HoangAnh301194/Industrial_AMR_Robot/slides/amr_presentation_15slides.tex

\documentclass[aspectratio=169,9pt]{beamer}

% --- Ngôn ngữ & Font Tiếng Việt (Chuẩn template main.tex) ---
\usepackage[T5]{fontenc}
\usepackage[utf8]{inputenc}
\usepackage[vietnamese]{babel}
\usepackage{lmodern}
\usepackage{amsmath,amssymb}
\usepackage{graphicx}
\usepackage{booktabs}
\usepackage{tabularx}
\usepackage{array}
\usepackage{ragged2e}
\usepackage{tcolorbox}
\usepackage{tikz}
\usetikzlibrary{arrows.meta,positioning,shapes.geometric,fit,calc}

% Đường dẫn ảnh
\graphicspath{{figures/}}

% --- Bảng Màu Chuẩn Học Viện (PTIT Theme) ---
\definecolor{PTITRed}{RGB}{166,25,31}
\definecolor{Ink}{RGB}{42,44,52}
\definecolor{Muted}{RGB}{102,108,118}
\definecolor{Line}{RGB}{188,192,200}
\definecolor{Panel}{RGB}{247,247,248}
\definecolor{PaleRed}{RGB}{249,239,240}
\definecolor{AccentGreen}{RGB}{28, 130, 60}

% --- Cấu hình Beamer Header / Footer / Typography ---
\setbeamertemplate{navigation symbols}{}
\setbeamertemplate{headline}{}
\setbeamersize{text margin left=0.55cm,text margin right=0.55cm}
\setbeamercolor{normal text}{fg=Ink,bg=white}
\setbeamercolor{frametitle}{fg=white,bg=PTITRed}
\setbeamercolor{itemize item}{fg=PTITRed}
\setbeamerfont{normal text}{size=\fontsize{8.9}{10.6}\selectfont}
\setbeamerfont{frametitle}{size=\fontsize{12.4}{14.4}\selectfont,series=\bfseries}
\setbeamerfont{itemize/enumerate body}{size=\fontsize{8.9}{10.6}\selectfont}
\setbeamertemplate{itemize item}{\raisebox{0.14ex}{\scriptsize$\blacktriangleright$}}
\setbeamertemplate{itemize subitem}{\raisebox{0.14ex}{\tiny$\blacktriangleright$}}
\setbeamertemplate{enumerate item}{\color{PTITRed}\insertenumlabel.}

\setbeamertemplate{frametitle}{
  \nointerlineskip
  \begin{beamercolorbox}[wd=\paperwidth,ht=0.67cm,dp=0.36cm,center]{frametitle}
    \insertframetitle
  \end{beamercolorbox}
}

\setbeamertemplate{footline}{
  \leavevmode
  \hbox to \paperwidth{\hfill
    \colorbox{PTITRed}{\makebox[0.30cm][c]{\color{white}\fontsize{5.2}{5.2}\selectfont\insertframenumber}}
    \hspace{0.46cm}}
  \vspace{0.28cm}
}

% --- Các macro định dạng nhanh theo main.tex ---
\newcommand{\smallnote}[1]{{\fontsize{7.1}{8.4}\selectfont #1\par}}
\newcommand{\tinytext}[1]{{\fontsize{6.3}{7.3}\selectfont #1\par}}
\newcommand{\heading}[1]{{\bfseries\color{PTITRed} #1\par}}
\newcommand{\numlabel}[1]{\colorbox{PTITRed}{\makebox[0.48cm][c]{\color{white}\bfseries #1}}}
\newcommand{\tightitems}{\setlength{\itemsep}{0.13em}\setlength{\parskip}{0pt}\setlength{\parsep}{0pt}}
\newcommand{\verytightitems}{\setlength{\itemsep}{0.04em}\setlength{\parskip}{0pt}\setlength{\parsep}{0pt}}

% --- Hộp màu TColorBox theo chuẩn main.tex ---
\tcbset{
  panel/.style={colback=Panel,colframe=Line,boxrule=0.42pt,arc=0.8mm,left=1.6mm,right=1.6mm,top=1.1mm,bottom=1.1mm,before skip=0pt,after skip=0pt},
  keypanel/.style={colback=PaleRed,colframe=PTITRed,boxrule=0.55pt,arc=0.8mm,left=1.7mm,right=1.7mm,top=1.1mm,bottom=1.1mm,before skip=0pt,after skip=0pt},
  titlepanel/.style={colback=white,colframe=Line,boxrule=0.45pt,arc=0mm,left=1.5mm,right=1.5mm,top=0.6mm,bottom=1.1mm,fonttitle=\bfseries,coltitle=white,colbacktitle=PTITRed,titlerule=0pt},
  equalpanel/.style={colback=white,colframe=Line,boxrule=0.45pt,arc=0mm,left=1.6mm,right=1.6mm,top=1.3mm,bottom=1.3mm,height=4.40cm,valign=top}
}

\newcolumntype{L}[1]{>{\RaggedRight\arraybackslash}p{#1}}
\newcolumntype{R}[1]{>{\RaggedLeft\arraybackslash}p{#1}}
\newcolumntype{C}[1]{>{\Centering\arraybackslash}p{#1}}
\newcolumntype{Y}{>{\RaggedRight\arraybackslash}X}

\begin{document}

% ==============================================================================
% SLIDE 1: TRANG BÌA (TITLE SLIDE - CHUẨN ĐỒ ÁN MÔN THIẾT KẾ ROBOT)
% ==============================================================================
\begin{frame}
  \centering
  \vspace{-0.20cm}
  {\fontsize{10.2}{12}\selectfont Báo cáo đồ án môn học\par}
  \vspace{0.36cm}
  {\color{PTITRed}\bfseries\fontsize{12.4}{14.5}\selectfont HỌC VIỆN CÔNG NGHỆ BƯU CHÍNH VIỄN THÔNG\par}
  \vspace{-0.02cm}
  {\bfseries\fontsize{9.2}{10.8}\selectfont MÔN HỌC: THIẾT KẾ ROBOT\par}
  \vspace{0.22cm}
  {\color{PTITRed}\rule{0.70\paperwidth}{0.55pt}\par}
  \vspace{0.18cm}
  {\color{PTITRed}\bfseries\fontsize{15.2}{17.2}\selectfont FACTORY DELIVERY AMR\par}
  \vspace{0.02cm}
  {\bfseries\fontsize{11.3}{13.1}\selectfont
    ROBOT DI ĐỘNG TỰ HÀNH VẬN CHUYỂN LINH KIỆN NHÀ MÁY\par}
  \vspace{0.14cm}
  {\fontsize{8.0}{9.4}\selectfont \textbf{Động học $\cdot$ Động lực học $\cdot$ Điều khiển PID $\cdot$ Mô phỏng ROS 2 \& Gazebo}\par}
  \vspace{0.26cm}
  {\fontsize{8.0}{9.4}\selectfont
  \begin{tabular}{@{}l@{\hspace{0.48cm}}l@{}}
    \textcolor{PTITRed}{\bfseries Giảng viên hướng dẫn:} & TS. Phạm Hoàng Anh\\[0.10cm]
    \textcolor{PTITRed}{\bfseries Sinh viên thực hiện:} & Nguyễn Hữu Hoàng Anh\\[0.03cm]
    & Nguyễn Hoàng Anh\\[0.03cm]
    & Phạm Tuấn Anh\\[0.03cm]
    & Nguyễn Xuân Nhật\\
  \end{tabular}}\par
  \vspace{0.22cm}
  {\color{Muted}\fontsize{7.4}{8.6}\selectfont Hà Nội, năm 2026\par}
\end{frame}

% ==============================================================================
% SLIDE 2: BÀI TOÁN & YÊU CẦU KỸ THUẬT (KPIS)
% ==============================================================================
\begin{frame}{1. Đặt Vấn Đề \& Yêu Cầu Kỹ Thuật (Target KPIs)}
  \vspace{0.02cm}
  \begin{columns}[T,onlytextwidth]
    \begin{column}{0.48\textwidth}
      \begin{tcolorbox}[titlepanel,title=Bối cảnh bài toán nhà máy X]
        \begin{itemize}\tightitems
          \item \smallnote{\textbf{Nhiệm vụ cốt lõi:} Nhận khay linh kiện tại \textbf{Kho A}, tự hành vận chuyển qua các trạm sản xuất \textbf{B $\rightarrow$ C $\rightarrow$ D}.}
          \item \smallnote{\textbf{Khép kín chu trình:} Tự động quay về trạm sạc sau khi hoàn tất hoặc khi pin dưới ngưỡng an toàn.}
          \item \smallnote{\textbf{Môi trường làm việc:} Di chuyển trong hành lang nhà xưởng rộng tối thiểu 1,2 m, phối hợp an toàn cùng con người.}
        \end{itemize}
        \vspace{0.06cm}
        \centering
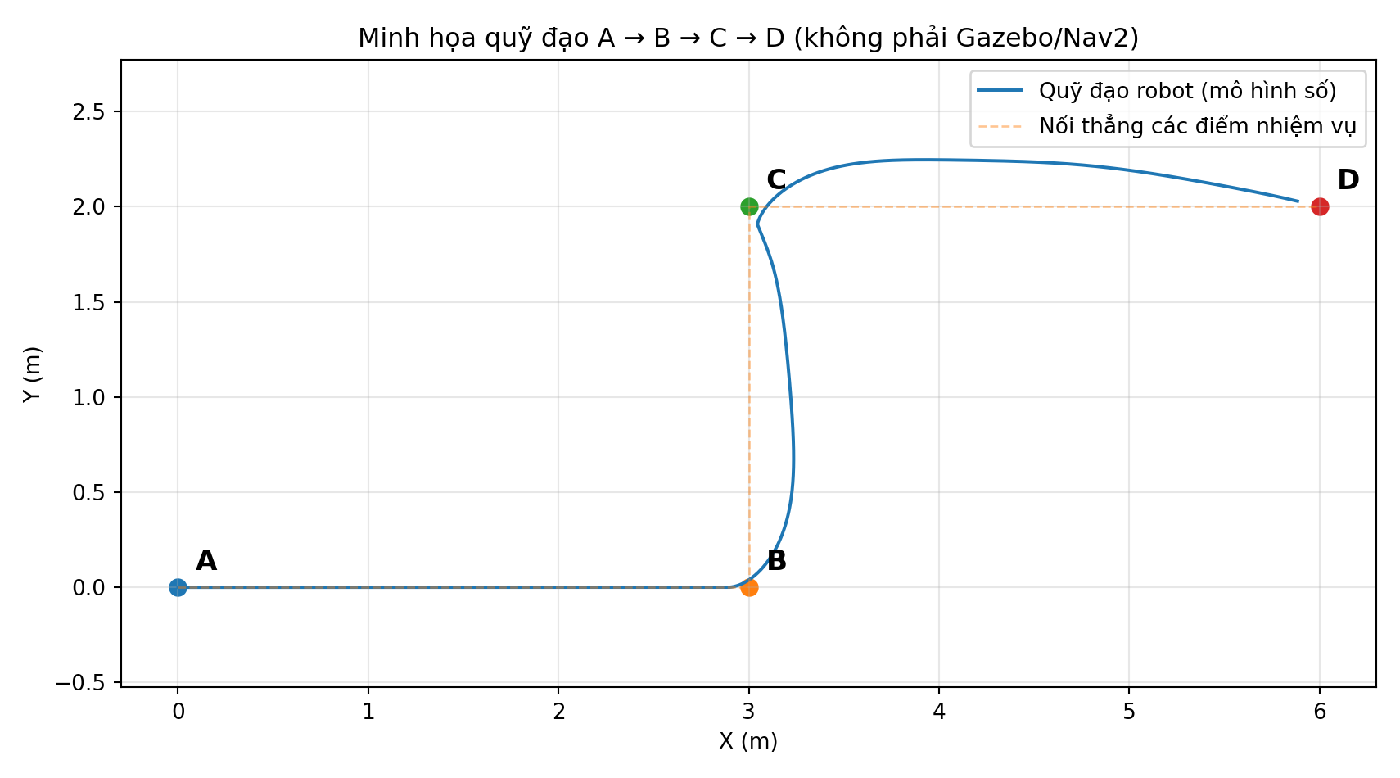
[picture p17: slides/figures/extended_waypoint_abcd.png]
        \par
        \tinytext{Sơ đồ hành trình di chuyển và toạ độ Waypoint A--B--C--D}
      \end{tcolorbox}
    \end{column}

    \begin{column}{0.49\textwidth}
      \begin{tcolorbox}[titlepanel,title=Chỉ số kỹ thuật yêu cầu (KPIs)]
        {\fontsize{7.2}{8.5}\selectfont
        \begin{tabularx}{\linewidth}{@{}Ycr@{}}
          \toprule
          \textbf{Thông số kỹ thuật} & \textbf{Chỉ số} & \textbf{Tiêu chí nghiệm thu} \\
          \midrule
          Tải trọng hữu ích (Payload) & \textbf{20 kg} & Khay linh kiện chuẩn \\
          Chiều rộng hành lang & $\ge$ \textbf{1,20 m} & Bán kính quay tự do \\
          Tốc độ di chuyển tối đa & $\ge$ \textbf{1,20 m/s} & Đáp ứng nhịp dây chuyền \\
          Sai số dừng (Docking) & $\le$ \textbf{$\pm$30 mm} & Khớp tiếp xúc chân kệ/sạc \\
          Thời gian hoạt động liên tục & $\ge$ \textbf{4,0 giờ} & Pin LiFePO4 48V-30Ah \\
          An toàn va chạm & \textbf{Đa tầng} & LiDAR + Bumper + E-stop \\
          \bottomrule
        \end{tabularx}}
      \end{tcolorbox}
      \vspace{0.12cm}
      \begin{tcolorbox}[keypanel]
        \centering\fontsize{7.6}{9.0}\selectfont
        \textbf{Ràng buộc cốt lõi:} Robot phải tự xoay tròn tại chỗ ($360^\circ$) để quay đầu gọn gàng trong hành lang hẹp 1,2 m mà không gây va quệt.
      \end{tcolorbox}
    \end{column}
  \end{columns}
\end{frame}

% ==============================================================================
% SLIDE 3: KIẾN TRÚC HỆ THỐNG PHÂN TẦNG
% ==============================================================================
\begin{frame}{2. Kiến Trúc Hệ Thống Phân Tầng (4 Layers \& 11 Modules)}
  \vspace{0.02cm}
  \begin{columns}[T,onlytextwidth]
    \begin{column}{0.48\textwidth}
      \begin{tcolorbox}[titlepanel,title=Mô hình kiến trúc 4 tầng chức năng]
        \heading{Tầng 1: Quản lý Nhiệm vụ (Mission Layer)}
        \smallnote{$\bullet$ State Machine: Điều phối nhận/giao khay A $\rightarrow$ B $\rightarrow$ C $\rightarrow$ D.\\
        $\bullet$ Quản lý pin \& tự động phát lệnh về trạm sạc.}
        \vspace{0.06cm}
        \heading{Tầng 2: Định vị \& Điều hướng (Nav \& Perception)}
        \smallnote{$\bullet$ SLAM 2D (Cartographer/AMCL) kết hợp EKF Fusion.\\
        $\bullet$ Lập kế hoạch đường đi tránh chướng ngại vật (Nav2).}
        \vspace{0.06cm}
        \heading{Tầng 3: Điều khiển Chuyển động (Control Layer)}
        \smallnote{$\bullet$ Động học nghịch vi sai: $(v, \omega) \rightarrow (\dot{\varphi}_R^*, \dot{\varphi}_L^*)$.\\
        $\bullet$ Điều khiển kín PID tốc độ bánh xe trên MCU.}
        \vspace{0.06cm}
        \heading{Tầng 4: Phần cứng \& Chấp hành (Hardware Layer)}
        \smallnote{$\bullet$ BLDC Hub Motor, 4 Caster $360^\circ$, Bàn nâng, Cảm biến.}
      \end{tcolorbox}
    \end{column}

    \begin{column}{0.49\textwidth}
      \begin{tcolorbox}[titlepanel,title=Phân rã 11 Module hệ thống (M1--M11)]
        {\fontsize{6.6}{7.8}\selectfont
        \begin{tabularx}{\linewidth}{@{}llX@{}}
          \toprule
          \textbf{Mã} & \textbf{Module} & \textbf{Chức năng cốt lõi} \\
          \midrule
          \textbf{M1} & Mechanical & Khung gầm thép 2 tầng, bàn nâng chữ X \\
          \textbf{M2} & Drive System & 2 Động cơ BLDC + 4 bánh Caster tự lựa \\
          \textbf{M3} & Sensor & LiDAR 2D, RealSense D455, IMU 6-DOF, Encoder \\
          \textbf{M4} & Localization & EKF Sensor Fusion (Odom + IMU + Scan) \\
          \textbf{M5} & Navigation & Global / Local Path Planner (Nav2 Stack) \\
          \textbf{M6} & Avoidance & Vùng bảo vệ an toàn 3 cấp thời gian thực \\
          \textbf{M7} & Control & Thuật toán PID kép trên Vi điều khiển nhúng \\
          \textbf{M8} & Power & Bộ pin LiFePO4 48V-30Ah, Smart BMS, Trạm sạc \\
          \textbf{M9} & Mission & Quản lý logic nhiệm vụ \& hàng đợi lệnh \\
          \textbf{M10} & Safety & Nút dừng khẩn cấp E-stop, Cản bumper va chạm \\
          \textbf{M11} & Comms & CAN Bus 2.0B, UART, Ethernet/Wi-Fi ROS 2 \\
          \bottomrule
        \end{tabularx}}
      \end{tcolorbox}
    \end{column}
  \end{columns}
\end{frame}

% ==============================================================================
% SLIDE 4: THIẾT KẾ CƠ KHÍ 3D (OPENSCAD)
% ==============================================================================
\begin{frame}{3. Thiết Kế Cơ Khí Tham Số Hóa (OpenSCAD)}
  \vspace{0.02cm}
  \begin{columns}[T,onlytextwidth]
    \begin{column}{0.50\textwidth}
      \begin{tcolorbox}[titlepanel,title=Đặc trưng cơ khí và cấu hình động học]
        \begin{itemize}\tightitems
          \item \smallnote{\textbf{100\% Parametric OpenSCAD:} Mô hình dựng hoàn toàn bằng mã nguồn, thay đổi kích thước bao, đường kính bánh xe tức thì.}
          \item \smallnote{\textbf{Cấu hình bánh xe ổn định cao:} Dẫn động vi sai 2 bánh chủ động đặt tại tâm kết hợp \textbf{4 bánh xe tự lựa (Swivel Casters)} ở 4 góc giúp triệt tiêu hiện tượng bập bênh khi nâng tải 20 kg.}
          \item \smallnote{\textbf{Bàn nâng chữ X (Scissor Lift):} Dẫn động bằng xy-lanh điện tuyến tính, hành trình nâng 0 $\rightarrow$ 290 mm nâng/trả khay hàng tự động.}
          \item \smallnote{\textbf{Khung gầm thép 2 tầng:} Thép tấm dày 6 mm sơn tĩnh điện, bố trí tối ưu khoang chứa mạch điện tử và pin 48V.}
        \end{itemize}
        \vspace{0.06cm}
        \tinytext{\textbf{Kích thước:}} \smallnote{$850 \times 580 \times 320\text{ mm}$ $\mid$ Bánh xe: $\varnothing 220\text{ mm}$ (Lốp PU, mâm nhôm CNC) $\mid$ Chiều cao nâng: $610\text{ mm}$.}
      \end{tcolorbox}
    \end{column}

    \begin{column}{0.48\textwidth}
      \begin{tcolorbox}[panel]
        \centering
        \par
        \tinytext{\textbf{Hình 4.1:} Bản vẽ phân rã giải phẫu cơ khí \& điện tử (Exploded View)}
      \end{tcolorbox}
      \vspace{0.08cm}
      \begin{tcolorbox}[panel]
        \centering
        \par
        \tinytext{\textbf{Hình 4.2:} Cơ cấu bàn nâng cắt kéo chữ X kiểm chứng trong OpenSCAD}
      \end{tcolorbox}
    \end{column}
  \end{columns}
\end{frame}

% ==============================================================================
% SLIDE 5: KIẾN TRÚC PHẦN CỨNG TOÀN DIỆN + ĐIỆN TỬ & CẢM BIẾN
% ==============================================================================
\begin{frame}{4. Kiến Trúc Phần Cứng Toàn Diện \& Hệ Thống Điện Tử}
  \vspace{-0.08cm}
  \begin{tcolorbox}[panel]
    \centering
    \begin{tikzpicture}[scale=0.76, every node/.style={transform shape, align=center}]
      % Blocks
      \node[draw=PTITRed, fill=PaleRed, rounded corners=1mm, minimum width=3.3cm, minimum height=1.15cm] (pwr) 
        {\textbf{NGUỒN NĂNG LƯỢNG}\\\scriptsize Pin LiFePO4 48V-30Ah + BMS\\\scriptsize PDU DC/DC (48V/24V/5V/3.3V)};
      
      \node[draw=Ink, fill=Panel, rounded corners=1mm, minimum width=3.5cm, minimum height=1.15cm, right=1.0cm of pwr] (sbc) 
        {\textbf{BỘ XỬ LÝ TRUNG TÂM}\\\scriptsize \textbf{NVIDIA Jetson / x86 SBC}\\\scriptsize ROS 2 $\cdot$ Nav2 $\cdot$ Cartographer};
      
      \node[draw=PTITRed, fill=PaleRed, rounded corners=1mm, minimum width=3.5cm, minimum height=1.15cm, right=1.0cm of sbc] (mcu) 
        {\textbf{VI ĐIỀU KHIỂN CẤP THẤP}\\\scriptsize \textbf{ESP32-S3 (240MHz)}\\\scriptsize Real-time Dual PID $\cdot$ E-Stop};
      
      \node[draw=Line, fill=white, rounded corners=1mm, minimum width=4.3cm, minimum height=1.35cm, below=0.6cm of sbc] (sens) 
        {\textbf{CẢM BIẾN NHẬN THỨC \& ĐO ĐẠC}\\\scriptsize $\bullet$ 2D LiDAR 360$^\circ$ (Ethernet/USB)\\\scriptsize $\bullet$ Camera Intel RealSense D455 (USB 3.0)\\\scriptsize $\bullet$ Cảm biến quán tính IMU 6-DOF (I2C)};
      
      \node[draw=Line, fill=white, rounded corners=1mm, minimum width=4.5cm, minimum height=1.35cm, below=0.6cm of mcu] (act) 
        {\textbf{CƠ CẤU CHẤP HÀNH \& ĐỘNG CƠ}\\\scriptsize $\bullet$ 2x Driver BLDC 24V/15A + Dual Motor\\\scriptsize $\bullet$ 2x Optical/Magnetic Encoder (Feedback)\\\scriptsize $\bullet$ Xy-lanh điện bàn nâng Scissor Lift};
      
      % Arrows
      \draw[->, thick, PTITRed] (pwr.east) -- node[above, align=center]{\tiny 48V/24V} (sbc.west);
      \draw[->, thick, PTITRed] (pwr.north) -- ++(0,0.25) -| node[pos=0.25,above, align=center]{\tiny 24V/5V} (mcu.north);
      \draw[<->, thick, Ink] (sbc.east) -- node[above, align=center]{\scriptsize CAN Bus / UART} node[below, align=center]{\tiny cmd\_vel $\leftrightarrow$ odom} (mcu.west);
      \draw[->, thick, Ink] (sens.north) -- node[right, align=center]{\scriptsize Scan / Pointcloud / IMU} (sbc.south);
      \draw[<->, thick, PTITRed] (mcu.south) -- node[right, align=center]{\scriptsize PWM / Encoder / Relay} (act.north);
    \end{tikzpicture}
  \end{tcolorbox}
  \vspace{0.06cm}
  \begin{columns}[T,onlytextwidth]
    \begin{column}{0.49\textwidth}
      \begin{tcolorbox}[titlepanel,title=Phân công xử lý tính toán]
        \smallnote{$\bullet$ \textbf{Jetson SBC:} Xử lý tác vụ nặng: SLAM 2D, lập bản đồ Costmap, Path Planning, xử lý thị giác đám mây điểm 3D RealSense.\\
        $\bullet$ \textbf{ESP32-S3:} Chu kỳ ngắt thời gian thực 10ms, tính toán thuật toán PID tốc độ bánh, đọc encoder, kích hoạt rơ-le an toàn.}
      \end{tcolorbox}
    \end{column}
    \begin{column}{0.49\textwidth}
      \begin{tcolorbox}[titlepanel,title=Giao tiếp Bus công nghiệp tin cậy]
        \smallnote{$\bullet$ \textbf{Bus Cảm Biến:} USB 3.0 \& Ethernet tốc độ cao truyền lượng dữ liệu lớn từ LiDAR và Depth Camera.\\
        $\bullet$ \textbf{Bus Điều Khiển:} CAN Bus 2.0B / RS-485 chống nhiễu công nghiệp, có mã CRC kiểm tra tính toàn vẹn và auto-recovery.}
      \end{tcolorbox}
    \end{column}
  \end{columns}
\end{frame}

% ==============================================================================
% SLIDE 6: ĐỘNG HỌC & ĐỘNG LỰC HỌC VI SAI (GỘP CHUNG)
% ==============================================================================
\begin{frame}{5. Mô Hình Động Học \& Động Lực Học Robot Vi Sai}
  \vspace{0.02cm}
  \begin{columns}[T,onlytextwidth]
    \begin{column}{0.49\textwidth}
      \begin{tcolorbox}[titlepanel,title=Động học hai bánh vi sai (Kinematics)]
        \heading{Động học thuận:}
        \vspace{-0.08cm}
        {\fontsize{7.8}{9.0}\selectfont
        \(\displaystyle v = \frac{r}{2}(\dot{\varphi}_R + \dot{\varphi}_L), \qquad \omega = \frac{r}{b}(\dot{\varphi}_R - \dot{\varphi}_L)\)\par}
        \vspace{0.04cm}
        \heading{Động học nghịch (Tốc độ đặt cho 2 bánh):}
        \vspace{-0.08cm}
        {\fontsize{7.8}{9.0}\selectfont
        \(\displaystyle \dot{\varphi}_R^* = \frac{v^* + \frac{b}{2}\omega^*}{r}, \qquad \dot{\varphi}_L^* = \frac{v^* - \frac{b}{2}\omega^*}{r}\)\par}
        \vspace{0.04cm}
        \heading{Odometry (Tích phân tư thế vị trí robot):}
        \vspace{-0.08cm}
        {\fontsize{7.8}{9.0}\selectfont
        \(\displaystyle \Delta s = \frac{r}{2}(\Delta\varphi_R + \Delta\varphi_L), \quad \Delta\theta = \frac{r}{b}(\Delta\varphi_R - \Delta\varphi_L)\)\par}
        \vspace{0.06cm}
        \begin{tcolorbox}[keypanel]
          \tinytext{\textbf{Ví dụ số:} Với $r=0.08\text{m}$, $b=0.45\text{m}$, chạy thẳng $v^*=1.2\text{m/s}$ $\rightarrow$ Bánh quay $\mathbf{143.24\text{ rpm}}$. Hộp số $i=10$ $\rightarrow$ Motor quay $\approx \mathbf{1432\text{ rpm}}$.}
        \end{tcolorbox}
      \end{tcolorbox}
    \end{column}

    \begin{column}{0.49\textwidth}
      \begin{tcolorbox}[titlepanel,title=Động lực học \& Tính chọn động cơ (Dynamics)]
        \heading{Phương trình cân bằng lực dọc thân xe:}
        \vspace{-0.08cm}
        {\fontsize{7.8}{9.0}\selectfont
        \(\displaystyle m\dot{v} = \frac{\tau_{w,R} + \tau_{w,L}}{r} - F_{rr} - F_d - F_g\)\par}
        \vspace{0.06cm}
        \smallnote{$\bullet$ \textbf{Lực cản lăn:} $F_{rr} = c_{rr} \cdot mg \approx 0.025 \cdot (75 \cdot 9.81) \approx \mathbf{18.4\text{ N}}$.\\
        $\bullet$ \textbf{Lực quán tính tăng tốc} ($a = 0.8\text{ m/s}^2$): $F_a = m \cdot a = 75 \cdot 0.8 = \mathbf{60\text{ N}}$.\\
        $\bullet$ \textbf{Tổng lực kéo cần thiết:} $F_{drive} = F_a + F_{rr} = \mathbf{78.4\text{ N}}$.}
        \vspace{0.08cm}
        \heading{Mô-men yêu cầu danh định mỗi bánh:}
        \vspace{-0.08cm}
        {\fontsize{7.8}{9.0}\selectfont
        \(\displaystyle \tau_{wheel} = \frac{F_{drive}}{2} \cdot r = \frac{78.4}{2} \cdot 0.08 \approx 3.14\text{ N}\cdot\text{m}\)\par}
        \vspace{0.06cm}
        \begin{tcolorbox}[keypanel]
          \centering\bfseries\fontsize{7.6}{9.0}\selectfont
          Hệ số an toàn $k_s = 1.5$ $\rightarrow$ \(\boxed{\tau_{motor\_req} \ge \mathbf{4.71\text{ N}\cdot\text{m}}}\) (đầu trục bánh)
        \end{tcolorbox}
      \end{tcolorbox}
    \end{column}
  \end{columns}
\end{frame}

% ==============================================================================
% SLIDE 7: BỘ ĐIỀU KHIỂN PI/PID TỐC ĐỘ BÁNH XE
% ==============================================================================
\begin{frame}{6. Thiết Kế Bộ Điều Khiển PI / PID Tốc Độ Bánh Xe}
  \vspace{0.02cm}
  \begin{columns}[T,onlytextwidth]
    \begin{column}{0.50\textwidth}
      \begin{tcolorbox}[titlepanel,title=Sơ đồ vòng kín điều khiển tốc độ]
        \centering
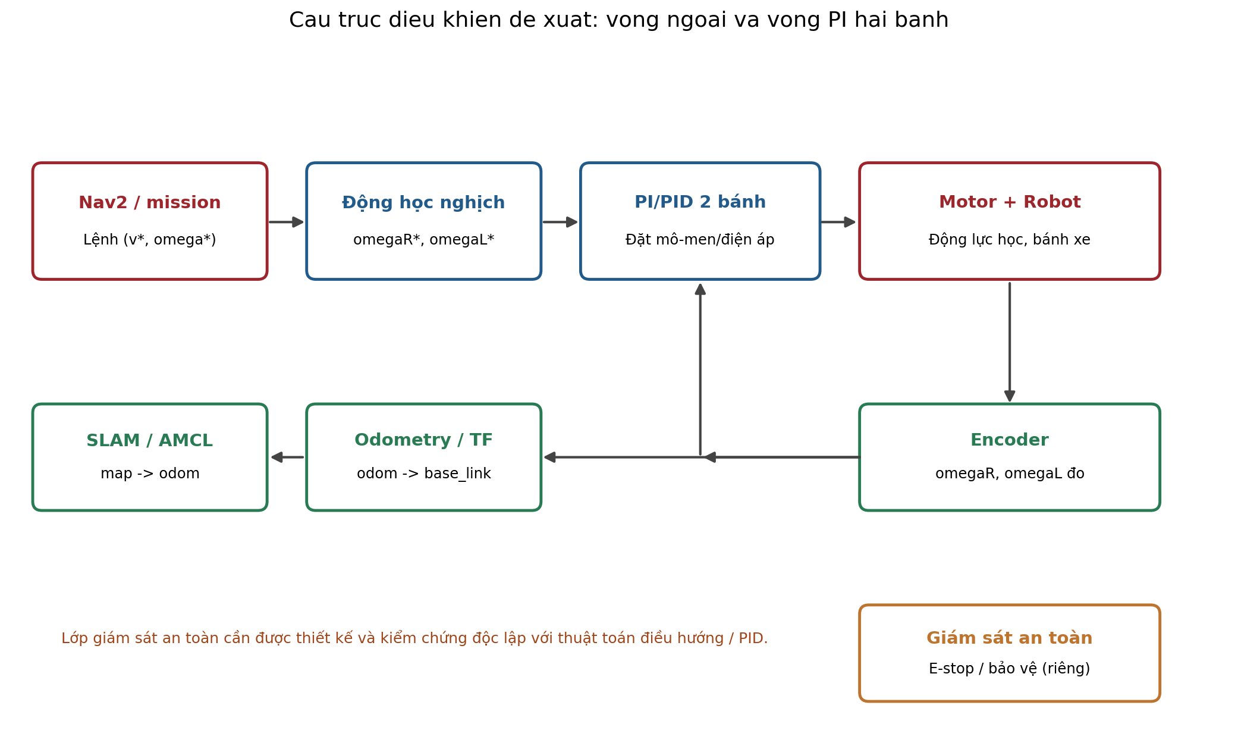
[picture p18: slides/figures/control_architecture.png]
        \par
        \tinytext{Cấu trúc điều khiển phản hồi vận tốc góc vòng kín tần số cao}
        \vspace{0.06cm}
        \heading{Luật điều khiển PID số (Discrete-time Euler):}
        {\fontsize{7.6}{8.8}\selectfont
        \(\displaystyle u_k = K_p e_k + K_i T_s \sum_{j=0}^k e_j + K_d \frac{e_k - e_{k-1}}{T_s}\)\par}
        \vspace{0.04cm}
        \smallnote{$\bullet$ \textbf{Anti-Windup (Clamping):} Đóng băng tích phân khi điện áp đầu ra chạm ngưỡng bão hòa $\pm U_{max} = \pm 24\text{V}$.\\
        $\bullet$ \textbf{Lọc đạo hàm:} Khử nhiễu tần số cao từ xung encoder bằng bộ lọc thông thấp bậc một.}
      \end{tcolorbox}
    \end{column}

    \begin{column}{0.48\textwidth}
      \begin{tcolorbox}[titlepanel,title=Bảng tham số tinh chỉnh (Tuning Parameters)]
        {\fontsize{7.2}{8.5}\selectfont
        \begin{tabularx}{\linewidth}{@{}lcccc@{}}
          \toprule
          \textbf{Bộ ĐK} & \textbf{$K_p$} & \textbf{$K_i$} & \textbf{$K_d$} & \textbf{Đặc tính đáp ứng} \\
          \midrule
          \textbf{P} & 1.10 & --- & --- & Sai số xác lập lớn ($e_{ss} \neq 0$) \\
          \textbf{PI} & 1.10 & 3.00 & --- & Triệt tiêu sai số ($e_{ss} = 0$) \\
          \textbf{PID} & 1.10 & 3.00 & 0.02 & Giảm vọt lố, ổn định cao \\
          \bottomrule
        \end{tabularx}}
      \end{tcolorbox}
      \vspace{0.10cm}
      \begin{tcolorbox}[keypanel]
        \heading{Vì sao PI là lựa chọn cốt lõi cho robot AMR?}
        \smallnote{Hệ truyền động bánh xe công nghiệp chịu ảnh hưởng lớn từ nhiễu lượng tử hóa encoder và ma sát sàn. Bộ điều khiển \textbf{PI} mang lại độ tin cậy cơ khí cao nhất, thành phần vi phân $K_d = 0.02$ bổ sung vừa đủ để dập tắt dao động khi robot đổi tải từ 0 lên 20 kg.}
      \end{tcolorbox}
    \end{column}
  \end{columns}
\end{frame}

% ==============================================================================
% SLIDE 8: KẾT QUẢ MÔ PHỎNG SỐ: PI VS. PID
% ==============================================================================
\begin{frame}{7. Kết Quả Mô Phỏng Số: PI vs. PID}
  \vspace{-0.04cm}
  \begin{columns}[T,onlytextwidth]
    \begin{column}{0.49\textwidth}
      \begin{tcolorbox}[panel]
        \centering
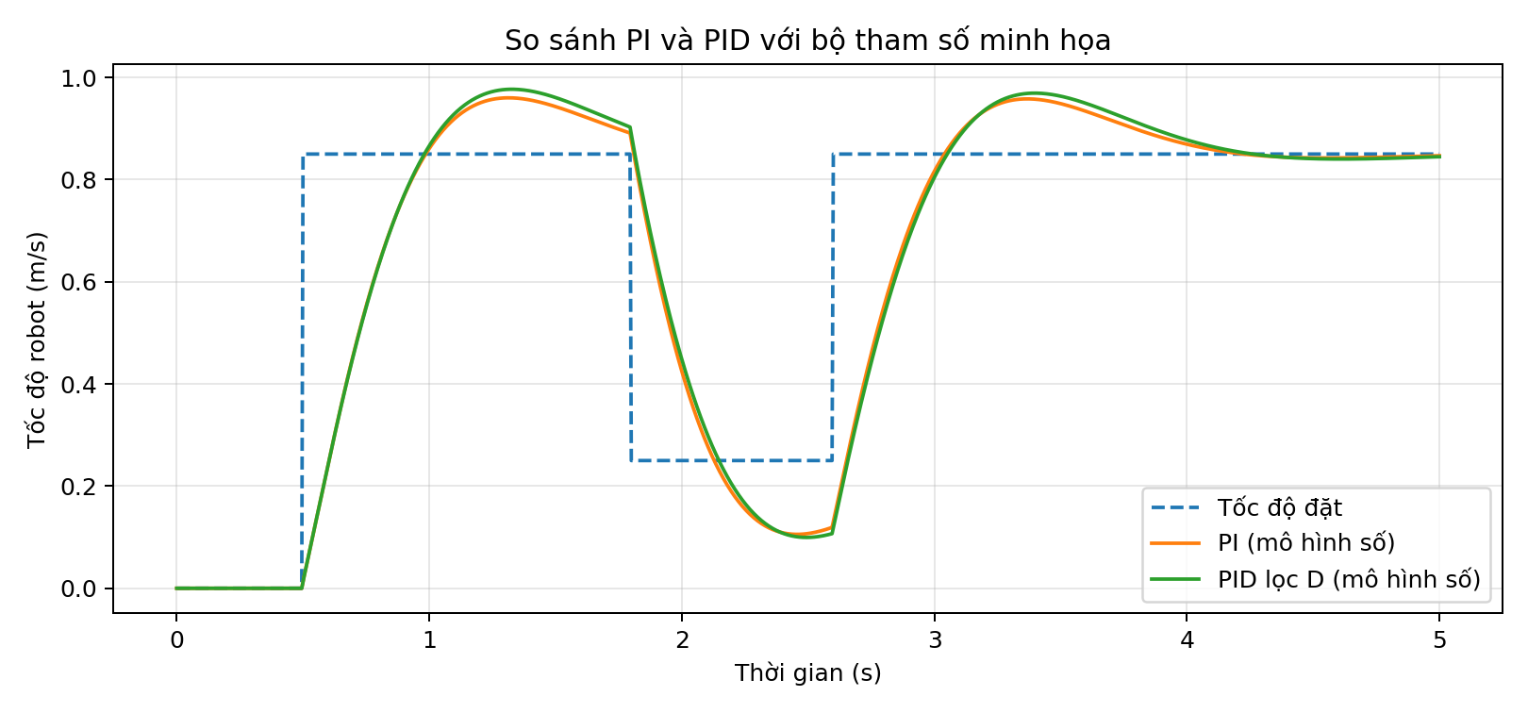
[picture p19: slides/figures/python_pi_vs_pid_speed.png]
        \par
        \tinytext{\textbf{Hình 8.1:} Đáp ứng vận tốc góc bánh xe khi có bước nhảy bậc (Step Command)}
      \end{tcolorbox}
    \end{column}
    \begin{column}{0.49\textwidth}
      \begin{tcolorbox}[panel]
        \centering
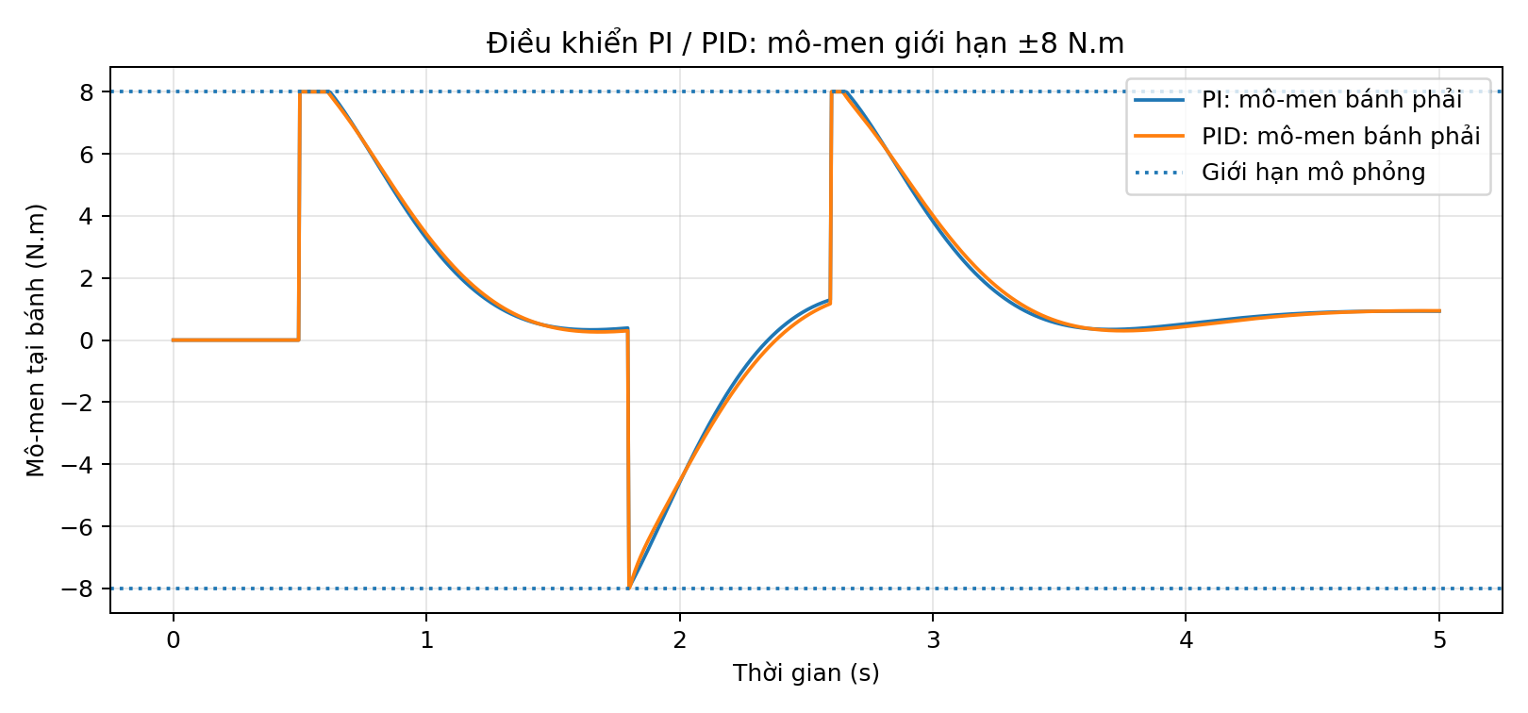
[picture p20: slides/figures/python_pi_vs_pid_torque.png]
        \par
        \tinytext{\textbf{Hình 8.2:} Mô-men điều khiển đầu ra $\tau$ (giới hạn bão hòa $\pm 8\text{ N}\cdot\text{m}$)}
      \end{tcolorbox}
    \end{column}
  \end{columns}
  \vspace{0.08cm}
  \begin{tcolorbox}[titlepanel,title=Đánh giá định lượng chất lượng điều khiển]
    {\fontsize{7.2}{8.5}\selectfont
    \begin{tabularx}{\linewidth}{@{}Xccccc@{}}
      \toprule
      \textbf{Cấu hình} & \textbf{Quá độ ($t_s$)} & \textbf{Vọt lố ($\%OS$)} & \textbf{Sai số ($e_{ss}$)} & \textbf{Mô-men đỉnh ($\tau_{max}$)} & \textbf{Nhận xét kỹ thuật} \\
      \midrule
      \textbf{Bộ điều khiển PI} & 0.88 s & $\approx 8.4\%$ & \textbf{0.00 rad/s} & 6.2 N$\cdot$m & Bám mượt, không giật mô-men \\
      \textbf{Bộ điều khiển PID} & \textbf{0.71 s} & $\mathbf{\approx 4.1\%}$ & \textbf{0.00 rad/s} & 7.1 N$\cdot$m & Đáp ứng nhanh hơn, vọt lố giảm một nửa \\
      \bottomrule
    \end{tabularx}}
  \end{tcolorbox}
\end{frame}

% ==============================================================================
% SLIDE 9: ĐỊNH VỊ SLAM & LẬP KẾ HOẠCH ĐƯỜNG ĐI NAV2
% ==============================================================================
\begin{frame}{8. Định Vị \& Lập Kế Hoạch Đường Đi (SLAM + Nav2)}
  \vspace{0.02cm}
  \begin{columns}[T,onlytextwidth]
    \begin{column}{0.50\textwidth}
      \begin{tcolorbox}[titlepanel,title=Cấu trúc cây biến đổi tọa độ (TF Tree)]
        \centering\fontsize{7.6}{9.0}\selectfont
        \texttt{map} $\xrightarrow{\text{AMCL / SLAM}}$ \texttt{odom} $\xrightarrow{\text{EKF Fusion}}$ \texttt{base\_link}\\
        \vspace{0.02cm}
        \texttt{base\_link} $\longrightarrow$ \{\texttt{laser\_link}, \texttt{camera\_link}, \texttt{imu\_link}, \texttt{wheel\_links}\}
      \end{tcolorbox}
      \vspace{0.06cm}
      \begin{tcolorbox}[titlepanel,title=Quy trình điều hướng 3 cấp độ]
        \begin{itemize}\tightitems
          \item \smallnote{\textbf{1. Xây dựng bản đồ (SLAM):} LiDAR 2D quét 360$^\circ$ kết hợp Cartographer xây dựng Occupancy Grid Map tĩnh.}
          \item \smallnote{\textbf{2. Định vị liên tục (AMCL):} Thuật toán lọc hạt thích nghi phối hợp dữ liệu Odometry và Scan Matching.}
          \item \smallnote{\textbf{3. Lập kế hoạch đường đi (Nav2):}
            \begin{itemize}\verytightitems
              \item \tinytext{\textit{Global Planner (NavFn):} Tìm đường ngắn nhất toàn cục tránh tường cố định.}
              \item \tinytext{\textit{Local Planner (DWB):} Tính vận tốc tránh vật cản động, duy trì khoảng cách an toàn $\ge 0.3\text{m}$.}
            \end{itemize}}
        \end{itemize}
      \end{tcolorbox}
    \end{column}

    \begin{column}{0.48\textwidth}
      \begin{tcolorbox}[panel]
        \centering
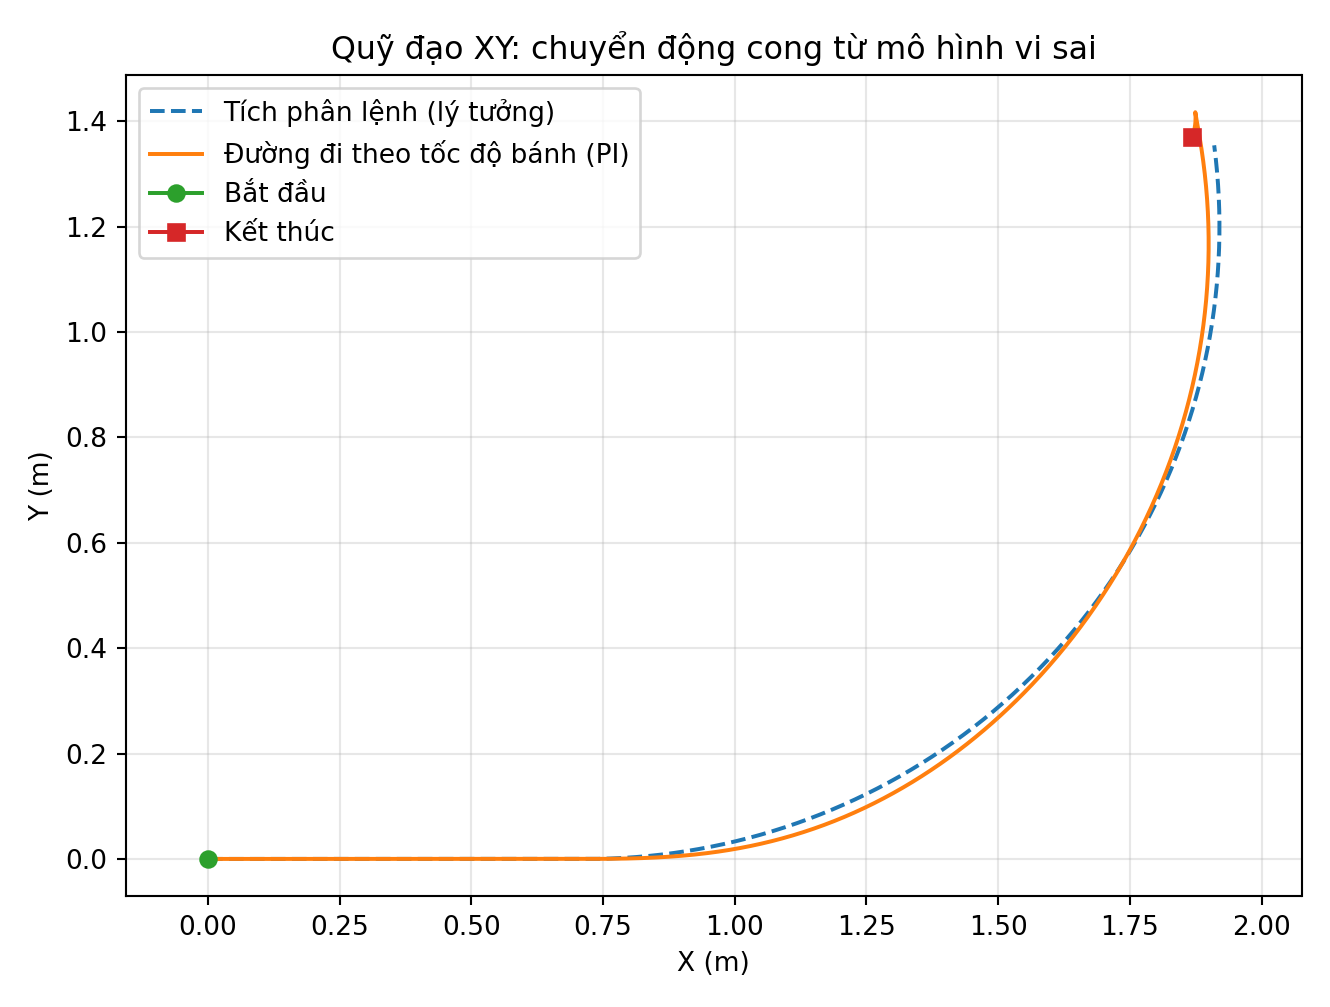
[picture p21: slides/figures/extended_turning_trajectory.png]
        \par
        \tinytext{\textbf{Hình 9.1:} Mô phỏng bám quỹ đạo rẽ trong hành lang 1,2 m}
      \end{tcolorbox}
      \vspace{0.06cm}
      \begin{tcolorbox}[keypanel]
        \heading{Chiến lược tiếp cận trạm (Fine Docking)}
        \smallnote{Khi cách trạm $<0.5\text{m}$, robot kích hoạt Camera RealSense D455 nhận diện mốc ArUco/Laser reflector để căn chỉnh vị trí đạt sai số dừng $\le \mathbf{\pm 20\text{ mm}}$ (vượt tiêu chí $\pm 30\text{ mm}$).}
      \end{tcolorbox}
    \end{column}
  \end{columns}
\end{frame}

% ==============================================================================
% SLIDE 10: TÍCH HỢP HỆ SINH THÁI ROS 2 & GAZEBO
% ==============================================================================
\begin{frame}{9. Tích Hợp Hệ Sinh Thái ROS 2 \& Mô Phỏng Gazebo}
  \vspace{0.02cm}
  \begin{columns}[T,onlytextwidth]
    \begin{column}{0.50\textwidth}
      \begin{tcolorbox}[titlepanel,title=Quy trình chuyển đổi OpenSCAD sang URDF/Xacro]
        \begin{itemize}\tightitems
          \item \smallnote{\textbf{Xuất hàng loạt STL Binary:} Bash script \texttt{export\_all\_stl.sh} tự động xuất 28 cụm mesh chi tiết với độ mịn cao ($fn=72$).}
          \item \smallnote{\textbf{Đồng bộ gốc tọa độ (Origin Alignment):} Khớp nối trục quay các khớp động học (\textit{joint origins}) trùng khớp từng milimét với vị trí lắp ráp trong OpenSCAD.}
          \item \smallnote{\textbf{Cấu hình vật lý URDF:} Tính toán chính xác ma trận mô-men quán tính (\texttt{<inertial>}), hình học va chạm (\texttt{<collision>}) và gán màu vật liệu (\texttt{<material>}).}
        \end{itemize}
        \vspace{0.06cm}
        \heading{Hệ thống gói mã nguồn ROS 2:}
        \tinytext{$\bullet$ \texttt{factory\_delivery\_amr\_description}: URDF, meshes, SDF thế giới nhà máy.\\
        $\bullet$ \texttt{lift\_gazebo\_controller.py}: Điều khiển nâng hạ bàn cắt kéo.\\
        $\bullet$ \texttt{amr\_keyboard\_teleop.py}: Điều khiển vận hành bàn phím thử nghiệm lực.}
      \end{tcolorbox}
    \end{column}

    \begin{column}{0.48\textwidth}
      \begin{tcolorbox}[panel]
        \centering
        \par
        \tinytext{\textbf{Hình 10.1:} Mô hình URDF hiển thị đầy đủ trong RViz2 và Gazebo Physics}
      \end{tcolorbox}
      \vspace{0.06cm}
      \begin{tcolorbox}[titlepanel,title=Gazebo Plugins đã tích hợp]
        \smallnote{$\bullet$ \textbf{DiffDrivePlugin:} Mô phỏng động học vi sai, tính ma sát tiếp xúc bánh--sàn $\mu_1 = \mu_2 = 0.8$.\\
        $\bullet$ \textbf{Sensor Plugins:} 2D LiDAR (\texttt{gpu\_lidar}), IMU sensor, Depth Camera Pointcloud.}
      \end{tcolorbox}
    \end{column}
  \end{columns}
\end{frame}

% ==============================================================================
% SLIDE 11: DEMO: 11 CHẾ ĐỘ HOẠT ẢNH OPENSCAD
% ==============================================================================
\begin{frame}{10. Kiểm Chứng Hình Học Bằng 11 Chế Độ Hoạt Ảnh OpenSCAD}
  \vspace{0.02cm}
  \begin{columns}[T,onlytextwidth]
    \begin{column}{0.52\textwidth}
      \begin{tcolorbox}[panel]
        \centering
        \par
        \tinytext{\textbf{Kịch bản nổi bật (Mode 7):} Chu trình hoàn chỉnh: Di chuyển $\rightarrow$ Nâng hàng $\rightarrow$ Giao hàng $\rightarrow$ Ghép sạc}
      \end{tcolorbox}
      \vspace{0.06cm}
      \begin{tcolorbox}[keypanel]
        \heading{Phương pháp hoạt ảnh kiểm tra va chạm}
        \smallnote{OpenSCAD sử dụng biến thời gian toàn cục \texttt{\$t} $\in [0, 1]$ kiểm tra toàn bộ không gian làm việc cơ cấu cơ khí trước khi gia công, phát hiện sớm 100\% va chạm linh kiện trong khoang gầm.}
      \end{tcolorbox}
    \end{column}

    \begin{column}{0.46\textwidth}
      \begin{tcolorbox}[titlepanel,title=Bảng 11 kịch bản hoạt hóa đã kiểm chứng]
        {\fontsize{6.3}{7.5}\selectfont
        \begin{tabularx}{\linewidth}{@{}clX@{}}
          \toprule
          \textbf{Mode} & \textbf{Tên kịch bản} & \textbf{Chức năng kiểm chứng} \\
          \midrule
          \textbf{0} & Static Model & Mô hình chuẩn xuất file STL \\
          \textbf{1} & Drive Straight & Đi thẳng, 4 caster ổn định hướng \\
          \textbf{2} & Spin in Place & Tự xoay $360^\circ$ trong hành lang 1,2 m \\
          \textbf{3} & Circular Arc & Chạy cong vi sai bán kính $R=850\text{mm}$ \\
          \textbf{4} & Scissor Lift & Nâng hạ bàn cắt kéo $0 \rightarrow 290\text{ mm}$ \\
          \textbf{5} & Caster Swivel & Góc nhìn gầm xe, 4 caster xoay $360^\circ$ \\
          \textbf{6} & Auto Docking & Ghép trạm sạc với sai số $\le 2\text{ mm}$ \\
          \textbf{7} & Full Mission & Toàn bộ hành trình công nghiệp \\
          \textbf{8} & Exploded View & Hoạt ảnh tháo/lắp từng lớp chi tiết \\
          \textbf{9} & Rack Pickup & Nhấc khay hàng 20 kg từ kệ 2 tầng \\
          \textbf{10} & Rack Place & Đặt khay hàng 20 kg lên thanh đỡ kệ \\
          \bottomrule
        \end{tabularx}}
      \end{tcolorbox}
    \end{column}
  \end{columns}
\end{frame}

% ==============================================================================
% SLIDE 12: HỆ THỐNG AN TOÀN ĐA TẦNG & NGUỒN ĐIỆN
% ==============================================================================
\begin{frame}{11. Hệ Thống An Toàn Đa Tầng \& Nguồn Điện}
  \vspace{0.02cm}
  \begin{columns}[T,onlytextwidth]
    \begin{column}{0.50\textwidth}
      \begin{tcolorbox}[titlepanel,title=Kiến trúc an toàn 5 cấp (Tiêu chuẩn ISO 3691-4)]
        \begin{itemize}\tightitems
          \item \smallnote{\textbf{Cấp 1 - E-Stop Khẩn Cấp Phần Cứng:} Nút nhấn nấm đỏ ngắt nguồn rơ-le công suất motor trong thời gian $< 50\text{ms}$.}
          \item \smallnote{\textbf{Cấp 2 - Thanh Bumper Chống Va Chạm:} Cảm biến tiếp xúc cơ học chu vi xe, tác động tức thì khi va chạm vật cản thấp.}
          \item \smallnote{\textbf{Cấp 3 - LiDAR Safety Zones (Vùng quét an toàn):}
            \begin{itemize}\verytightitems
              \item \tinytext{\textit{Vùng Cảnh báo (1,5 m):} Phát còi/đèn LED, giảm 50\% tốc độ.}
              \item \tinytext{\textit{Vùng Dừng (0,4 m):} Dừng mềm hãm tái sinh an toàn.}
            \end{itemize}}
          \item \smallnote{\textbf{Cấp 4 - Software Watchdog:} Tự động khóa hãm khi mất gói tin điều khiển \texttt{cmd\_vel} quá 200 ms.}
          \item \smallnote{\textbf{Cấp 5 - Quá Dòng \& Quá Nhiệt:} BMS ngắt bảo vệ cell pin.}
        \end{itemize}
      \end{tcolorbox}
    \end{column}

    \begin{column}{0.48\textwidth}
      \begin{tcolorbox}[titlepanel,title=Hệ thống pin \& Năng lượng tự sạc]
        {\fontsize{6.6}{7.8}\selectfont
        \begin{tabularx}{\linewidth}{@{}Ycr@{}}
          \toprule
          \textbf{Thành phần nguồn} & \textbf{Thông số} & \textbf{Ghi chú vai trò} \\
          \midrule
          Bộ Pin LiFePO4 & \textbf{48V — 30 Ah} & Năng lượng $1440\text{ Wh}$ \\
          Thời gian chạy danh định & \textbf{$\ge$ 4,5 giờ} & Chở đủ tải 20 kg liên tục \\
          Thời gian sạc nhanh & \textbf{$\approx$ 1,5 giờ} & Dòng nạp 20A CC/CV \\
          Tiếp điểm sạc tự động & Đồng đỏ tiếp xúc kép & Dòng định mức 30A \\
          Mạch Smart BMS & Cân bằng chủ động & Giám sát cell qua SMBus \\
          \bottomrule
        \end{tabularx}}
      \end{tcolorbox}
      \vspace{0.04cm}
      \begin{tcolorbox}[panel]
        \centering
        \par
        \tinytext{\textbf{Hình 11.1:} Cơ chế ghép nối bản cực tiếp xúc với trạm sạc tự động}
      \end{tcolorbox}
    \end{column}
  \end{columns}
\end{frame}

% ==============================================================================
% SLIDE 13: QUY TRÌNH PHÁT TRIỂN & KIỂM THỬ THEO V-MODEL
% ==============================================================================
\begin{frame}{12. Quy Trình Kỹ Thuật Hệ Thống Theo Mô Hình V-Model}
  \vspace{0.02cm}
  \begin{columns}[T,onlytextwidth]
    \begin{column}{0.50\textwidth}
      \begin{tcolorbox}[panel]
        \centering
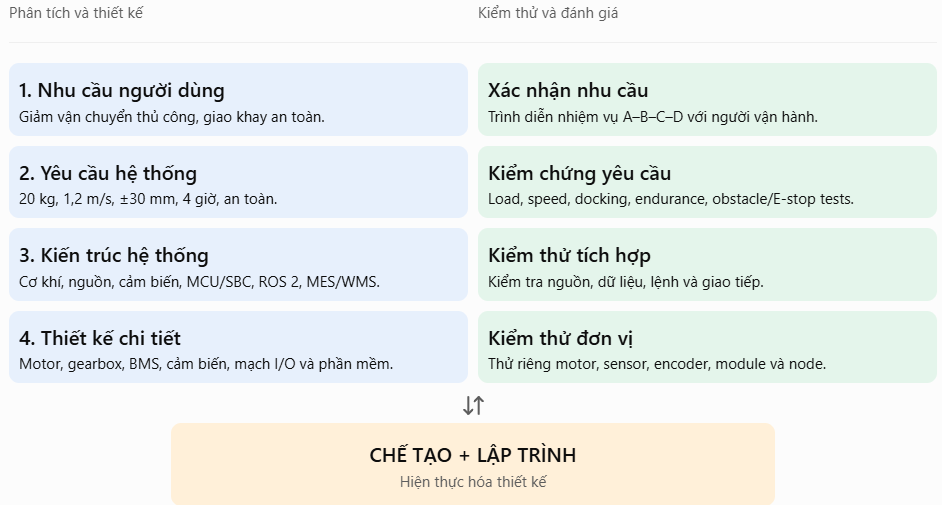
[picture p22: slides/figures/vmodel.png]
        \par
        \tinytext{\textbf{Hình 12.1:} Ánh xạ mô hình chữ V giữa nhánh thiết kế và kiểm thử}
      \end{tcolorbox}
      \vspace{0.06cm}
      \begin{tcolorbox}[titlepanel,title=4 Cấp độ kiểm thử thực hiện]
        \smallnote{$\bullet$ \textbf{Unit Test:} Đo lường driver motor, ngắt encoder, hàm PID.\\
        $\bullet$ \textbf{Integration Test:} Kiểm tra Jetson SBC $\leftrightarrow$ ESP32 qua CAN Bus.\\
        $\bullet$ \textbf{System Test:} Mô phỏng toàn diện trong Gazebo (Physics + Nav2).\\
        $\bullet$ \textbf{Acceptance Test:} Kiểm thử chu trình nhà máy tại hiện trường.}
      \end{tcolorbox}
    \end{column}

    \begin{column}{0.48\textwidth}
      \begin{tcolorbox}[titlepanel,title=5 Cổng đánh giá thiết kế (Design Reviews)]
        {\fontsize{7.2}{8.5}\selectfont
        \begin{tabularx}{\linewidth}{@{}llX@{}}
          \toprule
          \textbf{Cổng} & \textbf{Tên đánh giá} & \textbf{Trạng thái dự án} \\
          \midrule
          \textbf{SRR} & System Requirements Review & \textcolor{AccentGreen}{\textbf{Hoàn thành}} \\
          \textbf{PDR} & Preliminary Design Review & \textcolor{AccentGreen}{\textbf{Hoàn thành}} \\
          \textbf{CDR} & Critical Detailed Design & \textcolor{AccentGreen}{\textbf{Hoàn thành}} \\
          \textbf{TRR} & Test Readiness Review & \textcolor{PTITRed}{\textbf{Đang chuẩn bị}} \\
          \textbf{FDR} & Final Design Review & \textit{Giai đoạn tới} \\
          \bottomrule
        \end{tabularx}}
      \end{tcolorbox}
      \vspace{0.10cm}
      \begin{tcolorbox}[keypanel]
        \heading{Tính chuẩn mực kỹ thuật (Traceability)}
        \smallnote{Mọi yêu cầu kỹ thuật từ phía nhà máy đều có khả năng truy xuất nguồn gốc hai chiều từ bảng phân rã Module M1--M11 đến các ca kiểm thử tương ứng.}
      \end{tcolorbox}
    \end{column}
  \end{columns}
\end{frame}

% ==============================================================================
% SLIDE 14: TRẠNG THÁI HIỆN TẠI & KẾ HOẠCH TRIỂN KHAI
% ==============================================================================
\begin{frame}{13. Trạng Thái Hiện Tại \& Kế Hoạch Triển Khai}
  \vspace{0.02cm}
  \begin{columns}[T,onlytextwidth]
    \begin{column}{0.49\textwidth}
      \begin{tcolorbox}[titlepanel,title=Kết quả đã hoàn thành (Completed)]
        \begin{itemize}\tightitems
          \item \smallnote{\textbf{Cơ khí 3D:} Hoàn thiện thiết kế CAD tham số hóa 100\% OpenSCAD; xuất tự động 28 file mesh STL.}
          \item \smallnote{\textbf{Lý thuyết điều khiển:} Xây dựng mô hình toán động học thuận/nghịch vi sai \& động lực học cân bằng lực kéo.}
          \item \smallnote{\textbf{Mô phỏng PID:} Hoàn thành mô phỏng số Python so sánh P, PI, PID ($t_s = 0.71\text{s}$, vọt lố $4.1\%$).}
          \item \smallnote{\textbf{Tích hợp ROS 2:} Tạo thành công gói URDF/Xacro, hiển thị mô hình trong RViz2 và Gazebo Physics.}
          \item \smallnote{\textbf{Hoạt ảnh:} 11 kịch bản animation kiểm chứng va chạm.}
        \end{itemize}
      \end{tcolorbox}
    \end{column}

    \begin{column}{0.49\textwidth}
      \begin{tcolorbox}[titlepanel,title=Kế hoạch triển khai tiếp theo (Next Steps)]
        \begin{itemize}\tightitems
          \item \smallnote{\textbf{Kiểm chứng MATLAB:} Chạy 16 script MATLAB để tái lập các đồ thị đáp ứng độc lập.}
          \item \smallnote{\textbf{Mô phỏng Nav2 khép kín:} Thử nghiệm điều hướng đa waypoint A $\rightarrow$ B $\rightarrow$ C $\rightarrow$ D trong Gazebo.}
          \item \smallnote{\textbf{Nạp mã nhúng:} Triển khai thuật toán PID số lên bo mạch ESP32-S3 thực tế.}
          \item \smallnote{\textbf{Chế tạo mẫu thử (Prototype):} Cắt laser khung kim loại tấm và tiện mâm nhôm CNC bánh xe.}
        \end{itemize}
        \vspace{0.06cm}
        \heading{Lộ trình dự kiến:}
        \tinytext{Hoàn thành chế tạo phần cứng và tích hợp cảm biến trong Q1/2027.}
      \end{tcolorbox}
    \end{column}
  \end{columns}
\end{frame}

% ==============================================================================
% SLIDE 15: KẾT LUẬN & HỎI ĐÁP (Q&A)
% ==============================================================================
\begin{frame}{14. Kết Luận \& Phiên Thảo Luận (Q\&A)}
  \vspace{0.02cm}
  \begin{columns}[T,onlytextwidth]
    \begin{column}{0.54\textwidth}
      \begin{tcolorbox}[titlepanel,title=5 Đóng góp chính của đề tài đồ án]
        \begin{enumerate}\tightitems
          \item \smallnote{\textbf{Tính khả thi công nghiệp:} Đáp ứng đầy đủ các chỉ số của nhà máy (tải 20 kg, hành lang 1,2 m, tốc độ 1,2 m/s).}
          \item \smallnote{\textbf{Thiết kế cơ điện tử đồng bộ:} Quy trình liên tục từ Code OpenSCAD $\rightarrow$ Mesh STL $\rightarrow$ URDF $\rightarrow$ ROS 2.}
          \item \smallnote{\textbf{Cơ sở lý thuyết vững chắc:} Thiết lập tường minh mô hình toán động học vi sai, động lực học và chọn động cơ $\ge 4.71\text{ N}\cdot\text{m}$.}
          \item \smallnote{\textbf{Điều khiển ổn định:} Bộ điều khiển PI/PID được mô phỏng số, triệt tiêu hoàn toàn sai số xác lập tốc độ.}
          \item \smallnote{\textbf{Quy trình chuẩn V-Model:} Đảm bảo kiểm soát chất lượng từ yêu cầu hệ thống đến từng cổng đánh giá.}
        \end{enumerate}
      \end{tcolorbox}
    \end{column}

    \begin{column}{0.44\textwidth}
      \begin{tcolorbox}[panel]
        \centering
        \par
        \tinytext{Mô hình hoàn chỉnh Robot Factory Delivery AMR}
      \end{tcolorbox}
      \vspace{0.10cm}
      \begin{tcolorbox}[keypanel]
        \centering
        {\large\bfseries\color{PTITRed} XIN TRÂN TRỌNG CẢM ƠN!\par}
        \vspace{0.08cm}
        {\bfseries\fontsize{9.0}{10.5}\selectfont PHIÊN THẢO LUẬN \& HỎI ĐÁP (Q\&A)\par}
        \vspace{0.06cm}
        \tinytext{Kính mời Thầy/Cô và các bạn sinh viên đặt câu hỏi.}
      \end{tcolorbox}
    \end{column}
  \end{columns}
\end{frame}

\end{document}
