HoangAnh301194/Industrial_AMR_Robot/documents/ARM_Robot.docx

# MỤC LỤC

# CHƯƠNG 1: TỔNG QUAN HỆ THỐNG ROBOT VÀ QUY TRÌNH THIẾT KẾ

## 1.1 Đặt vấn đề và Robot dưới góc nhìn hệ thống tích hợp

Bài toán xuyên suốt học phần xuất phát từ nhu cầu của Nhà máy X: thiết kế một xe tự hành Factory Delivery AMR nhận khay linh kiện nặng 20 kg tại Kho A, vận chuyển qua hành lang rộng 1,2 m để giao đến các Trạm B, Trạm C, Trạm D với vận tốc tối thiểu 1,2 m/s, sai số dừng tại trạm nhỏ hơn 30 mm (hoặc trong khoảng ±30 mm), tự động phát hiện/tránh người và vật cản, sau đó tự quay về trạm sạc

Robot không phải là các linh kiện rời rạc mà là sự hợp nhất của 3 trụ cột kỹ thuật đặt trên nền móng kiến thức cơ bản (Giải tích, Đại số tuyến tính, Vật lý) và cơ sở ngành (Điều khiển tự động, CAD/CAM, Mạch điện – điện tử, Lập trình):

- Hệ thống Cơ khí, Truyền động: Bao gồm khung và kết cấu chịu lực, bánh xe, cơ cấu chấp hành, động cơ, hộp số và bài toán phân bố tải trọng.
- Hệ thống Điện, Điện tử: Bao gồm pin, hệ thống quản lý pin (BMS), mạch phân phối nguồn, bộ điều khiển động cơ (Driver), vi điều khiển (MCU), hệ thống cảm biến, dây dẫn và giao thức truyền thông.
- Hệ thống Phần mềm, Thuật toán: Bao gồm nền tảng ROS 2, kiến trúc máy trạng thái, thuật toán định vị (Localization), lập kế hoạch đường đi (Planning), điều khiển chuyển động và nhận thức môi trường (Perception).

## 1.2 Quy trình phát triển tổng quát 6 bước

Quá trình phát triển Factory Delivery AMR tuân theo chuỗi 6 bước có vòng lặp phản hồi từ dữ liệu thử nghiệm để liên tục hiệu chỉnh yêu cầu, phương án và thiết kế:

- Bước 1 – Nhu cầu (User Needs): Làm rõ bài toán vận chuyển khay linh kiện và các bên liên quan; tạo ra User needs, Stakeholder map, Mission statement.
- Bước 2 – Yêu cầu kỹ thuật (Requirements): Định lượng hóa tải trọng, tốc độ, sai số docking, thời gian chạy và an toàn; tạo ra Đặc tả yêu cầu hệ thống (SRS), Ma trận truy vết (RTM), Kế hoạch kiểm chứng.
- Bước 3 – Phương án + Kiến trúc (Concept + Architecture): So sánh các phương án truyền động, cảm biến, tính toán, nguồn và giao diện; tạo ra Biểu đồ hình thái (Morphological chart), Ma trận quyết định, Kiến trúc sơ bộ.
- Bước 4 – Mô hình + Mô phỏng (Modeling + Simulation): Kiểm tra động học, động cơ, pin, định vị và kịch bản vận hành; tạo ra Mô hình tính toán, mô phỏng ROS 2/Gazebo, Báo cáo mô phỏng.
- Bước 5 – Thiết kế chi tiết + Chế tạo (Detailed Design + Build): Hoàn thiện thiết kế cơ khí, sơ đồ điện, phần mềm và chế tạo nguyên mẫu; tạo ra Bản vẽ CAD, sơ đồ điện, ICD, danh mục vật tư (BOM), mã nguồn.
- Bước 6 – Tích hợp + Thử nghiệm + Cải tiến (Integration + Test + Redesign): Ghép nối các phân hệ, thử tải, tốc độ, docking, độ bền (endurance) và tránh vật cản;

## 1.3 Mô hình chữ V (V-Model) và Phương pháp thiết kế lặp (Iterative Design)

Để không rơi vào tình trạng chế tạo xong mới nghĩ cách thử nghiệm, dự án áp dụng Mô hình chữ V (V-Model) nhằm thiết lập truy vết hai chiều giữa thiết kế (nhánh trái) và kiểm thử (nhánh phải), có Mô hình hóa và Mô phỏng hỗ trợ xuyên suốt:

Cấp độ V | Nhánh trái: Xác định bài toán & Thiết kế | Nhánh phải: Tích hợp, Kiểm thử & Đánh giá
Cấp 1 | Nhu cầu người dùng: Giảm vận chuyển thủ công; giao khay an toàn giữa kho và dây chuyền. | Xác nhận nhiệm vụ (Validation): Thử nghiệm nhiệm vụ thực tế xem có đáp ứng đúng nhu cầu không.
Cấp 2 | Yêu cầu hệ thống (SRS): Tải 20 kg; tốc độ ≥ 1,2 m/s; sai số dừng ≤ ±30 mm; thời gian chạy; an toàn. | Kiểm chứng hệ thống (Verification): Đo đạc các chỉ tiêu kỹ thuật so với SRS.
Cấp 3 | Kiến trúc hệ thống: Phân hệ cơ khí, nguồn, cảm biến, MCU/SBC, ROS 2 và giao tiếp MES/WMS. | Kiểm thử tích hợp (Integration Test): Ghép thử các phân hệ và kiểm tra giao diện.
Cấp 4 (cơ sở) | Thiết kế chi tiết: Tính chọn motor-gearbox, BMS, cảm biến, mạch I/O và các node phần mềm. | Kiểm thử đơn vị (Unit Test): Thử nghiệm rời từng chi tiết, mô-đun phần cứng/phần mềm.

Bên cạnh đó, do hệ thống AMR tồn tại nhiều yếu tố bất định (trượt bánh xe trên sàn nhà máy, nhiễu cảm biến, biến thiên tải, phát nhiệt động cơ, mất định vị, tương tác người – robot), nhóm kết hợp chiến lược Thiết kế lặp (Iterative / Spiral) gồm 4 pha: Thiết kế → Mô hình / Prototype → Thử nghiệm → Phân tích lỗi (Học từ dữ liệu)

## 1.4 Quản lý dự án và các Cổng đánh giá kỹ thuật (Design Reviews)

Quá trình phát triển được kiểm soát bằng 5 công cụ quản lý: WBS (phân rã công việc theo phân hệ), Tiến độ (gắn với các mốc review), Phân công (ma trận trách nhiệm và người phê duyệt), Quản lý rủi ro (Risk register theo dõi rủi ro docking, định vị, nhiệt motor, runtime, tích hợp MES/WMS) và Quản lý cấu hình (đồng bộ phiên bản SRS, CAD, sơ đồ điện, phần mềm, BOM).

Mỗi giai đoạn phải đi qua Cổng đánh giá thiết kế (Design Review) theo quy trình: kiểm tra Điều kiện vào → nộp Gói bằng chứng (Artifacts) → Đánh giá độc lập → ra quyết định GO (duyệt baseline để chuyển tiếp), REWORK (bổ sung/sửa đổi theo danh sách hành động) hoặc STOP (dừng dự án):

- SRR (System Requirements Review): Chốt bộ yêu cầu rõ ràng, đo được và kiểm chứng được (phạm vi của báo cáo hiện tại, hoàn tất Chương 1–3).
- PDR (Preliminary Design Review): Đánh giá tính khả thi của phương án và kiến trúc sơ bộ (chọn truyền động vi sai, LiDAR–IMU–Encoder, MCU + SBC/Jetson, động cơ và pin).
- CDR (Critical Design Review): Xác nhận thiết kế chi tiết (CAD, motor/gearbox, sơ đồ điện, phần mềm, ICD, BOM) đã sẵn sàng để chế tạo.
- TRR (Test Readiness Review): Xác nhận nguyên mẫu, thiết bị đo, kịch bản thử và quy trình an toàn đã sẵn sàng cho thử nghiệm chính thức.
- FDR (Final Design Review): Tổng kết bằng chứng V&V, đối chiếu RTM sau chế tạo và thử nghiệm để nghiệm thu toàn bộ nhiệm vụ.

# 1 CHƯƠNG 2: PHÂN TÍCH YÊU CẦU VÀ KIẾN TRÚC HỆ THỐNG ROBOT

## 1.1 Phân tích bên liên quan (Stakeholders) và Khái niệm vận hành (ConOps)

Nhóm thực hiện khảo sát và phân tích các bên liên quan trực tiếp đến vòng đời của Factory Delivery AMR nhằm nhận diện đúng nhu cầu gốc trước khi đưa ra giải pháp kỹ thuật:

Bộ phận Vận hành / Sản xuất (Công nhân & Quản lý sản xuất): Quan tâm đến lưu lượng khay linh kiện, thứ tự giao hàng qua các trạm B–C–D, sự phù hợp với ca làm việc, thời gian hoàn thành chuyến, năng suất, tỷ suất hoàn vốn (ROI) và giao diện dễ hiểu, an toàn khi làm việc chung.

Bộ phận An toàn – Môi trường – Chất lượng (EHS / HSE / QA): Đặt yêu cầu nghiêm ngặt về an toàn khi robot đi chung hành lang với người, cơ chế dừng an toàn, xử lý giao cắt với xe nâng, tiêu chuẩn chống tĩnh điện (ESD) cho linh kiện điện tử và khả năng làm việc trong điều kiện bụi, nhiệt độ, độ ẩm nhà máy.

Bộ phận IT / Mua hàng / Bảo trì / Nhóm thiết kế: Quan tâm đến khả năng tích hợp giao diện điều khiển HMI/MES/WMS, phân quyền truy cập, an ninh mạng, ngân sách đầu tư, tiến độ dự án, tính dễ sửa chữa/thay thế phụ tùng và công tác đào tạo vận hành.

## 1.2 Nhiệm vụ (Mission Statement) và Quy trình vận hành dự kiến (ConOps)

- Nhu cầu người dùng (User Need): Giảm nhân lực vận chuyển linh kiện thủ công giữa kho và dây chuyền sản xuất.
- Nhiệm vụ (Mission Statement): AMR tự động vận chuyển khay linh kiện 20 kg từ Kho A đến các Trạm B, C, D trong ca sản xuất, di chuyển an toàn trong hành lang chung với công nhân và xe đẩy, tự động ghép trạm chính xác và quay về trạm sạc khi hoàn thành nhiệm vụ hoặc khi pin yếu
- Chuỗi quy trình vận hành 5 bước (Operational Scenario):
- Bước 01 – Nhận nhiệm vụ: Hệ thống nhận lệnh vận chuyển từ MES/WMS hoặc kỹ thuật viên, xác lập lộ trình tuyến A–B–C–D.
- Bước 02 – Nhận khay tại Kho A: Robot di chuyển đến Kho A, ghép trạm và xác nhận đã nhận tải (khay 20 kg).
- Bước 03 – Giao hàng tuần tự B → C → D: Robot định vị, điều hướng dọc hành lang 1,2 m, chủ động phát hiện/tránh người và vật cản, dừng chính xác tại từng trạm B, C, D với sai số nhỏ hơn 30 mm để giao hàng.
- Bước 04 – Hoàn thành nhiệm vụ: Robot cập nhật trạng thái đơn hàng về MES/WMS và kiểm tra dung lượng pin/trạng thái kỹ thuật.
- Bước 05 – Quay về sạc: Robot tìm vị trí trạm sạc (Dock sạc) và tự động ghép trạm để nạp lại năng lượng.
- Ranh giới hệ thống (System Boundary) và Khảo sát môi trường

Ranh giới hệ thống của Factory Delivery AMR bao gồm 4 nhóm chức năng ca sử dụng nội tại (Nhận nhiệm vụ, Vận chuyển khay, Tránh vật cản, Tự động sạc) tương tác với 4 tác nhân bên ngoài (Hệ thống MES/WMS, Kỹ thuật viên, Nhân viên trạm, Trạm sạc). Để đảm bảo thiết kế sát thực tế, 5 yếu tố môi trường nhà máy bắt buộc phải khảo sát thực địa gồm:

Yếu tố khảo sát | Nội dung cần đo đạc | Ảnh hưởng trực tiếp đến thiết kế
Lối đi & góc cua | Bề rộng thông thủy thực tế, các vật nhô ra trên tường/kệ, không gian quay đầu tại giao lộ. | Quyết định kích thước bao hình (footprint) và vùng bảo vệ an toàn của robot.
Mặt sàn | Độ dốc, hệ số cản lăn ( c_(rr) ), khe nối sàn, độ nhám và độ bám. | Quyết định lực kéo, mô-men động cơ, công suất và quãng đường phanh.
Kho và khay | Kích thước hình học khay, vị trí trọng tâm tải, yêu cầu chống tĩnh điện (ESD). | Quyết định kết cấu khung, độ ổn định chống lật và vật liệu bề mặt gá khay.
Người / xe nâng | Mật độ người qua lại, điểm giao cắt xe nâng, quy tắc ưu tiên giao thông nội bộ. | Quyết định vận tốc giới hạn theo vùng, tầm quét cảm biến và thuật toán dừng/chờ.
Trạm & sạc | Tọa độ các trạm A/B/C/D, nguồn điện trạm sạc, mức độ tự động hóa giao nhận khay. | Quyết định phương án ghép trạm (docking), cơ cấu nhận khay và dung lượng pin.

## 1.3 Phân tích chức năng và Xây dựng kiến trúc hệ thống

Từ các yêu cầu trong SRS, hệ thống được phân tích thông qua Luồng chức năng (Functional Flow) gồm chuỗi hoạt động: Nhận nhiệm vụ → Xác định vị trí → Lập đường → Di chuyển → Phát hiện vật cản → Tránh vật cản → Ghép trạm (Docking) → Giao hàng / Nhiệm vụ tiếp theo, vận hành đồng thời trên 3 luồng: Vật chất (Robot + hàng hóa), Năng lượng (Pin → Điện → Cơ) và Thông tin (Nhiệm vụ, bản đồ, dữ liệu cảm biến, trạng thái).

Cây phân rã chức năng của Factory Delivery AMR chia nhiệm vụ tổng thể thành 4 nhánh chức năng chính và 8 chức năng con, sau đó phân bổ trực tiếp sang 6 phân hệ vật lý:

Nhánh chức năng chính | Chức năng cấp con | Phân hệ vật lý đảm nhiệm (Subsystem) | Phần tử phần cứng / phần mềm cụ thể (Allocated Elements)
Quản lý nhiệm vụ | Nhận lệnh vận chuyển; Báo cáo trạng thái. | Truyền thông & Tính toán (Communication & Computing). | Máy tính nhúng SBC/Jetson, module Wi-Fi/Ethernet, giao diện MES/WMS và HMI.
Di chuyển | Sinh lực kéo; Điều khiển chuyển động (tốc độ, hướng). | Di chuyển & Tính toán tầng thấp (Locomotion & Control). | Động cơ BLDC + hộp số, bánh xe chủ động, bánh caster, Driver và vi điều khiển MCU.
Nhận biết | Định vị (ước lượng tư thế/pose); Phát hiện vật cản & lập đường. | Cảm nhận & Tính toán tầng cao (Perception & Computing). | Cảm biến LiDAR 2D, IMU, bộ mã hóa vòng quay (Encoder), Camera/Marker và SBC/Jetson chạy SLAM/Nav2.
Duy trì hoạt động | Cấp nguồn & quản lý năng lượng; Đảm bảo an toàn (dừng khẩn cấp). | Nguồn & An toàn (Power & Safety). | Pin LiFePO_4 , mạch quản lý pin (BMS), phần mềm giám sát nguồn, cảm biến an toàn và mạch cắt phần cứng E-stop.

# 2 CHƯƠNG 3: XÂY DỰNG PHƯƠNG ÁN THIẾT KẾ VÀ TÍNH TOÁN LỰA CHỌN THÔNG SỐ SƠ BỘ

## 2.1 Cơ sở lựa chọn Kích thước hình học, Cấu hình bánh xe và Khối lượng

Kích thước bao hình (Footprint) và khoảng hở hành lang

- Kích thước thân xe đề xuất: Dài × Rộng × Cao = 700×550×450 mm .
- Kiểm tra hình học trên hành lang rộng 1.200 mm ( 1,2 m ):
- Khi robot đi dọc tâm hành lang với bề rộng thân 550 mm , khoảng hở hình học còn lại ở mỗi bên là:

Khoảng hở mỗi bên=(1.200-550)/2=325 mm/bên

- Đường chéo bao hình thân xe đạt khoảng √(700^2 +550^2)≈890 mm (nhỏ hơn bề rộng hành lang 1.200 mm ), về mặt hình học cho phép xe xoay trở nhưng vẫn cần kiểm tra kỹ tại các góc cua hẹp, quỹ đạo quét của bánh caster và độ ổn định khi mang tải

## 2.2 Khối lượng thiết kế và phân bố tải trên bánh xe

- Cấu hình bánh: Gồm 2 bánh chủ động (điều khiển vi sai) kết hợp 2 bánh tự lựa (caster) chịu tải.
- Tổng khối lượng thiết kế ( m ): Giả định khối lượng bản thân robot là 55 kg cộng với tải trọng khay hàng 20 kg , tổng khối lượng toàn tải là:

m=55 kg+20 kg=75 kg

- Tải tĩnh tham khảo trên mỗi bánh: Trong trường hợp lý tưởng phân bố đều trên 4 điểm tựa, tải tĩnh mỗi bánh là 75/4=18,75 kg/bánh (trong giai đoạn thiết kế chi tiết cần kiểm tra lại phân bố tải thực tế bằng mô hình 3D CAD và vị trí trọng tâm).

## 2.3 Tính toán Động lực học: Lực kéo, Mô-men, Động cơ và Hộp số

Để chọn bộ truyền động có cơ sở định lượng, nhóm thực hiện tính toán sơ bộ với bộ thông số giả định: tổng khối lượng m=75 kg , hệ số cản lăn trên sàn nhà máy c_(rr) =0,025 , gia tốc thiết kế a=0,80 m/s^2 , gia tốc trọng trường g≈9,81 m/s^2 và hệ số dự phòng an toàn lực kéo k=1,5 :

Đại lượng tính toán | Công thức áp dụng | Kết quả định lượng
Lực cản lăn ( F_(rr) ) | F_(rr) =c_(rr) ×m×g | 18,39 N
Lực quán tính khi tăng tốc ( F_a ) | F_a =m×a | 60,00 N
Tổng lực kéo thiết kế ( F ) | F=1,5×(F_(rr) +F_a ) | 117,59 N
Mô-men yêu cầu trên mỗi bánh chủ động ( T ) | T=(F×r)/2 (với bán kính bánh r=0,08 m ) | 4,70 Nm

## 2.4 Lựa chọn đường kính bánh xe, hộp số và động cơ

- Đường kính bánh xe chủ động: Chọn bánh xe đường kính ∅160 mm (bán kính r=0,08 m ).
- Tốc độ quay của bánh xe ( n_(bánh) ): Để đạt vận tốc dài v=1,2 m/s , tốc độ vòng quay tại bánh xe là:

n_(bánh) =(60×v)/(2πr)=(60×1,2)/(2π×0,08)≈143,2 rpm

- Tỷ số truyền hộp số và tốc độ động cơ: Lựa chọn hộp số giảm tốc có tỷ số truyền i=10:1 nhằm đưa tốc độ làm việc của động cơ lên vùng hiệu suất tối ưu:

n_(motor) =143,2×10≈1.432 rpm (vùng tốc độ ∼1.430 rpm)

- Ứng viên động cơ đề xuất: Sử dụng 2 động cơ BLDC 48 V – 250 W. Trong bước tiếp theo, nhóm sẽ đối chiếu chi tiết đặc tính đồ thị mô-men – tốc độ, hiệu suất hộp số, bài toán tản nhiệt, mô-men đỉnh khi khởi hành và khả năng hãm trên mặt sàn thực tế.

## 2.5 Phương án Điện – Điện tử: Tính toán Pin, Bộ cảm biến và An toàn quãng dừng

Lựa chọn và phân tích ngân sách năng lượng Pin

- Cấu hình pin đề xuất: Pin LiFePO_4 51,2 V – 50 Ah tích hợp BMS.
- Năng lượng danh định:

E_(danh định) =51,2 V×50 Ah=2.560 Wh

- Năng lượng khả dụng thực tế: Giả định giới hạn xả sâu (DOD) ở mức 80% dung lượng và hiệu suất chuyển đổi toàn hệ thống đạt 90%:

E_(khả dụng) =2.560×0,8×0,9≈1.843 Wh

- Đánh giá thời gian chạy (Runtime) theo công suất tiêu thụ trung bình ( P_(tb) ):
  - Nếu P_(tb) =350 W : Thời gian hoạt động liên tục sau 1 lần sạc đạt T≈1.843/350=5,27 giờ (đáp ứng tốt mốc ≥4 giờ của khung bài toán học phần).
  - Nếu P_(tb) =500 W : Thời gian hoạt động giảm xuống T≈1.843/500=3,69 giờ .
  - Lý do chưa khóa cứng cấu hình pin tại SRR: Để đáp ứng yêu cầu vận hành 24 giờ trong bộ thông số khách hàng SB-01, cần xác nhận rõ chu kỳ làm việc/sạc (duty cycle) thực tế và đảm bảo công suất tiêu thụ trung bình nằm trong ngân sách năng lượng (nhỏ hơn hoặc bằng 461 W cho mỗi chu kỳ 4 giờ chạy liên tục trước khi ghép trạm sạc tự động).

Tổ hợp cảm biến (Perception Suite), Định vị và Ghép trạm

Để giải quyết bài toán định vị trong nhà, tránh vật cản và ghép trạm với sai số dưới 30 mm , hệ thống sử dụng phương pháp Hợp nhất cảm biến (Sensor Fusion) từ các thiết bị sau:

Thiết bị / Nguồn dữ liệu | Vai trò kỹ thuật trong hệ thống | Cơ sở lựa chọn cho Factory AMR
LiDAR 2D (/scan) | Quét mặt phẳng ngang để phát hiện vật cản và cung cấp dữ liệu đầu vào cho thuật toán SLAM. | Độ chính xác khoảng cách cao, hoạt động ổn định trong không gian nhà xưởng trong nhà.
Bộ mã hóa vòng quay (Encoder / /odom) | Đo chuyển động quay của bánh xe để tính toán vận tốc và quãng đường dịch chuyển (Odometry). | Cung cấp phản hồi tốc độ tần số cao cho vòng điều khiển động cơ và ước lượng vị trí ngắn hạn.
Cảm biến quán tính (IMU) | Đo tốc độ góc và gia tốc để ước lượng hướng (orientation) ngắn hạn. | Kết hợp với Encoder giúp hiệu chỉnh sai số odometry khi bánh xe bị trượt trên sàn.
Camera chiều sâu & Marker tại trạm | Nhận diện công nhân và phát hiện điểm mốc (fiducial marker) tại các trạm A, B, C, D và trạm sạc. | Cung cấp dữ liệu hiệu chỉnh tư thế cục bộ (local pose refinement) để đạt mục tiêu sai số dừng nhỏ hơn 30 mm.
Cảm biến an toàn & Mạch E-stop | Giám sát vùng nguy hiểm xung quanh xe và kích hoạt dừng bảo vệ độc lập. | Chức năng an toàn (Safety) bắt buộc phải tách biệt và đánh giá độc lập với điều hướng thông thường.

## 2.6 Tính toán tốc độ, quãng đường dừng và chiến lược an toàn

- Điều kiện tính toán: Vận tốc tối đa v=1,2 m/s chỉ áp dụng trên đoạn đường trống, không áp dụng mọi lúc (như khi vào cua hay đi gần người). Giả định thời gian trễ phản ứng toàn hệ thống (cảm biến + xử lý + cơ cấu phanh) là t_d =0,20 s và gia tốc hãm trung bình là a=0,80 m/s^2 .
- Quãng đường dừng lý thuyết ( s ):

s=v⋅t_d +(v^2)/(2a)=1,2×0,20+(1,2^2)/(2×0,80)=0,24+(1,44)/(1,6)=1,14 m

- Đánh giá và quy tắc ứng xử an toàn:
  - Quãng dừng 1,14 m mới là giá trị lý thuyết, chưa bao gồm biên dự phòng an toàn, sai số phép đo cảm biến, sự suy giảm độ bám mặt sàn và các yêu cầu theo tiêu chuẩn an toàn công nghiệp. Do đó, yêu cầu phát hiện người từ khoảng cách ≥3 m (R06) là hoàn toàn hợp lý để xe có đủ không gian phản ứng.
  - Quy tắc ứng xử khi gặp người: Chủ động Giảm tốc → Dừng hẳn → Chờ; robot chỉ được phép lập quỹ đạo đi vòng qua người khi hành lang hoặc tuyến đường phụ đủ thông thoáng và được xác nhận an toàn tuyệt đối.

## 2.7 Phương án Phần mềm – Điều khiển và Lộ trình triển khai tiếp theo

Kiến trúc phân chia Phần cứng / Phần mềm (Hardware/Software Partitioning)

Hệ thống điều khiển được thiết kế phân tầng rõ ràng nhằm tối ưu hóa tài nguyên tính toán, độ trễ thời gian thực và chi phí:

- Tầng xử lý cấp cao – Máy tính nhúng (SBC / NVIDIA Jetson): Chạy hệ điều hành Ubuntu và middleware ROS 2, đảm nhận các tác vụ tính toán nặng gồm: LiDAR SLAM, định vị toàn cục, điều hướng và lập kế hoạch đường đi (Nav2), xử lý nhận thức vật cản/camera, quản lý máy trạng thái nhiệm vụ và giao tiếp mạng với MES/WMS.
- Giao thức kết nối nội bộ: Truyền thông hai chiều giữa SBC/Jetson và vi điều khiển thông qua chuẩn công nghiệp CAN hoặc UART.
- Tầng điều khiển thời gian thực – Vi điều khiển (MCU): Trực tiếp xuất tín hiệu điều khiển xuống Driver + Động cơ BLDC, đọc xung Encoder tần số cao để khóa vòng điều khiển vận tốc bánh xe, đồng thời giám sát các ngõ vào/ra an toàn (Safety I/O) và mạch cắt khẩn cấp.

## 2.8 Mô phỏng URDF – Gazebo – SLAM – Nav2 (Hướng tới Chương 4 & 5)

Sau khi hoàn tất giai đoạn phân tích yêu cầu và thiết kế sơ bộ tại cổng SRR, nhóm đã vạch rõ lộ trình kỹ thuật tiếp theo cho giai đoạn Mô hình hóa & Mô phỏng:

1. Xây dựng mô hình URDF/Xacro: Định nghĩa đầy đủ khung xe, bánh chủ động, bánh caster, khung gắn LiDAR và IMU. Nhóm kế thừa gói mô tả robot và nghiên cứu cơ cấu nâng từ kho mã nguồn mở GitHub Nhatdzvk/agv, đồng thời thực hiện rà soát, kiểm toán (audit) lại toàn bộ thông số quán tính URDF, cây tọa độ TF và các plugin mô phỏng.
2. Thiết lập môi trường Gazebo Warehouse: Xây dựng nhà xưởng ảo có mặt sàn, hệ thống kệ hàng và tọa độ chính xác của Kho A cùng các Trạm B, C, D.
3. Đồng bộ cây tọa độ TF + Odometry: Thiết lập chuẩn xác chuỗi biến đổi tọa độ map → odom → base_link.
4. Thực thi SLAM / Map: Điều khiển robot quét và tạo bản đồ 2D thử nghiệm của nhà xưởng.
5. Tích hợp bộ điều hướng Nav2: Cấu hình các bộ lập kế hoạch toàn cục/cục bộ (Global/Local Planner) và điều hướng tự động theo các điểm đích (Waypoints) qua chuỗi trạm A–B–C–D. (Báo cáo ghi nhận minh bạch: đây là lộ trình bước tiếp theo sau SRR, nhóm chưa tuyên bố đã chạy thành công toàn bộ nhiệm vụ A–B–C–D trên Gazebo ở thời điểm hiện tại).
