HoangAnh301194/Industrial_AMR_Robot/DTSV_16_DONG_DANG_TINH.docx

HỌC VIỆN CÔNG NGHỆ BƯU CHÍNH VIỄN THÔNG

KHOA KỸ THUẬT ĐIỆN TỬ 1

------oOo------

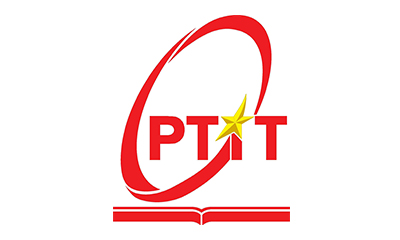
[picture p54: figure]

ĐỀ TÀI NGHIÊN CỨU KHOA HỌC

NGHIÊN CỨU PHƯƠNG PHÁP ĐIỀU KHIỂN DỰA TRÊN MÔ HÌNH ĐỘNG LỰC HỌC (MODEL-BASED CONTROL) CHO ROBOT BÁNH XE ĐA HƯỚNG

Giảng viên hướng dẫn | : | Hoàng Sơn
Nhóm sinh viên thực hiện | :
Đồng Đăng Tình | : | B23DCDK136
Lê Văn Trường | : | B23DCDK138
Nguyễn Hữu Hoàng Anh | : | B23DCDK016

Hà Nội – 09/2026

LỜI CAM ĐOAN

Nhóm tác giả xin cam đoan rằng công trình nghiên cứu khoa học với đề tài: “Nghiên cứu phương pháp điều khiển dựa trên mô hình động lực học (Model-Based Control) cho robot bánh xe đa hướng” là kết quả nghiên cứu độc lập của nhóm sinh viên thực hiện dưới sự định hướng và hướng dẫn khoa học của thầy Hoàng Sơn.

Các nội dung, số liệu tính toán, thuật toán điều khiển và kết quả mô phỏng số trên môi trường MATLAB được trình bày trong báo cáo là trung thực, khách quan và chưa từng được công bố tại bất kỳ công trình, cuộc thi hay hội đồng bảo vệ nào khác nhằm mục đích nhận học vị hay khen thưởng.

Mọi tài liệu tham khảo, lý thuyết kế thừa, phương trình toán học và hình ảnh trích dẫn từ các công trình nghiên cứu của các tác giả khác trong và ngoài nước đều đã được trích dẫn nguồn gốc đầy đủ, rõ ràng theo đúng chuẩn mực liêm chính học thuật. Nhóm tác giả xin chịu hoàn toàn trách nhiệm trước Hội đồng Khoa học, Khoa Kỹ thuật Điện tử 1 và Học viện Công nghệ Bưu chính Viễn thông về tính chính xác và tính xác thực của lời cam đoan này.

LỜI CẢM ƠN

Để hoàn thành công trình nghiên cứu khoa học này, bên cạnh sự nỗ lực làm việc của các thành viên trong nhóm, chúng em đã nhận được sự quan tâm, chỉ dẫn tận tình và tạo điều kiện thuận lợi từ các thầy cô giáo và nhà trường.

Trước hết, nhóm tác giả xin bày tỏ lòng biết ơn sâu sắc và chân thành nhất tới thầy Hoàng Sơn. Trong suốt quá trình thực hiện đề tài, thầy đã luôn tận tâm định hướng nghiên cứu, trực tiếp giải đáp những khó khăn chuyên môn về mô hình hóa toán học, thuật toán điều khiển phi tuyến và phương pháp đánh giá kết quả mô phỏng, đồng thời động viên nhóm hoàn thành báo cáo với tính khoa học cao nhất.

Nhóm tác giả cũng xin trân trọng gửi lời cảm ơn tới Ban Giám đốc Học viện Công nghệ Bưu chính Viễn thông, Ban Chủ nhiệm Khoa Kỹ thuật Điện tử 1, cùng toàn thể quý thầy cô giáo trong khoa. Những nền tảng kiến thức chuyên ngành về lý thuyết điều khiển tự động, kỹ thuật vi điều khiển, mô hình hóa hệ thống và phương pháp nghiên cứu khoa học mà quý thầy cô truyền đạt trong suốt quá trình học tập là cơ sở quan trọng giúp chúng em thực hiện đề tài này.

Mặc dù nhóm đã có nhiều cố gắng trong việc khảo sát tài liệu, thiết lập mô hình và kiểm chứng thuật toán, song do giới hạn về mặt thời gian và kinh nghiệm nghiên cứu, báo cáo khó tránh khỏi những thiếu sót nhất định. Nhóm sinh viên thực hiện rất mong nhận được những nhận xét, góp ý và chỉ dẫn quý báu từ quý thầy cô trong Hội đồng Khoa học để công trình nghiên cứu được hoàn thiện hơn nữa và làm nền tảng cho việc phát triển thử nghiệm trên hệ thống thực tế trong tương lai.

Chúng em xin kính chúc quý thầy cô luôn dồi dào sức khỏe, hạnh phúc và gặt hái được nhiều thành công trong sự nghiệp nghiên cứu khoa học và giảng dạy.

# MỞ ĐẦU

## 1. Tính cấp thiết của đề tài

Trong những năm gần đây, robot di động tự hành ngày càng được ứng dụng rộng rãi trong nhiều lĩnh vực như sản xuất công nghiệp, logistics, kho vận thông minh, y tế và robot dịch vụ. Khả năng tự động di chuyển, vận chuyển hàng hóa và hoạt động linh hoạt trong không gian hạn chế giúp robot di động trở thành một trong những thành phần quan trọng của các hệ thống sản xuất hiện đại.

Trong số các cấu hình robot di động bánh xe, robot sử dụng bánh Mecanum có ưu điểm nổi bật nhờ khả năng chuyển động đa hướng. Khác với robot sử dụng cơ cấu vi sai truyền thống, robot Mecanum có thể thực hiện đồng thời các chuyển động tiến, lùi, dịch ngang, chuyển động chéo và quay tại chỗ mà không cần thay đổi hướng thân xe trước khi di chuyển. Đặc tính này đặc biệt phù hợp với các môi trường có không gian hẹp hoặc yêu cầu khả năng cơ động cao như nhà kho, dây chuyền sản xuất và các hệ thống vận chuyển tự động.

Tuy nhiên, khả năng chuyển động linh hoạt của robot Mecanum cũng làm cho bài toán điều khiển trở nên phức tạp hơn. Để robot có thể di chuyển chính xác theo một quỹ đạo đặt trước, bộ điều khiển không chỉ cần xác định quan hệ động học giữa vận tốc thân robot và tốc độ của từng bánh xe mà còn phải xét đến các yếu tố động lực học như khối lượng robot, mô-men quán tính, lực ma sát và các tác động bên ngoài.

Các phương pháp điều khiển dựa chủ yếu trên mô hình động học có ưu điểm là đơn giản và dễ triển khai. Tuy nhiên, khi robot hoạt động với tốc độ cao, tải trọng thay đổi hoặc chịu tác động của nhiễu bên ngoài, việc bỏ qua các đặc tính động lực học có thể làm giảm độ chính xác bám quỹ đạo. Trong trường hợp đó, phản ứng của robot không chỉ phụ thuộc vào quan hệ hình học giữa các bánh xe mà còn chịu ảnh hưởng trực tiếp bởi khối lượng, quán tính và lực tác động lên hệ thống.

Bộ điều khiển PID là một trong những phương pháp điều khiển được sử dụng phổ biến nhờ cấu trúc đơn giản, dễ triển khai và có khả năng đáp ứng tốt trong nhiều hệ thống thực tế. Tuy nhiên, PID chủ yếu xây dựng tín hiệu điều khiển từ sai số giữa giá trị mong muốn và giá trị thực tế, do đó không trực tiếp khai thác các thông tin về mô hình động lực học của đối tượng.

Một hướng tiếp cận khác là sử dụng phương pháp điều khiển dựa trên mô hình động lực học, trong đó tín hiệu điều khiển được xây dựng dựa trên các thành phần động lực học của robot. Đối với robot Mecanum, phương pháp này có thể sử dụng ma trận khối lượng và quán tính, thành phần Coriolis và thành phần ma sát để bù lại ảnh hưởng của động lực học đối tượng. Đây là cơ sở của phương pháp điều khiển dựa trên mô hình theo nguyên lý Computed Torque Control.

Xuất phát từ những vấn đề trên, đề tài “Nghiên cứu phương pháp điều khiển dựa trên mô hình động lực học (Model-Based Control) cho robot bánh xe đa hướng” được thực hiện nhằm xây dựng mô hình toán của robot, thiết kế bộ điều khiển dựa trên mô hình động lực học, đồng thời so sánh với bộ điều khiển PID trong các điều kiện vận hành khác nhau thông qua mô phỏng trên MATLAB.

## 2. Mục tiêu và nhiệm vụ nghiên cứu

### 2.1. Mục tiêu nghiên cứu

Mục tiêu tổng quát của đề tài là nghiên cứu phương pháp điều khiển dựa trên mô hình động lực học cho robot Mecanum bốn bánh, từ đó đánh giá khả năng bám quỹ đạo của phương pháp này trong các điều kiện vận hành khác nhau.

Trên cơ sở mô hình toán của robot, bộ điều khiển Model-Based Control theo nguyên lý Computed Torque Control được xây dựng nhằm khai thác các thông tin động lực học của hệ thống. Hiệu quả của phương pháp được đánh giá thông qua việc so sánh với bộ điều khiển PID đã được hiệu chỉnh trong cùng điều kiện mô phỏng.

Các mục tiêu cụ thể của đề tài gồm:

- Xây dựng mô hình động học của robot Mecanum bốn bánh và xác định quan hệ giữa vận tốc thân robot với tốc độ góc của từng bánh xe.
- Xây dựng mô hình động lực học rút gọn của robot trong chuyển động phẳng ba bậc tự do.
- Thiết kế bộ điều khiển dựa trên mô hình động lực học theo nguyên lý Computed Torque Control.
- Xây dựng bộ điều khiển PID và lựa chọn thông số phù hợp để làm phương pháp đối chứng.
- Xây dựng chương trình mô phỏng trên MATLAB nhằm kiểm chứng khả năng bám quỹ đạo của robot.
- Khảo sát chất lượng điều khiển trong điều kiện danh định, khi tham số tải trọng thay đổi và khi xuất hiện nhiễu ngoại lực.
- Đánh giá định lượng chất lượng của hai phương pháp thông qua sai số vị trí, sai số góc và chỉ số RMSE.

### 2.2. Nhiệm vụ nghiên cứu

Để đạt được các mục tiêu trên, đề tài thực hiện các nhiệm vụ chính gồm nghiên cứu cấu tạo và nguyên lý chuyển động của bánh Mecanum; thiết lập hệ tọa độ và phương trình động học; xây dựng phương trình động lực học của robot; xây dựng thuật toán Model-Based Control và PID; xây dựng chương trình mô phỏng; thiết lập các trường hợp thử nghiệm; thu thập kết quả mô phỏng và phân tích định lượng sự khác biệt giữa hai phương pháp điều khiển.

## 3. Đối tượng và phạm vi nghiên cứu

### 3.1. Đối tượng nghiên cứu

Đối tượng nghiên cứu của đề tài là robot di động đa hướng sử dụng bốn bánh Mecanum. Robot được xét trong không gian chuyển động phẳng với ba bậc tự do gồm chuyển động tịnh tiến theo hai phương x, y và chuyển động quay quanh trục thẳng đứng.

## Vector trạng thái vị trí của robot được biểu diễn dưới dạng:

q=[xyθ] trong đó x và y là tọa độ tâm robot trong hệ tọa độ toàn cục, còn θ là góc định hướng của robot.

Vector vận tốc của robot trong hệ tọa độ gắn với thân xe được biểu diễn:

ν=[v_x v_y ω] trong đó v_x , v_y lần lượt là vận tốc tịnh tiến theo hai trục của thân robot và ω là vận tốc góc.

### 3.2. Phạm vi nghiên cứu

Trong phạm vi đề tài, robot được giả thiết chuyển động trên mặt phẳng nằm ngang và được xem như một vật rắn. Mô hình động lực học sử dụng trong nghiên cứu là mô hình rút gọn ba bậc tự do:

M⁢ν+C(ν)ν+D⁢ν=τ trong đó M là ma trận khối lượng và quán tính, C(ν) là ma trận biểu diễn ảnh hưởng Coriolis, D là ma trận ma sát và τ là vector lực, mô-men tổng quát tác dụng lên robot.

Đề tài tập trung vào hai phương pháp điều khiển là bộ điều khiển dựa trên mô hình động lực học và bộ điều khiển PID.

Việc kiểm chứng được thực hiện bằng mô phỏng số trên MATLAB. Đề tài chưa xét chi tiết mô hình điện của động cơ, đặc tính phi tuyến của động cơ, biến dạng cơ khí của bánh xe, trượt phi tuyến phức tạp giữa bánh và mặt sàn, nhiễu cảm biến cũng như các sai số chế tạo thực tế.

Các giả thiết trên được sử dụng nhằm tập trung đánh giá ảnh hưởng của việc sử dụng mô hình động lực học trong bài toán bám quỹ đạo.

## 4. Phương pháp nghiên cứu

Đề tài sử dụng kết hợp phương pháp nghiên cứu lý thuyết, mô hình hóa toán học, mô phỏng số và phân tích định lượng.

Trước hết, các nguyên lý chuyển động của robot Mecanum được phân tích nhằm xây dựng mô hình động học của hệ thống. Trên cơ sở đó, quan hệ giữa vận tốc thân robot và tốc độ góc của bốn bánh xe được thiết lập thông qua ma trận Jacobian.

Tiếp theo, mô hình động lực học của robot được xây dựng nhằm biểu diễn ảnh hưởng của khối lượng, mô-men quán tính, lực Coriolis và ma sát đối với chuyển động của robot. Phương trình động lực học tổng quát được biểu diễn:

M⁢ν+C(ν)ν+D⁢ν=τ⁢. Từ mô hình trên, bộ điều khiển dựa trên mô hình động lực học được thiết kế theo nguyên lý bù động lực học. Song song với đó, một bộ điều khiển PID được xây dựng và hiệu chỉnh để làm phương pháp đối chứng.

Các thuật toán sau đó được triển khai dưới dạng chương trình MATLAB. Cùng một mô hình robot và cùng một quỹ đạo tham chiếu được sử dụng cho cả hai bộ điều khiển nhằm bảo đảm điều kiện so sánh thống nhất.

Ba trường hợp được xây dựng để đánh giá chất lượng điều khiển. Trường hợp thứ nhất khảo sát robot trong điều kiện danh định. Trường hợp thứ hai tạo sai lệch giữa mô hình sử dụng trong bộ điều khiển và tham số của đối tượng bằng cách tăng khối lượng và mô-men quán tính của robot. Trường hợp thứ ba bổ sung lực và mô-men nhiễu tác động lên robot trong một khoảng thời gian xác định.

Các kết quả được đánh giá thông qua sai số bám vị trí, sai số góc định hướng, RMSE toàn quá trình và RMSE trong các giai đoạn khảo sát đặc biệt. Bên cạnh đó, tín hiệu điều khiển và tốc độ góc của các bánh xe cũng được sử dụng để phân tích mức độ tác động điều khiển của từng phương pháp.

## 5. Ý nghĩa khoa học và thực tiễn của đề tài

### 5.1. Ý nghĩa khoa học

Đề tài góp phần hệ thống hóa cơ sở lý thuyết về mô hình động học và động lực học của robot Mecanum bốn bánh. Trên cơ sở mô hình được xây dựng, đề tài làm rõ nguyên lý sử dụng thông tin động lực học trong việc thiết kế bộ điều khiển bám quỹ đạo.

Thông qua việc sử dụng cùng một đối tượng và cùng điều kiện mô phỏng để so sánh Model-Based Control với PID, nghiên cứu cung cấp cơ sở định lượng để đánh giá ảnh hưởng của phương pháp bù động lực học đối với chất lượng bám quỹ đạo.

Đặc biệt, việc khảo sát các trường hợp sai lệch tham số và tác động nhiễu giúp đánh giá rõ hơn khả năng duy trì chất lượng điều khiển khi đối tượng không còn hoàn toàn trùng khớp với điều kiện danh định.

### 5.2. Ý nghĩa thực tiễn

Kết quả nghiên cứu có thể được sử dụng làm cơ sở cho việc thiết kế hệ thống điều khiển robot Mecanum trong các ứng dụng thực tế như robot vận chuyển tự động, AGV, AMR và robot dịch vụ.

Mô hình và chương trình mô phỏng được xây dựng trong đề tài cũng có thể được sử dụng làm nền tảng để tiếp tục phát triển các thuật toán điều khiển nâng cao như điều khiển thích nghi, điều khiển trượt, điều khiển bền vững hoặc điều khiển dự báo mô hình.

Ngoài ra, kết quả mô phỏng là cơ sở bước đầu cho quá trình triển khai thuật toán trên robot thực trong các nghiên cứu tiếp theo.

## 6. Bố cục báo cáo

Ngoài phần Mở đầu, Tài liệu tham khảo và Phụ lục, nội dung chính của báo cáo được tổ chức thành năm chương.

Chương 1 – Tổng quan về robot Mecanum và bài toán bám quỹ đạo trình bày tổng quan về robot di động bánh xe, đặc điểm của robot Mecanum, các phương pháp điều khiển phổ biến, tình hình nghiên cứu và bài toán bám quỹ đạo.

Chương 2 – Mô hình hóa toán học robot Mecanum bốn bánh xây dựng hệ tọa độ, mô hình động học, quan hệ giữa vận tốc robot và tốc độ các bánh xe, đồng thời thiết lập mô hình động lực học sử dụng trong nghiên cứu.

Chương 3 – Thiết kế bộ điều khiển bám quỹ đạo trình bày phương pháp điều khiển dựa trên mô hình động lực học theo nguyên lý Computed Torque Control, thiết kế bộ PID đối chứng và phân tích đặc điểm của hai phương pháp.

Chương 4 – Mô phỏng và đánh giá kết quả trình bày môi trường mô phỏng MATLAB, thông số của robot, các trường hợp khảo sát, kết quả bám quỹ đạo và các chỉ tiêu đánh giá định lượng.

Chương 5 – Kết luận và hướng phát triển tổng hợp các kết quả đạt được, chỉ ra những hạn chế của nghiên cứu và đề xuất các hướng phát triển tiếp theo.

Từ những nội dung đã trình bày, có thể thấy việc nghiên cứu bộ điều khiển dựa trên mô hình động lực học cho robot Mecanum cần được xây dựng trên cơ sở hiểu rõ đặc điểm chuyển động của hệ thống, các phương pháp điều khiển đã được nghiên cứu và yêu cầu của bài toán bám quỹ đạo. Vì vậy, Chương 1 sẽ trình bày tổng quan về robot di động đa hướng, cấu tạo và nguyên lý của bánh Mecanum, các hướng điều khiển liên quan cũng như cơ sở hình thành bài toán nghiên cứu của đề tài.

# CHƯƠNG 1. TỔNG QUAN VỀ ROBOT MECANUM VÀ BÀI TOÁN BÁM QUỸ ĐẠO

## 1.1. Tổng quan về robot di động bánh xe

### 1.1.1. Khái niệm và phân loại robot di động bánh xe

Robot di động là một lớp hệ thống robot có khả năng thay đổi vị trí trong môi trường làm việc thay vì bị cố định tại một vị trí như các tay máy công nghiệp truyền thống. Tùy thuộc vào môi trường và yêu cầu vận hành, robot di động có thể sử dụng nhiều cơ cấu di chuyển khác nhau như bánh xe, bánh xích, chân hoặc kết hợp nhiều cơ cấu.

Trong đó, robot di động bánh xe được sử dụng rộng rãi nhờ có kết cấu cơ khí tương đối đơn giản, hiệu suất chuyển động cao, dễ chế tạo và thuận lợi trong việc tích hợp cảm biến cũng như các hệ thống điều khiển.

Dựa trên cấu trúc truyền động và khả năng chuyển động, robot bánh xe có thể được chia thành một số dạng phổ biến như robot truyền động vi sai, robot sử dụng cơ cấu lái kiểu Ackermann, robot sử dụng bánh Omni và robot sử dụng bánh Mecanum.

Robot truyền động vi sai thường sử dụng hai bánh chủ động bố trí hai bên thân xe. Việc điều khiển sự chênh lệch tốc độ giữa hai bánh cho phép robot chuyển động tiến, lùi hoặc quay. Ưu điểm của cấu hình này là đơn giản, tuy nhiên robot không thể trực tiếp dịch chuyển theo phương ngang.

Robot kiểu Ackermann có nguyên lý tương tự phương tiện ô tô, trong đó bánh xe được điều chỉnh góc lái để thay đổi hướng chuyển động. Cấu hình này thích hợp khi robot chuyển động với tốc độ tương đối cao nhưng bán kính quay và không gian thao tác là những yếu tố cần được xem xét.

Trong các ứng dụng yêu cầu tính cơ động cao, robot đa hướng sử dụng bánh Omni hoặc bánh Mecanum mang lại nhiều lợi thế. Nhờ cấu tạo đặc biệt của bánh xe, robot có thể đồng thời tạo chuyển động dọc, ngang và quay, từ đó thực hiện các quỹ đạo phức tạp mà không cần đổi hướng thân xe trước khi di chuyển.

### 1.1.2. Robot di động đa hướng

Robot di động đa hướng (Omnidirectional Mobile Robot – OMR) được thiết kế nhằm cho phép nền tảng robot tạo chuyển động tức thời theo nhiều hướng trên mặt phẳng. Đối với cấu hình Mecanum bốn bánh, vận tốc chuyển động của thân robot có thể được biểu diễn bởi ba thành phần:

ν=[v_x v_y ω] trong đó v_x là vận tốc theo phương dọc thân robot, v_y là vận tốc ngang và ω là vận tốc quay quanh trục thẳng đứng.

Khả năng tạo đồng thời vận tốc tịnh tiến và vận tốc góc giúp nền tảng đa hướng có tính linh hoạt cao hơn nhiều so với robot bánh xe thông thường. Các nghiên cứu về robot đa hướng cũng chỉ ra rằng khả năng quay và tịnh tiến tương đối độc lập là một trong những ưu điểm chính của cấu trúc này trong bài toán điều khiển chuyển động. MDPI (https://www.mdpi.com/2076-3417/8/2/231?utm_source=chatgpt.com)

Đặc điểm trên đặc biệt có ý nghĩa trong môi trường nhà máy hoặc kho hàng, nơi robot thường phải làm việc trong không gian giới hạn, cần tiếp cận vị trí từ nhiều hướng khác nhau và thực hiện các thao tác định vị chính xác.

## 1.2. Cấu tạo và nguyên lý chuyển động của robot Mecanum

### 1.2.1. Cấu tạo bánh Mecanum

Bánh Mecanum gồm một bánh chính và nhiều con lăn thụ động được bố trí xung quanh vành bánh. Trục của các con lăn thường nghiêng một góc nhất định so với mặt phẳng quay của bánh. Nhờ cách bố trí này, lực tương tác giữa bánh và mặt sàn có thể được phân tích thành các thành phần theo nhiều phương khác nhau.

Khi bốn bánh Mecanum được bố trí phù hợp trên một khung xe, sự phối hợp giữa chiều quay và tốc độ của từng bánh cho phép tạo ra lực tổng hợp theo phương mong muốn.

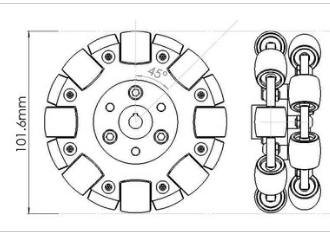
[picture p55: figure]
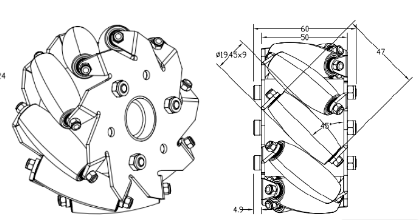
[picture p56: figure]

Hình 1.1 Cấu tạo bánh Mecanum và hướng bố trí con lăn

Trong mô hình lý tưởng, mỗi bánh được xem là có khả năng tạo một thành phần vận tốc dọc theo phương quay của bánh đồng thời cho phép chuyển động tương đối theo hướng của con lăn.

Các nghiên cứu về mô hình robot Mecanum thường xây dựng quan hệ giữa tốc độ góc của các bánh với vận tốc dọc, vận tốc ngang và vận tốc quay của thân robot thông qua ma trận Jacobian. ijtech.eng.ui.ac.id (https://ijtech.eng.ui.ac.id/article/view/6908?utm_source=chatgpt.com)

### 1.2.2. Nguyên lý chuyển động của robot Mecanum

Đối với robot bốn bánh Mecanum, việc thay đổi chiều quay của các bánh tạo ra các dạng chuyển động khác nhau.

Khi bốn bánh tạo các thành phần lực tổng hợp theo cùng phương dọc thân xe, robot chuyển động tiến hoặc lùi. Khi các thành phần lực dọc triệt tiêu nhưng các thành phần ngang cùng chiều, robot có thể dịch chuyển sang trái hoặc phải. Khi mô-men do các bánh tạo ra cùng chiều quay quanh tâm robot, robot có thể quay tại chỗ. Ngoài ra, việc phối hợp không đối xứng tốc độ các bánh cho phép robot vừa tịnh tiến vừa quay hoặc chuyển động theo phương chéo.

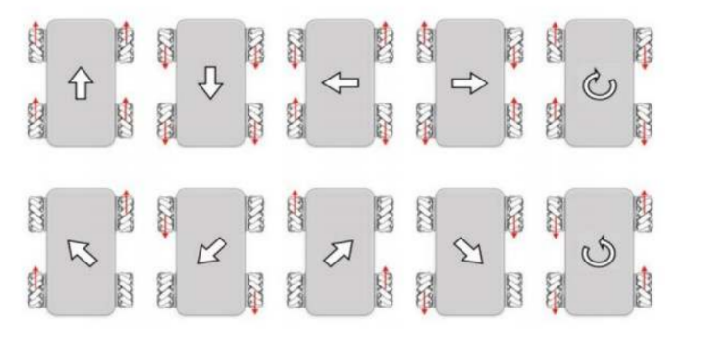
[picture p57: figure]

Hình 1.2 Các chế độ chuyển động cơ bản của robot Mecanum: tiến, lùi, ngang, chéo và quay

Khả năng này giúp robot Mecanum thích hợp cho các nhiệm vụ yêu cầu định vị linh hoạt và thay đổi hướng chuyển động thường xuyên.

Tuy nhiên, cấu trúc con lăn cũng làm cho robot Mecanum nhạy hơn với ma sát, trượt bánh, sai lệch tải và điều kiện tiếp xúc bánh – sàn. Các nghiên cứu gần đây cho thấy mô hình tiếp xúc đơn giản có thể không phản ánh đầy đủ hiện tượng trượt thực tế của bánh Mecanum, đặc biệt khi yêu cầu độ chính xác bám quỹ đạo cao. ScienceDirect (https://www.sciencedirect.com/science/article/pii/S0921889026004161?utm_source=chatgpt.com)

## 1.3. Ứng dụng của robot Mecanum

Nhờ khả năng di chuyển đa hướng, robot Mecanum có tiềm năng ứng dụng trong nhiều hệ thống tự động hóa.

Trong lĩnh vực logistics và kho vận, robot có thể thực hiện nhiệm vụ vận chuyển hàng hóa giữa các vị trí trong kho, tiếp cận giá kệ từ nhiều hướng và hoạt động trong lối đi có chiều rộng hạn chế.

Trong các nhà máy sản xuất, robot Mecanum có thể được sử dụng như một nền tảng AGV hoặc AMR để vận chuyển chi tiết, vật tư hoặc thành phẩm giữa các trạm sản xuất.

Đối với robot dịch vụ, khả năng dịch ngang và quay tại chỗ giúp robot dễ dàng thao tác trong không gian trong nhà, bệnh viện, phòng thí nghiệm hoặc khu vực đông vật cản.

Ngoài các ứng dụng thực tiễn, robot Mecanum còn là một đối tượng nghiên cứu phù hợp cho các bài toán định vị, lập kế hoạch chuyển động, bám quỹ đạo và điều khiển phi tuyến do hệ thống có tính cơ động cao nhưng chịu ảnh hưởng đáng kể của động lực học và hiện tượng trượt.

## 1.4. Tổng quan các phương pháp điều khiển robot Mecanum

### 1.4.1. Điều khiển dựa trên mô hình động học

Một trong những cách tiếp cận đơn giản nhất đối với robot Mecanum là xây dựng bộ điều khiển từ mô hình động học.

Trong cách tiếp cận này, tín hiệu điều khiển được xác định dựa trên quan hệ giữa:

q và:

ν=[v_x , v_y , ω]^T ⁢. Sau đó, vận tốc mong muốn của robot được chuyển đổi thành tốc độ của từng bánh thông qua mô hình động học nghịch.

Một nghiên cứu năm 2024 đã trình bày phương pháp điều khiển robot Mecanum bốn bánh dựa hoàn toàn trên mô hình động học, trong đó mô hình động lực học được xem như một “hộp đen”; cấu trúc điều khiển gồm tầng vị trí và tầng điều khiển vận tốc bánh. IET (https://ietresearch.onlinelibrary.wiley.com/doi/10.1049/tje2.70006?utm_source=chatgpt.com)

Ưu điểm của điều khiển động học là cấu trúc đơn giản và yêu cầu tính toán thấp. Tuy nhiên, mô hình này không trực tiếp mô tả ảnh hưởng của khối lượng, quán tính, ma sát và lực nhiễu lên chuyển động của robot.

Vì vậy, trong các trường hợp tốc độ thấp và tải trọng ít biến đổi, mô hình động học có thể đạt kết quả phù hợp. Khi robot hoạt động dưới tác động của tải thay đổi hoặc nhiễu ngoài, việc bổ sung thông tin động lực học có thể trở nên cần thiết.

### 1.4.2. Điều khiển PID

PID là một trong những phương pháp điều khiển phản hồi được sử dụng phổ biến trong các hệ thống kỹ thuật.

Luật điều khiển tổng quát được biểu diễn:

u(t)=K_p ⁢e(t)+K_i ∫_0^t e(τ)d⁢τ+K_d ⁢e(t) trong đó:

- K_p là hệ số tỷ lệ;
- K_i là hệ số tích phân;
- K_d là hệ số vi phân;
- e(t) là sai số điều khiển.

Thành phần tỷ lệ giúp hệ thống phản ứng với sai số hiện tại, thành phần tích phân có tác dụng giảm sai số xác lập, trong khi thành phần vi phân hỗ trợ cải thiện đặc tính quá độ.

PID có ưu điểm là cấu trúc dễ hiểu, dễ triển khai và không đòi hỏi mô hình động lực học chính xác của đối tượng. Do đó PID thường được sử dụng như một bộ điều khiển cơ sở hoặc bộ điều khiển đối chứng khi đánh giá các thuật toán mới.

Tuy nhiên, hiệu quả của PID phụ thuộc đáng kể vào việc lựa chọn các hệ số K_p ,K_i ,K_d . Khi đặc tính đối tượng thay đổi mạnh hoặc xuất hiện nhiễu lớn, một bộ thông số cố định có thể không còn bảo đảm chất lượng điều khiển như ở điều kiện danh định.

Trong đề tài này, PID được sử dụng như một phương pháp đối chứng và được hiệu chỉnh trước khi thực hiện các phép so sánh nhằm hạn chế việc tạo ra một bộ PID quá yếu so với phương pháp MBC.

### 1.4.3. Điều khiển dựa trên mô hình động lực học

Khác với điều khiển chỉ dựa trên sai số hoặc mô hình động học, phương pháp điều khiển dựa trên mô hình khai thác trực tiếp phương trình động lực học của robot.

Một dạng tổng quát của mô hình được sử dụng trong đề tài là:

M⁢ν+C(ν)ν+D⁢ν=τ trong đó M chứa các tham số về khối lượng và mô-men quán tính, C biểu diễn ảnh hưởng liên quan tới chuyển động quay, D mô tả lực cản và τ là tác động điều khiển tổng quát.

Khi mô hình động lực học đã biết, tín hiệu điều khiển có thể được thiết kế nhằm bù trực tiếp các thành phần động lực học của hệ. Đây là tư tưởng cơ bản của phương pháp Model-Based Control và Computed Torque Control.

Các nghiên cứu về robot Mecanum đã sử dụng đồng thời mô hình động học và động lực học để thiết kế bộ điều khiển bám quỹ đạo. Chẳng hạn, Alwan và cộng sự xây dựng mô hình động học – động lực học cho robot bốn bánh Mecanum và sử dụng cấu trúc điều khiển kết hợp để giải quyết bài toán bám quỹ đạo. ijtech.eng.ui.ac.id (https://ijtech.eng.ui.ac.id/article/view/6908?utm_source=chatgpt.com)

Các hướng nghiên cứu gần đây cũng tiếp tục khai thác mô hình động lực học kết hợp với MPC, bộ quan sát nhiễu hoặc các kỹ thuật điều khiển phi tuyến nhằm cải thiện chất lượng bám khi tồn tại bất định và nhiễu ngoài. ScienceDirect (https://www.sciencedirect.com/science/article/abs/pii/S0019057824002672?utm_source=chatgpt.com)

Điều này cho thấy mô hình động lực học đóng vai trò quan trọng khi yêu cầu điều khiển không chỉ giới hạn ở việc xác định quan hệ hình học giữa vận tốc robot và tốc độ bánh.

### 1.4.4. Một số phương pháp điều khiển nâng cao

Ngoài PID và điều khiển dựa trên mô hình, nhiều thuật toán điều khiển nâng cao đã được nghiên cứu cho robot di động đa hướng.

Điều khiển dự báo mô hình sử dụng mô hình hệ thống để dự đoán trạng thái trong một khoảng thời gian tương lai và giải một bài toán tối ưu nhằm xác định tín hiệu điều khiển. MPC có khả năng đưa các giới hạn trạng thái và điều khiển trực tiếp vào quá trình thiết kế, nhưng yêu cầu khối lượng tính toán cao hơn. Nghiên cứu trên robot đa hướng đã cho thấy MPC có thể được sử dụng hiệu quả cho bài toán ổn định vị trí và bám quỹ đạo. MDPI (https://www.mdpi.com/2076-3417/8/2/231?utm_source=chatgpt.com)

Điều khiển trượt có khả năng chống lại một số dạng nhiễu và bất định mô hình. Tuy nhiên, dạng SMC truyền thống có thể xuất hiện hiện tượng chattering. Nhiều nghiên cứu do đó tập trung vào terminal sliding mode, high-order sliding mode hoặc kết hợp bộ quan sát để cải thiện chất lượng đáp ứng. ScienceDirect (https://www.sciencedirect.com/science/article/pii/S004579062100450X?utm_source=chatgpt.com)

Những phương pháp trên có tiềm năng lớn nhưng cũng làm tăng độ phức tạp trong thiết kế và triển khai. Vì vậy, đề tài hiện tại tập trung vào một hướng trung gian: sử dụng mô hình động lực học để xây dựng MBC/CTC, sau đó so sánh với PID nhằm làm rõ lợi ích của việc đưa thông tin động lực học vào luật điều khiển.

## 1.5. Tình hình nghiên cứu trong và ngoài nước

### 1.5.1. Một số nghiên cứu trên thế giới

Các nghiên cứu về robot Mecanum đã phát triển từ mô hình động học đơn giản đến các mô hình có xét động lực học, tiếp xúc bánh – sàn, nhiễu và bất định tham số.

Nghiên cứu của Alwan và cộng sự năm 2024 xây dựng cả mô hình động học và động lực học của robot Mecanum bốn bánh để phục vụ bài toán bám quỹ đạo. Công trình cho thấy việc kết hợp hai tầng mô hình là một hướng tiếp cận quan trọng khi thiết kế hệ thống điều khiển robot đa hướng. ijtech.eng.ui.ac.id (https://ijtech.eng.ui.ac.id/article/view/6908?utm_source=chatgpt.com)

Một hướng nghiên cứu khác tập trung vào điều khiển bền vững trước nhiễu. Công trình về Adaptive Integral Terminal Sliding Mode đã xây dựng mô hình bốn đầu vào – ba đầu ra cho robot Mecanum, đồng thời sử dụng lý thuyết Lyapunov để phân tích ổn định của hệ điều khiển. ScienceDirect (https://www.sciencedirect.com/science/article/pii/S004579062100450X?utm_source=chatgpt.com)

Các nghiên cứu MPC cũng chú trọng đến các ràng buộc động học và động lực học của robot. Wang và cộng sự đề xuất cấu trúc MPC kết hợp bộ quan sát trượt nhằm xử lý nhiễu ngoài và bất định mô hình trong bài toán bám quỹ đạo robot Mecanum. ScienceDirect (https://www.sciencedirect.com/science/article/abs/pii/S0019057824002672?utm_source=chatgpt.com)

Một vấn đề ngày càng được quan tâm là mức độ chính xác của mô hình tiếp xúc bánh – mặt sàn. Nghiên cứu về lực tiếp xúc biến thiên cho thấy giả thiết một điểm tiếp xúc đơn giản có thể chưa phản ánh đầy đủ chuyển động thực của bánh Mecanum, đặc biệt khi hiện tượng trượt ảnh hưởng đáng kể tới sai số bám. ScienceDirect (https://www.sciencedirect.com/science/article/pii/S0921889026004161?utm_source=chatgpt.com)

Nhìn chung, xu hướng nghiên cứu quốc tế đang chuyển từ việc chỉ mô tả quan hệ động học sang các mô hình có xét sâu hơn tới động lực học, bất định, nhiễu và điều kiện tiếp xúc.

### 1.5.2. Một số hướng nghiên cứu tại Việt Nam

Tại Việt Nam, robot di động và bài toán bám quỹ đạo cũng đang nhận được sự quan tâm ngày càng lớn.

Một số nghiên cứu tập trung vào điều khiển phi tuyến và chống nhiễu. Công trình về Terminal Sliding Mode Control cho robot bốn bánh Mecanum đã nghiên cứu khả năng hội tụ trong thời gian hữu hạn và giảm ảnh hưởng của hiện tượng chattering. VJOL (https://vjol.info.vn/dhcnhn/vi/article/view/123704/?utm_source=chatgpt.com)

Một nghiên cứu khác đề xuất điều khiển trượt bậc cao kết hợp bộ quan sát thành phần bất định cho robot Mecanum nhằm cải thiện khả năng bám quỹ đạo khi mô hình chịu ảnh hưởng của nhiễu và phi tuyến. VJOL (https://www.vjol.info.vn/truongdhkinhtekythuatcongnghiep/vi/article/view/160395/)

Các hướng sử dụng mạng nơ-ron để bù bất định và nhiễu cũng đã được nghiên cứu cho robot di động, cho thấy xu hướng kết hợp giữa mô hình điều khiển truyền thống và các thuật toán thích nghi hoặc học máy để tăng tính bền vững của hệ thống. VJOL (https://vjol.info.vn/dhcnhn/vi/article/view/104931/?utm_source=chatgpt.com)

Ngoài ra, một công trình của nhóm tác giả Việt Nam công bố năm 2026 đã nghiên cứu bộ điều khiển tối ưu ngược cho robot Mecanum dựa trên mô hình động học và động lực học, đồng thời khai thác hàm Lyapunov điều khiển và tính thụ động để phục vụ bài toán bám quỹ đạo. DOI (https://doi.org/10.1007/978-3-032-15836-9_46?utm_source=chatgpt.com)

Các kết quả trên cho thấy nghiên cứu về bám quỹ đạo robot Mecanum tại Việt Nam đã có sự phát triển theo hướng điều khiển phi tuyến, thích nghi và bền vững.

## 1.6. Khoảng trống nghiên cứu và hướng tiếp cận của đề tài

Từ quá trình khảo sát tài liệu có thể nhận thấy bài toán bám quỹ đạo robot Mecanum đã được nghiên cứu bằng nhiều phương pháp khác nhau, từ PID, điều khiển động học cho tới MPC, điều khiển trượt, điều khiển thích nghi và các phương pháp dựa trên mô hình.

Các thuật toán hiện đại có thể mang lại hiệu quả cao, tuy nhiên việc gia tăng độ phức tạp cũng làm cho quá trình thiết kế, hiệu chỉnh và triển khai trở nên khó khăn hơn. Trong khi đó, đối với một nghiên cứu tập trung làm rõ vai trò của mô hình động lực học, cần có một cấu trúc đủ đơn giản để phân tích nhưng vẫn phản ánh được ảnh hưởng của khối lượng, quán tính, ma sát và nhiễu.

Vì vậy, đề tài lựa chọn phương pháp điều khiển dựa trên mô hình động lực học , được xây dựng theo nguyên lý bù động lực học của phương pháp Computed Torque Control (CTC), làm phương pháp nghiên cứu chính; đồng thời sử dụng bộ điều khiển PID đã được hiệu chỉnh làm phương pháp đối chứng.

Điểm trọng tâm của đề tài không phải đề xuất một thuật toán hoàn toàn mới mà là: xây dựng và đánh giá một cách có hệ thống ảnh hưởng của việc sử dụng mô hình động lực học đối với bài toán bám quỹ đạo robot Mecanum.

Việc đánh giá được thực hiện trong ba điều kiện:

1. Điều kiện danh định, trong đó mô hình điều khiển và đối tượng sử dụng cùng bộ tham số.
2. Điều kiện sai lệch tải trọng, trong đó robot thực trong mô phỏng có khối lượng và mô-men quán tính khác với mô hình mà bộ điều khiển sử dụng.
3. Điều kiện nhiễu ngoại lực, trong đó robot chịu thêm lực và mô-men tác động trong một khoảng thời gian xác định.

Qua đó, đề tài không chỉ đánh giá sai số trong điều kiện lý tưởng mà còn xem xét khả năng duy trì chất lượng bám khi điều kiện vận hành thay đổi.

## 1.7. Bài toán bám quỹ đạo robot Mecanum

### 1.7.1. Phân biệt đường đi và quỹ đạo

Trong bài toán điều khiển robot, cần phân biệt giữa đường đi và quỹ đạo.

Đường đi chỉ mô tả tập hợp các vị trí hình học mà robot cần đi qua, không yêu cầu robot phải có mặt tại một vị trí cụ thể ở một thời điểm xác định.

Ngược lại, quỹ đạo bao gồm cả thông tin không gian và thời gian. Quỹ đạo mong muốn có thể biểu diễn:

q_d (t)=[x_d (t)y_d (t)θ_d (t)]⁢. Do đó, bài toán bám quỹ đạo yêu cầu robot không chỉ đi đúng hình dạng đường đi mà còn phải bám trạng thái mong muốn theo thời gian.

### 1.7.2. Định nghĩa sai số bám

Vector trạng thái thực của robot:

q(t)=[x(t)y(t)θ(t)] và trạng thái mong muốn:

q_d (t)=[x_d (t)y_d (t)θ_d (t)]⁢. Sai số được xác định:

e(t)=q_d (t)-q(t) hay:

e(t)=[e_x e_y e_θ ]⁢. Trong đó:

e_x =x_d -x,

e_y =y_d -y,

e_θ =θ_d -θ⁢. Do góc có tính tuần hoàn, sai số góc trong mô phỏng được chuẩn hóa về miền:

-π≤e_θ ≤π⁢.

### 1.7.3. Sai số vị trí tổng hợp

Để đánh giá độ lệch không gian của robot so với quỹ đạo mong muốn, sai số vị trí được xác định:

e_p (t)=√(e_x^2 (t)+e_y^2 (t))⁢. Giá trị e_p càng nhỏ thể hiện robot càng gần vị trí mong muốn.

### 1.7.4. Chỉ số RMSE

Để đánh giá sai số trong toàn bộ quá trình mô phỏng, đề tài sử dụng chỉ số Root Mean Square Error:

R⁢M⁢S⁢E_p =√(1/N∑_(k=1)^N e_p^2 (k))⁢. Đối với góc định hướng:

R⁢M⁢S⁢E_θ =√(1/N∑_(k=1)^N e_θ^2 (k))⁢. RMSE được sử dụng làm một trong những tiêu chí chính để so sánh MBC/CTC và PID.

Ngoài RMSE toàn quá trình, đề tài còn xem xét RMSE sau giai đoạn quá độ và RMSE riêng trong khoảng thời gian nhiễu tác động nhằm đánh giá chi tiết hơn đặc tính của hệ điều khiển.

### 1.7.5. Yêu cầu đối với quỹ đạo thử nghiệm

Quỹ đạo sử dụng trong mô phỏng cần bảo đảm liên tục về vị trí và có đạo hàm vận tốc, gia tốc phù hợp với luật điều khiển.

Trong giai đoạn khảo sát chính, đề tài lựa chọn quỹ đạo tròn:

x_d (t)=R⁢cos(ω_r ⁢t)

y_d (t)=R⁢sin(ω_r ⁢t) và góc định hướng:

θ_d (t)=ω_r ⁢t+π/2⁢. Quỹ đạo tròn cho phép robot phải đồng thời điều khiển chuyển động theo hai phương x,y và góc định hướng, do đó phù hợp cho việc đánh giá bước đầu khả năng bám quỹ đạo của hệ thống.

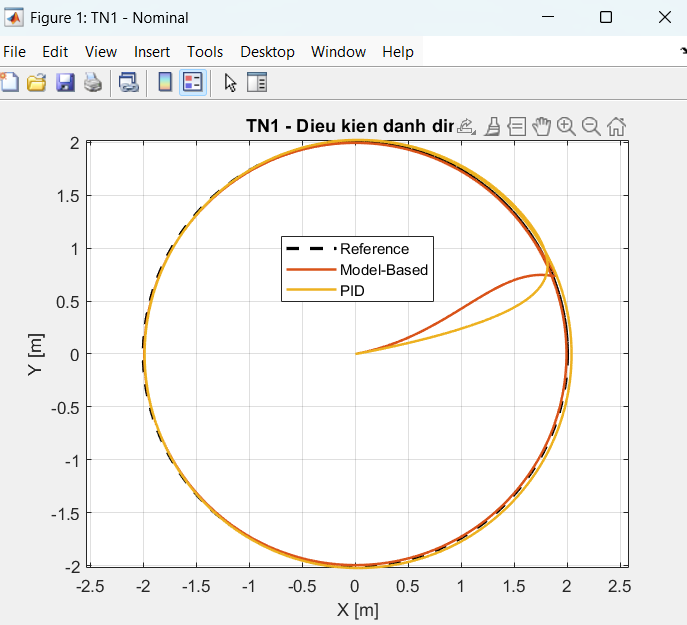
[picture p58: figure]

Hình 1.3 Minh họa quỹ đạo tham chiếu và quỹ đạo thực của robot Mecanum

## 1.8. Kết luận

Chương 1 đã trình bày tổng quan về robot di động bánh xe, trong đó tập trung vào cấu hình robot bốn bánh Mecanum. Nhờ cấu tạo đặc biệt của bánh xe, robot Mecanum có khả năng thực hiện các chuyển động đa hướng, mang lại ưu thế trong những môi trường yêu cầu tính cơ động cao.

Tuy nhiên, cấu trúc đa hướng cùng các yếu tố như khối lượng, quán tính, ma sát và nhiễu ngoài đặt ra yêu cầu cao đối với hệ thống điều khiển bám quỹ đạo. Các phương pháp điều khiển hiện có trải rộng từ điều khiển động học, PID đến các phương pháp dựa trên mô hình, MPC, điều khiển trượt và điều khiển thích nghi. Các công trình gần đây cho thấy xu hướng ngày càng chú trọng đến động lực học, bất định mô hình và khả năng chống nhiễu của robot Mecanum. ijtech.eng.ui.ac.id (https://ijtech.eng.ui.ac.id/article/view/6908?utm_source=chatgpt.com)

Trên cơ sở đó, đề tài lựa chọn phương pháp điều khiển dựa trên mô hình động lực học theo nguyên lý Computed Torque Control và sử dụng PID làm phương pháp đối chứng. Chất lượng của hai bộ điều khiển được đánh giá trong các điều kiện danh định, sai lệch tải trọng và tác động nhiễu ngoài.

Để xây dựng được luật điều khiển dựa trên mô hình, cần thiết lập đầy đủ quan hệ giữa trạng thái của thân robot, tốc độ các bánh và lực tác động lên hệ thống. Vì vậy, Chương 2 sẽ xây dựng mô hình động học và mô hình động lực học của robot Mecanum bốn bánh, làm cơ sở cho quá trình thiết kế thuật toán điều khiển ở Chương 3.

# CHƯƠNG 2. MÔ HÌNH HÓA TOÁN HỌC ROBOT MECANUM 4 BÁNH

## 2.1. Thiết lập hệ tọa độ và biến trạng thái

Để mô tả chuyển động của robot Mecanum trên mặt phẳng, cần thiết lập hai hệ tọa độ gồm hệ tọa độ toàn cục và hệ tọa độ gắn với thân robot. Việc sử dụng đồng thời hai hệ tọa độ cho phép mô tả vị trí của robot trong môi trường cũng như biểu diễn thuận tiện các vận tốc và lực tác động lên thân robot.

### 2.1.1. Hệ tọa độ toàn cục và hệ tọa độ thân robot

Xét robot Mecanum bốn bánh chuyển động trên mặt phẳng O⁢X⁢Y . Hai hệ tọa độ được định nghĩa như sau:

- Hệ tọa độ toàn cục:

Σ_I ={O_I , X_I , Y_I } được cố định trong môi trường và được sử dụng để xác định vị trí tuyệt đối của robot.

- Hệ tọa độ thân robot:

Σ_B ={O_B , X_B , Y_B } có gốc O_B đặt tại tâm hình học của robot và quay cùng robot.

Góc giữa trục X_B của hệ tọa độ thân robot và trục X_I của hệ tọa độ toàn cục được ký hiệu là θ.

Do robot chuyển động trên mặt phẳng nên cấu hình của robot được biểu diễn bằng vector:

| q=[xyθ] | (2.1)

trong đó:

- x: tọa độ của tâm robot theo phương X_I ;
- y: tọa độ của tâm robot theo phương Y_I ;
- θ : góc định hướng của robot.

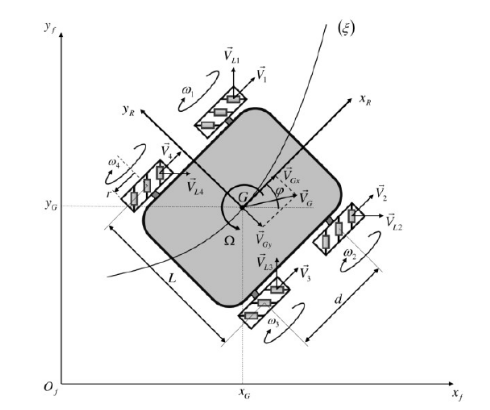
[picture p59: figure]

Hình 2.1 Hệ tọa độ toàn cục và hệ tọa độ gắn với robot Mecanum

### 2.1.2. Vector vận tốc của robot

Trong hệ tọa độ gắn với thân xe, vector vận tốc của robot được biểu diễn:

| ν=[v_x v_y ω] | (2.2)

trong đó:

- v_x là vận tốc tịnh tiến theo trục X_B ;
- v_y là vận tốc tịnh tiến theo trục Y_B ;
- v_y là vận tốc góc quanh trục thẳng đứng đi qua tâm robot.

Khác với robot truyền động vi sai, cấu trúc bánh Mecanum cho phép robot tạo đồng thời cả v_x , v_y và ω . Đây là cơ sở tạo nên khả năng chuyển động đa hướng của hệ thống.

## 2.2. Ma trận chuyển đổi tọa độ

Vận tốc ν được xác định trong hệ tọa độ thân xe, trong khi vị trí robot q được biểu diễn trong hệ tọa độ toàn cục. Do đó cần xây dựng ma trận quay để chuyển đổi giữa hai hệ tọa độ.

Ma trận quay từ hệ tọa độ thân robot sang hệ tọa độ toàn cục được xác định:

R(θ)=[cosθ, -sinθ, 0sinθ, cosθ, 00, 0, 1]⁢. (2.3) Quan hệ giữa vận tốc robot trong hệ thân và đạo hàm trạng thái trong hệ toàn cục là:

q=R(θ)ν (2.4) hay:

[xyθ]=[cosθ, -sinθ, 0sinθ, cosθ, 00, 0, 1]⁢[v_x v_y ω]⁢. (2.5) Từ đó thu được:

x=v_x ⁢cosθ-v_y ⁢sinθ (2.6)

y=v_x ⁢sinθ+v_y ⁢cosθ (2.7)

θ=ω⁢. (2.8) Do R(θ) là ma trận trực giao nên:

R^(-1) (θ)=R^T (θ). (2.9) Do đó vận tốc trong hệ thân robot có thể được xác định từ vận tốc trong hệ tọa độ toàn cục:

ν=R^T (θ)q⁢. (2.10) Quan hệ này đặc biệt quan trọng trong quá trình xây dựng bộ điều khiển ở Chương 3, bởi quỹ đạo mong muốn thường được xác định trong hệ tọa độ toàn cục trong khi mô hình động lực học được xây dựng trong hệ tọa độ gắn với thân robot.

## 2.3. Mô hình động học robot Mecanum

### 2.3.1. Cấu hình hình học của robot

Robot được xét gồm bốn bánh Mecanum có cùng bán kính r . Các bánh được bố trí đối xứng quanh tâm robot.

Ký hiệu:

L là khoảng cách từ tâm robot đến trục bánh theo phương dọc và:

W là khoảng cách theo phương ngang.

Đặt:

a=L+W⁢. (2.11) Tốc độ góc của bốn bánh lần lượt được ký hiệu:

ω_1 , ω_2 , ω_3 , ω_4 ⁢. Trong mô hình của đề tài, thứ tự các bánh được quy ước thống nhất với chương trình MATLAB.

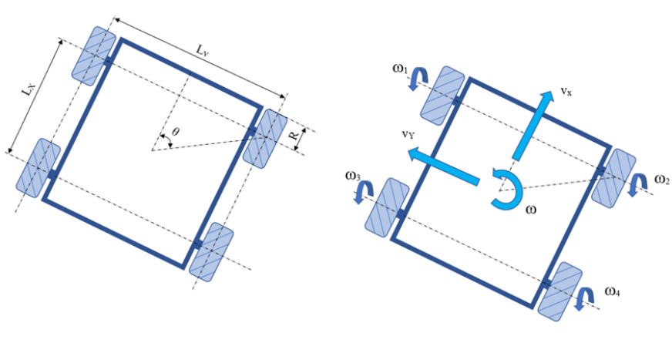
[picture p60: figure]

Hình 2.2 Sơ đồ bố trí bốn bánh Mecanum

### 2.3.2. Động học nghịch robot Mecanum

Bài toán động học nghịch xác định tốc độ góc cần thiết của từng bánh khi biết vận tốc mong muốn của thân robot.

Với cấu hình Mecanum được sử dụng trong đề tài, quan hệ động học nghịch được biểu diễn:

[ω_1 ω_2 ω_3 ω_4 ]=1/r⁢[1, -1, -a1, 1, a1, 1, -a1, -1, a]⁢[v_x v_y ω]⁢. (2.12) Hay viết dưới dạng:

ω_w =J_M ⁢ν, (2.13) với:

ω_w =[ω_1 ω_2 ω_3 ω_4 ] và:

J_M =1/r⁢[1, -1, -a1, 1, a1, 1, -a1, -1, a]⁢. (2.14) Tách riêng từng bánh:

ω_1 =1/r(v_x -v_y -a⁢ω), (2.15)

ω_2 =1/r(v_x +v_y +a⁢ω), (2.16)

ω_3 =1/r(v_x +v_y -a⁢ω), (2.17)

ω_4 =1/r(v_x -v_y +a⁢ω). (2.18) Đây chính là quan hệ được sử dụng trong hàm mecanum_kinematics.m của chương trình mô phỏng.

### 2.3.3. Động học thuận robot Mecanum

Bài toán động học thuận thực hiện quá trình ngược lại: từ tốc độ bốn bánh xác định vận tốc của thân robot.

Do ma trận J_M có kích thước 4×3 , không thể sử dụng phép nghịch đảo thông thường. Do đó có thể sử dụng nghịch đảo giả Moore–Penrose.

Ta có:

ν=J_M^(†) ⁢ω_w ⁢. (2.19) Với cấu hình đối xứng đang xét:

[v_x v_y ω]=r/4⁢[1, 1, 1, 1-1, 1, 1, -1-1/a, 1/a, -1/a, 1/a]⁢[ω_1 ω_2 ω_3 ω_4 ]⁢. (2.20) Do đó:

v_x =r/4(ω_1 +ω_2 +ω_3 +ω_4 ), (2.21)

v_y =r/4(-ω_1 +ω_2 +ω_3 -ω_4 ), (2.22) và:

ω=r/(4a)(-ω_1 +ω_2 -ω_3 +ω_4 ). (2.23) Các phương trình trên cho thấy chuyển động của thân robot là kết quả của sự phối hợp tốc độ giữa bốn bánh.

### 2.3.4. Ý nghĩa vật lý của mô hình động học

Từ các phương trình động học có thể phân tích một số chế độ chuyển động đặc trưng.

Khi:

ω_1 =ω_2 =ω_3 =ω_4 thì:

v_y =0, ω=0, robot thực hiện chuyển động tịnh tiến theo phương dọc.

Khi các bánh được điều khiển theo tổ hợp thích hợp để:

v_x =0, ω=0, v_y ≠0, robot thực hiện chuyển động ngang.

Khi:

v_x =0, v_y =0, ω≠0, robot quay quanh tâm mà không cần thay đổi vị trí tâm robot đáng kể.

Như vậy, thông qua điều khiển độc lập tốc độ bốn bánh, robot có thể tạo chuyển động ba bậc tự do trên mặt phẳng.

### 2.3.5. Giả thiết tiếp xúc bánh với mặt sàn

Để đơn giản hóa mô hình, đề tài sử dụng các giả thiết sau:

- mặt sàn được xem là bằng phẳng;
- các bánh luôn duy trì tiếp xúc với mặt sàn;
- bán kính hiệu dụng của các bánh không thay đổi;
- ảnh hưởng biến dạng của bánh và con lăn được bỏ qua;
- mô hình động học giả thiết điều kiện chuyển động lý tưởng;
- hiện tượng trượt phức tạp giữa bánh và mặt sàn không được mô hình hóa riêng.

Trong thực tế, bánh Mecanum có thể xuất hiện trượt do cấu trúc con lăn, thay đổi tải trọng hoặc hệ số ma sát của bề mặt. Tuy nhiên, việc đưa mô hình trượt đầy đủ vào hệ thống sẽ làm tăng đáng kể độ phức tạp của bài toán.

Do mục tiêu chính của đề tài là đánh giá ảnh hưởng của việc sử dụng mô hình động lực học trong bộ điều khiển, các thành phần trượt phi tuyến được xem là nằm ngoài phạm vi nghiên cứu hiện tại.

## 2.4. Xây dựng mô hình động lực học của robot

Mô hình động học cho biết mối quan hệ giữa vận tốc thân robot và tốc độ bánh xe nhưng chưa phản ánh nguyên nhân tạo ra chuyển động.

Trong thực tế, gia tốc của robot phụ thuộc vào lực tác động, khối lượng, mô-men quán tính, chuyển động quay và lực cản. Vì vậy, để xây dựng bộ điều khiển dựa trên mô hình cần thiết lập phương trình động lực học.

### 2.4.1. Các giả thiết động lực học

Trong phạm vi nghiên cứu, các giả thiết sau được sử dụng:

1. Robot được xem như một vật rắn.
2. Robot chỉ chuyển động trên mặt phẳng ngang.
3. Tâm khối lượng được giả thiết nằm gần tâm hình học của robot.
4. Chuyển động theo phương thẳng đứng được bỏ qua.
5. Ma sát được mô hình hóa bằng thành phần cản tuyến tính.
6. Động lực học điện của động cơ chưa được xét riêng.
7. Lực tác động của bốn bánh được quy đổi thành lực và mô-men tổng quát tác động lên thân robot.

Với các giả thiết trên, mô hình tập trung vào động lực học của thân robot ba bậc tự do.

### 2.4.2. Phương trình động lực học tổng quát

Mô hình động lực học được biểu diễn dưới dạng:

M⁢ν+C(ν)ν+D⁢ν=τ (2.24) trong đó:

M∈R^(3×3) là ma trận khối lượng – quán tính;

C(ν) là ma trận biểu diễn các thành phần liên quan đến chuyển động quay trong hệ tọa độ thân;

D là ma trận hệ số cản;

và:

τ=[F_x F_y M_z ] (2.25) là vector lực và mô-men tổng quát.

### 2.4.3. Ma trận khối lượng và mô-men quán tính

Đối với mô hình chuyển động phẳng, ma trận quán tính được lựa chọn:

M=[m, 0, 00, m, 00, 0, I_z ], (2.26) trong đó:

- m là khối lượng toàn bộ robot;
- I_z là mô-men quán tính của robot quanh trục thẳng đứng đi qua tâm khối lượng.

Hai phần tử đầu thể hiện quán tính đối với chuyển động tịnh tiến, trong khi I_z quyết định khả năng chống lại sự thay đổi vận tốc góc.

Khi tải trọng robot tăng, giá trị m và trong nhiều trường hợp cả I_z cũng thay đổi. Đây chính là cơ sở để xây dựng trường hợp sai lệch tải trọng trong phần mô phỏng của đề tài.

### 2.4.4. Thành phần Coriolis

Khi mô tả vận tốc trong hệ tọa độ gắn với thân robot, chuyển động quay tạo ra sự liên kết giữa hai thành phần vận tốc tịnh tiến.

Trong mô hình sử dụng của đề tài, ma trận Coriolis được biểu diễn:

C(ν)=[0, -m⁢ω, 0m⁢ω, 0, 00, 0, 0]⁢. (2.27) Do đó:

C(ν)ν=[-m⁢ω⁢v_y m⁢ω⁢v_x 0]⁢. (2.28) Thành phần này cho thấy khi robot đồng thời thực hiện chuyển động tịnh tiến và quay, động lực học theo hai phương của thân xe có sự liên kết với nhau.

### 2.4.5. Thành phần ma sát

Trong thực tế, chuyển động của robot chịu ảnh hưởng bởi ma sát của bánh xe, ổ trục, động cơ và tương tác giữa bánh với mặt sàn.

Để tránh làm mô hình quá phức tạp, đề tài sử dụng mô hình cản tuyến tính:

D=[d_x , 0, 00, d_y , 00, 0, d_θ ]⁢. (2.29) Khi đó:

D⁢ν=[d_x ⁢v_x d_y ⁢v_y d_θ ⁢ω]⁢. (2.30) Trong chương trình mô phỏng, các tham số được lựa chọn:

d_x =2, d_y =2, d_θ =0.5. Các giá trị trên được sử dụng như tham số mô phỏng nhằm thể hiện ảnh hưởng cản chuyển động và không được xem là số liệu thực nghiệm của một robot cụ thể.

Điểm này nên được nêu rõ nhằm bảo đảm tính minh bạch của nghiên cứu.

### 2.4.6. Phương trình động lực học theo từng thành phần

Thay các ma trận vào phương trình tổng quát, hệ động lực học có thể viết:

m⁢v_x -m⁢ω⁢v_y +d_x ⁢v_x =F_x , (2.31)

m⁢v_y +m⁢ω⁢v_x +d_y ⁢v_y =F_y , (2.32)

I_z ⁢ω+d_θ ⁢ω=M_z ⁢. (2.33) Từ phương trình (2.31), có thể suy ra:

v_x =(F_x +mωv_y -d_x v_x)/m⁢. (2.34) Tương tự:

v_y =(F_y -mωv_x -d_y v_y)/m, (2.35) và:

ω=(M_z -d_θ ω)/(I_z)⁢. (2.36) Các phương trình này thể hiện trực tiếp ảnh hưởng của các tham số động lực học lên gia tốc của robot.

## 2.5. Mô hình trạng thái sử dụng trong mô phỏng

Từ phương trình:

M⁢ν+C(ν)ν+D⁢ν=τ, ta suy ra:

ν=M^(-1) [τ-C(ν)ν-D⁢ν] (2.37) kết hợp với phương trình động học:

q=R(θ)ν⁢. (2.38) Như vậy mô hình trạng thái tổng thể của robot có dạng:

{q=R(θ)νν=M^(-1) [τ-C(ν)ν-D⁢ν] (2.39) Đây là mô hình được sử dụng trực tiếp trong hàm robot_dynamics.m của chương trình MATLAB.

## 2.6. Mô hình nhiễu ngoại lực

Trong trường hợp robot chịu tác động từ môi trường bên ngoài, phương trình động lực học có thể mở rộng:

M⁢ν+C(ν)ν+D⁢ν=τ+d, (2.40) trong đó:

d=[F_(dx) F_(dy) M_(dz) ] (2.41) là vector nhiễu ngoại lực.

Trong phần mô phỏng, nhiễu được lựa chọn:

d=[15-102] trong khoảng:

15≤t≤20 s⁢. Ngoài khoảng thời gian này:

d=0. Cách thiết lập trên cho phép khảo sát khả năng của bộ điều khiển trong việc đưa robot trở lại quỹ đạo khi xuất hiện một tác động bên ngoài có thời gian hữu hạn.

Cần lưu ý rằng vector nhiễu trên là trường hợp mô phỏng được lựa chọn để khảo sát đặc tính hệ điều khiển, không phải số liệu đo từ một va chạm vật lý cụ thể.

## 2.7. Mô hình sai lệch tham số tải trọng

Một vấn đề quan trọng của phương pháp điều khiển dựa trên mô hình là mô hình sử dụng trong controller có thể không hoàn toàn giống với robot thực tế.

Trong điều kiện danh định của đề tài:

m_(model) =m_(plant) =10 k⁢g và:

I_(z,model) =I_(z,plant) =0.8 k⁢g⁢.⁢m^2 ⁢. Để khảo sát ảnh hưởng của sai lệch mô hình, đối tượng trong trường hợp thứ hai được thay đổi thành:

m_(plant) =15 k⁢g,

I_(z,plant) =1.2 k⁢g⁢.⁢m^2 , trong khi bộ điều khiển MBC vẫn sử dụng mô hình danh định:

m_(model) =10 k⁢g,

I_(z,model) =0.8 k⁢g⁢.⁢m^2 ⁢. Như vậy:

M_(controller) ≠M_(plant) ⁢. Cách thiết lập này cho phép đánh giá khả năng duy trì chất lượng điều khiển khi tham số của đối tượng thực tế sai lệch so với mô hình được sử dụng trong quá trình thiết kế controller.

## 2.8. Quan hệ giữa mô hình toán và chương trình MATLAB

Để bảo đảm sự thống nhất giữa mô hình lý thuyết và mô phỏng, các thành phần toán học được triển khai tương ứng trong chương trình MATLAB.

Bảng 2.1. Mối liên hệ giữa các thành phần mô hình và chương trình MATLAB

Thành phần | Biểu thức | File MATLAB
Thông số robot | m,I_z ,r,L,W,D | parameters.m
Quỹ đạo đặt | q_d ,q_d ,q_d | Trajectory.m
Mô hình động học bánh | ω_w =J_M ⁢ν | mecanum_kinematics.m
Động lực học | M⁢ν+C⁢ν+D⁢ν=τ | robot_dynamics.m
MBC/CTC | τ=M⁢ν_c +C⁢ν+D⁢ν | controller_MBC.m
PID | K_p ⁢e+K_i ∫ e d⁢t+K_d ⁢e | controller_PID.m
Các trường hợp thử nghiệm | danh định, tải, nhiễu | simulate_case.m
Tổng hợp kết quả | RMSE, đồ thị | main.m

Việc tổ chức chương trình theo từng khối chức năng giúp mô hình có cấu trúc rõ ràng, thuận tiện cho việc thay đổi tham số, so sánh thuật toán và mở rộng các nghiên cứu tiếp theo.

## 2.9. Kết luận

Chương 2 đã xây dựng mô hình toán của robot Mecanum bốn bánh phục vụ cho bài toán điều khiển bám quỹ đạo. Trước hết, hệ tọa độ toàn cục và hệ tọa độ gắn với thân robot được thiết lập nhằm biểu diễn trạng thái vị trí và vận tốc của robot. Quan hệ giữa hai hệ tọa độ được mô tả thông qua ma trận quay R(θ).

Tiếp theo, mô hình động học của robot được xây dựng, từ đó thiết lập quan hệ giữa vận tốc thân robot (v_x , v_y , ω) và tốc độ góc của bốn bánh Mecanum. Mô hình này làm cơ sở để chuyển đổi tín hiệu chuyển động của thân robot thành tốc độ bánh trong quá trình mô phỏng.

Để phản ánh ảnh hưởng của đặc tính cơ học lên chuyển động, mô hình động lực học rút gọn ba bậc tự do được xây dựng dưới dạng:

M⁢ν+C(ν)ν+D⁢ν=τ⁢. Mô hình đồng thời được mở rộng để xét ảnh hưởng của nhiễu ngoại lực và sai lệch tham số tải trọng. Đây là hai yếu tố được sử dụng trong các trường hợp mô phỏng nhằm đánh giá độ nhạy và khả năng duy trì chất lượng bám quỹ đạo của hệ thống điều khiển.

Từ mô hình động học và động lực học đã thiết lập, Chương 3 sẽ xây dựng luật điều khiển dựa trên mô hình động lực học theo nguyên lý Computed Torque Control, đồng thời thiết kế bộ điều khiển PID đối chứng và phân tích đặc điểm của hai phương pháp.

# CHƯƠNG 3. THIẾT KẾ BỘ ĐIỀU KHIỂN BÁM QUỸ ĐẠO CHO ROBOT MECANUM

## 3.1. Phát biểu bài toán điều khiển

Trên cơ sở mô hình động học và động lực học đã xây dựng ở Chương 2, nội dung của chương này tập trung thiết kế các bộ điều khiển nhằm bảo đảm robot Mecanum bám theo quỹ đạo tham chiếu với sai số nhỏ. Bài toán điều khiển được đặt ra là xác định lực và mô-men điều khiển phù hợp để trạng thái thực của robot tiến gần trạng thái mong muốn trong suốt quá trình chuyển động.

Trong bài toán bám quỹ đạo, robot không chỉ cần đi qua đúng các điểm hình học trên mặt phẳng mà còn phải đạt được vị trí và hướng chuyển động mong muốn tại từng thời điểm. Vì vậy, quỹ đạo tham chiếu được mô tả thông qua ba đại lượng gồm tọa độ theo phương x , tọa độ theo phương x và góc định hướng θ .

Trạng thái thực tế của robot được biểu diễn bởi:

q=[x, y, θ]^T , trong khi trạng thái mong muốn được ký hiệu là:

q_d =[x_d , y_d , θ_d ]^T ⁢. Sai số bám được xác định từ độ lệch giữa trạng thái mong muốn và trạng thái thực của robot. Trong đó, sai số vị trí theo hai phương x và y cho biết mức độ lệch khỏi quỹ đạo, còn sai số góc phản ánh khả năng duy trì hướng chuyển động mong muốn.

Đối với góc quay, do góc có tính chu kỳ nên sai số cần được chuẩn hóa về khoảng từ -π đến π . Việc này giúp tránh trường hợp hai góc thực tế rất gần nhau nhưng phép trừ trực tiếp lại cho ra một sai số lớn do vượt qua biên 2⁢π .

e(t)=q_d (t)-q(t).

Mục tiêu của bộ điều khiển là làm cho các sai số vị trí và góc giảm dần về giá trị nhỏ nhất có thể trong quá trình robot chuyển động. Trong điều kiện lý tưởng, mong muốn đạt được:

limt→∞e(t)=0. Tuy nhiên, trong thực tế và trong mô phỏng số, hệ thống luôn chịu ảnh hưởng của giới hạn cơ cấu chấp hành, sai lệch tham số và nhiễu. Vì vậy, nghiên cứu không chỉ đánh giá khả năng hội tụ của sai số mà còn sử dụng các chỉ tiêu định lượng như RMSE để so sánh chất lượng giữa các phương pháp điều khiển.

## 3.2. Thiết kế bộ điều khiển dựa trên mô hình động lực học

### 3.2.1. Cơ sở lựa chọn phương pháp điều khiển

Đối với robot Mecanum, nếu chỉ sử dụng quan hệ động học để xác định vận tốc bánh xe thì ảnh hưởng của khối lượng, mô-men quán tính và lực cản chưa được phản ánh trực tiếp trong thuật toán điều khiển. Điều này có thể chấp nhận được trong các bài toán tốc độ thấp hoặc khi các tham số của robot ít thay đổi. Tuy nhiên, khi tải trọng tăng hoặc robot chịu tác động của lực bên ngoài, đáp ứng thực tế có thể khác đáng kể so với giá trị mong muốn.

Vì vậy, đề tài lựa chọn phương pháp điều khiển dựa trên mô hình động lực học. Ý tưởng chính của phương pháp này là sử dụng chính mô hình toán của robot để tính toán lực và mô-men cần thiết, thay vì chỉ tạo tín hiệu điều khiển dựa trên sai số.

Mô hình động lực học của robot đã được xây dựng ở Chương 2 dưới dạng:

M⁢ν+C(ν)ν+D⁢ν=τ⁢. Trong biểu thức trên, ma trận M phản ánh ảnh hưởng của khối lượng và mô-men quán tính; C(ν) mô tả sự liên kết giữa chuyển động tịnh tiến và quay; còn D đại diện cho thành phần cản chuyển động.

Từ mô hình này có thể nhận thấy rằng để tạo ra một gia tốc mong muốn cho robot, bộ điều khiển cần tạo lực đủ lớn để thắng được không chỉ quán tính mà còn các thành phần Coriolis và lực cản.

Đây là cơ sở của phương pháp Computed Torque Control.

### 3.2.2. Nguyên lý bù động lực học

Ý tưởng của bộ điều khiển được xây dựng trong đề tài là sử dụng mô hình động lực học để bù các thành phần vốn có của robot.

Tín hiệu điều khiển được xác định theo cấu trúc:

τ=M⁢ν_c +C(ν)ν+D⁢ν⁢. Trong đó ν_c là gia tốc mà bộ điều khiển mong muốn robot đạt được.

Ý nghĩa của biểu thức trên có thể hiểu như sau. Thành phần đầu tiên tạo lực cần thiết để robot đạt gia tốc mong muốn. Thành phần thứ hai bù ảnh hưởng do sự kết hợp giữa chuyển động tịnh tiến và chuyển động quay. Thành phần cuối cùng bù ảnh hưởng của lực cản được giả thiết trong mô hình.

Nếu mô hình sử dụng trong bộ điều khiển hoàn toàn trùng khớp với đối tượng, các thành phần phi tuyến của hệ thống có thể được bù đáng kể. Khi đó, quá trình thiết kế bộ điều khiển trở nên đơn giản hơn vì phần động lực học phức tạp của robot đã được đưa vào trực tiếp trong tín hiệu điều khiển.

Đây chính là điểm khác biệt quan trọng giữa phương pháp nghiên cứu của đề tài và bộ điều khiển PID được sử dụng để đối chứng.

### 3.2.3. Xây dựng vận tốc tham chiếu

Quỹ đạo mong muốn của robot được xác định trong hệ tọa độ toàn cục, trong khi mô hình động lực học được xây dựng trong hệ tọa độ gắn với thân xe. Do đó, bộ điều khiển cần thực hiện quá trình chuyển đổi giữa hai hệ tọa độ.

Trước tiên, từ sai số vị trí, một vận tốc tham chiếu được xây dựng bằng cách kết hợp vận tốc của quỹ đạo đặt với một thành phần hiệu chỉnh phụ thuộc vào sai số.

Về mặt ý nghĩa, nếu robot đang nằm đúng trên quỹ đạo thì vận tốc tham chiếu chủ yếu được quyết định bởi vận tốc của quỹ đạo mong muốn. Ngược lại, nếu robot lệch khỏi quỹ đạo, thành phần phản hồi sai số sẽ tạo thêm vận tốc theo hướng đưa robot trở về gần quỹ đạo.

Vận tốc tham chiếu trong hệ tọa độ toàn cục được viết dưới dạng:

q_r =q_d +K_q ⁢e⁢. Sau đó, vận tốc này được chuyển về hệ tọa độ thân robot thông qua ma trận quay:

ν_d =R^T (θ)q_r ⁢. Như vậy, bộ điều khiển vừa khai thác thông tin của quỹ đạo đặt, vừa sử dụng sai số tức thời để hiệu chỉnh chuyển động.

### 3.2.4. Xây dựng vòng điều khiển vận tốc

Sau khi xác định được vận tốc mong muốn trong hệ tọa độ thân, sai số vận tốc được hình thành từ chênh lệch giữa vận tốc tham chiếu và vận tốc thực tế của robot.

Nếu sai số vận tốc khác không, bộ điều khiển cần tạo ra gia tốc phù hợp để đưa vận tốc thực tiến về giá trị mong muốn.

Trong nghiên cứu này, gia tốc điều khiển được xây dựng từ hai thành phần. Thành phần thứ nhất là gia tốc feedforward được suy ra từ quỹ đạo đặt. Thành phần thứ hai là phản hồi tỷ lệ theo sai số vận tốc.

Cấu trúc tổng quát được biểu diễn:

ν_c =ν_(ff) +K_v (ν_d -ν). Cách xây dựng này tạo nên một cấu trúc điều khiển hai tầng. Tầng ngoài sử dụng sai số vị trí để xác định vận tốc tham chiếu, trong khi tầng trong sử dụng sai số vận tốc để xác định gia tốc điều khiển.

Cấu trúc hai tầng giúp phân tách tương đối rõ nhiệm vụ bám vị trí và nhiệm vụ điều chỉnh đáp ứng động lực học.

### 3.2.5. Luật điều khiển cuối cùng

Sau khi xác định gia tốc điều khiển, lực và mô-men tác động lên robot được tính trực tiếp từ mô hình động lực học:

τ_(MBC) =M⁢ν_c +C(ν)ν+D⁢ν⁢. Như vậy, tín hiệu điều khiển của phương pháp MBC không chỉ phụ thuộc vào sai số mà còn phụ thuộc trực tiếp vào các thông số vật lý của robot.

Đây là ưu điểm đồng thời cũng là hạn chế của phương pháp. Nếu các tham số như khối lượng và mô-men quán tính được xác định tương đối chính xác, bộ điều khiển có khả năng tạo ra tác động phù hợp với trạng thái thực của đối tượng. Ngược lại, khi mô hình sai lệch nhiều so với robot thực, chất lượng bù động lực học có thể giảm.

Để đánh giá vấn đề này, Chương 4 sẽ cố ý tạo ra trường hợp trong đó robot thực trong mô phỏng có khối lượng lớn hơn giá trị mà bộ điều khiển sử dụng.

### 3.2.6. Giới hạn tín hiệu điều khiển

Trong hệ thống thực tế, lực và mô-men mà cơ cấu chấp hành có thể tạo ra luôn bị giới hạn. Vì vậy, nếu bộ điều khiển yêu cầu một tín hiệu quá lớn thì robot thực không thể đáp ứng chính xác.

Để mô phỏng gần hơn với điều kiện vật lý, đề tài giới hạn các thành phần điều khiển theo:

∣F_x ∣≤100 N,

∣F_y ∣≤100 N,

∣M_z ∣≤50 N⁢.⁢m⁢. Giới hạn này đặc biệt quan trọng tại thời điểm ban đầu của mô phỏng vì robot được đặt lệch khỏi quỹ đạo tham chiếu. Khi sai số lớn, bộ điều khiển có xu hướng tạo tác động mạnh để đưa robot về quỹ đạo.

Do đó, việc đánh giá tín hiệu điều khiển cực đại cũng được thực hiện trong phần kết quả nhằm kiểm tra mức độ tác động cần thiết của mỗi phương pháp.

3.3. Phân tích tính ổn định của bộ điều khiển dựa trên mô hình

Một trong những yêu cầu quan trọng của hệ thống điều khiển là bảo đảm sai số không tăng không giới hạn theo thời gian.

Để phân tích đặc tính của bộ điều khiển MBC trong trường hợp lý tưởng, giả thiết mô hình sử dụng trong bộ điều khiển trùng khớp với mô hình của đối tượng và chưa xét đến giới hạn tín hiệu điều khiển.

Khi đó, việc bù các thành phần động lực học cho phép quan hệ giữa gia tốc thực của robot và gia tốc điều khiển được đơn giản hóa. Với luật phản hồi vận tốc đã lựa chọn, động lực học sai số vận tốc có thể được viết dưới dạng:

e_ν =-K_v ⁢e_ν ⁢. Biểu thức trên cho thấy tốc độ giảm sai số phụ thuộc trực tiếp vào các hệ số của ma trận K_v .

Để đánh giá ổn định, lựa chọn hàm Lyapunov:

V=1/2⁢e_ν^T ⁢e_ν ⁢. Hàm V luôn không âm và chỉ bằng không khi sai số vận tốc bằng không.

Đạo hàm của hàm Lyapunov theo thời gian thu được:

V=-e_ν^T ⁢K_v ⁢e_ν ⁢. Khi K_v là ma trận xác định dương, ta có:

V<0 với mọi sai số khác không.

Kết quả trên cho thấy trong điều kiện mô hình lý tưởng, sai số vận tốc của vòng điều khiển có xu hướng hội tụ về không.

Tuy nhiên, cần nhấn mạnh rằng đây là phân tích lý tưởng. Trong các trường hợp thực tế, mô hình có thể sai lệch, tín hiệu điều khiển bị giới hạn và nhiễu bên ngoài có thể xuất hiện. Vì vậy, tính năng của hệ trong các điều kiện này không được kết luận chỉ từ phân tích Lyapunov mà sẽ được kiểm chứng thông qua mô phỏng ở Chương 4.

## 3.4. Thiết kế bộ điều khiển PID đối chứng

### 3.4.1. Vai trò của PID trong nghiên cứu

Để đánh giá được lợi ích thực sự của việc sử dụng mô hình động lực học, cần có một phương pháp điều khiển đối chứng.

Trong đề tài, PID được lựa chọn vì đây là phương pháp phổ biến, có cấu trúc đơn giản và được sử dụng rộng rãi trong thực tế.

Mục đích của việc sử dụng PID không phải để chứng minh PID là phương pháp không phù hợp, mà để tạo ra một cơ sở so sánh giữa một bộ điều khiển chủ yếu dựa trên phản hồi sai số và một bộ điều khiển có sử dụng trực tiếp thông tin động lực học của robot.

Do đó, các thông số PID cần được hiệu chỉnh ở mức hợp lý trước khi thực hiện so sánh.

### 3.4.2. Cấu trúc bộ điều khiển PID

Tín hiệu điều khiển PID được xây dựng từ ba thành phần gồm tỷ lệ, tích phân và vi phân.

Thành phần tỷ lệ phản ứng trực tiếp với sai số hiện tại. Khi robot lệch xa khỏi quỹ đạo, thành phần này tạo tác động lớn hơn nhằm đưa robot quay trở lại.

Thành phần tích phân tích lũy sai số theo thời gian và có vai trò giảm sai số xác lập.

Trong khi đó, thành phần vi phân phản ánh tốc độ thay đổi của sai số, góp phần làm giảm dao động và cải thiện đặc tính quá độ của hệ.

Luật điều khiển được biểu diễn:

τ_(PID) =K_p ⁢e+K_i ∫ e d⁢t+K_d ⁢e⁢. Trong mô phỏng, tín hiệu PID được tính trong hệ tọa độ toàn cục rồi chuyển về hệ tọa độ thân robot trước khi đưa vào mô hình động lực học.

Điều này giúp PID và MBC cùng tác động lên một đối tượng theo cùng định nghĩa lực và mô-men tổng quát.

### 3.4.3. Chống bão hòa tích phân

Một vấn đề thường gặp khi sử dụng PID là hiện tượng bão hòa tích phân. Khi tín hiệu điều khiển đã đạt giới hạn nhưng sai số vẫn tồn tại, thành phần tích phân tiếp tục tích lũy và có thể làm hệ thống quá điều chỉnh khi thoát khỏi trạng thái bão hòa.

Để hạn chế hiện tượng này, chương trình mô phỏng đặt giới hạn cho giá trị tích phân.

Biện pháp trên tuy đơn giản nhưng giúp bộ điều khiển PID hoạt động ổn định hơn khi robot có sai số ban đầu tương đối lớn.

## 3.5. Lựa chọn và hiệu chỉnh tham số PID

Trong giai đoạn mô phỏng ban đầu, PID được thử nghiệm với các hệ số tương đối nhỏ. Kết quả cho thấy robot vẫn có khả năng bám theo quỹ đạo nhưng sai số lớn hơn đáng kể so với bộ điều khiển dựa trên mô hình. Đồng thời, mức lực điều khiển PID tạo ra cũng nhỏ hơn nhiều so với MBC.

Nếu sử dụng trực tiếp bộ thông số này để so sánh, kết quả có thể không phản ánh công bằng ưu điểm của MBC bởi sự khác biệt có thể xuất phát chủ yếu từ việc PID chưa được hiệu chỉnh phù hợp.

Do đó, PID được tinh chỉnh lại dựa trên đặc tính động lực học gần đúng của đối tượng.

Xét một chuyển động tịnh tiến đơn giản hóa của robot:

m⁢x+d⁢x=u⁢. Từ yêu cầu về tần số riêng và hệ số giảm chấn mong muốn, các hệ số tỷ lệ và vi phân được ước lượng ban đầu. Sau đó, thành phần tích phân được bổ sung với giá trị nhỏ để hỗ trợ giảm sai số xác lập mà không làm tăng quá mức hiện tượng tích lũy.

Bộ tham số được sử dụng trong các thí nghiệm chính thức là:

K_p =diag(40, 40, 3.2),

K_i =diag(1, 1, 0.15),

K_d =diag(34, 34, 2.38). Sau khi hiệu chỉnh, RMSE của PID trong trường hợp danh định giảm đáng kể so với bộ tham số thử nghiệm ban đầu. Điều này cho thấy bộ PID mới phù hợp hơn để sử dụng làm phương pháp đối chứng.

## 3.6. So sánh nguyên lý hoạt động giữa MBC và PID

Mặc dù cùng sử dụng sai số bám làm thông tin phản hồi, hai bộ điều khiển có bản chất khác nhau.

PID không yêu cầu biết chính xác khối lượng hay mô-men quán tính của robot. Tín hiệu điều khiển chủ yếu được hình thành từ sai số và tốc độ thay đổi của sai số. Điều này giúp PID có cấu trúc đơn giản và thuận lợi khi triển khai.

Ngược lại, MBC sử dụng trực tiếp các tham số của mô hình động lực học. Tại mỗi thời điểm, lực và mô-men điều khiển được tính toán dựa trên khối lượng, mô-men quán tính, vận tốc hiện tại và lực cản của robot.

Do đó, khi mô hình chính xác, MBC có khả năng chủ động bù các ảnh hưởng động lực học thay vì chờ sai số xuất hiện rồi mới hiệu chỉnh.

Tuy nhiên, điều này cũng làm MBC nhạy hơn với sai lệch mô hình. Nếu khối lượng thực tế khác nhiều so với giá trị được sử dụng trong controller, thành phần bù động lực học không còn hoàn toàn chính xác.

Đây chính là lý do nghiên cứu không chỉ so sánh hai bộ điều khiển trong điều kiện danh định mà còn xây dựng một kịch bản trong đó khối lượng và mô-men quán tính của plant bị thay đổi.

## 3.7. Các tham số điều khiển sử dụng

Các tham số của hai bộ điều khiển được giữ cố định trong toàn bộ ba kịch bản thử nghiệm.

Đối với MBC, ma trận phản hồi vị trí được lựa chọn:

K_q =diag(2, 2, 2.5), trong khi ma trận phản hồi vận tốc được đặt:

K_v =diag(5, 5, 4). Đối với PID, bộ thông số sau quá trình hiệu chỉnh được sử dụng như đã trình bày ở trên.

Có thể tổng hợp các tham số trong Bảng 3.1.

Bảng 3.1. Thông số các bộ điều khiển

Thông số | Phương x | Phương y | Góc quay
K_q của MBC | 2.0 | 2.0 | 2.5
K_v của MBC | 5.0 | 5.0 | 4.0
K_p của MBC | 40 | 40 | 3.2
K_i của MBC | 1.0 | 1.0 | 0.15
K_d của MBC | 34 | 34 | 2.38

Việc giữ nguyên các hệ số qua các kịch bản có ý nghĩa quan trọng. Nếu các bộ điều khiển được hiệu chỉnh lại riêng cho từng trường hợp, kết quả sẽ khó phản ánh khả năng thích ứng của thuật toán khi điều kiện vận hành thay đổi.

## 3.8. Nguyên tắc xây dựng phép so sánh

Để bảo đảm tính khách quan, hai bộ điều khiển được đánh giá trên cùng một đối tượng trong từng kịch bản. Cả hai sử dụng cùng quỹ đạo tham chiếu, điều kiện ban đầu, bước thời gian mô phỏng và giới hạn lực điều khiển.

Trong kịch bản có nhiễu, cùng một vector nhiễu được tác động lên plant của cả MBC và PID trong cùng khoảng thời gian.

Trong kịch bản sai lệch tải trọng, các tham số của plant được thay đổi giống nhau đối với cả hai bộ điều khiển. Riêng MBC vẫn sử dụng các tham số danh định trong controller nhằm đánh giá ảnh hưởng của sai lệch mô hình.

PID sau khi được hiệu chỉnh cũng được giữ nguyên thông số trong mọi kịch bản.

Nhờ vậy, sự khác biệt về kết quả chủ yếu phản ánh đặc điểm của hai phương pháp điều khiển thay vì do thay đổi điều kiện thử nghiệm.

3.9. Kết luận Chương 3

Trong chương này, hai phương pháp điều khiển bám quỹ đạo cho robot Mecanum đã được xây dựng.

Phương pháp thứ nhất sử dụng mô hình động lực học của robot để tính toán lực và mô-men cần thiết. Thông qua việc bù các thành phần quán tính, Coriolis và lực cản, bộ điều khiển MBC theo nguyên lý Computed Torque Control hướng tới việc giảm ảnh hưởng của động lực học lên quá trình bám quỹ đạo.

Phương pháp thứ hai là PID, được sử dụng làm bộ điều khiển đối chứng. Khác với MBC, PID không trực tiếp sử dụng ma trận động lực học của robot mà xây dựng tín hiệu điều khiển dựa trên sai số vị trí, tích phân sai số và tốc độ biến thiên của sai số.

Một điểm quan trọng trong quá trình nghiên cứu là PID đã được hiệu chỉnh lại trước khi tiến hành các phép so sánh chính thức. Điều này giúp hạn chế trường hợp MBC đạt kết quả tốt hơn chỉ do bộ PID được lựa chọn quá yếu.

Sau khi hoàn thành thiết kế hai bộ điều khiển, bước tiếp theo là kiểm chứng khả năng làm việc của chúng trong những điều kiện khác nhau. Chương 4 sẽ xây dựng môi trường mô phỏng MATLAB, thiết lập các thông số của robot và tiến hành ba kịch bản gồm điều kiện danh định, sai lệch tải trọng và tác động của nhiễu ngoại lực. Kết quả sẽ được đánh giá thông qua quỹ đạo, sai số vị trí, sai số góc và chỉ số RMSE.

# CHƯƠNG 4. MÔ PHỎNG VÀ ĐÁNH GIÁ KẾT QUẢ

Sau khi xây dựng mô hình toán của robot Mecanum và thiết kế hai bộ điều khiển ở các chương trước, chương này tiến hành mô phỏng nhằm đánh giá khả năng bám quỹ đạo của phương pháp điều khiển dựa trên mô hình động lực học theo nguyên lý Computed Torque Control và bộ điều khiển PID đối chứng.

Môi trường mô phỏng được xây dựng trên MATLAB. Hai bộ điều khiển được khảo sát trên cùng mô hình đối tượng, cùng quỹ đạo tham chiếu, điều kiện ban đầu và giới hạn tín hiệu điều khiển. Ba trường hợp được lựa chọn gồm điều kiện danh định, sai lệch tham số tải trọng và tác động của nhiễu ngoại lực. Kết quả được đánh giá thông qua sai số vị trí, sai số góc định hướng, chỉ số RMSE, đặc tính bám sau giai đoạn quá độ, tín hiệu điều khiển và tốc độ yêu cầu của các bánh xe.

## 4.1. Xây dựng chương trình mô phỏng trên MATLAB

### 4.1.1. Cấu trúc chương trình mô phỏng

Chương trình mô phỏng được tổ chức theo cấu trúc module nhằm tách biệt các thành phần của hệ thống, bao gồm khối tham số, quỹ đạo tham chiếu, bộ điều khiển, mô hình động lực học và khối tổng hợp kết quả. Cách tổ chức này giúp thuận tiện cho việc thay đổi tham số, thực hiện các trường hợp khảo sát khác nhau và so sánh hai bộ điều khiển trong cùng điều kiện. Trong mô hình hiện tại, các chức năng chính được triển khai thông qua các file parameters.m, trajectory.m, controller_MBC.m, controller_PID.m, robot_dynamics.m, mecanum_kinematics.m, simulate_case.m và main.m.

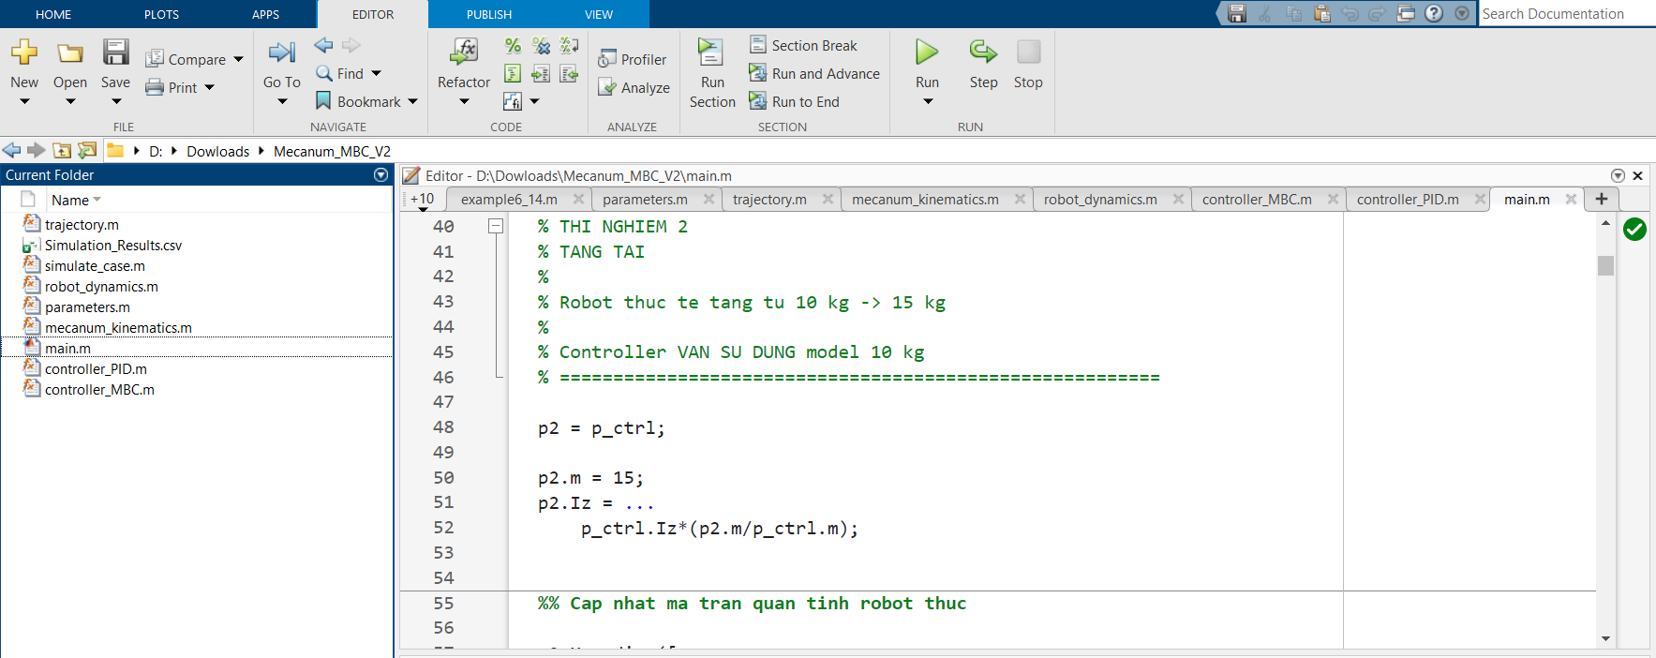
[picture p61: figure]

Hình 4.1 Cấu trúc chương trình mô phỏng MATLAB

Trong đó, main.m đóng vai trò điều phối toàn bộ quá trình mô phỏng và tổng hợp kết quả. Các tham số của robot, bộ điều khiển và thời gian mô phỏng được khai báo trong parameters.m. Hàm trajectory.m tạo quỹ đạo mong muốn tại từng thời điểm. Hai thuật toán điều khiển được triển khai độc lập trong controller_MBC.m và controller_PID.m.

Mô hình đối tượng được mô tả trong robot_dynamics.m, trong khi mecanum_kinematics.m thực hiện chuyển đổi từ vận tốc thân robot sang tốc độ góc của bốn bánh. Hàm simulate_case.m thực hiện quá trình mô phỏng theo thời gian cho từng trường hợp khảo sát.

### 4.1.2. Khối tạo quỹ đạo tham chiếu

Quỹ đạo tham chiếu được xây dựng sao cho cung cấp đồng thời vị trí, vận tốc và gia tốc mong muốn:

q_d (t), q_d (t), q_d (t). Việc xác định đầy đủ ba đại lượng này là cần thiết vì bộ điều khiển MBC/CTC sử dụng không chỉ sai số vị trí mà còn khai thác thông tin vận tốc và gia tốc của quỹ đạo trong quá trình tính toán tín hiệu điều khiển.

Trong nghiên cứu này, quỹ đạo tròn được lựa chọn làm quỹ đạo khảo sát chính. Quỹ đạo này yêu cầu robot đồng thời điều khiển chuyển động theo hai phương x,y và thay đổi góc định hướng theo thời gian, vì vậy phù hợp để đánh giá khả năng bám quỹ đạo của robot Mecanum.

### 4.1.3. Khối điều khiển MBC/CTC

Tại mỗi thời điểm mô phỏng, bộ điều khiển MBC nhận trạng thái hiện tại của robot cùng các đại lượng tham chiếu q_d , q_d và q_d .

Trước tiên, sai số vị trí được sử dụng để hình thành vận tốc tham chiếu. Sau đó, vận tốc tham chiếu được chuyển từ hệ tọa độ toàn cục sang hệ tọa độ thân robot. Sai số giữa vận tốc tham chiếu và vận tốc thực được sử dụng để xây dựng gia tốc điều khiển.

Cuối cùng, lực và mô-men điều khiển được xác định dựa trên mô hình động lực học:

τ_(MBC) =M⁢ν_c +C(ν)ν+D⁢ν⁢. Chương 3 cấu trúc này cho phép đưa trực tiếp các thành phần động lực học đã mô hình hóa vào quá trình tính toán tín hiệu điều khiển.

### 4.1.4. Khối điều khiển PID

Để làm cơ sở đối chứng, bộ điều khiển PID được triển khai song song với MBC/CTC. Tín hiệu PID được tính từ sai số vị trí, tích phân sai số và đạo hàm sai số.

Sau khi xác định trong hệ tọa độ toàn cục, tín hiệu PID được chuyển về hệ tọa độ gắn với thân robot trước khi đưa vào mô hình động lực học. Các giới hạn tín hiệu điều khiển và cơ chế chống bão hòa tích phân được áp dụng nhằm tránh tích lũy sai số quá mức khi cơ cấu chấp hành đạt giới hạn.

Các thông số PID được giữ cố định trong toàn bộ các trường hợp khảo sát. Điều này giúp bảo đảm sự thay đổi của kết quả không xuất phát từ việc hiệu chỉnh lại bộ điều khiển cho từng trường hợp.

### 4.1.5. Khối mô hình động lực học robot

Đối tượng điều khiển được mô tả bởi hệ phương trình:

q=R(θ)ν

ν=M^(-1) [τ-C(ν)ν-D⁢ν]. Trong trường hợp có nhiễu bên ngoài, phương trình động lực học được mở rộng thành:

ν=M^(-1) [τ+d-C(ν)ν-D⁢ν], trong đó d là vector lực và mô-men nhiễu.

Mô hình này được sử dụng thống nhất cho cả MBC và PID. Trong các trường hợp sai lệch tham số, chỉ các tham số của plant được thay đổi trong khi cấu trúc điều khiển và các hệ số đã thiết kế được giữ nguyên.

### 4.1.6. Phương pháp tích phân số

Phương trình vi phân của robot được giải theo từng bước thời gian bằng phương pháp Euler tiến. Với bước lấy mẫu Δ⁢t , trạng thái được cập nhật theo:

q_(k+1) =q_k +q_k ⁢Δ⁢t

ν_(k+1) =ν_k +ν_k ⁢Δ⁢t⁢. Trong mô phỏng, bước thời gian được lựa chọn:

Δ⁢t=0.01 s⁢. Phương pháp Euler có ưu điểm đơn giản và phù hợp với mục tiêu so sánh tương đối giữa hai thuật toán trong cùng điều kiện tính toán. Tuy nhiên, đây vẫn là phương pháp tích phân số bậc thấp, do đó ảnh hưởng của bước thời gian cần được lưu ý khi mở rộng nghiên cứu sang các mô hình có động lực học nhanh hơn.

## 4.2. Thông số mô phỏng

### 4.2.1. Thông số robot

Các thông số danh định sử dụng trong mô phỏng được tổng hợp trong Bảng 4.1.

Bảng 4.1. Thông số robot và môi trường mô phỏng

Thông số | Ký hiệu | Giá trị
Khối lượng robot | m | 10 k⁢g
Mô-men quán tính | I_z | 0.8 k⁢g⁢.⁢m^2
Bán kính bánh xe | r | 0.05 m
Khoảng cách theo phương dọc | L | 0.30 m
Khoảng cách theo phương ngang | W | 0.25 m
Hệ số cản theo x | d_x | 2
Hệ số cản theo y | d_y | 2
Hệ số cản quay | d_θ | 0.5
Thời gian mô phỏng | T | 40 s
Bước thời gian | Δ⁢t | 0.01 s
Giới hạn F_x | | 100 N
Giới hạn F_y | | 100 N
Giới hạn M_z | | 50 N⁢.⁢m

Ma trận cản được xác định:

D=diag(2, 2, 0.5). Các thông số trên được sử dụng làm bộ tham số danh định của mô hình. Chúng được giữ cố định trong trường hợp thứ nhất và được thay đổi có chủ đích ở trường hợp thứ hai nhằm tạo sai lệch giữa plant và mô hình sử dụng trong bộ điều khiển.

### 4.2.2. Quỹ đạo tham chiếu

Quỹ đạo tròn được xác định:

x_d (t)=R_t ⁢cos(ω_r ⁢t)

y_d (t)=R_t ⁢sin(ω_r ⁢t) với:

R_t =2 m, ω_r =0.2 r⁢a⁢d⁢/⁢s⁢. Góc định hướng mong muốn được chọn theo tiếp tuyến của quỹ đạo:

θ_d (t)=ω_r ⁢t+π/2⁢. Vận tốc tham chiếu tương ứng:

x_d =-R_t ⁢ω_r ⁢sin(ω_r ⁢t)

y_d =R_t ⁢ω_r ⁢cos(ω_r ⁢t)

θ_d =ω_r ⁢. Gia tốc:

x_d =-R_t ⁢ω_r^2 ⁢cos(ω_r ⁢t)

y_d =-R_t ⁢ω_r^2 ⁢sin(ω_r ⁢t)

θ_d =0.

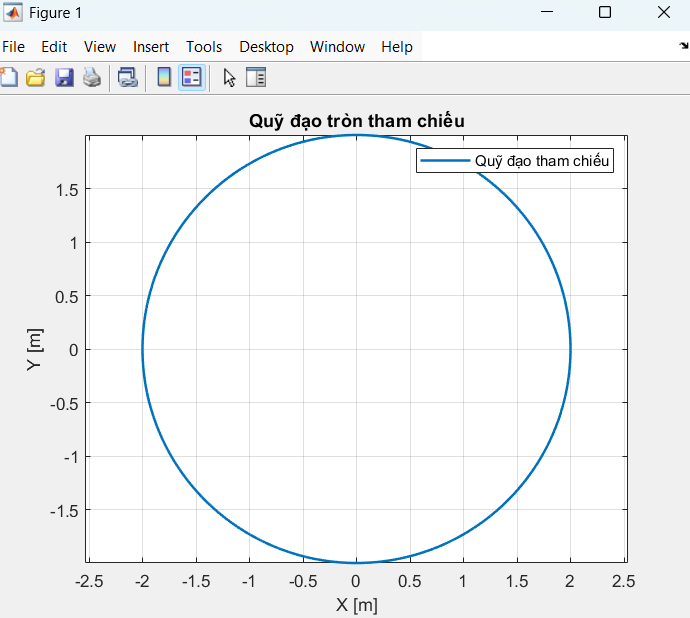
[picture p62: figure]

Hình 4.2 Quỹ đạo tròn tham chiếu sử dụng trong mô phỏng

### 4.2.3. Điều kiện ban đầu

Trạng thái ban đầu của robot được chọn:

q(0)=[000], ν(0)=[000]⁢. Trong khi đó, tại t = 0, quỹ đạo tham chiếu có trạng thái:

q_d (0)=[20π⁢/⁢2]⁢. Như vậy, robot bắt đầu mô phỏng với sai số vị trí ban đầu:

e_p (0)=2 m⁢. Việc lựa chọn điều kiện ban đầu lệch khỏi quỹ đạo cho phép quan sát đồng thời khả năng đưa robot tiếp cận quỹ đạo và khả năng duy trì bám sau khi giai đoạn quá độ kết thúc.

Đây cũng là nguyên nhân khiến sai số vị trí cực đại của cả hai bộ điều khiển trong các trường hợp mô phỏng đều đạt khoảng 2m. Vì vậy, chỉ tiêu sai số cực đại toàn quá trình không phản ánh rõ sự khác biệt giữa hai phương pháp và cần được xem xét kết hợp với RMSE cũng như sai số sau giai đoạn quá độ.

## 4.3. Tiêu chí đánh giá

### 4.3.1. Sai số vị trí

Sai số vị trí tổng hợp của robot tại thời điểm \(t\) được xác định:

e_p (t)=√(e_x^2 (t)+e_y^2 (t))⁢. Chỉ tiêu này phản ánh trực tiếp khoảng cách giữa vị trí thực của robot và vị trí mong muốn trên mặt phẳng.

### 4.3.2. RMSE vị trí

Để đánh giá sai số trong toàn bộ quá trình mô phỏng, nghiên cứu sử dụng chỉ số RMSE vị trí:

R⁢M⁢S⁢E_p =√(1/N∑_(k=1)^N [e_x^2 (k)+e_y^2 (k)])⁢. RMSE nhỏ hơn tương ứng với khả năng bám vị trí tốt hơn xét trên toàn bộ khoảng thời gian khảo sát.

### 4.3.3. RMSE góc định hướng

Sai số góc được đánh giá thông qua:

R⁢M⁢S⁢E_θ =√(1/N∑_(k=1)^N e_θ^2 (k))⁢. Chỉ tiêu này được sử dụng nhằm đánh giá khả năng duy trì hướng của robot theo quỹ đạo mong muốn.

### 4.3.4. RMSE sau giai đoạn quá độ

Do robot bắt đầu tại vị trí cách quỹ đạo 2m, RMSE toàn quá trình chịu ảnh hưởng đáng kể của giai đoạn tiếp cận quỹ đạo ban đầu.

Để đánh giá rõ hơn chất lượng bám sau quá độ, nghiên cứu tính thêm RMSE trong khoảng:

t≥5 s⁢. Chỉ tiêu này giúp phân biệt khả năng đưa robot từ điều kiện đầu tới quỹ đạo với khả năng duy trì bám khi robot đã tiến gần trạng thái mong muốn.

### 4.3.5. Sai số cực đại

Sai số vị trí cực đại được xác định:

e_(max) =maxte_p (t). Tuy nhiên, do điều kiện ban đầu của các trường hợp khảo sát giống nhau và có sai số 2m, chỉ tiêu này chủ yếu phản ánh sai số ban đầu. Vì vậy, trong phần bàn luận, RMSE được sử dụng làm chỉ tiêu chính.

### 4.3.6. Tín hiệu điều khiển và tốc độ bánh xe

Ngoài sai số bám, lực và mô-men điều khiển:

F_x , F_y , M_z cùng tốc độ góc của bốn bánh được khảo sát nhằm đánh giá mức độ tác động cần thiết để đạt được chất lượng bám tương ứng.

Trong nghiên cứu này, các đại lượng trên được gọi là nỗ lực điều khiển và tốc độ yêu cầu của bánh xe, không được xem trực tiếp là mức tiêu thụ năng lượng do mô hình chưa bao gồm động lực học điện và công suất của động cơ.

## 4.4. Trường hợp 1 điều kiện danh định

Trường hợp thứ nhất được xây dựng nhằm đánh giá chất lượng bám quỹ đạo khi mô hình sử dụng trong bộ điều khiển phù hợp với mô hình của đối tượng.

Các tham số được lựa chọn:

m_(model) =m_(plant) =10 k⁢g

I_(z,model) =I_(z,plant) =0.8 k⁢g⁢.⁢m^2 ⁢. Trong điều kiện này, MBC có đầy đủ thông tin về các tham số động lực học đang được sử dụng trong plant.

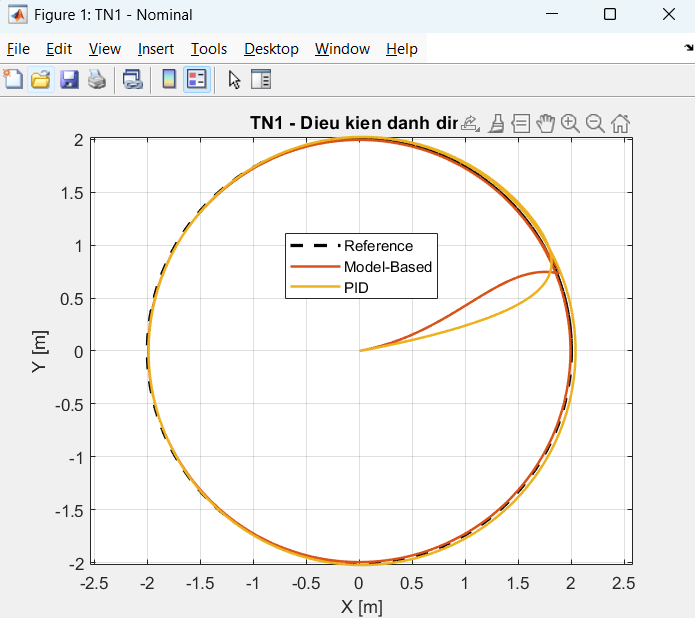
[picture p63: figure]
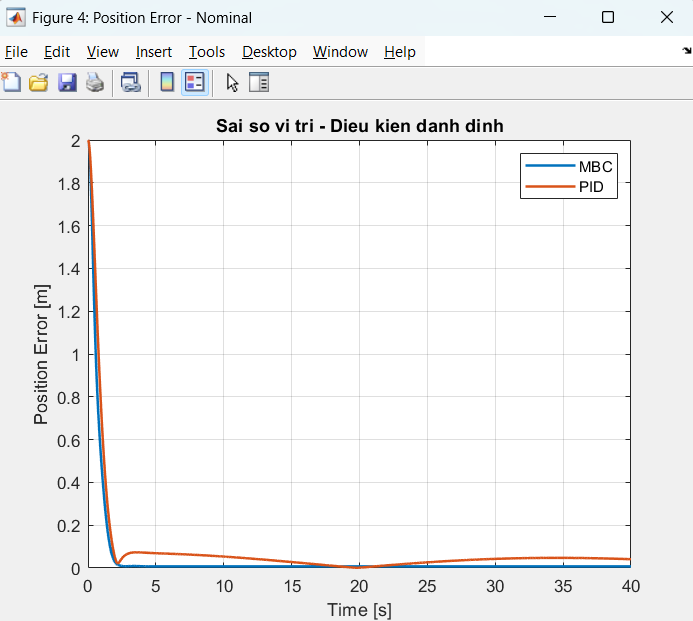
[picture p64: figure]

Hình 4.3 So sánh quỹ đạo bám và sai số vị trí theo thời gian của MBC và PID trong điều kiện danh định

Kết quả mô phỏng cho thấy cả MBC và PID đều có khả năng đưa robot từ điều kiện ban đầu tới gần quỹ đạo tham chiếu và duy trì chuyển động theo quỹ đạo tròn.

RMSE vị trí toàn quá trình thu được:

R⁢M⁢S⁢E_(MBC) =0.21186 m

R⁢M⁢S⁢E_(PID) =0.24495 m⁢. Mức giảm RMSE của MBC so với PID được xác định:

(0.24495-0.21186)/0.24495×100⁢%≈13.51⁢%. Kết quả này cho thấy trong điều kiện danh định, bộ điều khiển dựa trên mô hình cho sai số vị trí trung bình bình phương nhỏ hơn PID.

Đối với góc định hướng:

R⁢M⁢S⁢E_(θ,MBC) =0.145618 r⁢a⁢d, trong khi:

R⁢M⁢S⁢E_(θ,PID) =0.197455 r⁢a⁢d⁢. MBC cũng cho sai số góc nhỏ hơn trong trường hợp này.

Sự khác biệt thể hiện rõ hơn khi loại bỏ giai đoạn quá độ ban đầu. Với t≥5 s \[
R⁢M⁢S⁢E_(MBC)^(ss) =0.00776 m

R⁢M⁢S⁢E_(PID)^(ss) =0.04065 m⁢.

Kết quả trên cho thấy RMSE toàn quá trình bị chi phối đáng kể bởi sai số ban đầu 2m. Sau khi robot tiếp cận quỹ đạo, sự khác biệt về khả năng duy trì bám giữa hai bộ điều khiển trở nên rõ ràng hơn.

Tuy nhiên, kết quả này chỉ phản ánh điều kiện mô hình danh định và chưa thể hiện ảnh hưởng của sai lệch tham số hoặc nhiễu bên ngoài. Vì vậy, hai trường hợp tiếp theo được xây dựng để đánh giá hệ thống trong điều kiện khó hơn.

## 4.5. Trường hợp 2 sai lệch tham số tải trọng

Trong ứng dụng thực tế, tải trọng của robot có thể thay đổi trong quá trình vận hành. Khi đó, khối lượng và mô-men quán tính thực tế có thể khác với các tham số được sử dụng khi thiết kế bộ điều khiển.

Để khảo sát ảnh hưởng này, plant trong trường hợp thứ hai được thiết lập với:

m_(plant) =15 k⁢g

I_(z,plant) =1.2 k⁢g⁢.⁢m^2 ⁢. Trong khi đó, bộ điều khiển MBC vẫn sử dụng mô hình danh định:

m_(model) =10 k⁢g

I_(z,model) =0.8 k⁢g⁢.⁢m^2 ⁢. Do đó:

M_(model) ≠M_(plant) ⁢. Cách thiết lập này nhằm khảo sát tính nhạy của thuật toán khi tham số động lực học của đối tượng sai lệch so với mô hình được sử dụng trong bộ điều khiển. Trong file hiện tại của đề tài, trường hợp tải và trường hợp nhiễu cũng được xác định từ Chương 2 như các tình huống dùng để đánh giá chất lượng bám.

Cần lưu ý rằng khối lượng 15kg được áp dụng cho plant trong toàn bộ thời gian mô phỏng, không phải là một sự thay đổi tải đột ngột tại một thời điểm cụ thể.

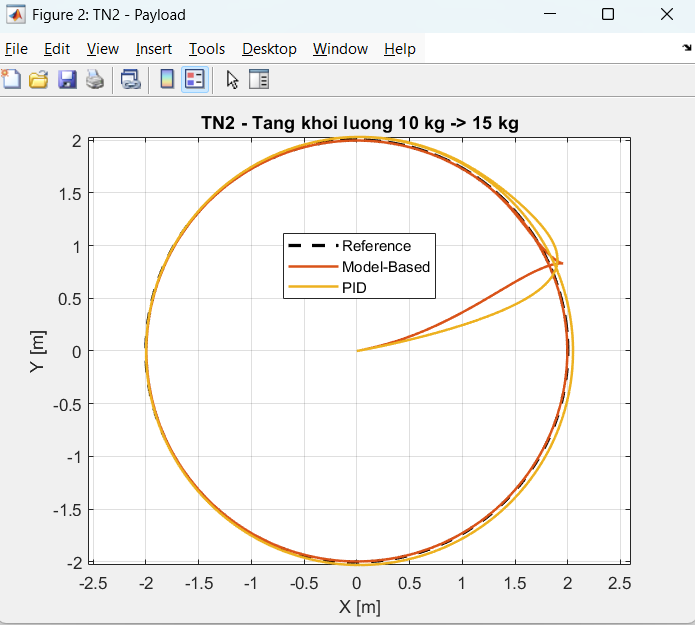
[picture p65: figure]
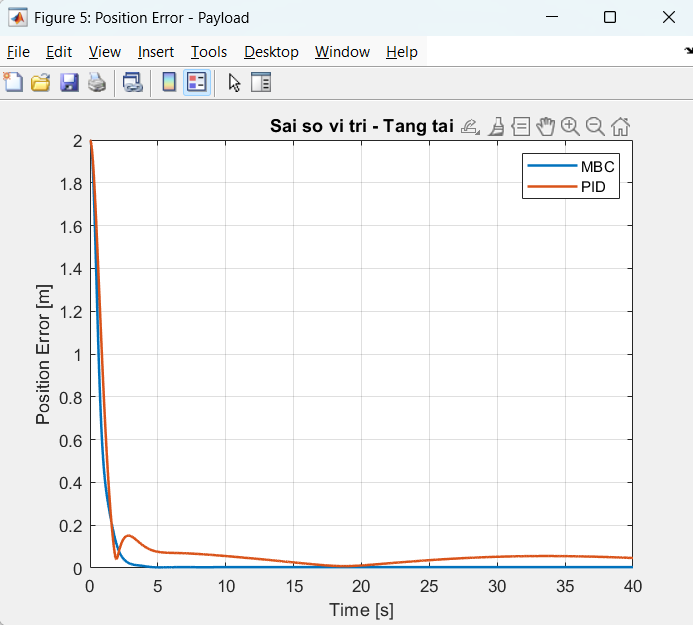
[picture p66: figure]

Hình 4.4 Quỹ đạo bám khi tham số và sai số vị trí khi tải trọng sai lệch

RMSE vị trí thu được:

R⁢M⁢S⁢E_(MBC) =0.22420 m

R⁢M⁢S⁢E_(PID) =0.26078 m⁢. MBC cho RMSE thấp hơn PID:

(0.26078-0.22420)/0.26078×100⁢%≈14.03⁢%. Đối với góc định hướng:

R⁢M⁢S⁢E_(θ,MBC) =0.159910 r⁢a⁢d

R⁢M⁢S⁢E_(θ,PID) =0.211051 r⁢a⁢d⁢. Sau giai đoạn quá độ t≥5 s , kết quả thu được:

R⁢M⁢S⁢E_(MBC)^(ss) =0.00378 m

R⁢M⁢S⁢E_(PID)^(ss) =0.04614 m⁢.

Kết quả cho thấy mặc dù plant có sai lệch về khối lượng và mô-men quán tính so với mô hình danh định, MBC vẫn duy trì sai số thấp hơn PID trong trường hợp khảo sát.

Tuy nhiên, kết quả trên không nên được hiểu rằng MBC hoàn toàn không nhạy với sai lệch mô hình. MBC phụ thuộc trực tiếp vào các tham số động lực học; do đó khi mức sai lệch tiếp tục tăng hoặc cấu trúc mô hình thay đổi, chất lượng bù có thể suy giảm. Kết quả của trường hợp này chỉ chứng minh rằng với mức sai lệch được lựa chọn trong nghiên cứu, bộ điều khiển MBC vẫn duy trì được chất lượng bám tốt.

Đồng thời, việc RMSE sau quá độ của MBC trong trường hợp này nhỏ hơn giá trị ở điều kiện danh định không nên được diễn giải rằng tăng tải làm cải thiện bộ điều khiển. Đây là kết quả của tương tác giữa bộ tham số, quỹ đạo và mô hình cụ thể được sử dụng trong mô phỏng.

## 4.6. Trường hợp 3 tác động của nhiễu ngoại lực

Trường hợp thứ ba được xây dựng để đánh giá khả năng duy trì bám quỹ đạo khi robot chịu tác động từ môi trường bên ngoài.

Trong khoảng thời gian:

15 s≤t≤20 s, một vector nhiễu được bổ sung vào plant:

d=[15-102], tương ứng với lực theo hai phương và mô-men quay:

F_(dx) =15 N

F_(dy) =-10 N

M_(dz) =2 N⁢.⁢m⁢ Ngoài khoảng thời gian trên:

d=0. Vector trên được sử dụng như một trường hợp nhiễu mô phỏng để đánh giá đặc tính hệ điều khiển, không đại diện cho số liệu đo từ một va chạm vật lý cụ thể. Đây cũng là cách mô hình nhiễu đã được xác định trong phần mô hình hóa của báo cáo.

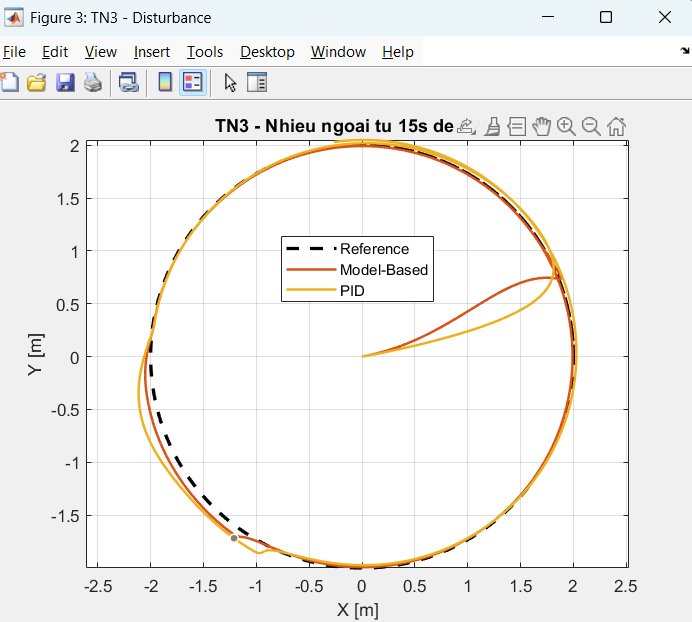
[picture p67: figure]
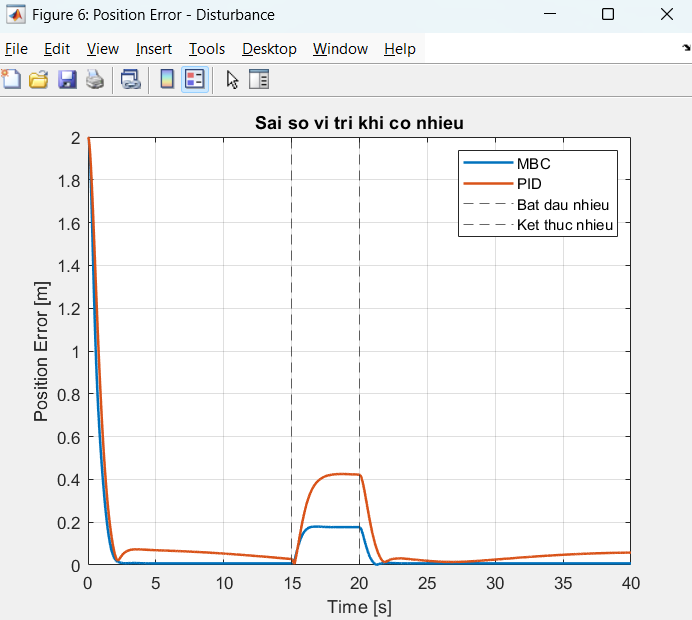
[picture p68: figure]

Hình 4.5 So sánh quỹ đạo bám và sai số vị trí khi xuất hiện nhiễu ngoại lực

Trên toàn bộ thời gian mô phỏng, RMSE vị trí là:

R⁢M⁢S⁢E_(MBC) =0.22032 m

R⁢M⁢S⁢E_(PID) =0.28127 m⁢ Mức giảm của MBC so với PID đạt:

(0.28127-0.22032)/0.28127×100⁢%≈21.67⁢%. Đối với góc định hướng:

R⁢M⁢S⁢E_(θ,MBC) =0.169748 r⁢a⁢d

R⁢M⁢S⁢E_(θ,PID) =0.283575 r⁢a⁢d⁢ Ảnh hưởng của nhiễu lên sai số góc của PID thể hiện rõ hơn so với MBC trong trường hợp khảo sát.

Để đánh giá trực tiếp phản ứng của hai bộ điều khiển trong khoảng nhiễu tác động, RMSE vị trí được tính riêng với:

15 s≤t≤20 s⁢. Kết quả:

R⁢M⁢S⁢E_(MBC)^(dist) =0.16437 m

R⁢M⁢S⁢E_(PID)^(dist) =0.36588 m⁢ Mức giảm tương ứng:

(0.36588-0.16437)/0.36588×100⁢%≈55.08⁢% Đây là một kết quả đáng chú ý của mô phỏng. Trong khoảng xuất hiện nhiễu, MBC duy trì sai số vị trí thấp hơn rõ rệt so với PID.

Xét từ t≥5 s , bao gồm cả khoảng chịu nhiễu:

R⁢M⁢S⁢E_(MBC)^(ss) =0.06508 m

R⁢M⁢S⁢E_(PID)^(ss) =0.15329 m⁢.

Kết quả cho thấy trong trường hợp nhiễu được lựa chọn, bộ điều khiển dựa trên mô hình duy trì chất lượng bám tốt hơn và giảm ảnh hưởng của nhiễu lên quỹ đạo. Tuy nhiên, không nên từ đó kết luận rằng phương pháp có tính bền vững đối với mọi dạng nhiễu, bởi nghiên cứu mới chỉ khảo sát một dạng nhiễu lực và mô-men có biên độ và thời gian xác định.

## 4.7. Tổng hợp và bàn luận kết quả

### 4.7.1. So sánh RMSE vị trí

Kết quả RMSE toàn quá trình được tổng hợp trong Bảng 4.2.

Bảng 4.2. So sánh RMSE vị trí

Trường hợp | MBC (m) | PID (m) | Mức giảm của MBC
Danh định | 0.21186 | 0.24495 | 13.51%
Sai lệch tải trọng | 0.22420 | 0.26078 | 14.03%
Nhiễu ngoại lực | 0.22032 | 0.28127 | 21.67%

Có thể nhận thấy MBC cho RMSE vị trí thấp hơn PID trong cả ba trường hợp khảo sát.

Mức chênh lệch nhỏ nhất xuất hiện trong điều kiện danh định, trong khi mức giảm lớn nhất của RMSE toàn quá trình xuất hiện khi có nhiễu ngoại lực.

Tuy nhiên, RMSE toàn quá trình còn chịu ảnh hưởng của giai đoạn quá độ ban đầu do robot bắt đầu cách quỹ đạo 2m. Vì vậy, việc chỉ sử dụng RMSE toàn thời gian chưa phản ánh đầy đủ chất lượng duy trì bám của hệ thống.

### 4.7.2. So sánh sai số góc

RMSE góc của hai bộ điều khiển được tổng hợp trong Bảng 4.3.

Bảng 4.3. So sánh RMSE góc định hướng

Trường hợp | MBC (rad) | PID (rad) | Mức giảm
Danh định | 0.145618 | 0.197455 | 26.25%
Sai lệch tải trọng | 0.159910 | 0.211051 | 24.23%
Nhiễu ngoại lực | 0.169748 | 0.283575 | 40.14%

Tương tự sai số vị trí, MBC cho RMSE góc thấp hơn trong cả ba trường hợp. Sự khác biệt lớn nhất xuất hiện khi robot chịu nhiễu ngoại lực.

Kết quả này cho thấy việc sử dụng mô hình động lực học không chỉ có ảnh hưởng tới khả năng bám vị trí mà còn hỗ trợ duy trì hướng chuyển động trong các trường hợp được khảo sát.

### 4.7.3. Phân tích khả năng duy trì bám khi có nhiễu

Khoảng:

15 s≤t≤20 s là giai đoạn quan trọng nhất trong trường hợp thứ ba.

RMSE vị trí riêng trong khoảng này của MBC là:

0.16437 m, trong khi PID đạt:

0.36588 m⁢. MBC giảm khoảng 55.08⁢% so với PID.

Kết quả cho thấy sự khác biệt giữa hai phương pháp tăng rõ rệt khi đối tượng chịu thêm tác động mà bộ điều khiển không được hiệu chỉnh lại.

Về mặt nguyên lý, MBC sử dụng mô hình động lực học để xác định lực và mô-men cần thiết, do đó có khả năng khai thác tốt hơn thông tin về trạng thái động lực học của robot. Tuy nhiên, việc đánh giá tính bền vững tổng quát cần thêm các mức nhiễu, dạng nhiễu và bất định khác nhau trước khi có thể đưa ra kết luận rộng hơn.

### 4.7.4. Phân tích tín hiệu điều khiển và tốc độ bánh xe

Bên cạnh khả năng bám quỹ đạo, nỗ lực điều khiển là một yếu tố cần được xem xét khi so sánh hai phương pháp.

Có thể nhận thấy MBC yêu cầu tín hiệu điều khiển lớn hơn PID. F_x của MBC đạt giới hạn 100 N.

Tuy nhiên, giá trị trên là cực đại của toàn bộ quá trình mô phỏng. Do hệ thống có sai số vị trí ban đầu 2m, không thể kết luận rằng giá trị bão hòa F_x =100 N xuất phát trực tiếp từ nhiễu trong khoảng 15-20s.

Tốc độ góc bánh xe cực đại trong cùng trường hợp là:

ω_(w,max)^(MBC) =95.273 r⁢a⁢d⁢/⁢s, trong khi:

ω_(w,max)^(PID) =57.877 r⁢a⁢d⁢/⁢s⁢. Như vậy, khả năng bám tốt hơn của MBC trong mô phỏng đi kèm với yêu cầu tác động điều khiển và tốc độ bánh lớn hơn.

Đây là một điểm cần được xem xét khi triển khai trên hệ thống thực, bởi động cơ và bộ truyền động luôn tồn tại giới hạn về mô-men, tốc độ và công suất.

Do mô hình hiện tại chưa bao gồm động lực học điện của động cơ nên các kết quả này chỉ được sử dụng để đánh giá nỗ lực điều khiển, không được diễn giải trực tiếp thành mức tiêu thụ năng lượng.

### 4.7.5. Nhận xét tổng hợp

Từ các kết quả mô phỏng có thể nhận thấy rằng trong cả ba trường hợp được khảo sát, bộ điều khiển MBC/CTC đều cho RMSE vị trí và RMSE góc nhỏ hơn PID.

Trong điều kiện danh định, MBC giảm RMSE vị trí toàn quá trình khoảng 13.51%. Khi plant có sai lệch tham số tải trọng, mức giảm là 14.03%. Khi xuất hiện nhiễu ngoại lực, mức giảm tăng lên 21.67%, và trong riêng khoảng thời gian nhiễu tác động, RMSE vị trí của MBC thấp hơn PID khoảng 55.08%.

Các kết quả trên cho thấy việc đưa thông tin động lực học vào luật điều khiển mang lại lợi ích đối với bài toán bám quỹ đạo trong mô hình đang khảo sát.

Tuy nhiên, kết quả cũng cho thấy MBC yêu cầu tín hiệu điều khiển và tốc độ bánh lớn hơn PID. Bên cạnh đó, MBC phụ thuộc vào độ chính xác của mô hình động lực học, trong khi mô hình hiện tại vẫn là mô hình rút gọn và chưa xét chi tiết động cơ, trượt bánh, ma sát phi tuyến và nhiễu đo.

Do đó, kết luận phù hợp của nghiên cứu không phải là MBC luôn tốt hơn PID, mà là:

Trong các trường hợp, mô hình và bộ thông số được khảo sát, bộ điều khiển dựa trên mô hình động lực học theo nguyên lý CTC cho sai số bám quỹ đạo thấp hơn bộ PID đối chứng, đồng thời duy trì chất lượng bám tốt hơn khi xuất hiện sai lệch tải trọng và nhiễu ngoại lực. Đổi lại, phương pháp yêu cầu nỗ lực điều khiển cao hơn và phụ thuộc nhiều hơn vào độ chính xác của mô hình.

## 4.8. Kết luận

Chương 4 đã xây dựng môi trường mô phỏng trên MATLAB nhằm kiểm chứng và so sánh hai phương pháp điều khiển bám quỹ đạo cho robot Mecanum. Các bộ điều khiển được đánh giá trên cùng mô hình đối tượng, quỹ đạo tham chiếu, điều kiện ban đầu và giới hạn tín hiệu nhằm bảo đảm tính thống nhất của phép so sánh.

Ba trường hợp khảo sát bao gồm điều kiện danh định, sai lệch tham số tải trọng và tác động của nhiễu ngoại lực. Kết quả cho thấy MBC/CTC đạt RMSE vị trí thấp hơn PID lần lượt khoảng 13,51%, 14,03% và 21,67% trong ba trường hợp. Đặc biệt, trong khoảng thời gian nhiễu tác động, RMSE vị trí của MBC thấp hơn PID khoảng 55.08%.

Kết quả về sai số góc cũng cho xu hướng tương tự, khi MBC duy trì RMSE góc thấp hơn PID trong toàn bộ các trường hợp. Đồng thời, kết quả sau giai đoạn quá độ cho thấy sự khác biệt về khả năng duy trì bám rõ ràng hơn so với khi chỉ đánh giá RMSE trên toàn bộ quá trình.

Mặt khác, MBC yêu cầu lực điều khiển và tốc độ bánh lớn hơn PID. Điều này cho thấy việc nâng cao chất lượng bám có thể đi kèm với yêu cầu cao hơn đối với cơ cấu chấp hành. Đây là yếu tố cần được cân nhắc khi triển khai thuật toán trên robot thực.

# CHƯƠNG 5. KẾT LUẬN VÀ HƯỚNG PHÁT TRIỂN

## 5.1. Kết quả đạt được

Đề tài tập trung nghiên cứu phương pháp điều khiển dựa trên mô hình động lực học cho robot di động bốn bánh Mecanum trong bài toán bám quỹ đạo. Trên cơ sở mục tiêu đã đặt ra, nghiên cứu đã hoàn thành các nội dung chính gồm xây dựng mô hình động học, mô hình động lực học rút gọn, thiết kế bộ điều khiển dựa trên mô hình theo nguyên lý Computed Torque Control, xây dựng bộ PID đối chứng và thực hiện đánh giá bằng mô phỏng trên MATLAB.

Trước hết, mô hình động học của robot Mecanum bốn bánh đã được xây dựng trên cơ sở mối quan hệ giữa vận tốc thân robot và tốc độ góc của từng bánh. Hai hệ tọa độ gồm hệ tọa độ toàn cục và hệ tọa độ gắn với thân robot được sử dụng để mô tả trạng thái chuyển động. Quan hệ chuyển đổi giữa hai hệ tọa độ được thiết lập thông qua ma trận quay, từ đó cho phép biểu diễn đồng thời chuyển động tịnh tiến theo hai phương và chuyển động quay của robot.

Bên cạnh mô hình động học, nghiên cứu đã xây dựng mô hình động lực học rút gọn ba bậc tự do dưới dạng:

M⁢ν+C(ν)ν+D⁢ν=τ⁢. Mô hình xem xét ảnh hưởng của khối lượng, mô-men quán tính, thành phần liên kết động lực học và lực cản. Đây là cơ sở để hình thành bộ điều khiển sử dụng trực tiếp thông tin động lực học thay vì chỉ dựa trên sai số bám.

Trên cơ sở mô hình trên, bộ điều khiển dựa trên mô hình động lực học được xây dựng theo nguyên lý bù của Computed Torque Control. Thuật toán tạo vận tốc tham chiếu từ quỹ đạo mong muốn và sai số vị trí, sau đó xây dựng gia tốc điều khiển từ sai số vận tốc. Lực và mô-men điều khiển cuối cùng được xác định thông qua:

τ_(MBC) =M⁢ν_c +C(ν)ν+D⁢ν⁢. Song song với phương pháp MBC/CTC, một bộ điều khiển PID được xây dựng làm phương pháp đối chứng. Các hệ số PID được hiệu chỉnh trước khi tiến hành các phép so sánh chính thức nhằm hạn chế việc kết quả bị chi phối bởi một bộ thông số PID chưa phù hợp. Đây là yếu tố quan trọng để bảo đảm tính khách quan tương đối của quá trình đánh giá.

Môi trường mô phỏng được xây dựng trên MATLAB theo cấu trúc module, trong đó các thành phần như tham số, quỹ đạo, bộ điều khiển, mô hình động lực học và quá trình mô phỏng được tách thành các hàm riêng biệt. Cách tổ chức này giúp thuận tiện cho việc kiểm tra, thay đổi tham số và mở rộng nghiên cứu. Cấu trúc chương trình của đề tài cũng đã được phân chia tương ứng giữa các file tham số, quỹ đạo, MBC/CTC, PID, động lực học và khối tổng hợp kết quả.

Ba trường hợp khảo sát đã được thực hiện gồm điều kiện danh định, sai lệch tham số tải trọng và tác động của nhiễu ngoại lực. Cách xây dựng này phù hợp với mục tiêu của đề tài là không chỉ đánh giá hệ thống trong điều kiện mô hình lý tưởng mà còn xem xét chất lượng bám khi mô hình plant khác với mô hình danh định hoặc khi hệ chịu thêm tác động bên ngoài.

Trong điều kiện danh định, RMSE vị trí toàn quá trình của MBC đạt:

R⁢M⁢S⁢E_(MBC) =0.21186 m, trong khi PID đạt:

R⁢M⁢S⁢E_(PID) =0.24495 m⁢. Như vậy, MBC giảm RMSE vị trí khoảng: 13.51%

Trong trường hợp sai lệch tải trọng, plant được thay đổi từ khối lượng danh định 10kg lên 15kg, đồng thời mô-men quán tính được thay đổi tương ứng từ 0.8 lên 1.2 k⁢g⁢.⁢m^2 . MBC đạt:

R⁢M⁢S⁢E_(MBC) =0.22420 m, trong khi PID đạt:

R⁢M⁢S⁢E_(PID) =0.26078 m⁢. Mức giảm RMSE tương ứng đạt khoảng:

14.03⁢%. Trong trường hợp có nhiễu ngoại lực, MBC đạt:

R⁢M⁢S⁢E_(MBC) =0.22032 m, trong khi PID đạt:

R⁢M⁢S⁢E_(PID) =0.28127 m⁢. Mức giảm RMSE toàn quá trình đạt khoảng:

21.67⁢%. Đáng chú ý, trong riêng khoảng thời gian nhiễu tác động từ 15s đến 20s, RMSE vị trí của MBC là:

0.16437 m, so với:

0.36588 m của PID, tương ứng mức giảm khoảng:

55.08⁢%. Kết quả sai số góc cũng cho xu hướng tương tự. RMSE góc của MBC thấp hơn PID trong cả ba trường hợp khảo sát. Điều này cho thấy ưu điểm của phương pháp dựa trên mô hình không chỉ thể hiện ở khả năng bám vị trí mà còn ở khả năng duy trì góc định hướng theo quỹ đạo đặt.

Ngoài RMSE toàn quá trình, nghiên cứu còn phân tích RMSE sau giai đoạn quá độ t≥5 s . Kết quả cho thấy sự khác biệt giữa hai bộ điều khiển rõ hơn sau khi robot đã tiếp cận quỹ đạo. Điều này cũng chỉ ra rằng điều kiện ban đầu có ảnh hưởng đáng kể đến RMSE toàn thời gian và cần được xem xét khi diễn giải kết quả.

Tuy nhiên, kết quả mô phỏng đồng thời cho thấy MBC yêu cầu tín hiệu điều khiển và tốc độ bánh lớn hơn PID. Do đó, ưu thế về độ chính xác bám không đồng nghĩa với việc phương pháp luôn có ưu thế ở mọi tiêu chí. Khi triển khai thực tế, khả năng đáp ứng của động cơ và bộ truyền động cần được xem xét cùng với chất lượng bám quỹ đạo.

Từ các kết quả trên có thể nhận xét rằng, trong phạm vi mô hình, bộ tham số và các trường hợp khảo sát của đề tài, bộ điều khiển dựa trên mô hình động lực học theo nguyên lý CTC cho chất lượng bám quỹ đạo tốt hơn bộ điều khiển PID đối chứng về RMSE vị trí và RMSE góc. Kết quả bước đầu cho thấy việc khai thác trực tiếp thông tin động lực học trong luật điều khiển là một hướng tiếp cận có hiệu quả đối với bài toán bám quỹ đạo robot Mecanum.

## 5.2. Hạn chế của nghiên cứu

Mặc dù các kết quả mô phỏng cho thấy bộ điều khiển MBC/CTC có khả năng cải thiện chất lượng bám trong các trường hợp được khảo sát, nghiên cứu hiện tại vẫn tồn tại một số hạn chế.

Thứ nhất, mô hình động lực học được sử dụng là mô hình rút gọn ba bậc tự do. Robot được xem như một vật rắn chuyển động trên mặt phẳng ngang, trong khi nhiều yếu tố thực tế như dao động cơ khí, biến dạng bánh xe và phân bố tải không đồng đều chưa được mô tả chi tiết. Đây phù hợp với phạm vi ban đầu của đề tài, trong đó động lực học điện của động cơ, phi tuyến động cơ, biến dạng bánh, trượt phi tuyến, nhiễu cảm biến và sai số chế tạo đều chưa được xét.

Thứ hai, lực và mô-men của bốn bánh hiện chưa được mô hình hóa độc lập. Tín hiệu điều khiển được biểu diễn dưới dạng vector lực và mô-men tổng quát:

τ=[F_x F_y M_z ], thay vì mô-men riêng của từng động cơ. Do đó, mô hình chưa phản ánh đầy đủ giới hạn mô-men, đặc tính cơ điện và sự phân phối lực giữa bốn bánh.

Thứ ba, hiện tượng trượt của bánh Mecanum chưa được mô hình hóa chi tiết. Mô hình động học sử dụng giả thiết chuyển động tương đối lý tưởng, trong khi thực tế các con lăn Mecanum có thể gây trượt và tổn hao phụ thuộc tải trọng, vật liệu bánh và điều kiện bề mặt. Điều này có thể tạo ra sự khác biệt đáng kể giữa kết quả mô phỏng và kết quả thực nghiệm.

Thứ tư, ma sát trong nghiên cứu được mô hình hóa bằng thành phần cản tuyến tính. Trong hệ thống thực tế, ma sát có thể bao gồm ma sát Coulomb, ma sát nhớt, ma sát tĩnh và các hiện tượng phi tuyến khác. Vì vậy, ma trận D hiện tại mới chỉ phản ánh gần đúng một phần ảnh hưởng của lực cản.

Thứ năm, thành phần gia tốc feedforward trong bộ điều khiển MBC được xây dựng theo dạng đơn giản hóa. Quan hệ đầy đủ giữa gia tốc trong hệ tọa độ toàn cục và hệ tọa độ thân có chứa thành phần phụ thuộc vào đạo hàm ma trận quay. Thành phần này chưa được xét đầy đủ trong thuật toán hiện tại và có thể được cải tiến trong các nghiên cứu tiếp theo.

Thứ sáu, các tham số như khối lượng, mô-men quán tính và hệ số cản đang được lựa chọn phục vụ mục tiêu mô phỏng và chưa được xác định từ một nền tảng robot thực cụ thể. Vì vậy, kết quả của nghiên cứu nên được xem là đánh giá trong môi trường mô phỏng, chưa phải là bằng chứng thực nghiệm về hiệu năng trên một robot Mecanum vật lý.

Thứ bảy, nghiên cứu mới sử dụng một quỹ đạo tròn làm quỹ đạo tham chiếu chính. Quỹ đạo này phù hợp để đánh giá bước đầu khả năng chuyển động đồng thời theo x, y và θ , nhưng chưa phản ánh đầy đủ các tình huống thay đổi hướng nhanh hoặc gia tốc góc phức tạp.

Thứ tám, ảnh hưởng của nhiễu hiện mới được khảo sát bằng một vector lực và mô-men xác định trong một khoảng thời gian cụ thể. Do đó, chưa thể từ kết quả hiện tại kết luận bộ điều khiển có tính bền vững với mọi dạng nhiễu.

Cuối cùng, nghiên cứu chưa thực hiện thử nghiệm trên robot thực. Đây là hạn chế quan trọng nhất bởi hiệu năng của một thuật toán điều khiển khi triển khai thực tế còn chịu ảnh hưởng của sai số cảm biến, trễ tính toán, giới hạn driver, sai số cơ khí, độ trễ động cơ và điều kiện mặt sàn.

## 5.3. Hướng phát triển

Từ những hạn chế trên, nghiên cứu có thể được tiếp tục theo một số hướng nhằm nâng cao mức độ hoàn thiện của mô hình và bộ điều khiển.

Trước hết, mô hình động lực học có thể được mở rộng từ vector lực tổng quát sang mô hình mô-men của từng bánh xe. Khi đó, tín hiệu điều khiển có thể được phân phối trực tiếp tới bốn động cơ:

τ_w =[τ_1 τ_2 τ_3 τ_4 ]⁢. Việc xây dựng quan hệ giữa mô-men bánh xe và lực tổng quát của thân robot sẽ giúp mô hình sát hơn với cấu trúc cơ khí của nền tảng Mecanum.

Tiếp theo, cần bổ sung mô hình động cơ. Đối với động cơ điện, có thể xét đồng thời phương trình điện và phương trình cơ học nhằm mô tả quan hệ giữa điện áp, dòng điện, mô-men và tốc độ. Khi có mô hình này, nghiên cứu có thể đánh giá thêm công suất và năng lượng tiêu thụ thay vì chỉ sử dụng tín hiệu lực, mô-men và tốc độ bánh làm chỉ tiêu gián tiếp.

Một hướng quan trọng khác là xây dựng mô hình trượt bánh Mecanum. Hệ số trượt có thể được mô tả theo tải trọng, vận tốc và đặc tính tiếp xúc bánh – mặt sàn. Việc bổ sung mô hình này sẽ cho phép đánh giá rõ hơn ảnh hưởng của trượt tới sai số định vị và chất lượng bám quỹ đạo.

Về thuật toán điều khiển, bộ điều khiển MBC có thể được cải tiến bằng cách sử dụng đầy đủ quan hệ chuyển đổi gia tốc giữa hệ tọa độ toàn cục và hệ tọa độ thân. Việc bổ sung thành phần liên quan tới giúp mô hình điều khiển phù hợp hơn về mặt toán học, đặc biệt đối với các quỹ đạo có vận tốc góc và gia tốc góc thay đổi nhanh.

Bên cạnh đó, có thể mở rộng khảo sát sang các quỹ đạo phức tạp hơn, chẳng hạn quỹ đạo hình số 8, quỹ đạo chữ S hoặc quỹ đạo có các đoạn thay đổi độ cong. So với quỹ đạo tròn, các dạng quỹ đạo này tạo ra sự thay đổi liên tục của vận tốc và gia tốc, qua đó giúp đánh giá rõ hơn đặc tính của bộ điều khiển.

Để nâng cao khả năng làm việc khi tham số robot thay đổi, có thể nghiên cứu các phương pháp điều khiển thích nghi. Trong trường hợp tải trọng chưa biết trước, thuật toán ước lượng tham số online có thể được tích hợp với MBC nhằm cập nhật khối lượng và mô-men quán tính trong quá trình vận hành.

Một hướng khác là bổ sung mô hình cảm biến và bộ ước lượng trạng thái. Trong robot thực, vị trí và vận tốc thường không được đo hoàn toàn chính xác mà được xác định từ encoder, IMU, camera hoặc LiDAR. Do đó, các bộ lọc như Kalman Filter hoặc Extended Kalman Filter có thể được tích hợp nhằm giảm ảnh hưởng của nhiễu đo.

Cuối cùng, hướng phát triển quan trọng nhất là triển khai thuật toán trên robot Mecanum thực. Một nền tảng thử nghiệm có thể bao gồm bốn động cơ độc lập, encoder, IMU, vi điều khiển hoặc máy tính nhúng và hệ thống định vị ngoài. Kết quả thực nghiệm cần được đối chiếu với mô phỏng để đánh giá mức độ chính xác của mô hình, xác định các tham số thực và kiểm chứng khả năng ứng dụng của thuật toán.

## 5.4. Kết luận chung

Đề tài đã xây dựng được một quy trình nghiên cứu tương đối hoàn chỉnh cho bài toán điều khiển bám quỹ đạo robot Mecanum, bắt đầu từ mô hình động học, mô hình động lực học, thiết kế bộ điều khiển, xây dựng bộ điều khiển đối chứng, mô phỏng và đánh giá định lượng.

Kết quả mô phỏng cho thấy trong các điều kiện khảo sát, việc đưa mô hình động lực học vào luật điều khiển giúp giảm sai số bám so với PID đối chứng. Mức cải thiện thể hiện rõ hơn trong trường hợp robot chịu nhiễu ngoại lực, trong khi trường hợp sai lệch tải trọng cho thấy MBC vẫn duy trì được chất lượng bám trong phạm vi sai lệch được lựa chọn.

Tuy nhiên, phương pháp cũng thể hiện sự phụ thuộc vào độ chính xác của mô hình và yêu cầu tín hiệu điều khiển lớn hơn. Do đó, để có thể triển khai trên robot thực, cần tiếp tục hoàn thiện mô hình, xem xét giới hạn cơ cấu chấp hành, trượt bánh, động lực học động cơ và sai số cảm biến.

Nghiên cứu đã đạt được mục tiêu đặt ra là xây dựng và đánh giá phương pháp điều khiển dựa trên mô hình động lực học cho robot Mecanum trong bài toán bám quỹ đạo, đồng thời làm rõ sự khác biệt của phương pháp này so với bộ điều khiển PID trong các điều kiện mô phỏng khác nhau. Kết quả đạt được là cơ sở để tiếp tục phát triển các phương pháp điều khiển thích nghi, bền vững và tối ưu, cũng như triển khai kiểm chứng trên nền tảng robot thực trong các nghiên cứu tiếp theo.
