HoangAnh301194/Industrial_AMR_Robot/main.pdf

Báo cáo nghiên cứu khoa học

## HỌC VIỆN CÔNG NGHỆ BƯU CHÍNH VIỄN THÔNG

Khoa Kĩ thuật Điện tử 1

## MAMBA

### MÔ HÌNH HÓA CHUỖI THỜI GIAN TUYẾN TÍNH VỚI KHÔNG GIAN TRẠNG THÁI CHỌN LỌC

Phân tích bài báo Mamba: Linear-Time Sequence Modeling with Selective State Spaces

Sinh viên thực hiện: | Nguyễn Hữu Hoàng Anh
Hướng nghiên cứu: | Action Recognition trên thiết bị biên
Tác giả bài báo: | Albert Gu, Tri Dao
Mã bài báo: | arXiv:2312.00752

Hà Nội, tháng 07 năm 2026

## Nội dung trình bày

1 | Bối cảnh nghiên cứu | Hạn chế của dense attention và yêu cầu mô hình hóa chuỗi dài.

### 2 Nền tảng Selective

| SSM | SSM, giả thiết LTI, cơ chế chọn lọc và thuật toán S4–S6.
3 | Triển khai hiệu quả | Selective scan tối ưu phần cứng và kiến trúc Mamba.

### 4 Bằng chứng thực

| nghiệm | Bài toán tổng hợp, kết quả đa miền và hiệu quả tính toán.

### 5 Liên hệ và triển khai

NCKH

Mức độ phù hợp, pipeline YOLO pose–TensorRT và kết quả bước đầu trên Jetson.

## 1. Bối cảnh nghiên cứu: Hai cơ chế lưu trữ ngữ cảnh

SSM–LTI: nén lịch sử vào trạng thái ẩn

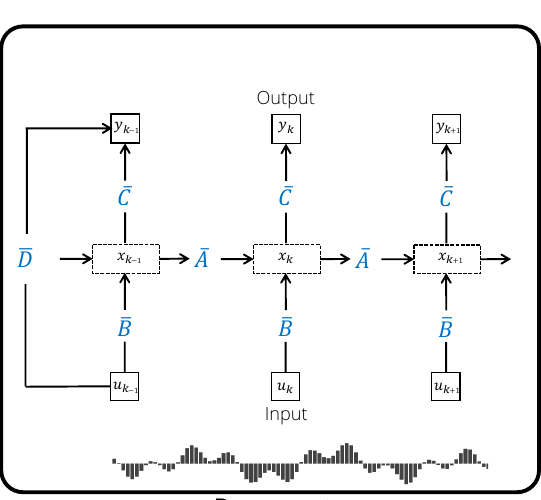
[picture p69: figure]

ht = Ah¯ t−1 + Bx ¯ t, yt = Cht + Dxt

- ht ∈ R

N
có kích thước cố định, tóm tắt toàn bộ lịch sử x1:t; các token cũ không được giữ riêng.
- A¯, B¯, C, D không đổi theo t: hệ tuyến tính bất biến theo thời gian; tính toán tăng theo O(L).

Self-attention: lưu KV của toàn bộ token

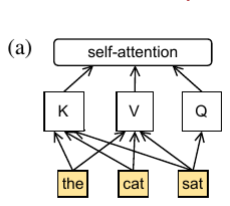
[picture p70: figure]

KVCachet = [(K1, V1), . . . , (Kt, Vt )] yt = softmax
QtKT
1:t √
dk

V1:t

- Query hiện tại Qt so khớp với mọi Ki, sau đó tổng hợp thông tin từ toàn bộ Vi.
- KV cache tăng theo độ dài ngữ cảnh; khi huấn luyện, QKT ∈ R

L×L
tạo chi phí O(L

2
).

## 1. Bối cảnh nghiên cứu: Hạn chế và mục tiêu

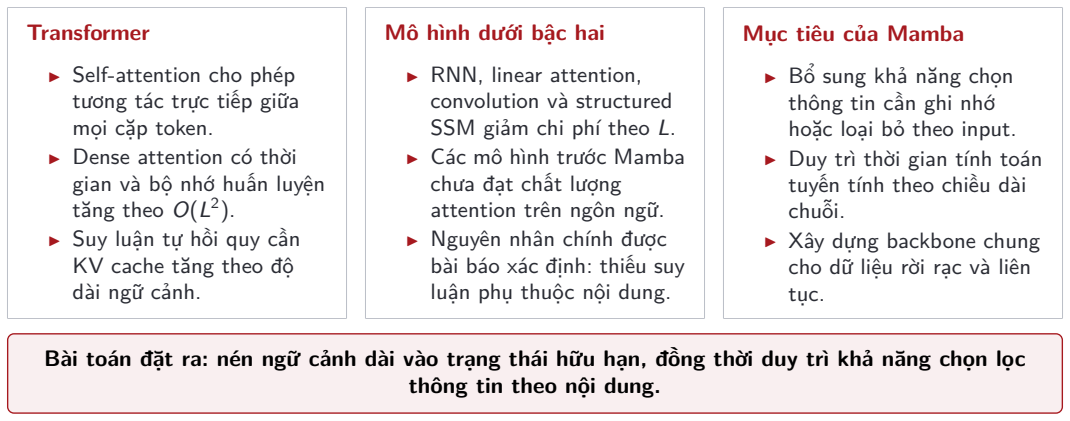
[picture p71: figure]
Transformer; ▶ Self-attention cho phép tương tác trực tiếp giữa mọi cặp token. ▶ Dense attention có thời gian và bộ nhớ huấn luyện tăng theo O(L; ). ▶ Suy luận tự hồi quy cần KV cache tăng theo độ dài ngữ cảnh.; Mô hình dưới bậc hai; ▶ RNN, linear attention, convolution và structured SSM giảm chi phí theo L. ▶ Các mô hình trước Mamba chưa đạt chất lượng attention trên ngôn ngữ. ▶ Nguyên nhân chính được bài báo xác định: thiếu suy luận phụ thuộc nội dung.; Mục tiêu của Mamba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

Bài toán đặt ra: nén ngữ cảnh dài vào trạng thái hữu hạn, đồng thời duy trì khả năng chọn lọc

## 2. Tổng quan Selective State Space Model

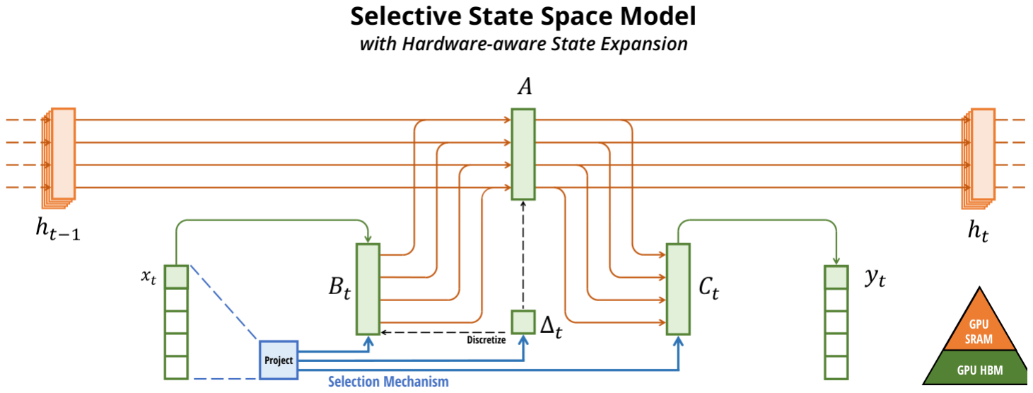
[picture p72: figure]

Selection trong mô hình trạng thái

Input xt sinh Bt, Ct, ∆t. State ht nén lịch sử; Bt điều khiển ghi, Ct điều khiển đọc, ∆tA điều khiển chuyển trạng thái.

Thiết kế phù hợp phần cứng

State expansion được tạo và xử lý trong SRAM; HBM chỉ lưu input, tham số cần thiết và output. Mục tiêu là giảm memory I/O của recurrence.

## 3. Nền tảng SSM: Từ hệ liên tục đến chuỗi rời rạc

Vì sao cần rời rạc hóa?

SSM xuất phát từ hệ động lực liên tục theo thời gian. Trong mạng nơ-ron, dữ liệu được đưa vào theo từng token hoặc frame, nên state phải được cập nhật tại các bước rời rạc.
h

′
(t) = Ah(t) + Bx(t), | y(t) = Ch(t)
⇓ | lấy mẫu với bước ∆
ht = Aht−1 + Bxt, | yt = Cht

Với zero-order hold: A = exp(∆A); B tích lũy tác động của input trong khoảng thời gian ∆.

Hai cách tính sau khi rời rạc hóa

Khi ∆, A, B, C cố định theo timestep, cùng một hệ rời rạc có hai cách triển khai tương đương:

Dạng | Vai trò | Chi phí
Recurrence | Suy luận tuần tự, state cố định. | O(1)/bước
Convolution | Huấn luyện song song bằng kernel toàn cục. | O(L log L)

Ý nghĩa của rời rạc hóa: chuyển động lực học liên tục thành recurrence chạy một lần tại mỗi token/frame. ∆ xác định lượng thời gian liên tục tương ứng với một bước chuỗi; giả thiết LTI giữ quy tắc chuyển state không đổi giữa các bước.

## 4. Selection như một cơ chế nén ngữ cảnh

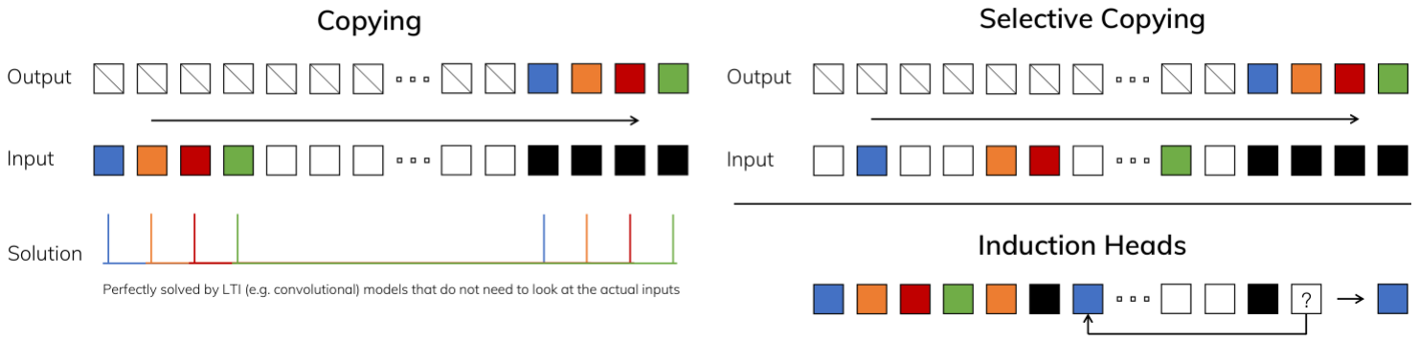
[picture p73: figure]

Selective Copying

Vị trí token cần nhớ thay đổi giữa các token nhiễu. State phải chọn thông tin để ghi theo nội dung; LTI/convolution cố định không thể chỉ dựa vào khoảng cách.

Induction Heads

Khi cặp [A, B] đã xuất hiện, gặp lại A phải truy hồi B. Bài toán kiểm tra associative recall và khả năng truy xuất thông tin trong ngữ cảnh dài.

## 5. Thuật toán S4 và Selective SSM S6

Algorithm 1: SSM (S4)

Input | x : (B, L, D)
Parameters | A : (D, N), B : (D, N), C : (D, N), ∆ :
(D)
Discretize | A, B : (D, N) ← discretize(∆, A, B)
Transform | y : (B, L, D) ← SSM(A, B, C)(x)
Return | y

Tham số không có chiều L; lớp là LTI và có thể tính bằng global convolution.

Algorithm 2: SSM + Selection (S6)

Input | x : (B, L, D)
Parameter | A : (D, N)
Selection | B : (B, L, N) ← sB (x)
| C : (B, L, N) ← sC (x)
| ∆ : (B, L, D) ← τ∆(Param + s∆(x))
Discretize | A, B : (B, L, D, N)
Transform | y : (B, L, D) ← SSM(A, B, C)(x)

Tham số có chiều L; lớp trở thành time-varying và phải được tính bằng recurrence/scan.

## 6. Cơ chế vận hành của Selective SSM

Vai trò của ∆t

Với N = 1, A = −1, B = 1, selective SSM rút gọn thành recurrence có gate:

gt = σ(Linear(xt))

ht = (1 − gt)ht−1 + gtxt

- ∆t nhỏ: duy trì state, giảm ảnh hưởng của input hiện tại.
- ∆t lớn: tập trung vào input hiện tại, làm mờ state trước đó.

Vai trò của Bt, Ct và A

- Bt điều khiển cách input xt được ghi vào state ht.
- Ct điều khiển phần thông tin trong state được đọc thành output yt.
- A không cần selective vì selectivity đã đi vào At = exp(∆tA).
- Kết hợp ∆t,Bt, Ct cho phép context filtering và boundary resetting.

Selection không chỉ là phép nhân gate trong kiến trúc; nó trực tiếp thay đổi động lực học lan truyền state dọc chiều thời gian.

## 7. Thuật toán selective scan tối ưu phần cứng

Thách thức triển khai

- Selection phá vỡ dạng global convolution của S4.
- Recurrence mở rộng state thành tensor (B, L, D, N).
- Materialize state trong HBM tạo chi phí memory I/O lớn.
- Recurrence cần được song song hóa để khai thác GPU.

Mục tiêu triển khai: giữ tensor mở rộng trong SRAM và chỉ ghi output (B, L, D) về HBM.

Thiết kế của bài báo

Kỹ thuật | Cách thực hiện | Tác động
Kernel fusion | Fuse discretization, scan và pro- jection Ct trong một GPU kernel; state expansion nằm trong SRAM. | Giảm đọc/ghi HBM.
Parallel scan | Dùng toán tử kết hợp để tổ chức recurrence theo cây song song. | Công việc O(L), khai thác GPU.
Recomputation | Tính lại state trong backward thay vì lưu toàn bộ activation. | Giảm bộ nhớ huấn luyện.

## 8. Kiến trúc Mamba

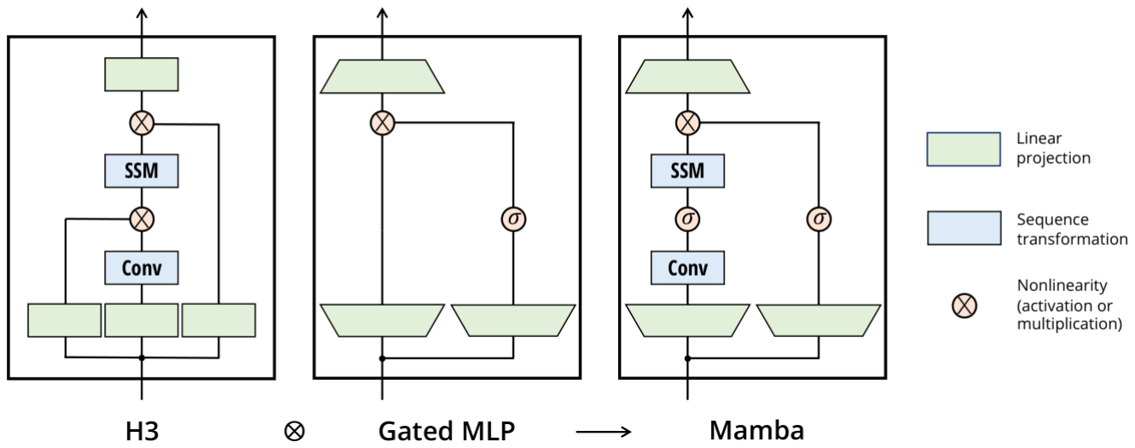
[picture p74: figure]

Mamba kết hợp H3-style sequence transformation và gated MLP thành một block duy nhất; expansion factor mặc định E = 2, state dimension thường

## 9. Bằng chứng trên các bài toán tổng hợp

Selective Copying

Architecture | Layer | Acc.
No gate | S4 | 18.3
H3 | S4 | 57.0
H3 | Hyena | 30.1
H3 | S6 | 99.7
Mamba | S6 | 99.8

Kết quả tách biệt ảnh hưởng của architectural gating và selection: thay S4 bằng S6 tạo cải thiện quyết định.

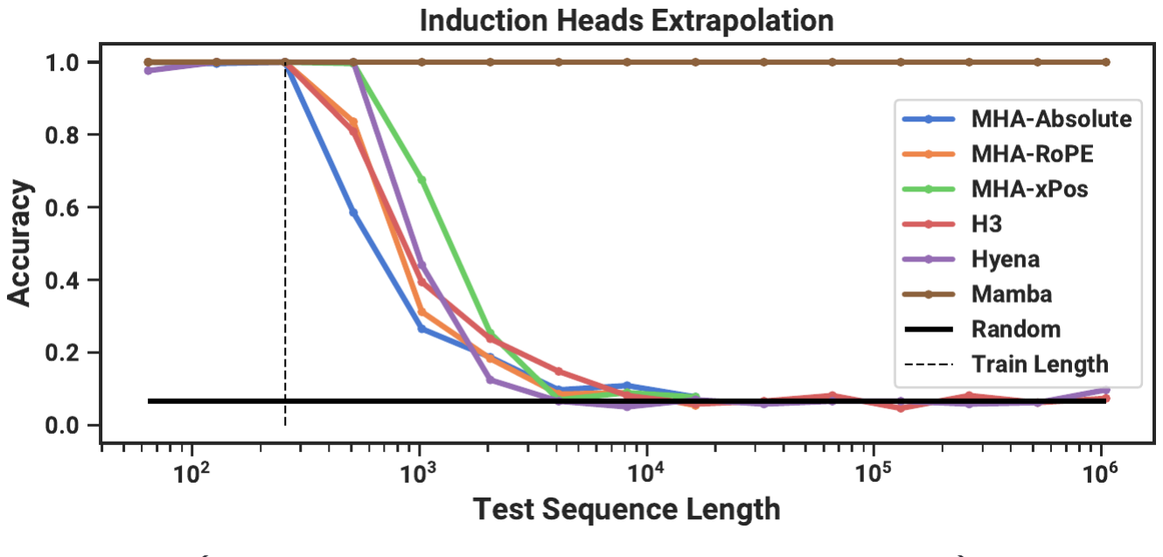
[picture p75: figure]

Mô hình huấn luyện tại L = 256. Mamba duy trì accuracy gần hoàn hảo tới L = 2

20, trong khi H3, Hyena và các biến thể attention suy giảm hoặc bị giới hạn bộ nhớ.

## 10. So sánh Mamba và các kiến trúc khác

Miền dữ liệu | Thiết lập chính | Kết quả của Mamba | Ý nghĩa kiến trúc
Language mod- eling | The Pile; mô hình tới 2.8B tham số | Mamba-2.8B đạt average 63.3 trên 6 benchmark, vượt Pythia-2.8B và RWKV-3B. | Selection khắc phục điểm yếu của LTI SSM trên token rời rạc.
DNA | HG38; context từ 2¹⁰ tới 2²⁰ | Perplexity tiếp tục cải thiện tới khoảng một triệu base pair; vượt HyenaDNA theo context. | State chọn lọc khai thác ngữ cảnh rất dài thay vì tích lũy nhiễu.
Audio | YouTubeMix và SC09 waveform | Pretraining cải thiện tới gần một triệu sample; FID SC09 đạt 0.67 ở mô hình 24.3M. | Mamba vẫn hiệu quả trên modality liên tục, nhưng tồn tại đánh đổi LTI–selective.

Đối với video, các kết quả này chỉ chứng minh năng lực backbone chuỗi tổng quát; bài báo chưa đánh giá trực tiếp action recognition hoặc triển khai edge.

## 11. Hiệu quả tính toán và khả năng triển khai

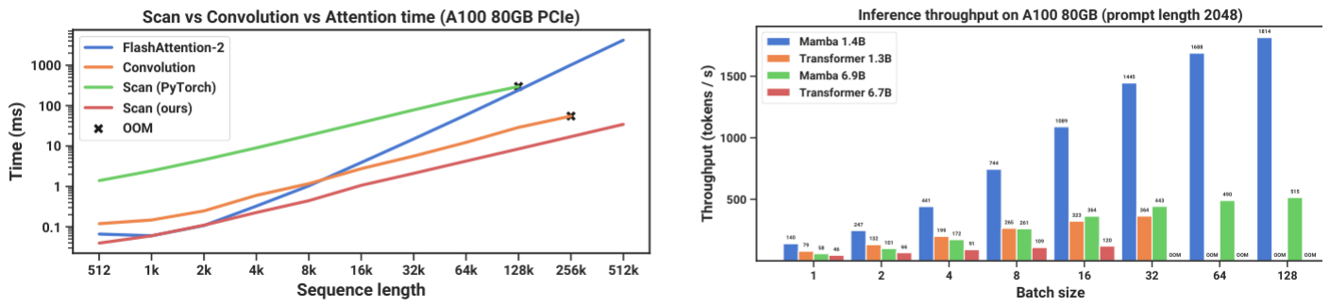
[picture p76: figure]

Các số liệu trên đo trên NVIDIA A100 80GB; không thể suy ra trực tiếp latency trên Jetson, NPU hoặc CPU edge.

## 12. Mức độ phù hợp với bài toán Action Recognition

Giới hạn từ bài báo

- Quy mô language model đánh giá tối đa khoảng 3B tham số.
- Hệ sinh thái fine-tuning, quantization và adaptation chưa được khảo sát hệ thống.
- Selection có thể làm suy yếu inductive bias liên tục mà LTI SSM vốn khai thác tốt.
- Benchmark hiệu quả thực hiện trên GPU A100, không phải thiết bị biên.

Khoảng trống đối với video

- Mamba chỉ mô hình hóa chuỗi feature; thông tin không gian vẫn cần CNN hoặc ViT backbone.
- Nén toàn bộ lịch sử vào state hữu hạn có thể mất chi tiết chuyển động ngắn hạn.
- Offline recognition có thể cần ngữ cảnh hai chiều; selective scan gốc mang tính causal.
- Kernel tối ưu của Mamba có thể không sẵn có trên NPU, TensorRT hoặc CPU edge.

## 13. Kết luận

Đóng góp mô hình hóa

Tham số chọn lọc
Bt, Ct, ∆t = s(xt ); dynamics nền A vẫn cố định.

Cơ chế ghi–giữ–đọc
∆t điều khiển mức cập nhật; Bt ghi input vào state; Ct đọc state để tạo output.

Kết quả
State trở thành bộ nhớ phụ thuộc nội dung; selection giải quyết bài toán sao chép chọn lọc và khái quát induction sang chuỗi dài hơn huấn luyện.

Đóng góp thuật toán

Fused selective scan
Hợp nhất rời rạc hóa, scan và phép chiếu; giữ state expansion trong SRAM để giảm trao đổi HBM.

Song song và bộ nhớ
Parallel scan giữ công việc tuyến tính theo L; recomputation giảm activation memory; suy luận dùng state cố định, không cần KV cache tăng theo ngữ cảnh.

Kiến trúc và đánh giá

Mamba block
Short Conv1D, SiLU, selective SSM và multiplicative gate được hợp nhất trong residual block đồng nhất, không sử dụng attention.

Kết quả benchmark
Kết quả mạnh trên language, DNA, audio và tác vụ tổng hợp cần chọn lọc ngữ cảnh dài.

Phạm vi
Mô hình dưới khoảng 3B tham số, đo hiệu quả trên A100; chưa đánh giá trực tiếp video, Action Recognition hoặc thiết bị biên.

## 14. Tiến độ triển khai phát hiện người cần phục vụ cho robot

So sánh mô hình nano pose

Chỉ số | YOLOv8n- pose
YOLO26n-pose

Thay đổi

COCO pose

mAP50:95

| 50.4 | 57.2 | +6.8 điểm
Tham số | 3.3 M | 2.9 M | −12%
FLOPs tại 640 px | 9.2 B | 7.5 B | −18%

YOLO26n-pose thay YOLOv8n-pose vì đạt độ chính xác cao hơn với ít

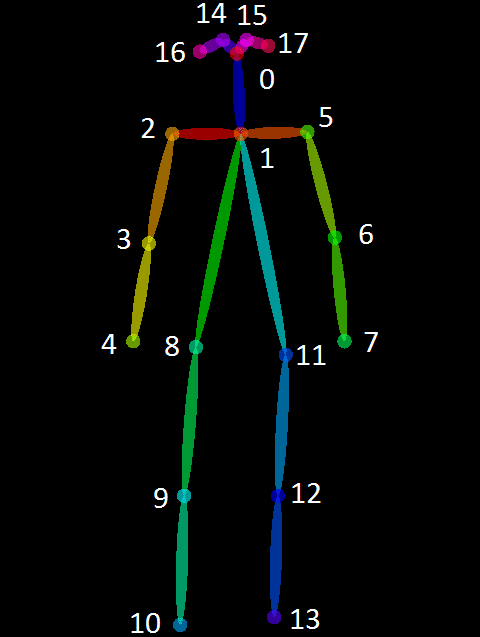
[picture p77: figure]

Sơ đồ keypoint dùng để minh họa skeleton và kiểm tra điều kiện vẫy tay của người mục tiêu.

→ Jetson run → Skeleton → Check wave condition

## 15. Tiến độ triển khai phát hiện người cần phục vụ cho robot

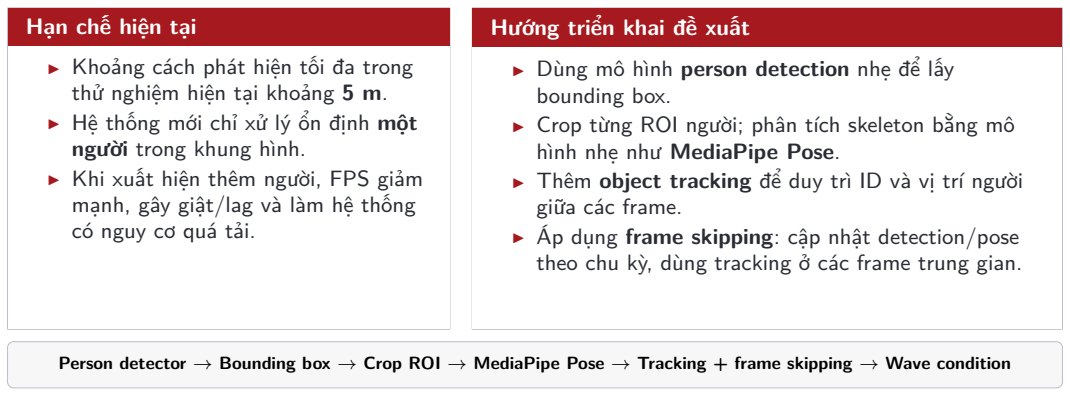
[picture p78: figure]
Hạn chế hiện tại; ▶ Khoảng cách phát hiện tối đa trong thử nghiệm hiện tại khoảng 5 m. ▶ Hệ thống mới chỉ xử lý ổn định một; người trong khung hình. ▶ Khi xuất hiện thêm người, FPS giảm mạnh, gây giật/lag và làm hệ thống có nguy cơ quá tải.; Hướng triển khai đề xuất; bounding box.; hình nhẹ như MediaPipe Pose.; giữa các frame.

- Dùng mô hình person detection nhẹ để lấy
- Crop từng ROI người; phân tích skeleton bằng mô
- Thêm object tracking để duy trì ID và vị trí người
- Áp dụng frame skipping: cập nhật detection/pose theo chu kỳ, dùng tracking ở các frame trung gian.

Person detector → Bounding box → Crop ROI → MediaPipe Pose → Tracking + frame skipping → Wave condition
