HoangAnh301194/Industrial_AMR_Robot/docs/images/docs/images/amr_exploded_iso.png

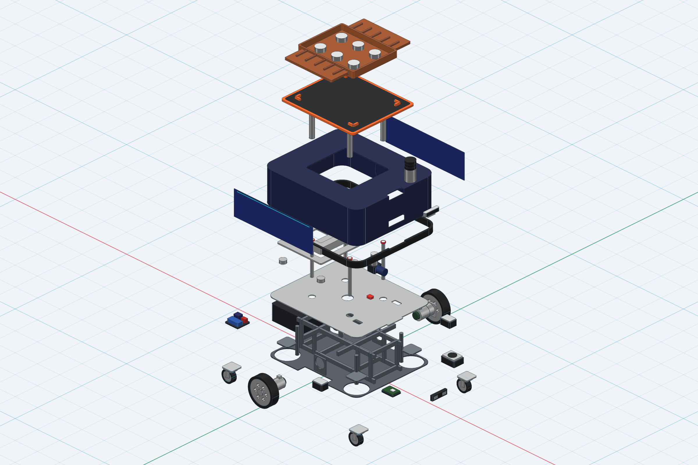
docs/images/docs/images/amr_exploded_iso.png
