HoangAnh301194/Industrial_AMR_Robot/docs/images/docs/images/fig_2_1_system_architecture.png

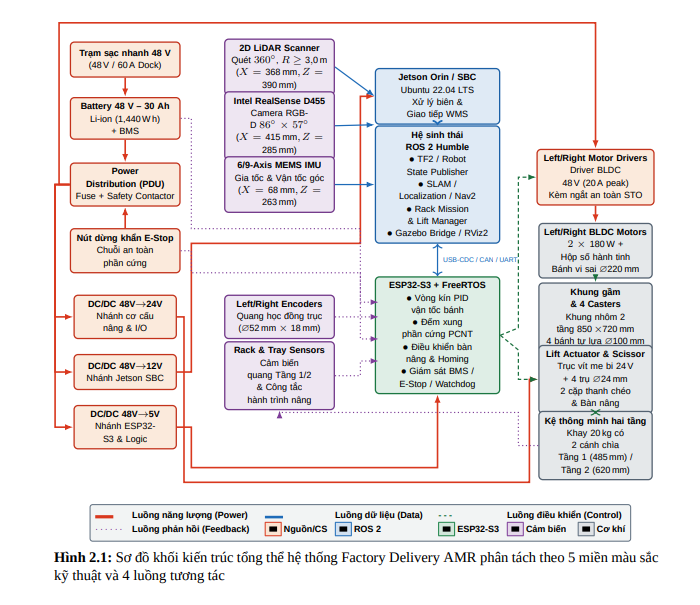
docs/images/docs/images/fig_2_1_system_architecture.png
