HoangAnh301194/Industrial_AMR_Robot/docs/images/docs/images/fig_5_1_scissor_lift_geometry.png

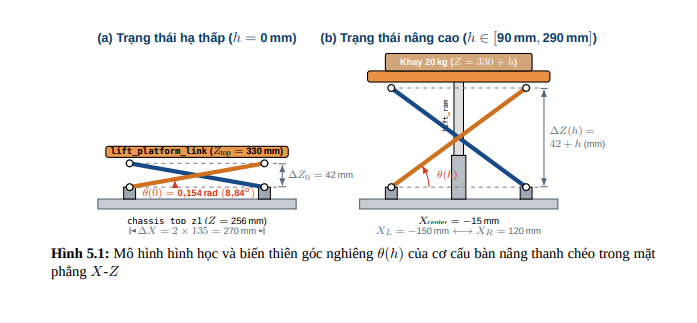
docs/images/docs/images/fig_5_1_scissor_lift_geometry.png
