HoangAnh301194/Industrial_AMR_Robot/docs/images/docs/images/fig_6_1_power_distribution_estop.png

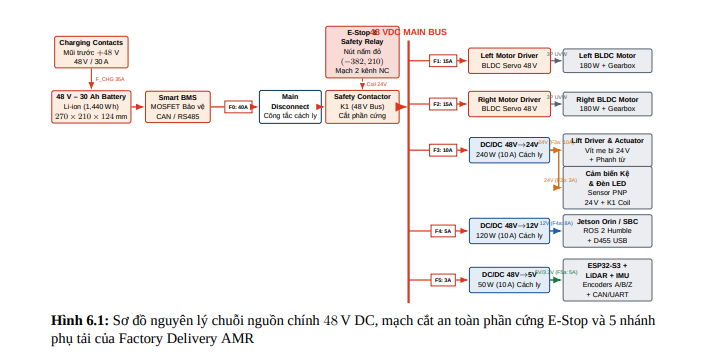
docs/images/docs/images/fig_6_1_power_distribution_estop.png
