HoangAnh301194/Industrial_AMR_Robot/docs/images/docs/images/fig_10_1_rack_mission_fsm.png

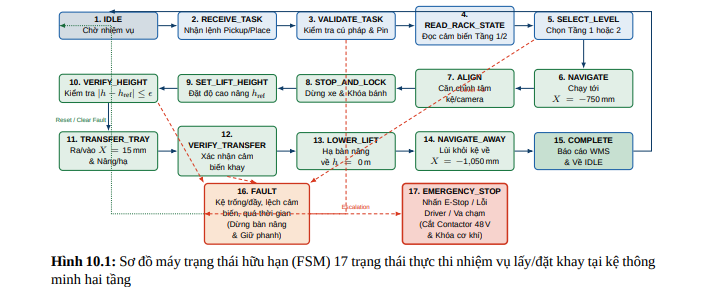
docs/images/docs/images/fig_10_1_rack_mission_fsm.png
