HoangAnh301194/Industrial_AMR_Robot/docs/images/docs/images/table_4_1_mechanical_design_part2.png

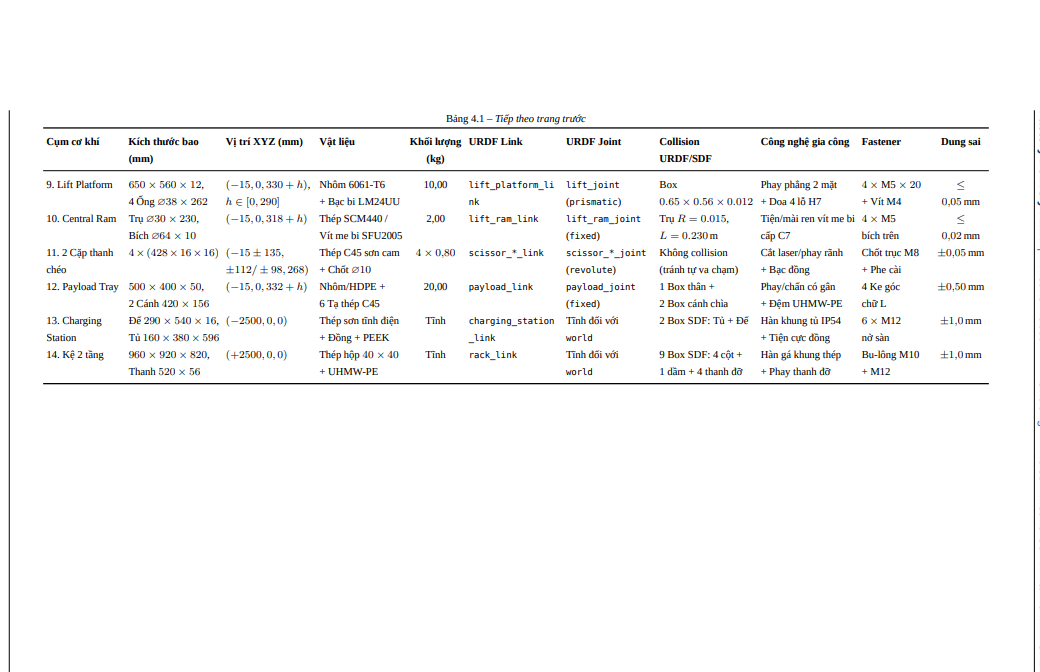
docs/images/docs/images/table_4_1_mechanical_design_part2.png
