HoangAnh301194/Industrial_AMR_Robot/docs/images/enviroment_robot.png

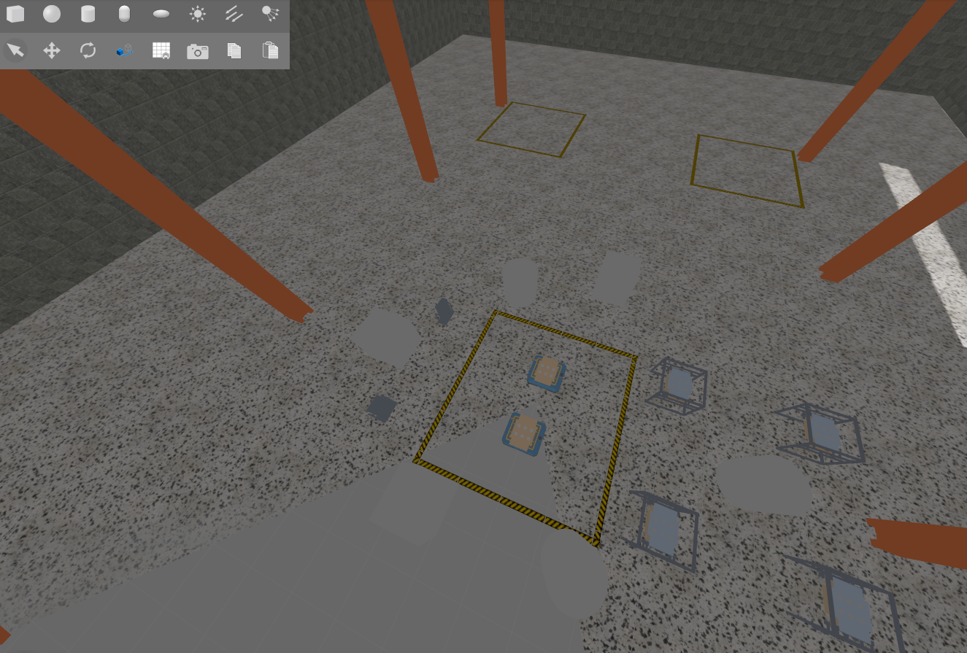
docs/images/enviroment_robot.png
