HoangAnh301194/Industrial_AMR_Robot/docs/images/Lidar.png

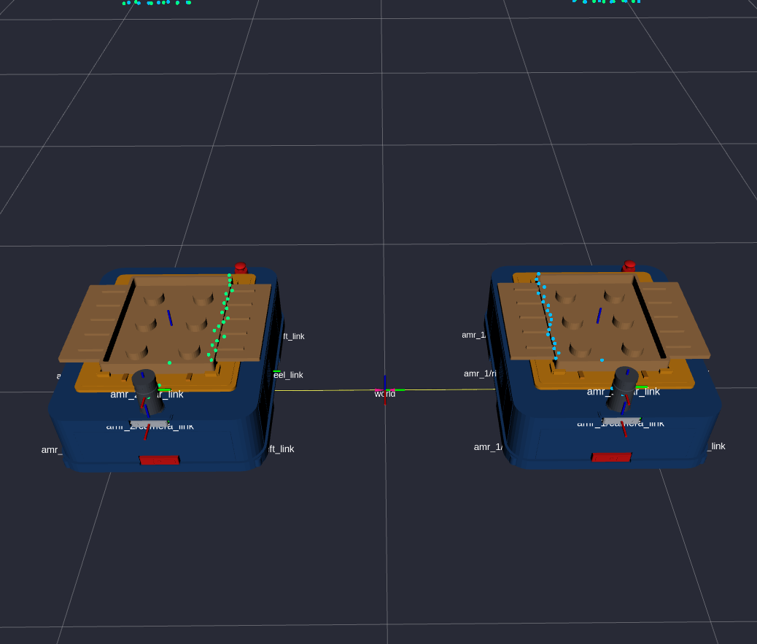
docs/images/Lidar.png
