HoangAnh301194/Industrial_AMR_Robot/docs/images/Rviz2_lidar.png

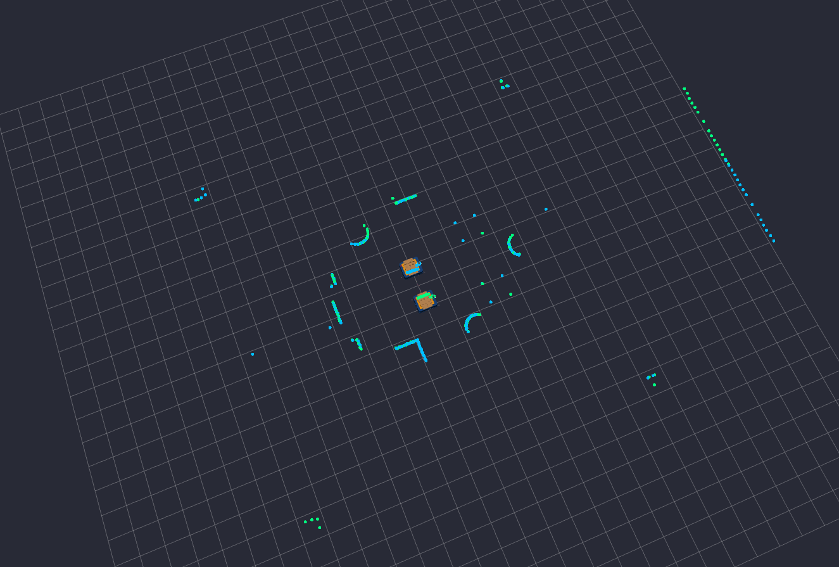
docs/images/Rviz2_lidar.png
