HoangAnh301194/Industrial_AMR_Robot/slides/figures/diff_drive_doc.png

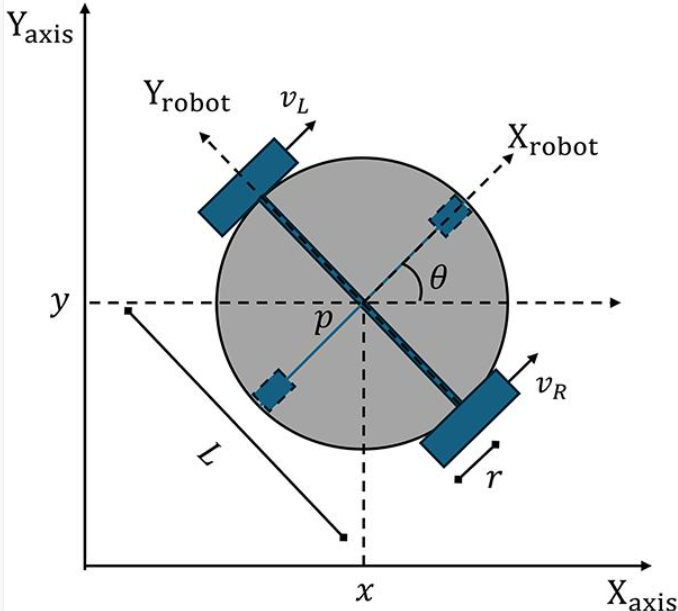
slides/figures/diff_drive_doc.png
