HoangAnh301194/Industrial_AMR_Robot/slides/figures/hoat_dong.png

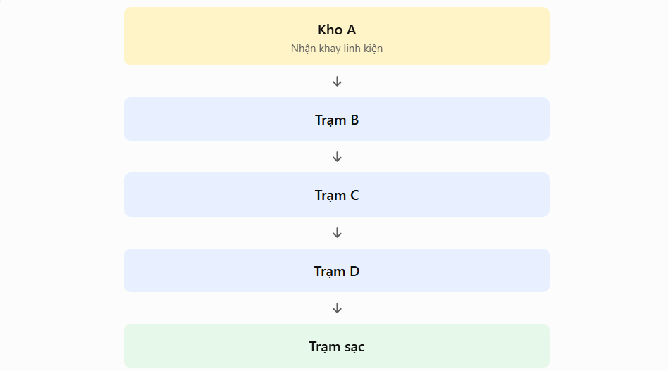
slides/figures/hoat_dong.png
