HoangAnh301194/Industrial_AMR_Robot/slides/figures/illustrative_straight_trajectory.png

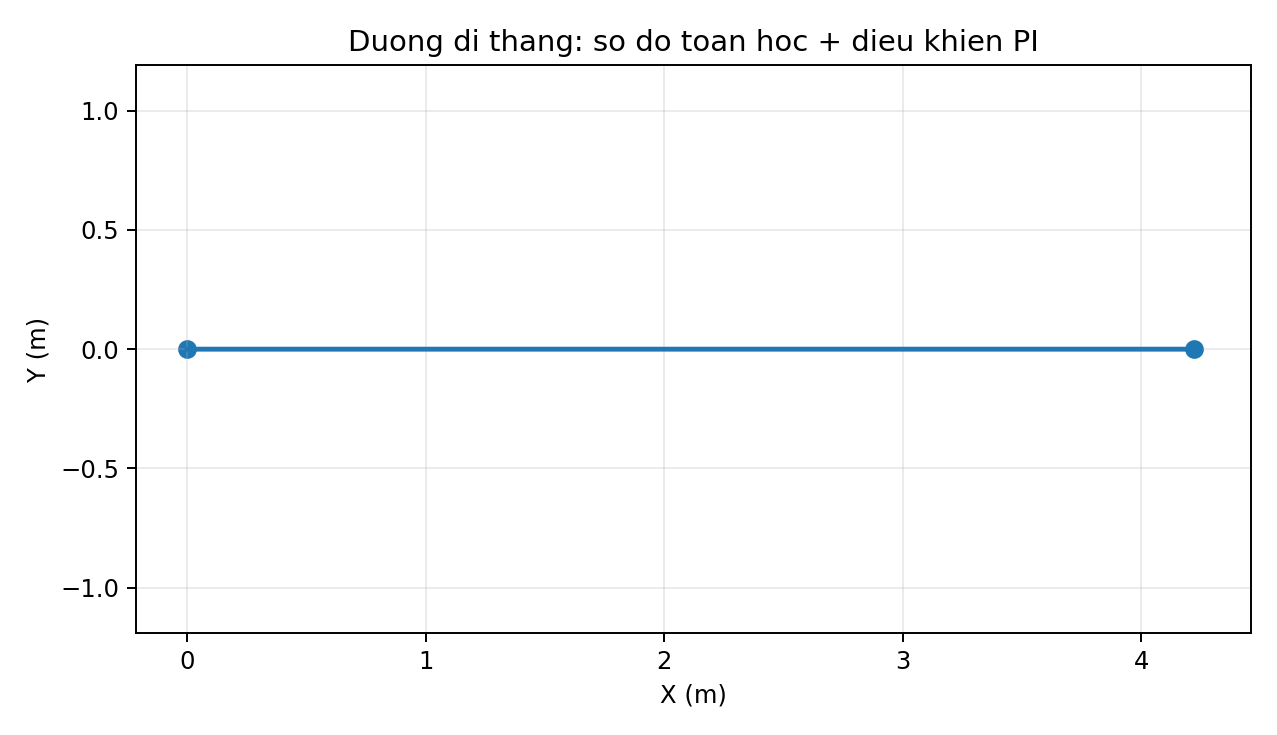
slides/figures/illustrative_straight_trajectory.png
