HoangAnh301194/Industrial_AMR_Robot/slides/figures/layout_control.png

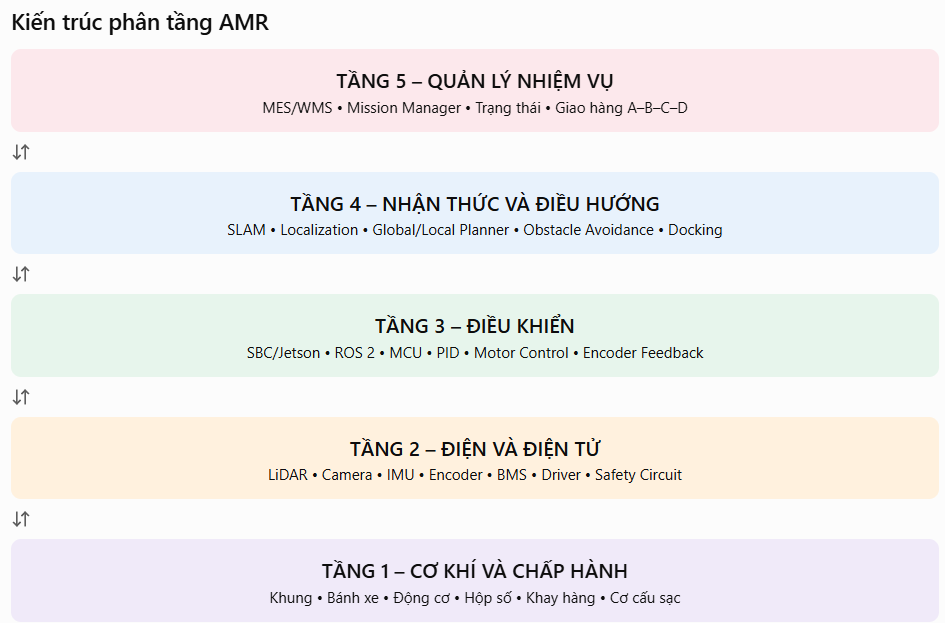
slides/figures/layout_control.png
