HoangAnh301194/Industrial_AMR_Robot/src/factory_delivery_amr_description/meshes/body_shell_main_visual.stl

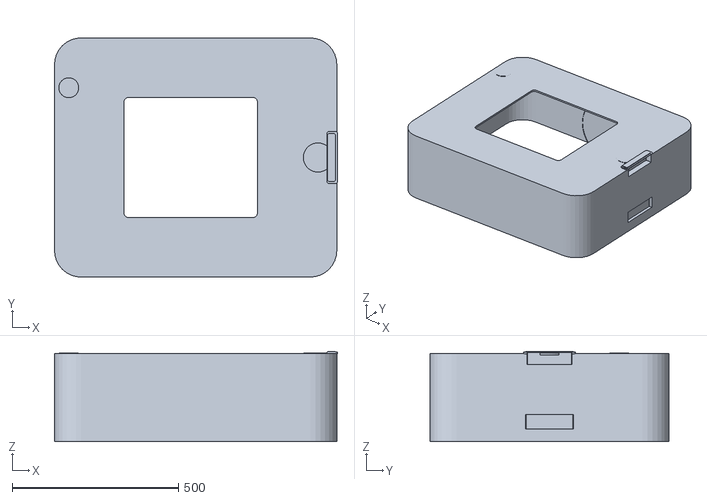
[picture p93: CAD file, 2026-11-09]
src/factory_delivery_amr_description/meshes/body_shell_main_visual.stl
852.0 x 720.0 x 271.5
