HoangAnh301194/Industrial_AMR_Robot/src/factory_delivery_amr_description/meshes/camera_face_visual.stl

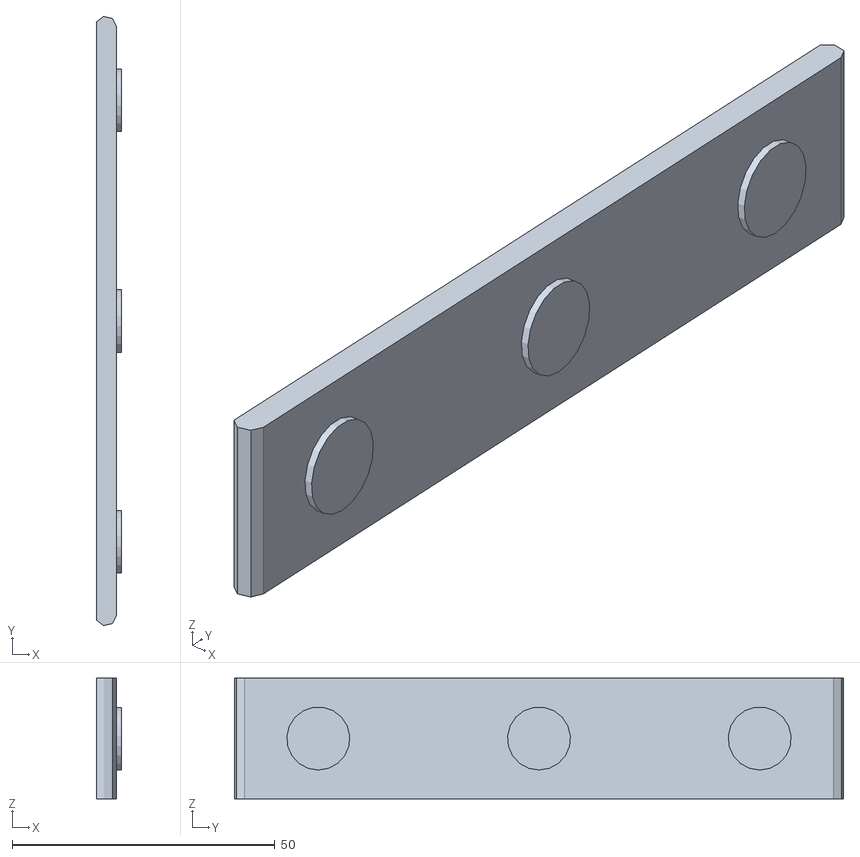
[picture p94: CAD file, 2026-11-09]
src/factory_delivery_amr_description/meshes/camera_face_visual.stl
4.81 x 115.9 x 23.0
