HoangAnh301194/Industrial_AMR_Robot/src/factory_delivery_amr_description/models/charging_station/meshes/charging_station_visual.stl

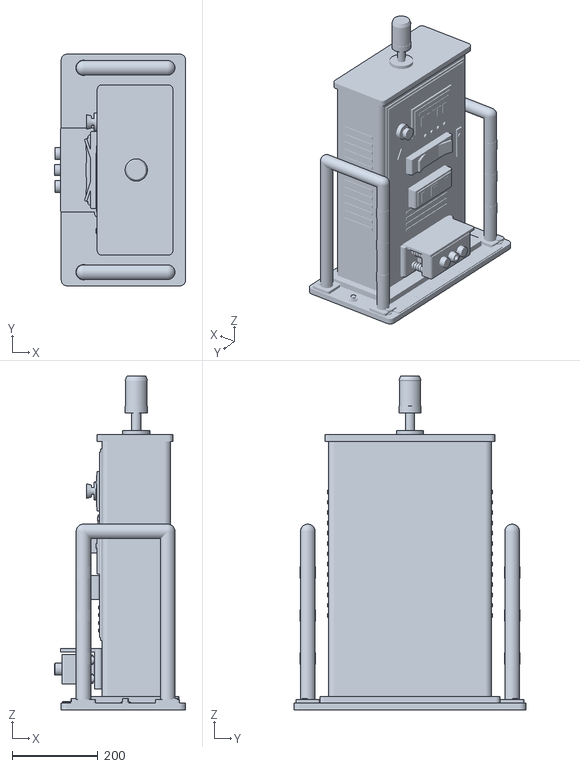
[picture p95: CAD file, 2026-11-09]
src/factory_delivery_amr_description/models/charging_station/meshes/charging_station_visual.stl
306.0 x 540.0 x 778.0
