HoangAnh301194/Industrial_AMR_Robot/src/factory_delivery_amr_description/models/smart_storage_rack/meshes/payload_weights_visual.stl

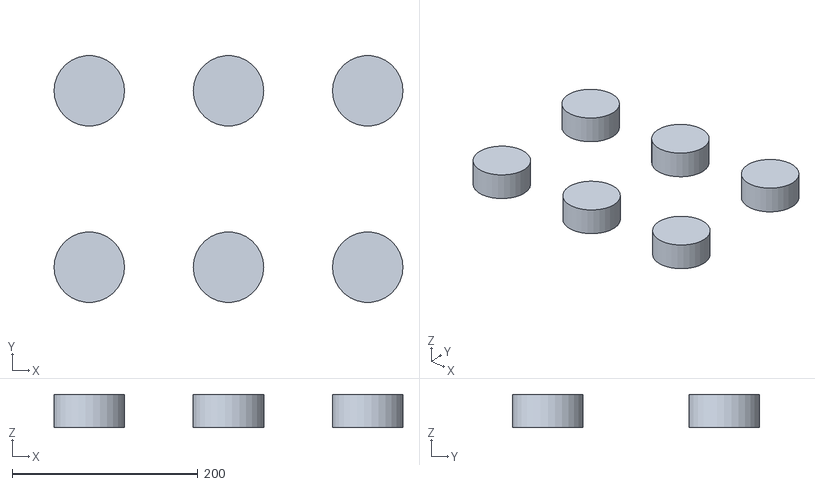
[picture p96: CAD file, 2026-11-09]
src/factory_delivery_amr_description/models/smart_storage_rack/meshes/payload_weights_visual.stl
376.0 x 265.6 x 36.0
