HoangAnh301194/Industrial_AMR_Robot/src/factory_delivery_amr_description/models/warehouse/meshes/warehouse_colision.stl

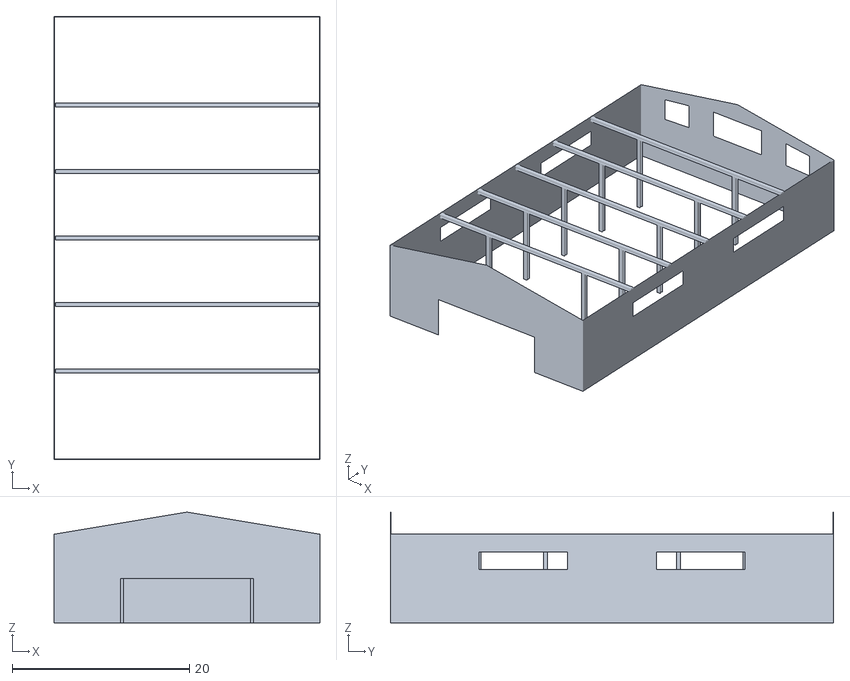
[picture p97: CAD file, 2026-11-11]
src/factory_delivery_amr_description/models/warehouse/meshes/warehouse_colision.stl
30.0 x 50.0 x 12.5
