HoangAnh301194/Industrial_AMR_Robot/src/factory_delivery_amr_description/meshes/payload_tray_visual.stl

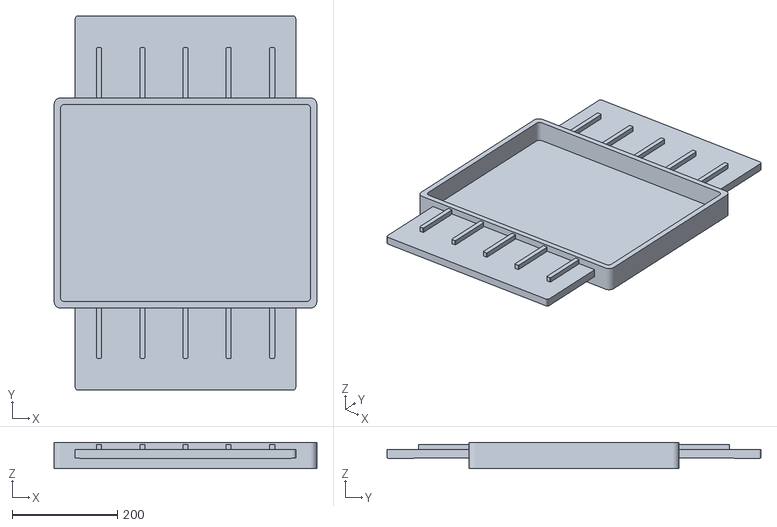
[picture p98: CAD file, 2026-11-09]
src/factory_delivery_amr_description/meshes/payload_tray_visual.stl
500.0 x 712.0 x 50.0
