HoangAnh301194/Industrial_AMR_Robot/src/factory_delivery_amr_description/models/smart_storage_rack/meshes/smart_storage_rack_visual.stl

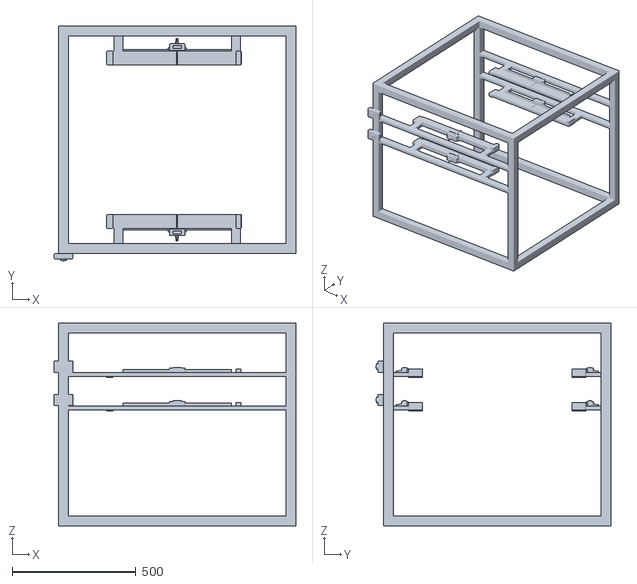
[picture p99: CAD file, 2026-11-09]
src/factory_delivery_amr_description/models/smart_storage_rack/meshes/smart_storage_rack_visual.stl
978.0 x 950.5 x 820.0
