HoangAnh301194/Industrial_AMR_Robot/src/factory_delivery_amr_description/meshes/left_wheel_tire_visual.stl

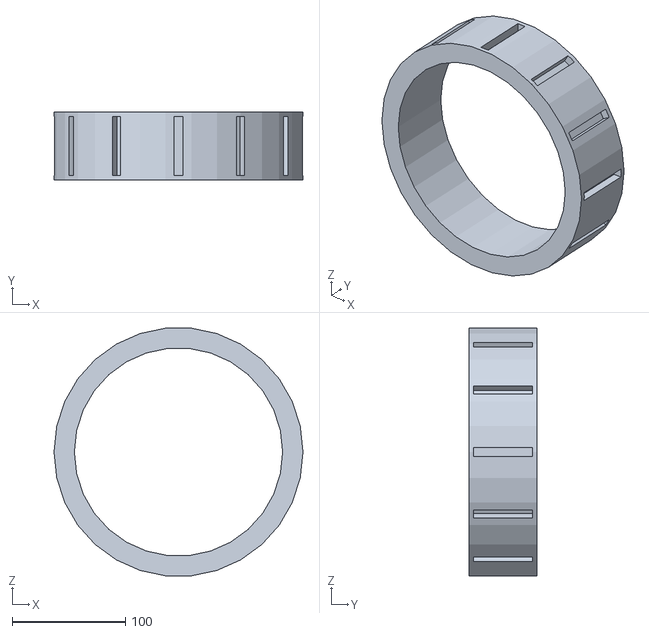
[picture p100: CAD file, 2026-11-09]
src/factory_delivery_amr_description/meshes/left_wheel_tire_visual.stl
220.0 x 60.0 x 218.8
