HoangAnh301194/Industrial_AMR_Robot/src/factory_delivery_amr_description/meshes/imu_visual.stl

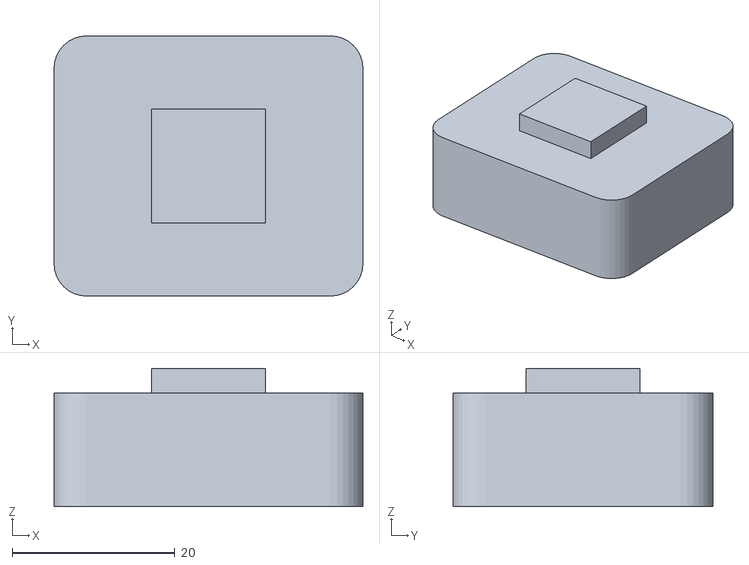
[picture p101: CAD file, 2026-11-09]
src/factory_delivery_amr_description/meshes/imu_visual.stl
38.0 x 32.0 x 17.0
