HoangAnh301194/Industrial_AMR_Robot/src/factory_delivery_amr_description/meshes/chassis_visual.stl

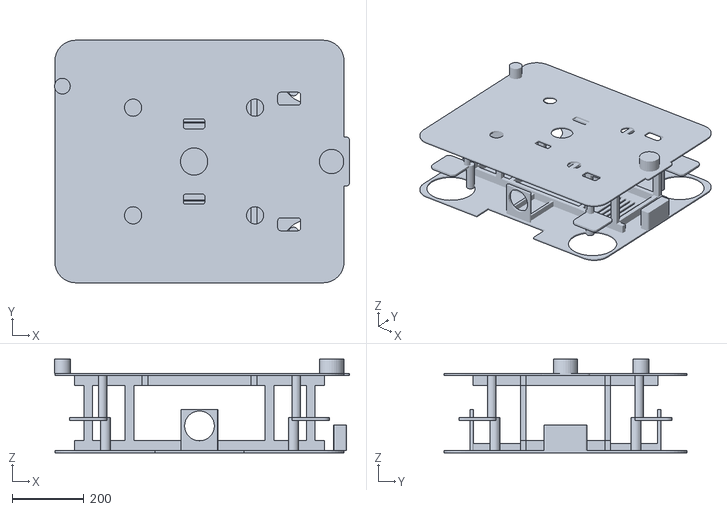
[picture p102: CAD file, 2026-11-09]
src/factory_delivery_amr_description/meshes/chassis_visual.stl
822.0 x 676.0 x 261.0
