HoangAnh301194/Industrial_AMR_Robot/src/factory_delivery_amr_description/meshes/right_wheel_visual.stl

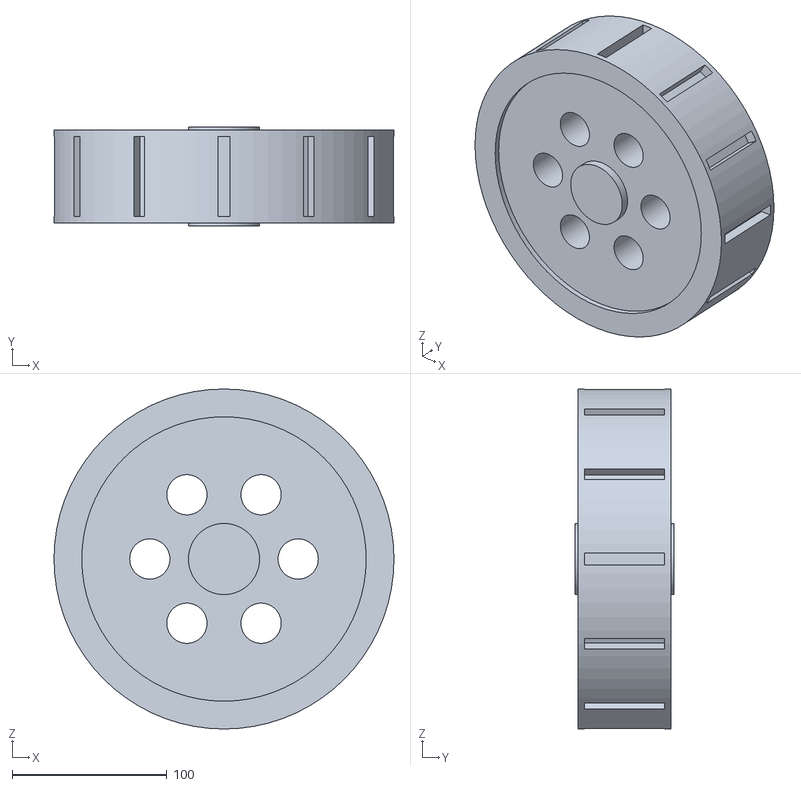
[picture p103: CAD file, 2026-11-09]
src/factory_delivery_amr_description/meshes/right_wheel_visual.stl
220.0 x 64.0 x 220.0
