HoangAnh301194/Industrial_AMR_Robot/src/factory_delivery_amr_description/meshes/fixed_drive_hardware_visual.stl

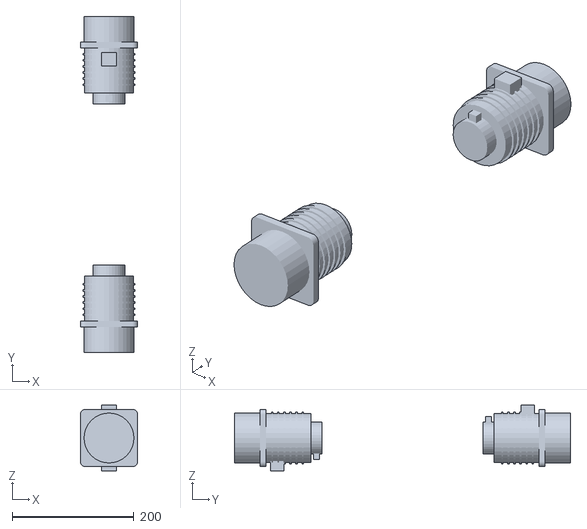
[picture p104: CAD file, 2026-11-09]
src/factory_delivery_amr_description/meshes/fixed_drive_hardware_visual.stl
94.0 x 552.0 x 108.0
