HoangAnh301194/Industrial_AMR_Robot/src/factory_delivery_amr_description/meshes/body_hazard_stripes_visual.stl

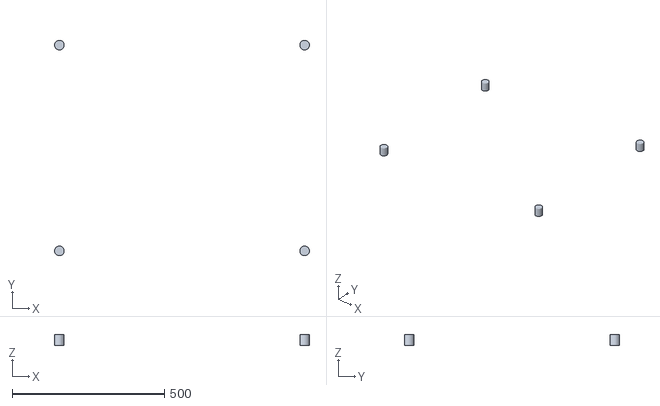
[picture p105: CAD file, 2026-11-09]
src/factory_delivery_amr_description/meshes/body_hazard_stripes_visual.stl
838.0 x 708.0 x 36.0
