HoangAnh301194/Industrial_AMR_Robot/src/factory_delivery_amr_description/meshes/camera_visual.stl

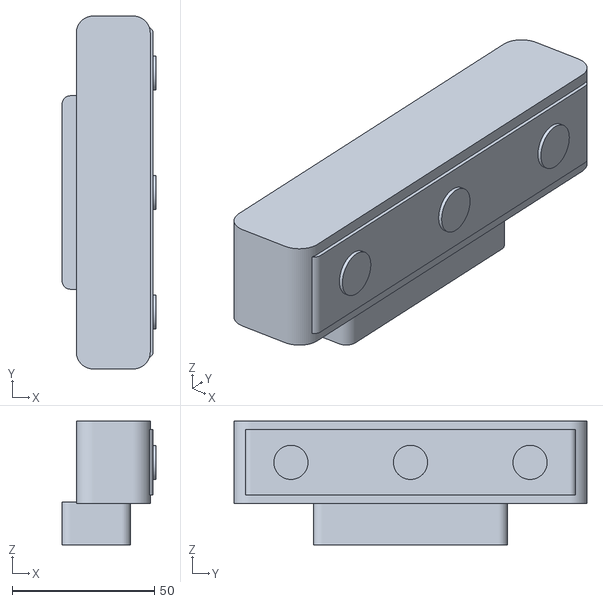
[picture p106: CAD file, 2026-11-09]
src/factory_delivery_amr_description/meshes/camera_visual.stl
33.0 x 124.0 x 43.5
