HoangAnh301194/Industrial_AMR_Robot/src/factory_delivery_amr_description/meshes/right_wheel_hub_visual.stl

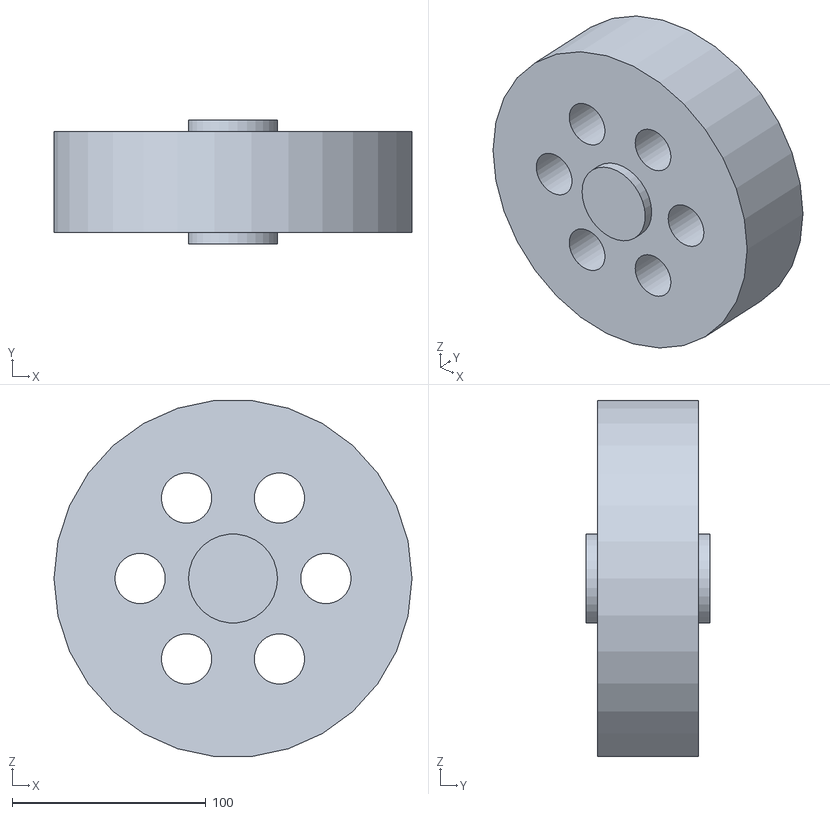
[picture p107: CAD file, 2026-11-09]
src/factory_delivery_amr_description/meshes/right_wheel_hub_visual.stl
185.0 x 64.0 x 184.0
