HoangAnh301194/Industrial_AMR_Robot/src/factory_delivery_amr_description/meshes/lift_fixed_visual.stl

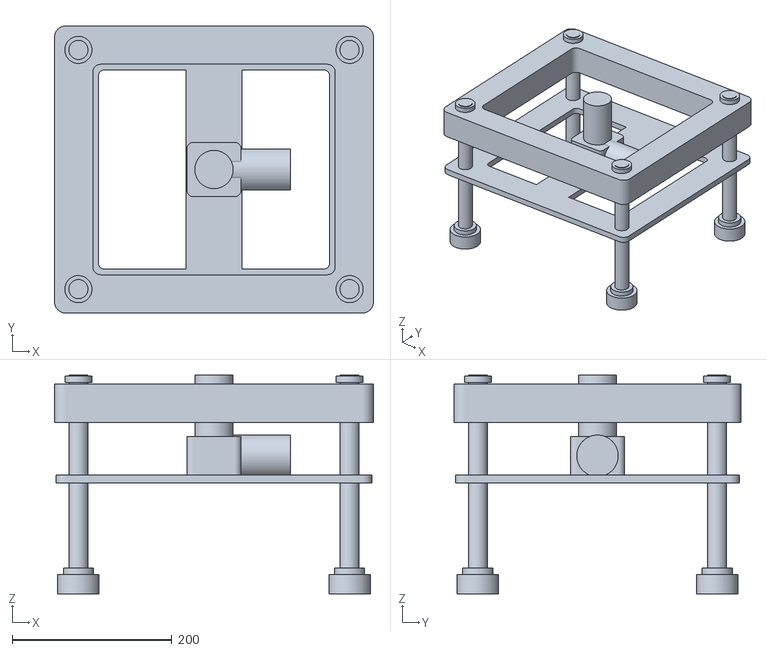
[picture p108: CAD file, 2026-11-09]
src/factory_delivery_amr_description/meshes/lift_fixed_visual.stl
400.0 x 360.0 x 274.0
