HoangAnh301194/Industrial_AMR_Robot/src/factory_delivery_amr_description/meshes/camera_body_visual.stl

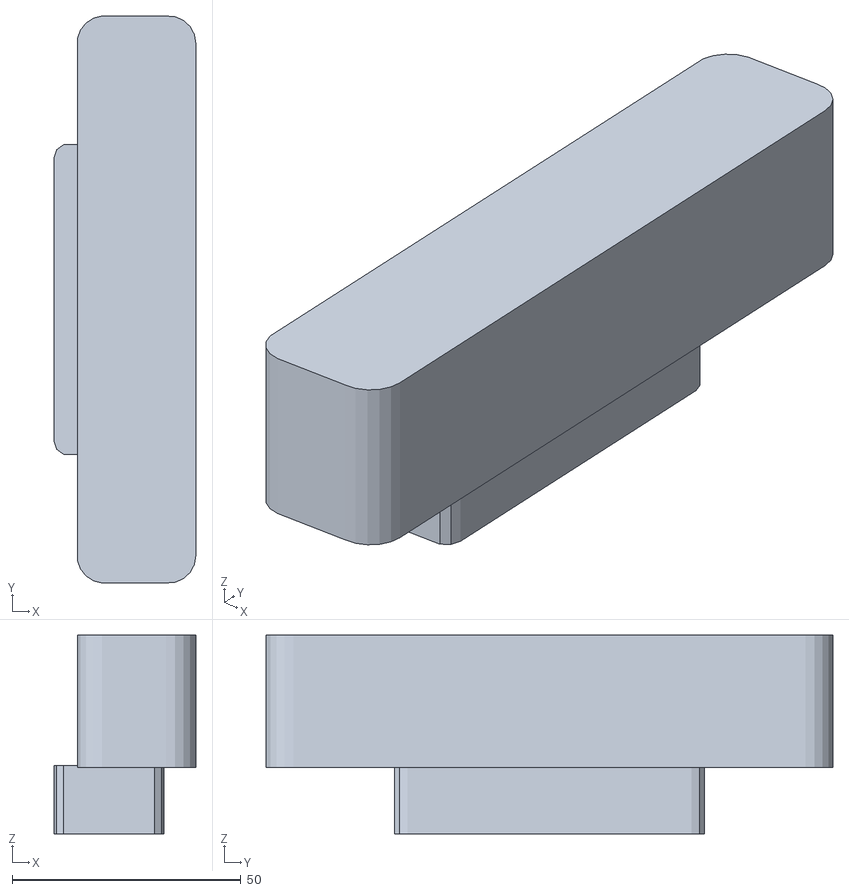
[picture p109: CAD file, 2026-11-09]
src/factory_delivery_amr_description/meshes/camera_body_visual.stl
31.0 x 124.0 x 43.5
