HoangAnh301194/Industrial_AMR_Robot/src/factory_delivery_amr_description/meshes/lift_platform_visual.stl

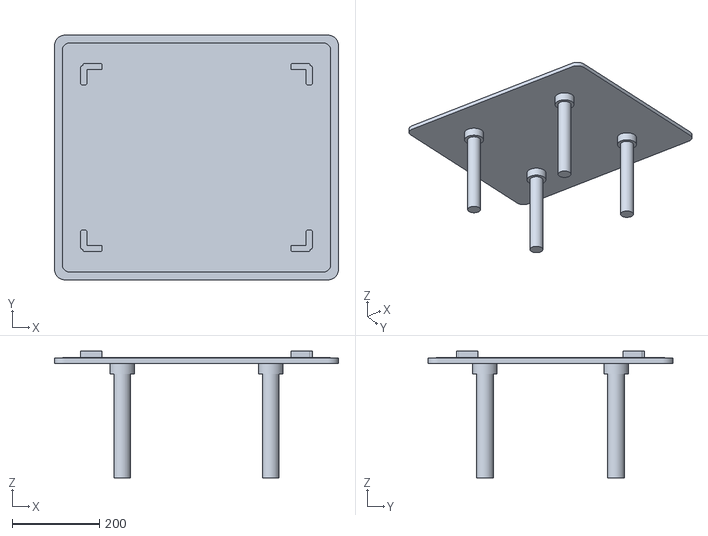
[picture p110: CAD file, 2026-11-09]
src/factory_delivery_amr_description/meshes/lift_platform_visual.stl
650.0 x 560.0 x 290.0
