HoangAnh301194/Industrial_AMR_Robot/src/factory_delivery_amr_description/meshes/estop_collar_visual.stl

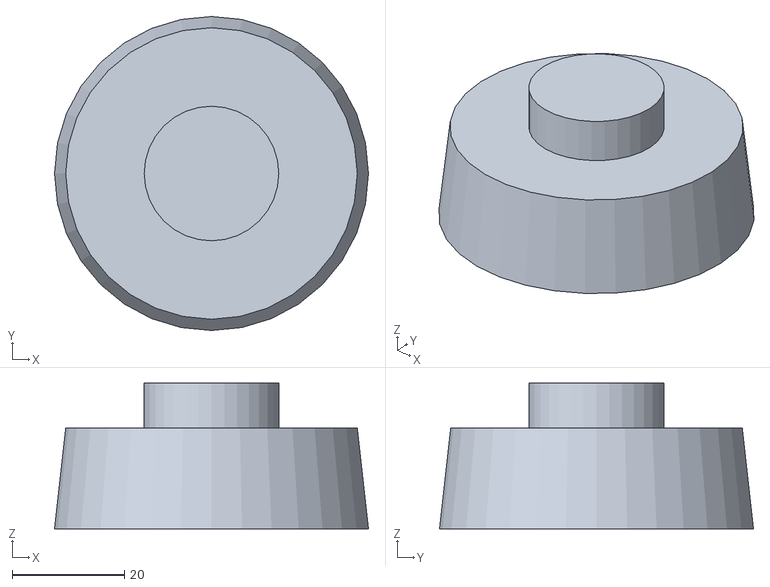
[picture p111: CAD file, 2026-11-09]
src/factory_delivery_amr_description/meshes/estop_collar_visual.stl
56.0 x 56.0 x 26.0
