HoangAnh301194/Industrial_AMR_Robot/src/factory_delivery_amr_description/meshes/body_shell_visual.stl

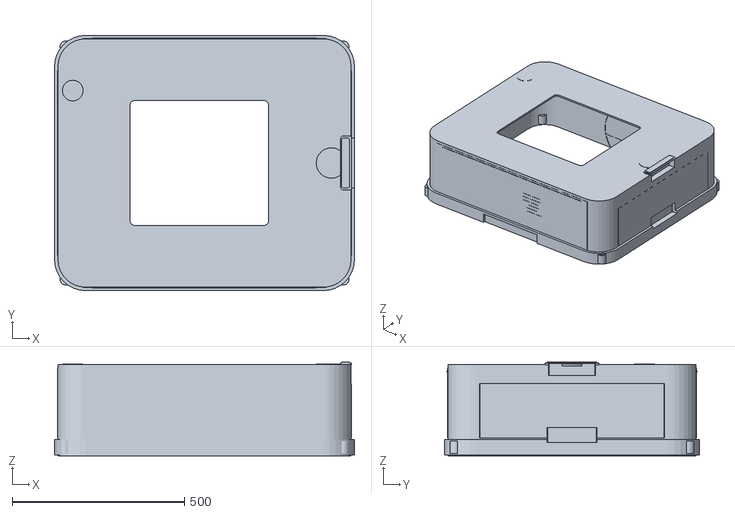
[picture p112: CAD file, 2026-11-09]
src/factory_delivery_amr_description/meshes/body_shell_visual.stl
870.0 x 740.0 x 271.5
