HoangAnh301194/Industrial_AMR_Robot/src/factory_delivery_amr_description/meshes/esp32_s3_visual.stl

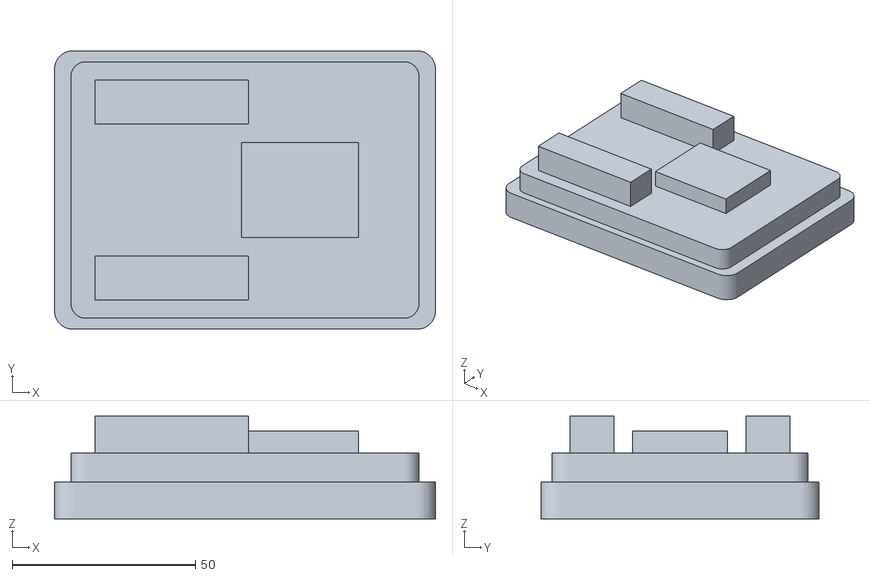
[picture p113: CAD file, 2026-11-09]
src/factory_delivery_amr_description/meshes/esp32_s3_visual.stl
104.0 x 76.0 x 28.0
