HoangAnh301194/Industrial_AMR_Robot/src/factory_delivery_amr_description/meshes/safety_components_visual.stl

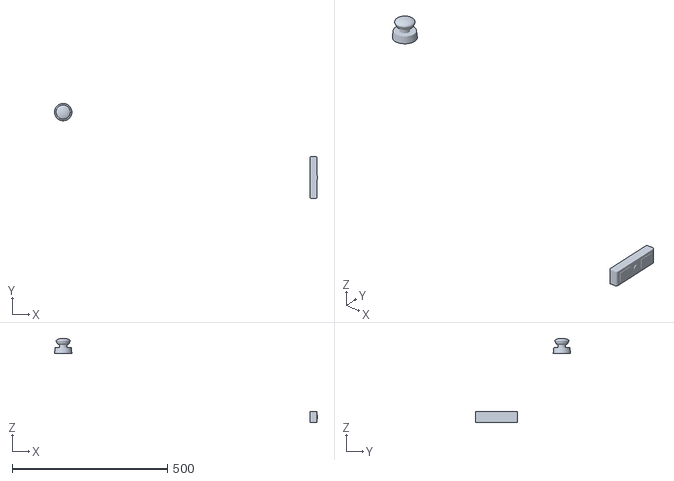
[picture p114: CAD file, 2026-11-09]
src/factory_delivery_amr_description/meshes/safety_components_visual.stl
846.0 x 306.0 x 271.0
