HoangAnh301194/Industrial_AMR_Robot/src/factory_delivery_amr_description/meshes/electronics_visual.stl

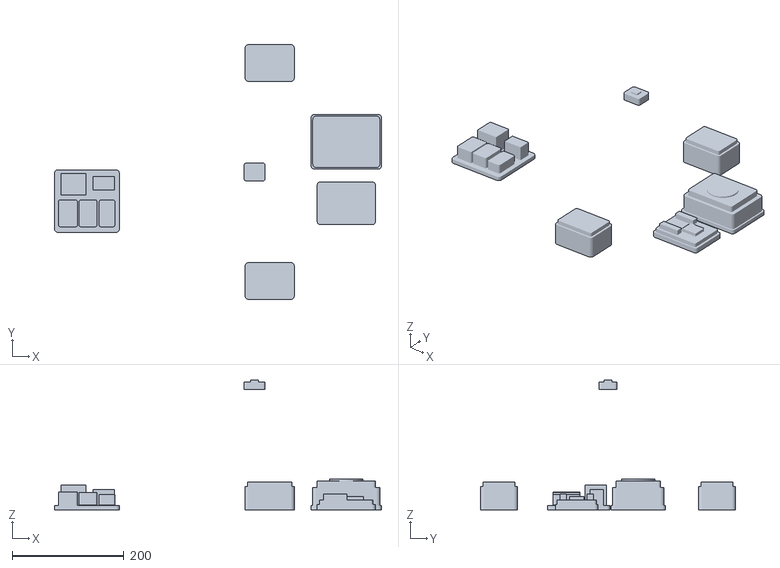
[picture p115: CAD file, 2026-11-09]
src/factory_delivery_amr_description/meshes/electronics_visual.stl
585.0 x 456.0 x 232.0
