HoangAnh301194/Industrial_AMR_Robot/src/factory_delivery_amr_description/meshes/body_bumper_visual.stl

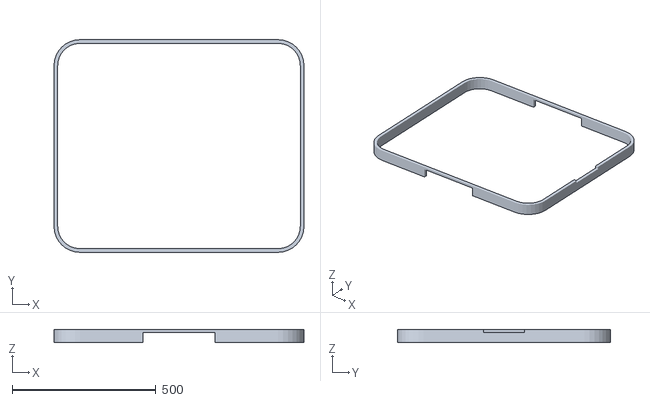
[picture p116: CAD file, 2026-11-09]
src/factory_delivery_amr_description/meshes/body_bumper_visual.stl
870.0 x 740.0 x 46.0
