HoangAnh301194/Industrial_AMR_Robot/src/factory_delivery_amr_description/meshes/estop_button_visual.stl

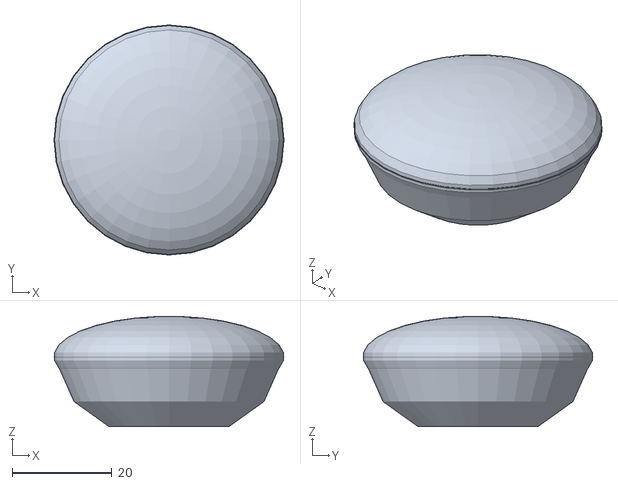
[picture p117: CAD file, 2026-11-09]
src/factory_delivery_amr_description/meshes/estop_button_visual.stl
46.0 x 46.0 x 22.0
