HoangAnh301194/Industrial_AMR_Robot/src/factory_delivery_amr_description/meshes/jetson_sbc_visual.stl

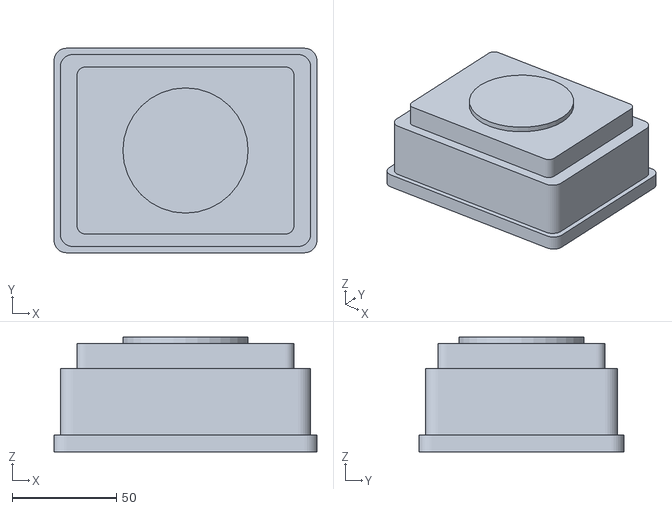
[picture p118: CAD file, 2026-11-09]
src/factory_delivery_amr_description/meshes/jetson_sbc_visual.stl
126.0 x 98.0 x 55.0
