HoangAnh301194/Industrial_AMR_Robot/src/factory_delivery_amr_description/meshes/charging_contacts_housing_visual.stl

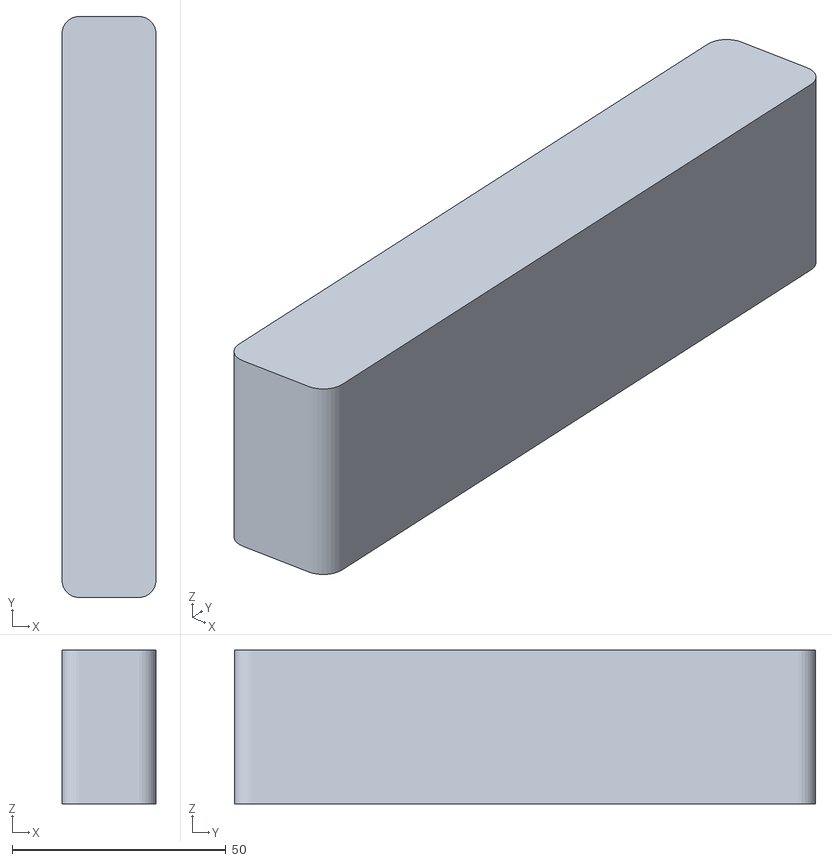
[picture p119: CAD file, 2026-11-09]
src/factory_delivery_amr_description/meshes/charging_contacts_housing_visual.stl
22.0 x 136.0 x 36.0
