HoangAnh301194/Industrial_AMR_Robot/src/factory_delivery_amr_description/meshes/payload_visual.stl

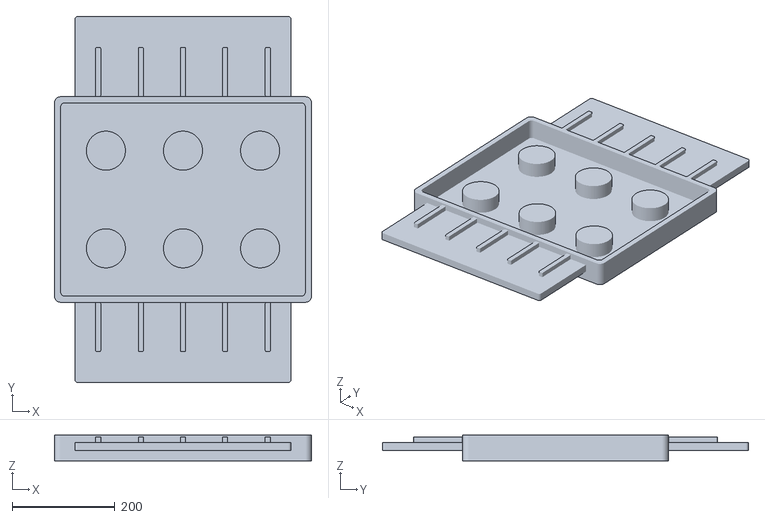
[picture p120: CAD file, 2026-11-09]
src/factory_delivery_amr_description/meshes/payload_visual.stl
500.0 x 712.0 x 50.0
