HoangAnh301194/Industrial_AMR_Robot/src/factory_delivery_amr_description/meshes/lidar_visual.stl

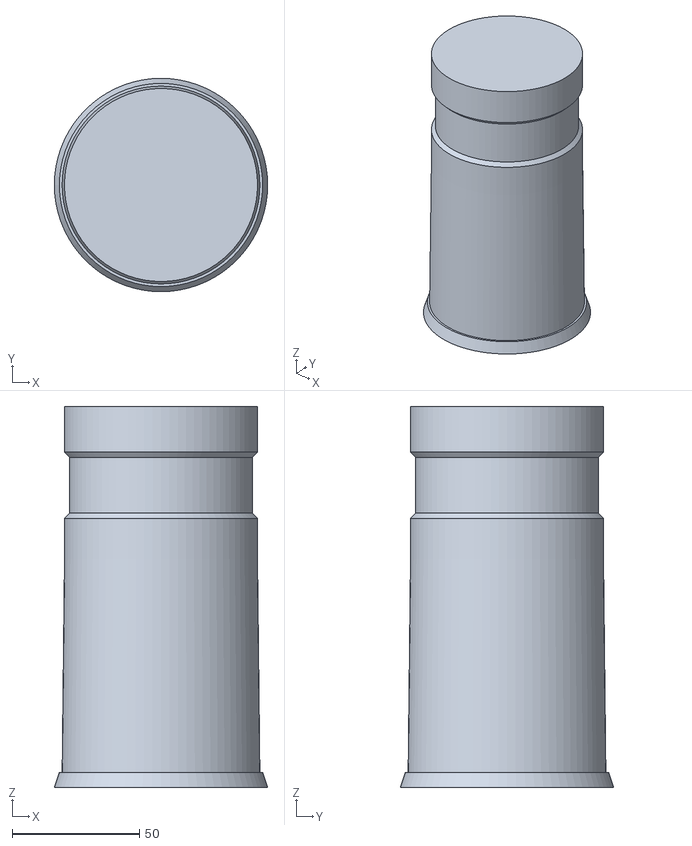
[picture p121: CAD file, 2026-11-09]
src/factory_delivery_amr_description/meshes/lidar_visual.stl
84.0 x 84.0 x 150.0
