HoangAnh301194/Industrial_AMR_Robot/src/factory_delivery_amr_description/meshes/body_status_lights_visual.stl

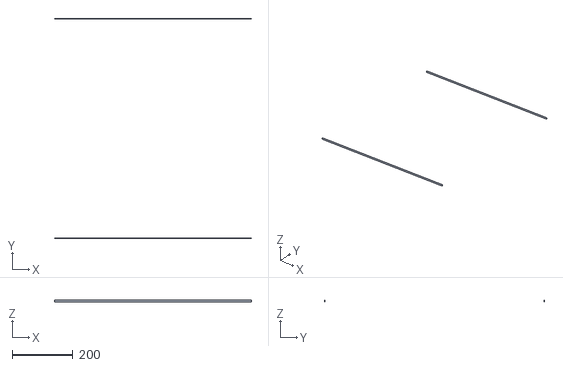
[picture p122: CAD file, 2026-11-09]
src/factory_delivery_amr_description/meshes/body_status_lights_visual.stl
650.0 x 725.0 x 6.00
