HoangAnh301194/Industrial_AMR_Robot/src/factory_delivery_amr_description/meshes/motor_drivers_visual.stl

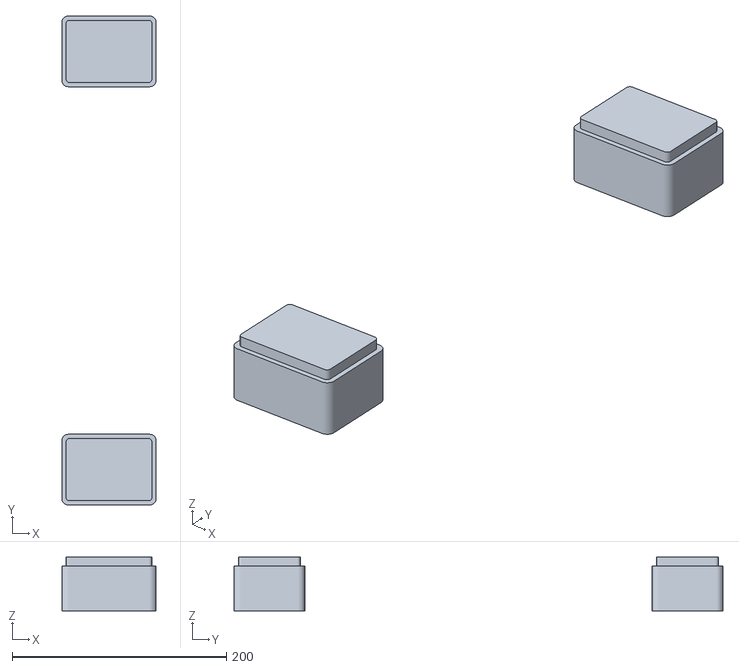
[picture p123: CAD file, 2026-11-09]
src/factory_delivery_amr_description/meshes/motor_drivers_visual.stl
88.0 x 456.0 x 50.0
