HoangAnh301194/Industrial_AMR_Robot/src/factory_delivery_amr_description/meshes/lidar_pedestal_visual.stl

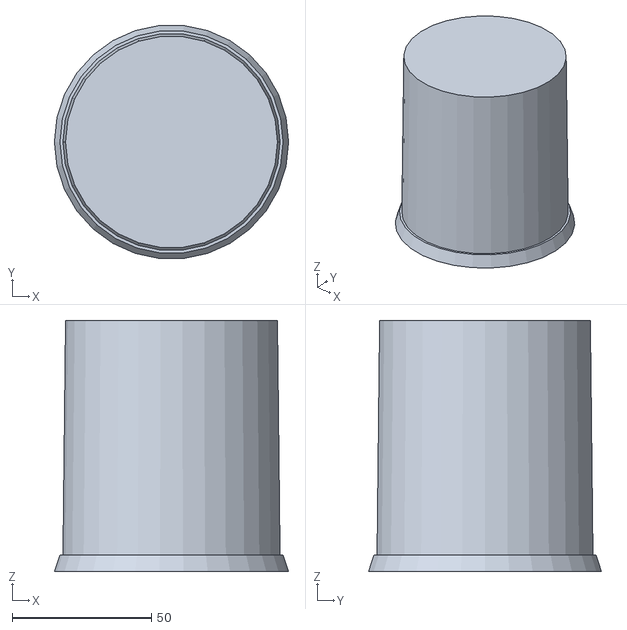
[picture p124: CAD file, 2026-11-09]
src/factory_delivery_amr_description/meshes/lidar_pedestal_visual.stl
84.0 x 83.5 x 90.0
