HoangAnh301194/Industrial_AMR_Robot/src/factory_delivery_amr_description/meshes/lidar_unit_visual.stl

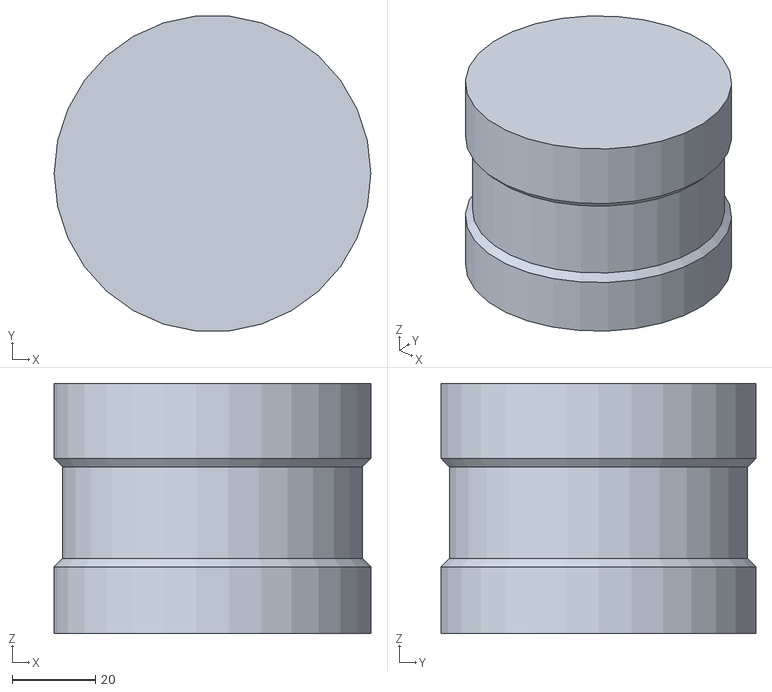
[picture p125: CAD file, 2026-11-09]
src/factory_delivery_amr_description/meshes/lidar_unit_visual.stl
76.0 x 75.6 x 60.0
