HoangAnh301194/Industrial_AMR_Robot/src/factory_delivery_amr_description/meshes/pdu_visual.stl

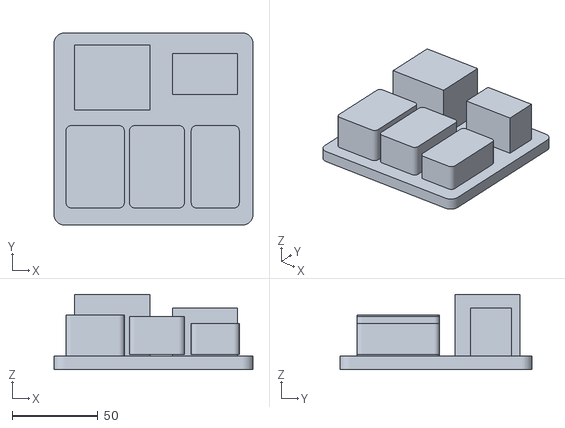
[picture p126: CAD file, 2026-11-09]
src/factory_delivery_amr_description/meshes/pdu_visual.stl
116.0 x 112.0 x 44.0
