HoangAnh301194/Industrial_AMR_Robot/src/factory_delivery_amr_description/meshes/casters_visual.stl

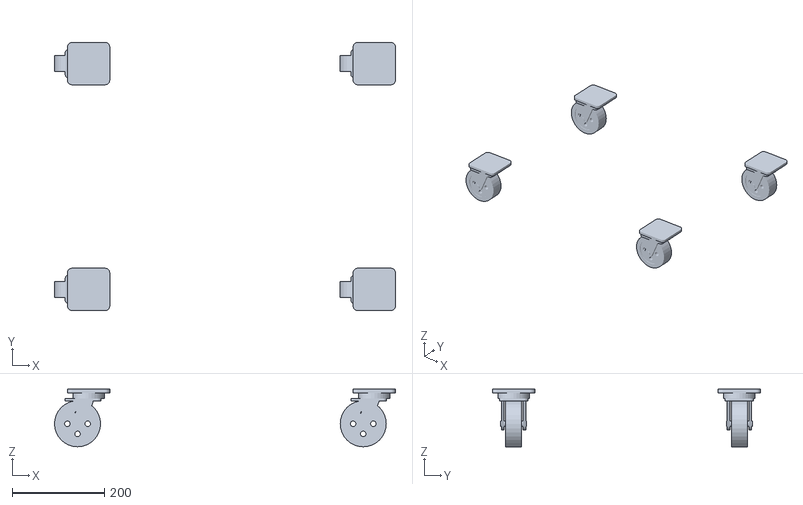
[picture p127: CAD file, 2026-11-09]
src/factory_delivery_amr_description/meshes/casters_visual.stl
740.0 x 582.0 x 125.0
