HoangAnh301194/Industrial_AMR_Robot/src/factory_delivery_amr_description/meshes/lift_deck_pad_visual.stl

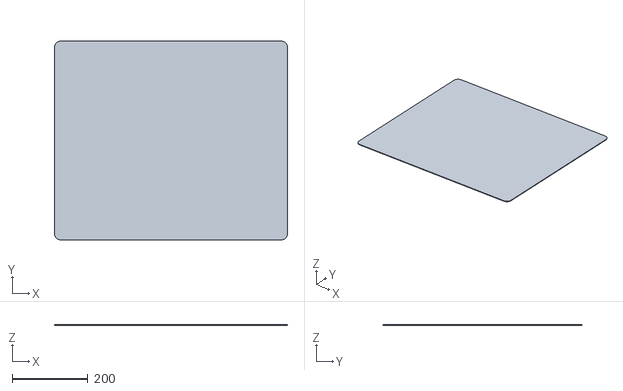
[picture p128: CAD file, 2026-11-09]
src/factory_delivery_amr_description/meshes/lift_deck_pad_visual.stl
614.0 x 523.8 x 2.00
