HoangAnh301194/Industrial_AMR_Robot/src/factory_delivery_amr_description/meshes/charging_contacts_plates_visual.stl

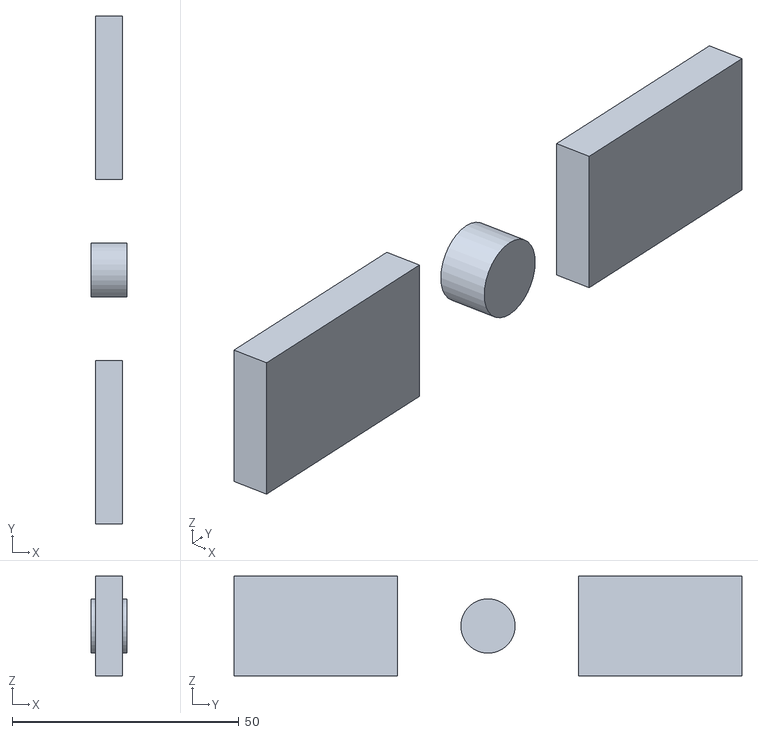
[picture p129: CAD file, 2026-11-09]
src/factory_delivery_amr_description/meshes/charging_contacts_plates_visual.stl
8.00 x 112.0 x 22.0
