HoangAnh301194/Industrial_AMR_Robot/src/factory_delivery_amr_description/meshes/lift_ram_visual.stl

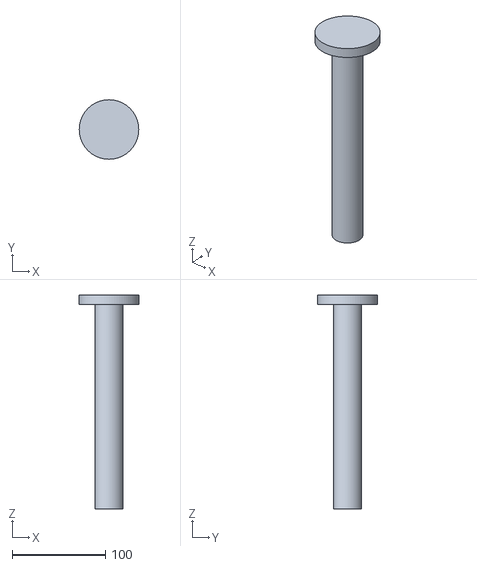
[picture p130: CAD file, 2026-11-09]
src/factory_delivery_amr_description/meshes/lift_ram_visual.stl
64.0 x 64.0 x 230.0
