HoangAnh301194/Industrial_AMR_Robot/src/factory_delivery_amr_description/meshes/bms_visual.stl

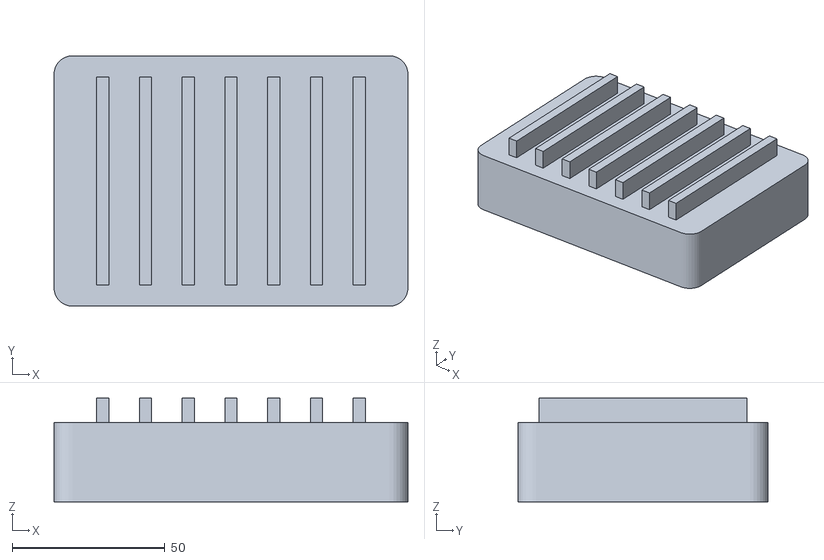
[picture p131: CAD file, 2026-11-09]
src/factory_delivery_amr_description/meshes/bms_visual.stl
116.0 x 82.0 x 34.0
