HoangAnh301194/Industrial_AMR_Robot/src/factory_delivery_amr_description/meshes/body_skin_panels_visual.stl

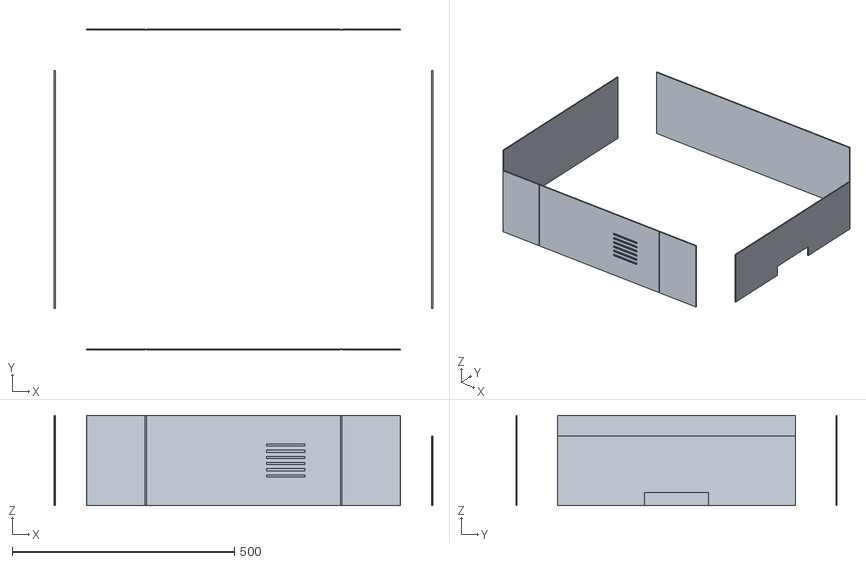
[picture p132: CAD file, 2026-11-09]
src/factory_delivery_amr_description/meshes/body_skin_panels_visual.stl
852.0 x 722.0 x 203.0
