HoangAnh301194/Industrial_AMR_Robot/src/factory_delivery_amr_description/meshes/battery_pack_visual.stl

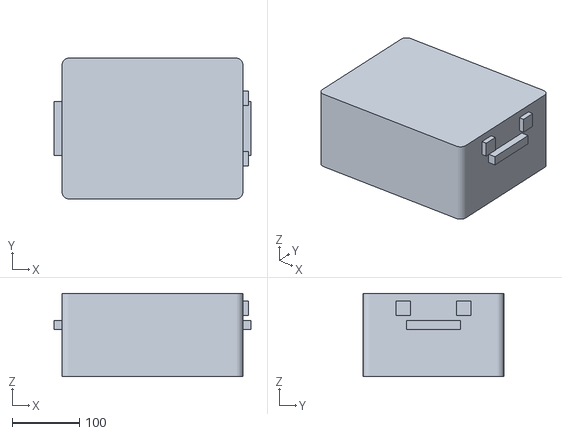
[picture p134: CAD file, 2026-11-09]
src/factory_delivery_amr_description/meshes/battery_pack_visual.stl
294.0 x 210.0 x 124.0
