HoangAnh301194/Industrial_AMR_Robot/cad/export_imu.scad

export_only = true;
include <main.scad>
imu_module();
