HoangAnh301194/Industrial_AMR_Robot/cad/export_motor_drivers.scad

export_only = true;
include <main.scad>
union() {
    motor_driver(1);
    motor_driver(-1);
}
