HoangAnh301194/Industrial_AMR_Robot/cad/export_battery_pack.scad

export_only = true;
include <main.scad>
battery_pack();
