HoangAnh301194/Industrial_AMR_Robot/cad/export_bms.scad

export_only = true;
include <main.scad>
bms();
