HoangAnh301194/Industrial_AMR_Robot/cad/export_body_bumper.scad

export_only = true;
include <main.scad>
body_bumper_profile();
