HoangAnh301194/Industrial_AMR_Robot/cad/export_body_hazard_stripes.scad

export_only = true;
include <main.scad>
body_bumper_hazards();
