HoangAnh301194/Industrial_AMR_Robot/cad/export_body_shell.scad

// ============================================================================
// FILE: export_body_shell.scad
// OUTPUT: body_shell_visual.stl
// URDF LINK: body_shell_link
// ============================================================================

export_only = true;

include <main.scad>

body_shell();
