HoangAnh301194/Industrial_AMR_Robot/cad/export_body_shell_main.scad

export_only = true;
include <main.scad>
body_shell_main();
