HoangAnh301194/Industrial_AMR_Robot/cad/export_body_skin_panels.scad

export_only = true;
include <main.scad>
body_skin_panels();
