HoangAnh301194/Industrial_AMR_Robot/cad/export_body_status_lights.scad

export_only = true;
include <main.scad>
body_status_lights();
