HoangAnh301194/Industrial_AMR_Robot/cad/export_charging_contacts_housing.scad

export_only = true;
include <main.scad>
charging_contacts_housing();
