HoangAnh301194/Industrial_AMR_Robot/cad/export_esp32_s3.scad

export_only = true;
include <main.scad>
esp32_s3_controller();
