HoangAnh301194/Industrial_AMR_Robot/cad/export_estop_button.scad

export_only = true;
include <main.scad>
estop_mushroom();
