HoangAnh301194/Industrial_AMR_Robot/cad/export_estop_collar.scad

export_only = true;
include <main.scad>
estop_collar();
