HoangAnh301194/Industrial_AMR_Robot/cad/export_jetson_sbc.scad

export_only = true;
include <main.scad>
jetson_or_sbc();
