HoangAnh301194/Industrial_AMR_Robot/cad/export_lift_ram.scad

// ============================================================================
// FILE: export_lift_ram.scad
// OUTPUT: lift_ram_visual.stl
// PURPOSE: Export only the moving central silver actuator ram.
// ============================================================================

use <main.scad>


// ============================================================================
// RENDER SETTINGS
// ============================================================================

eps = 0.05;

quality = "render";

preview_fn = 32;
render_fn  = 72;

$fn = quality == "render"
    ? render_fn
    : preview_fn;


// ============================================================================
// MOVING RAM EXPORT
// ============================================================================

lift_actuator_moving_ram_urdf();
