HoangAnh301194/Industrial_AMR_Robot/cad/export_pdu.scad

export_only = true;
include <main.scad>
power_distribution();
