HoangAnh301194/Industrial_AMR_Robot/(list of files, cad)

Other CAD files:
src/factory_delivery_amr_description/meshes/lift_platform_base_visual.stl
cad/export_left_wheel_tire.scad
cad/export_right_wheel_hub.scad
cad/export_right_wheel_tire.scad
cad/export_camera_face.scad
cad/export_lift_platform_base.scad
