HoangAnh301194/Industrial_AMR_Robot/Thiết kế Robot - C1-C3.pdf

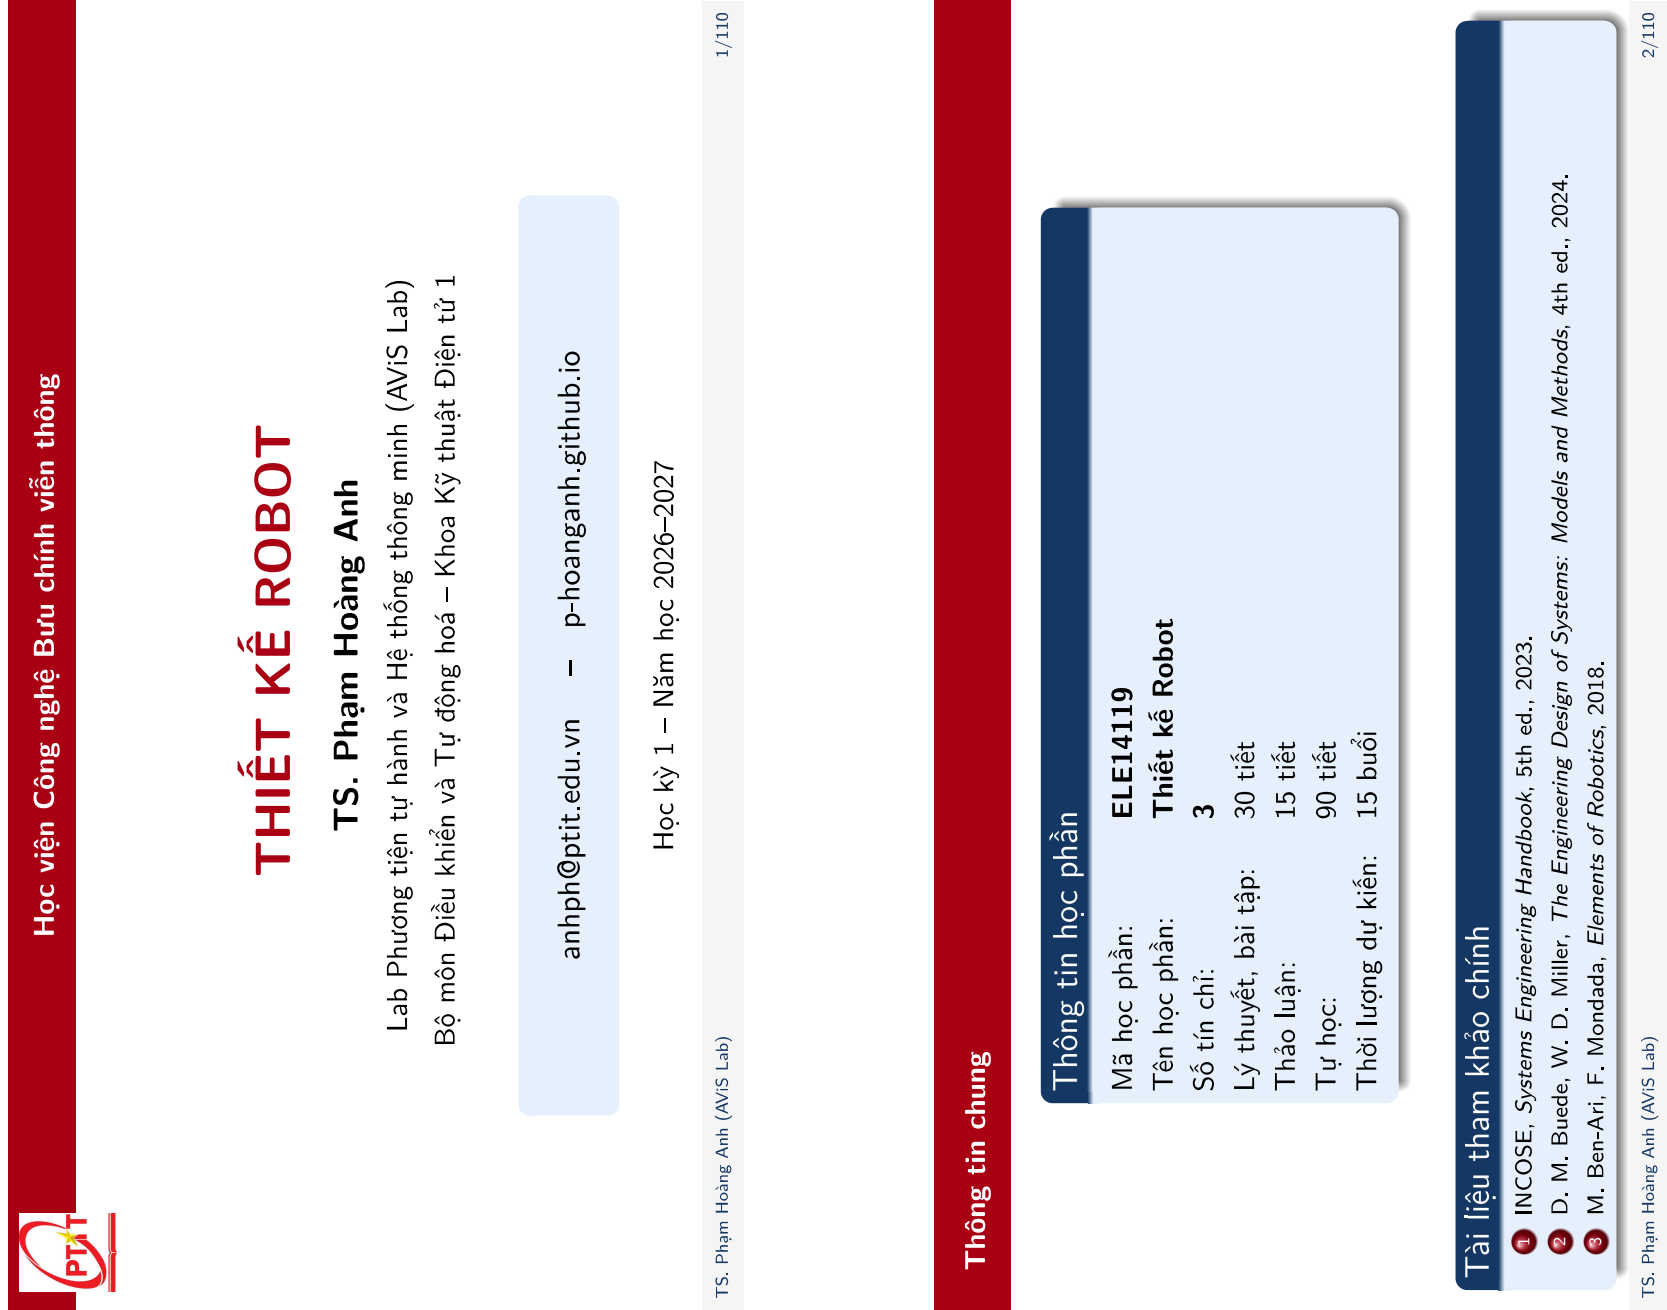
[picture p135: page 1]

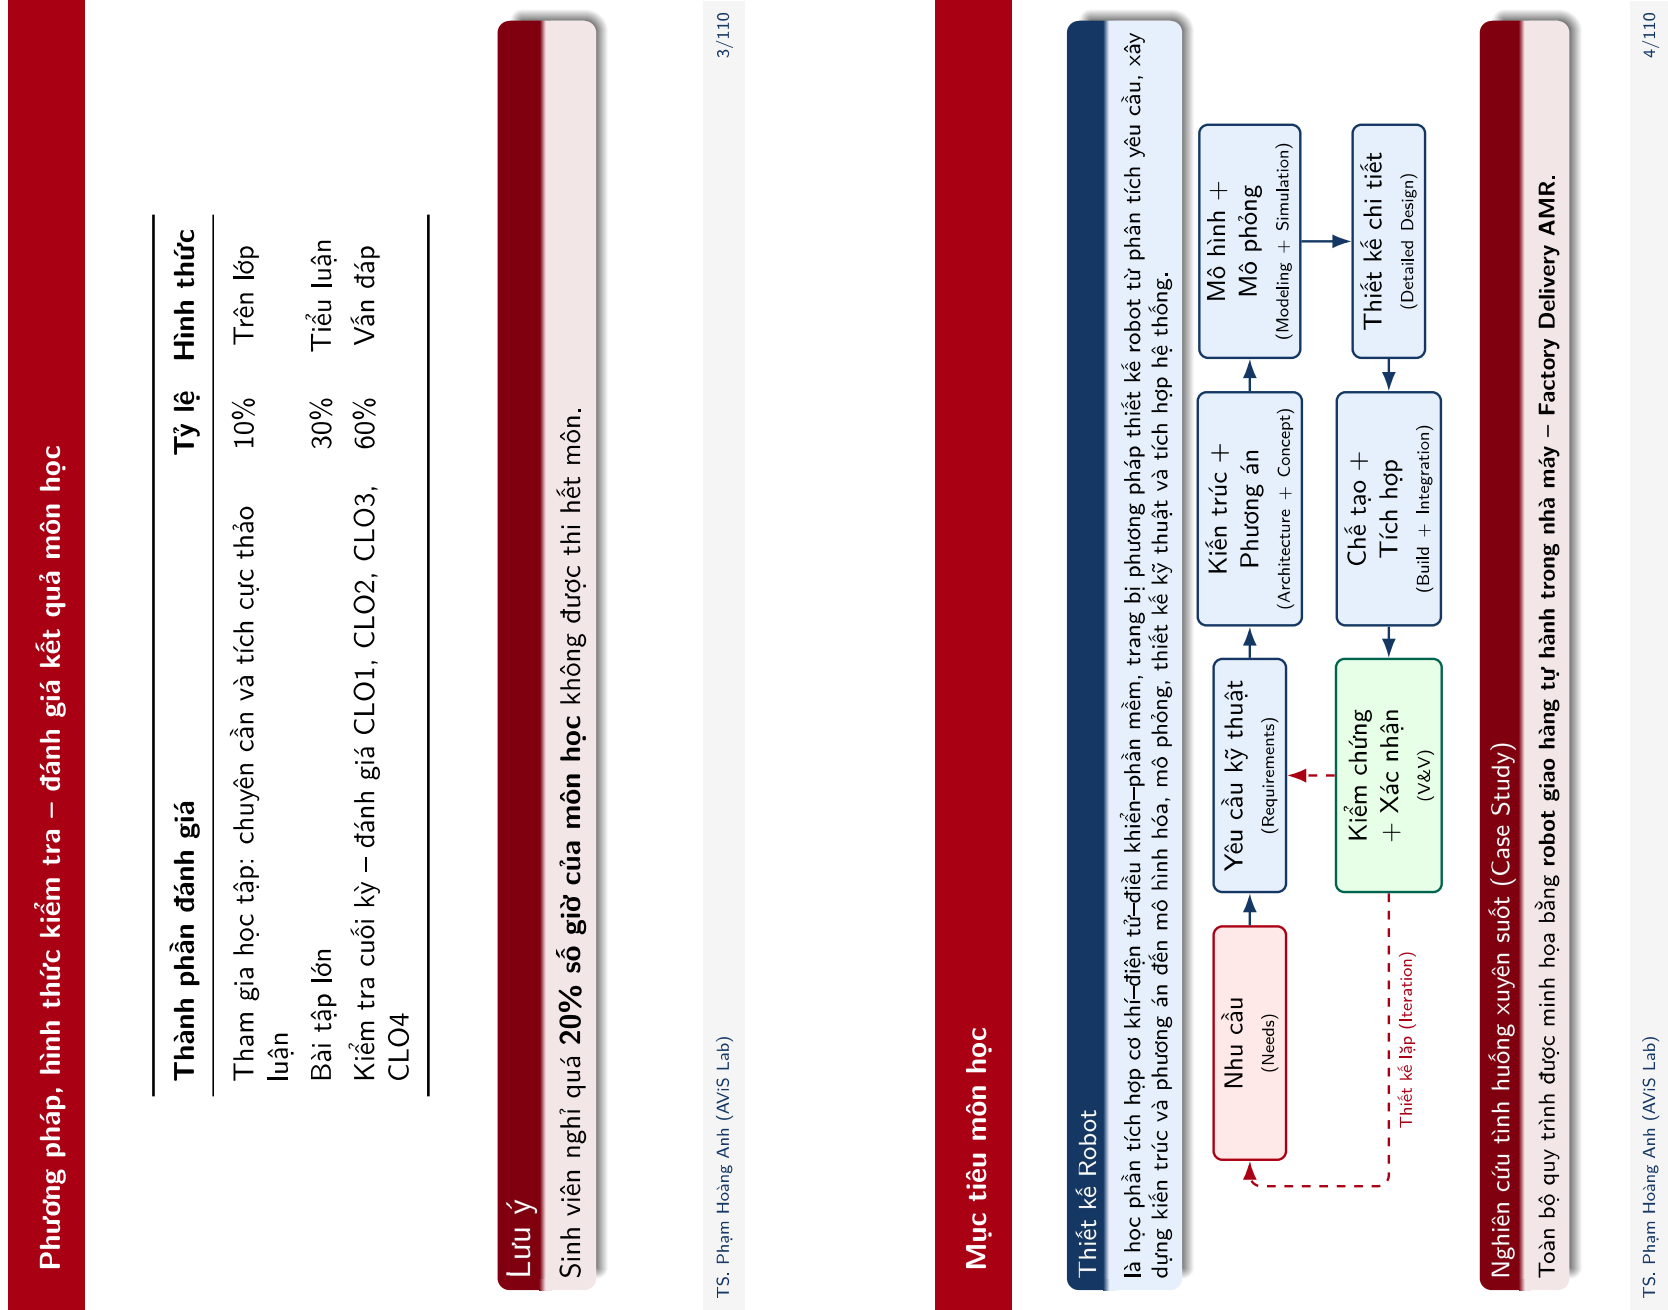
[picture p136: page 2]

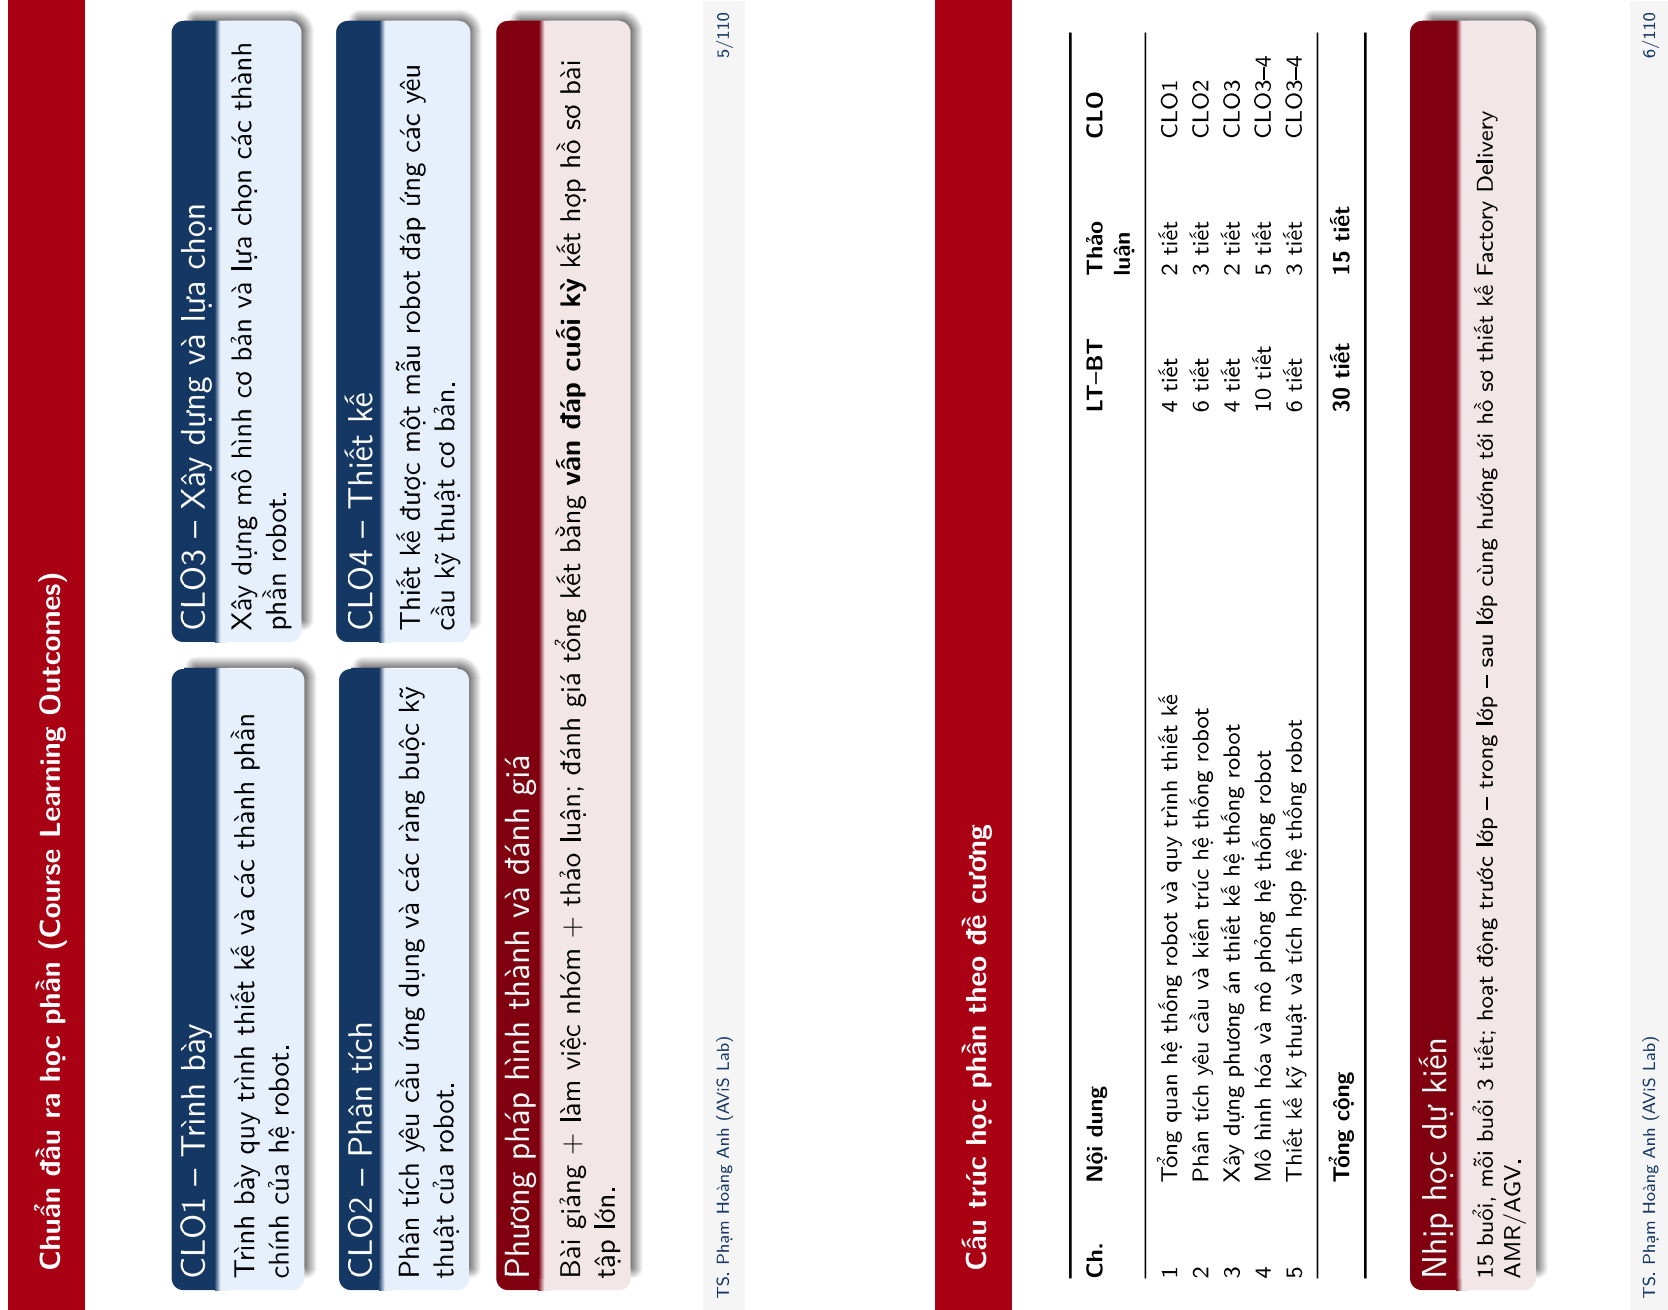
[picture p137: page 3]

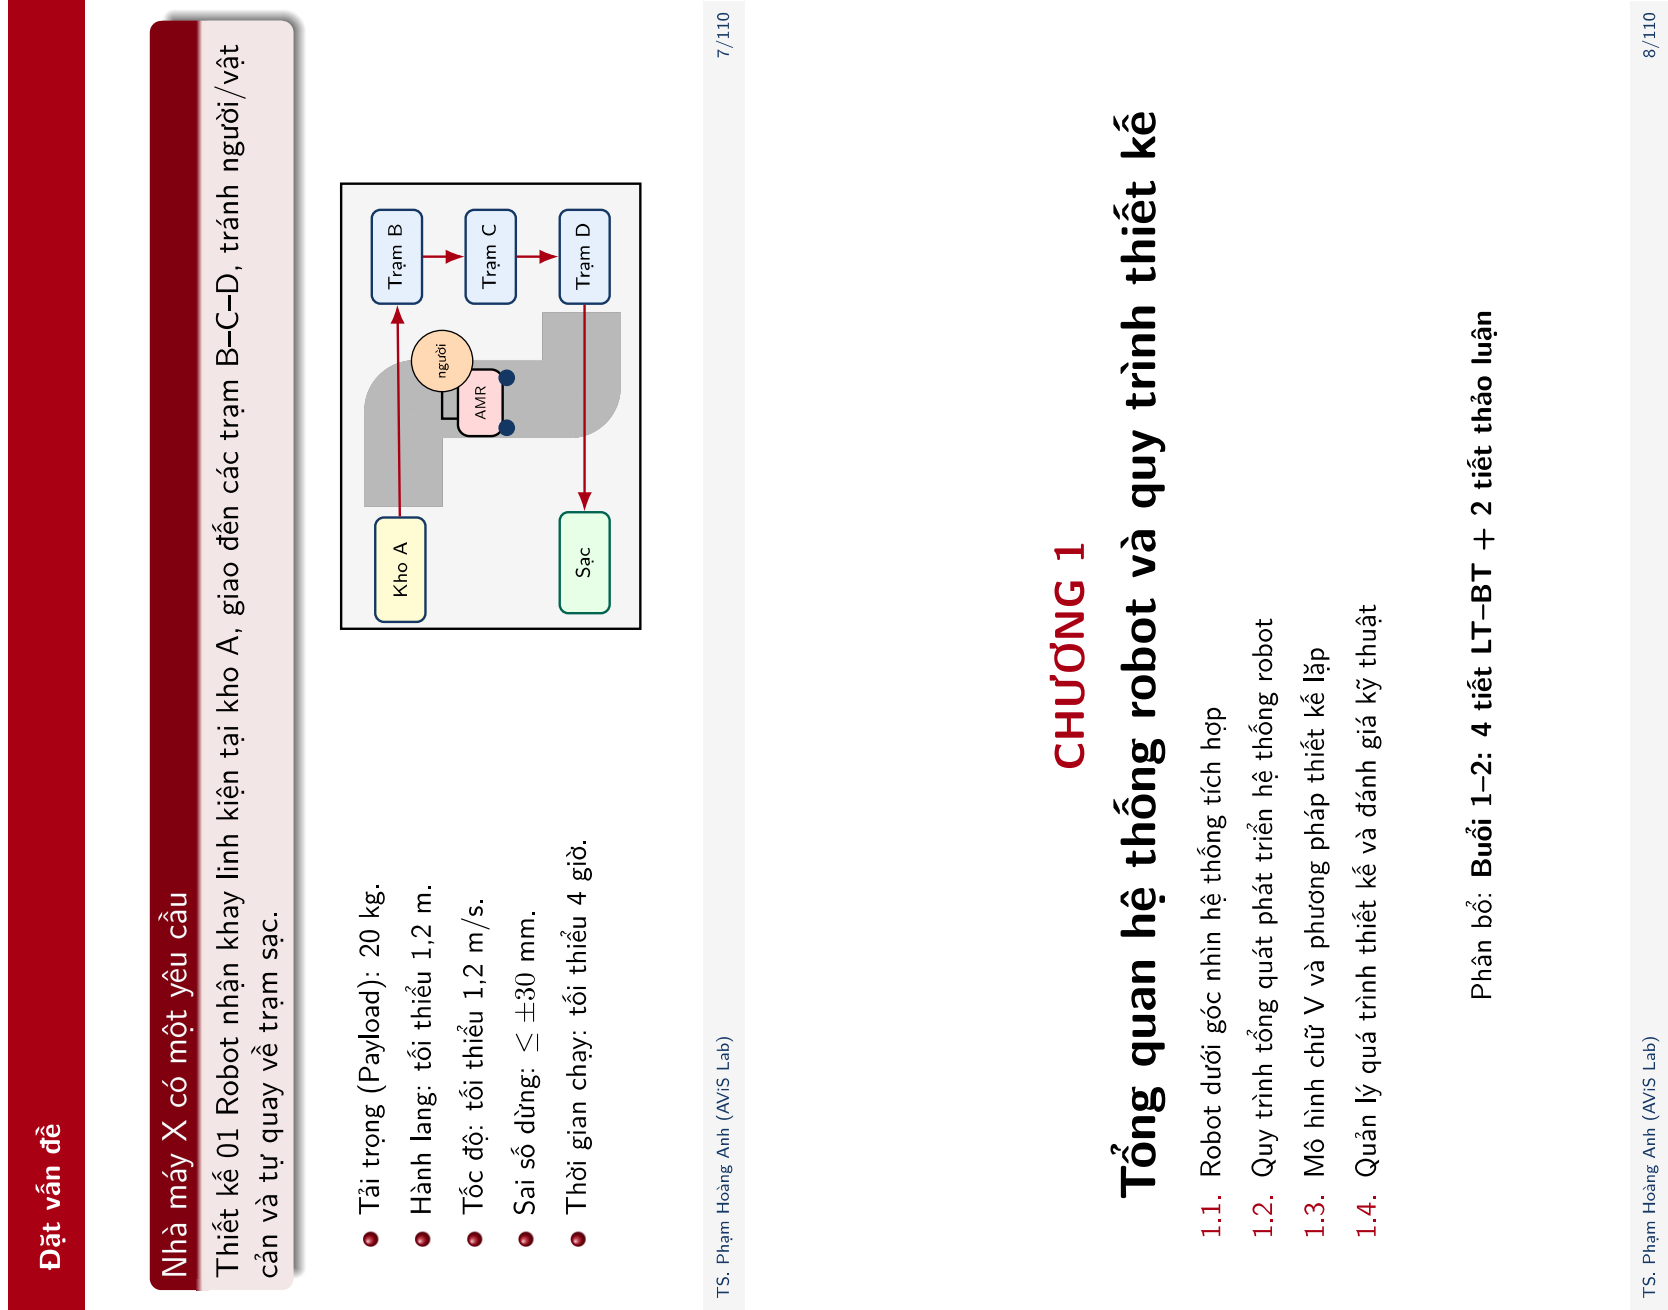
[picture p138: page 4]

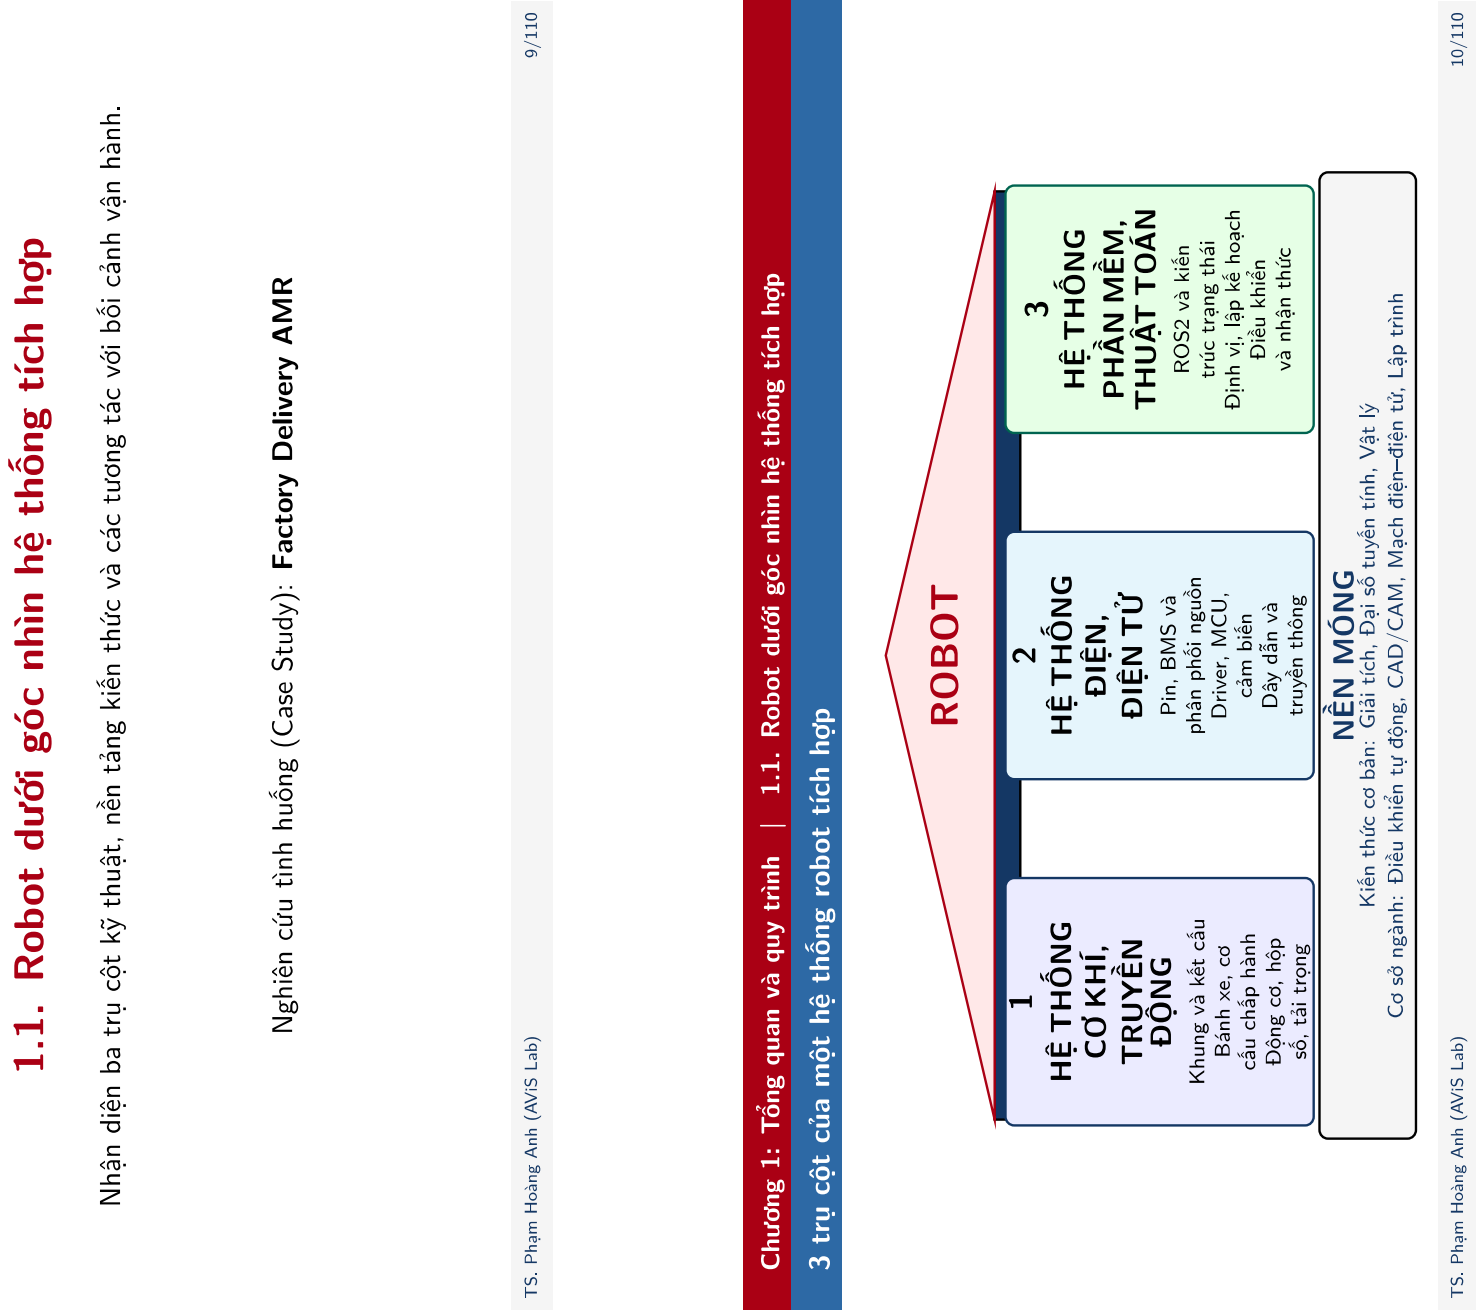
[picture p139: page 5]

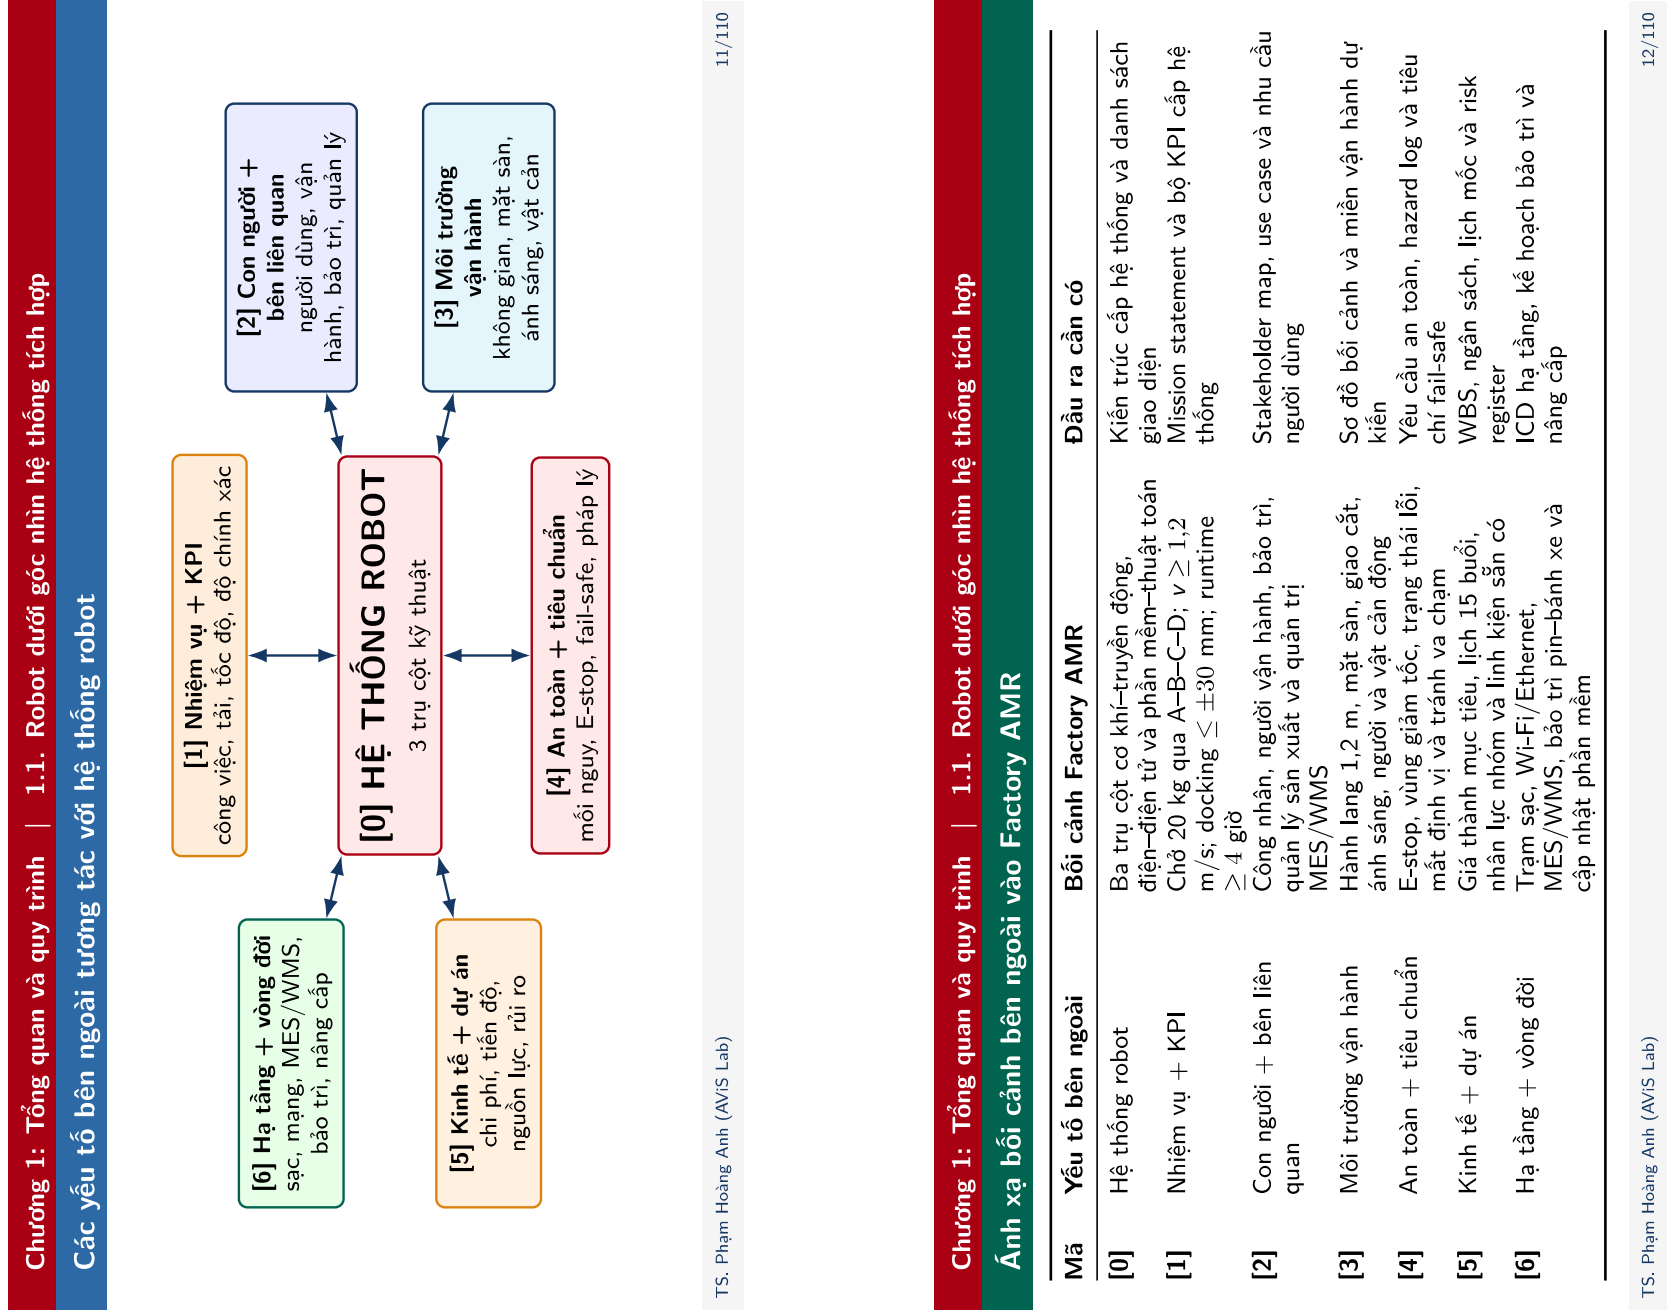
[picture p140: page 6]

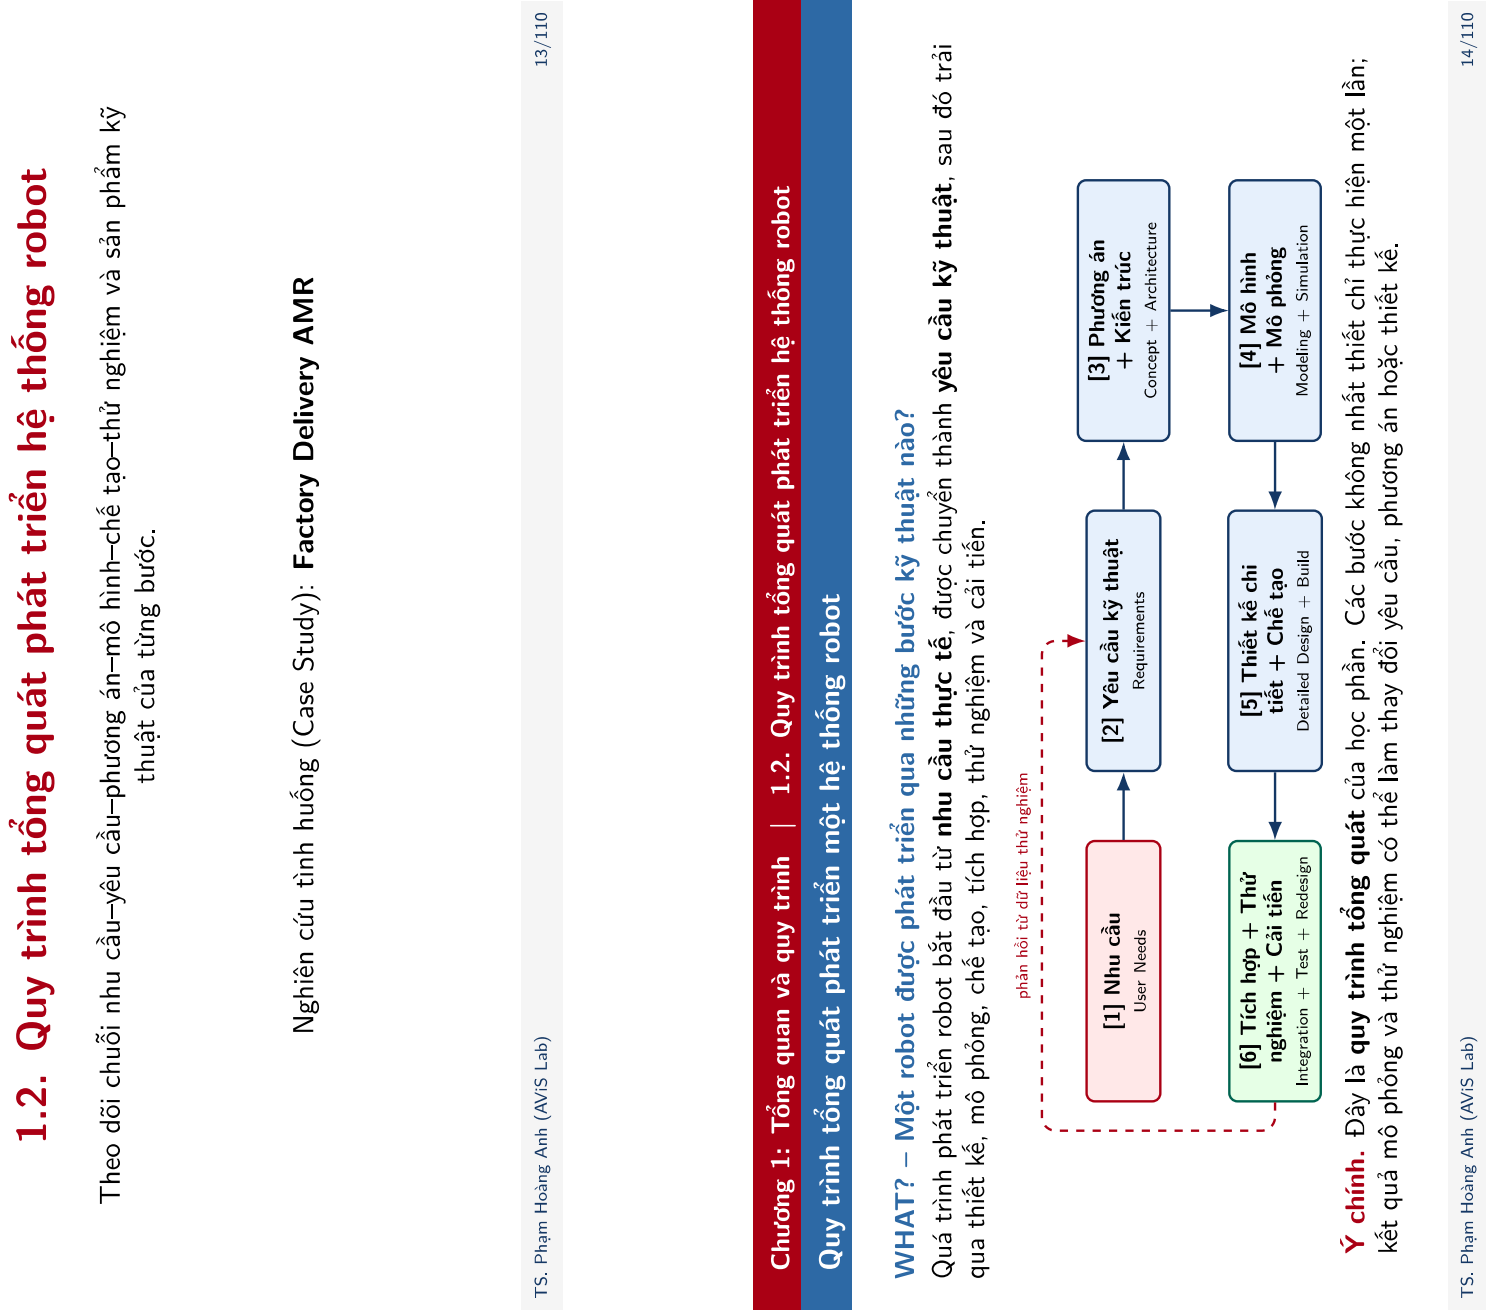
[picture p141: page 7]

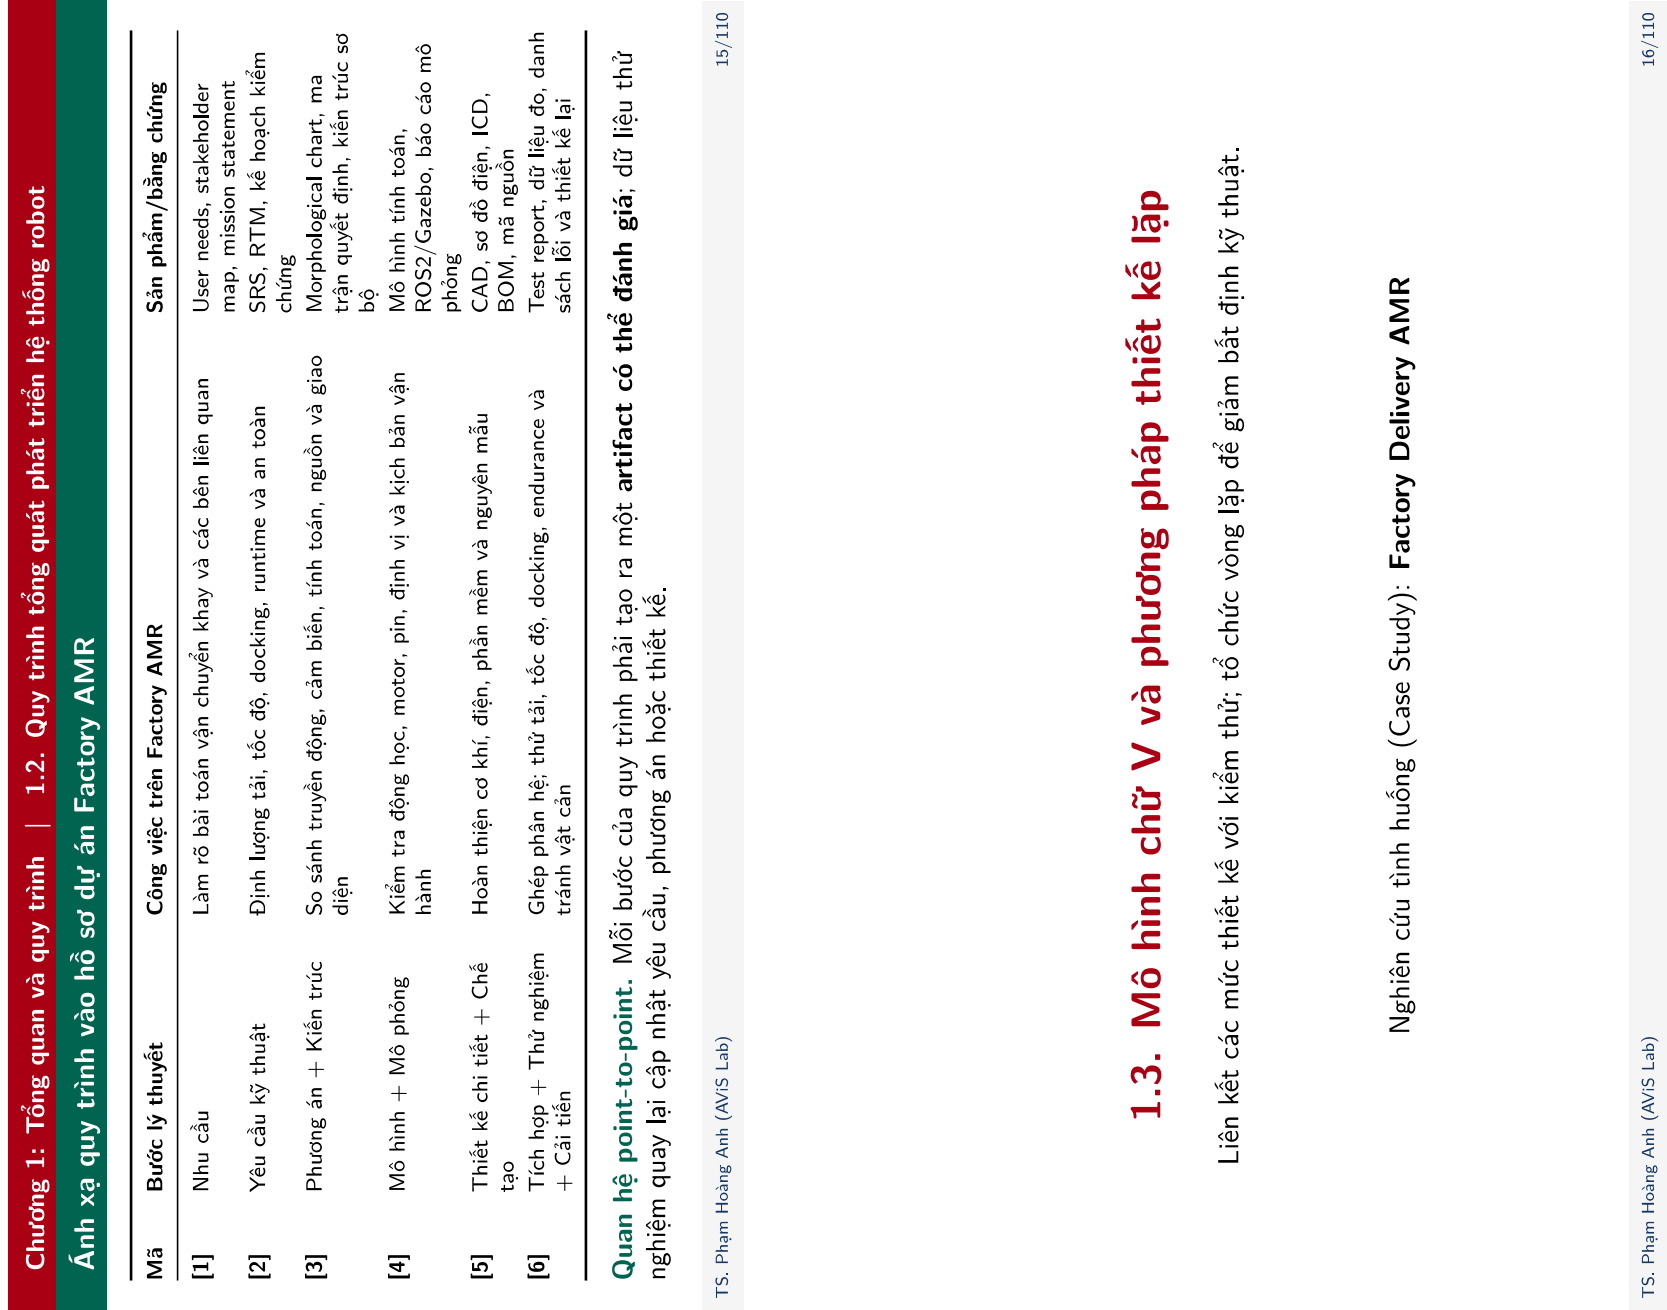
[picture p142: page 8]

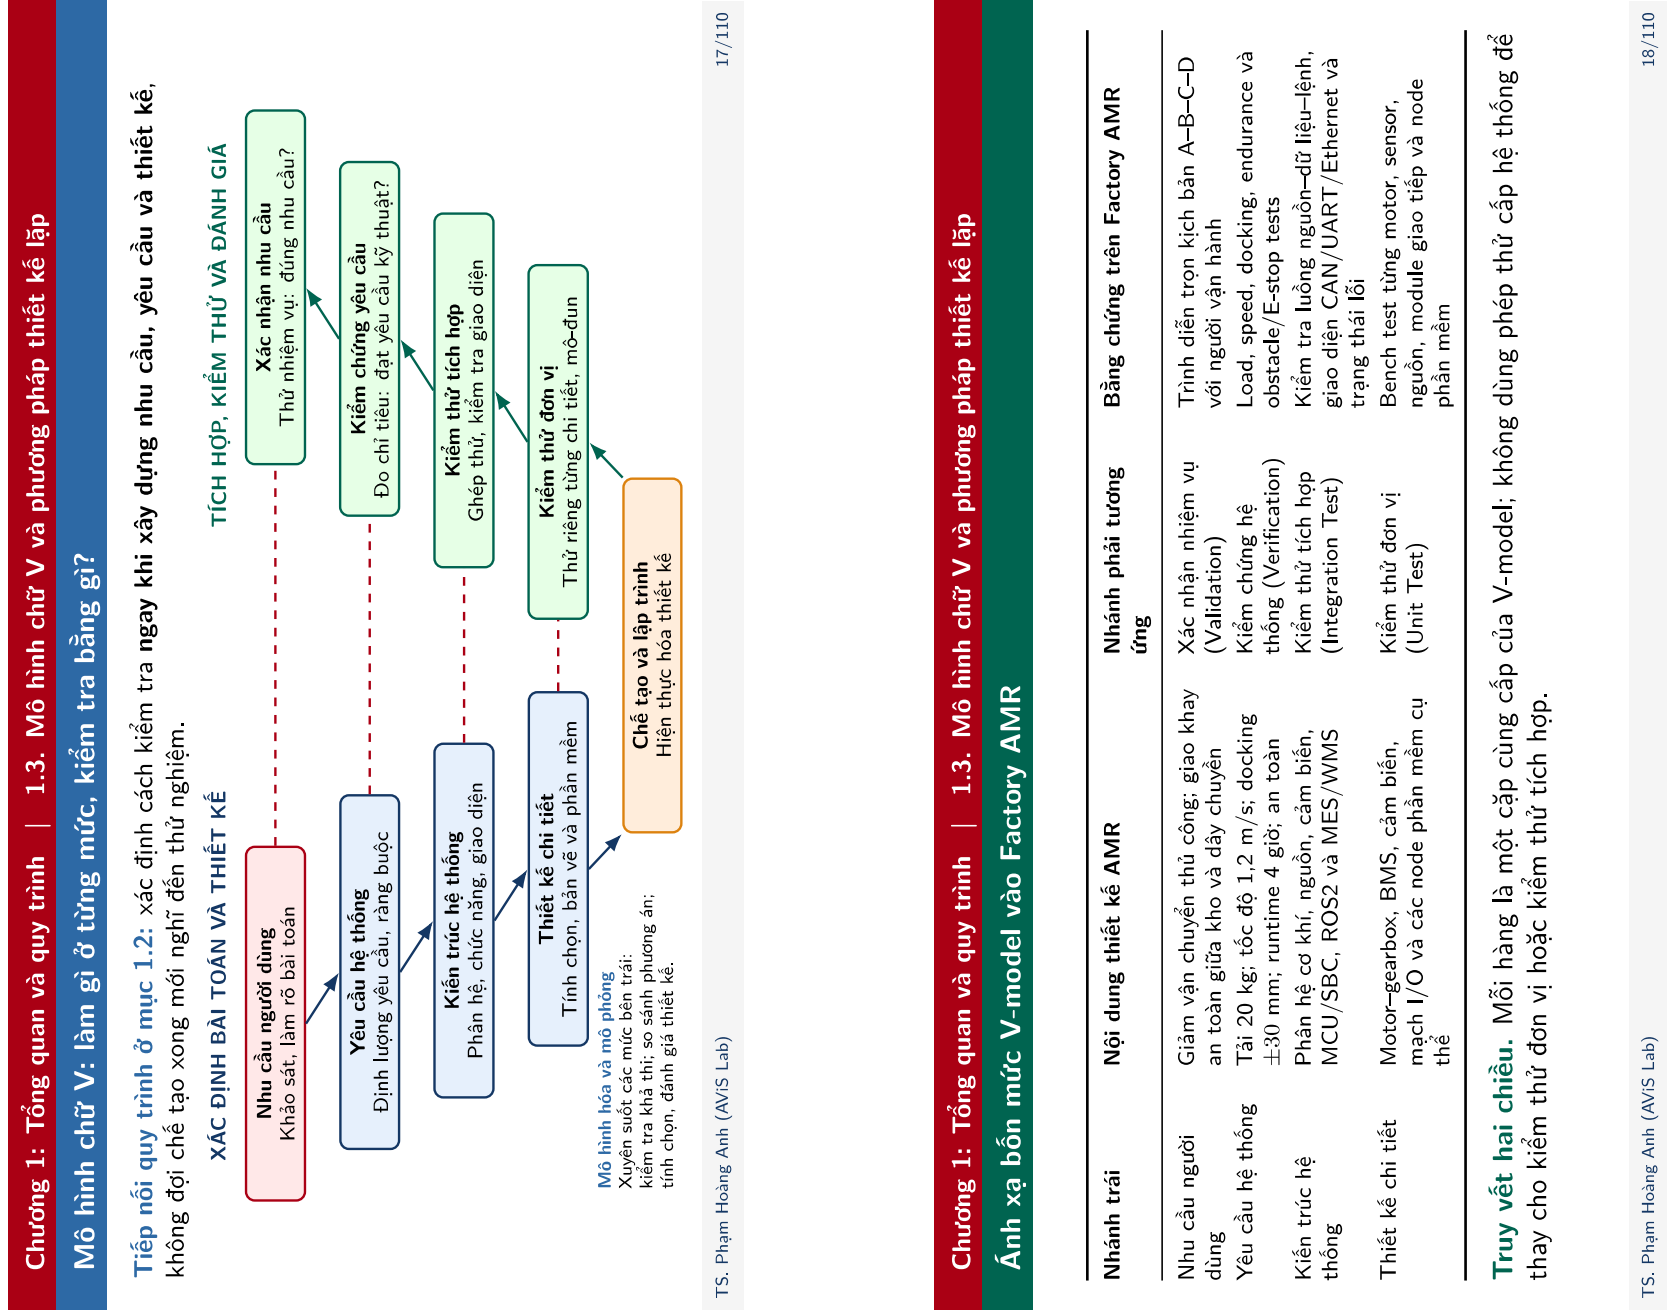
[picture p143: page 9]

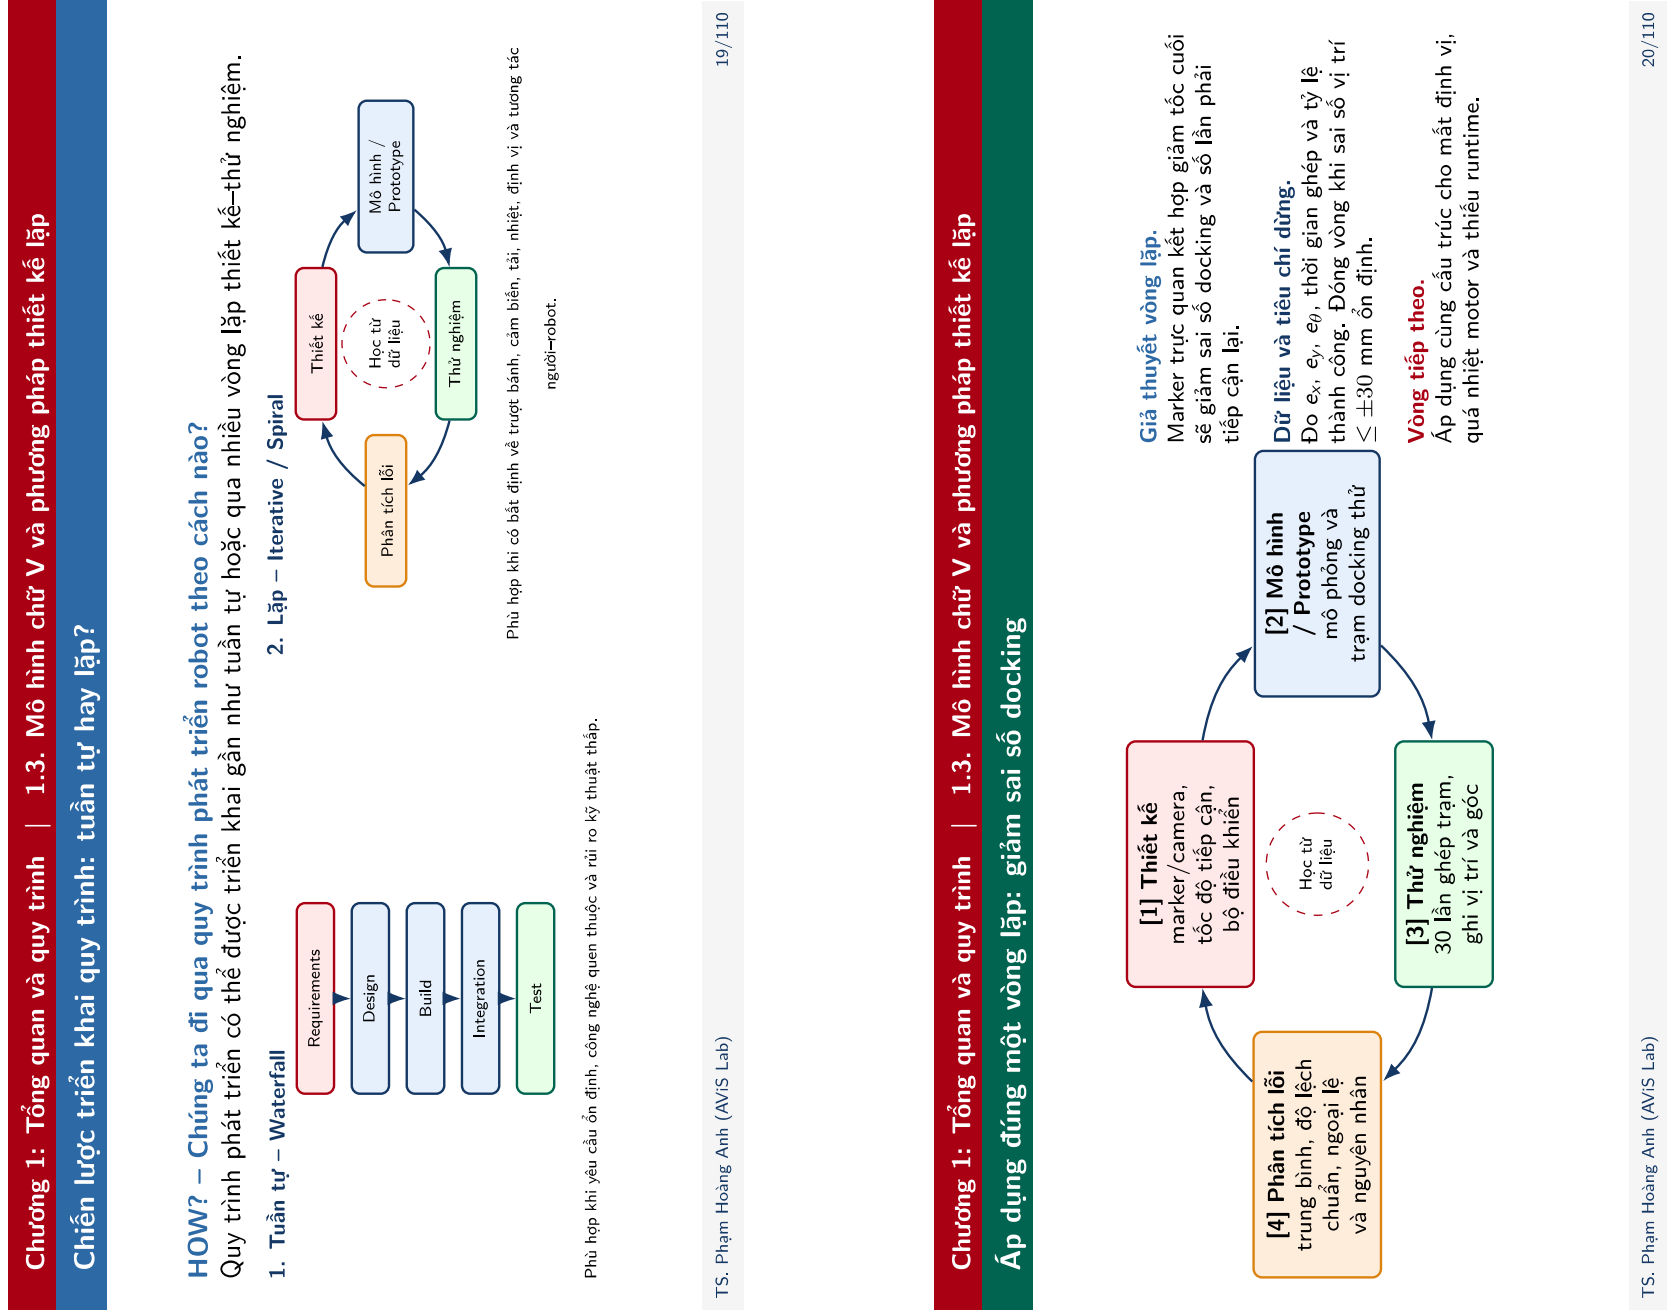
[picture p144: page 10]

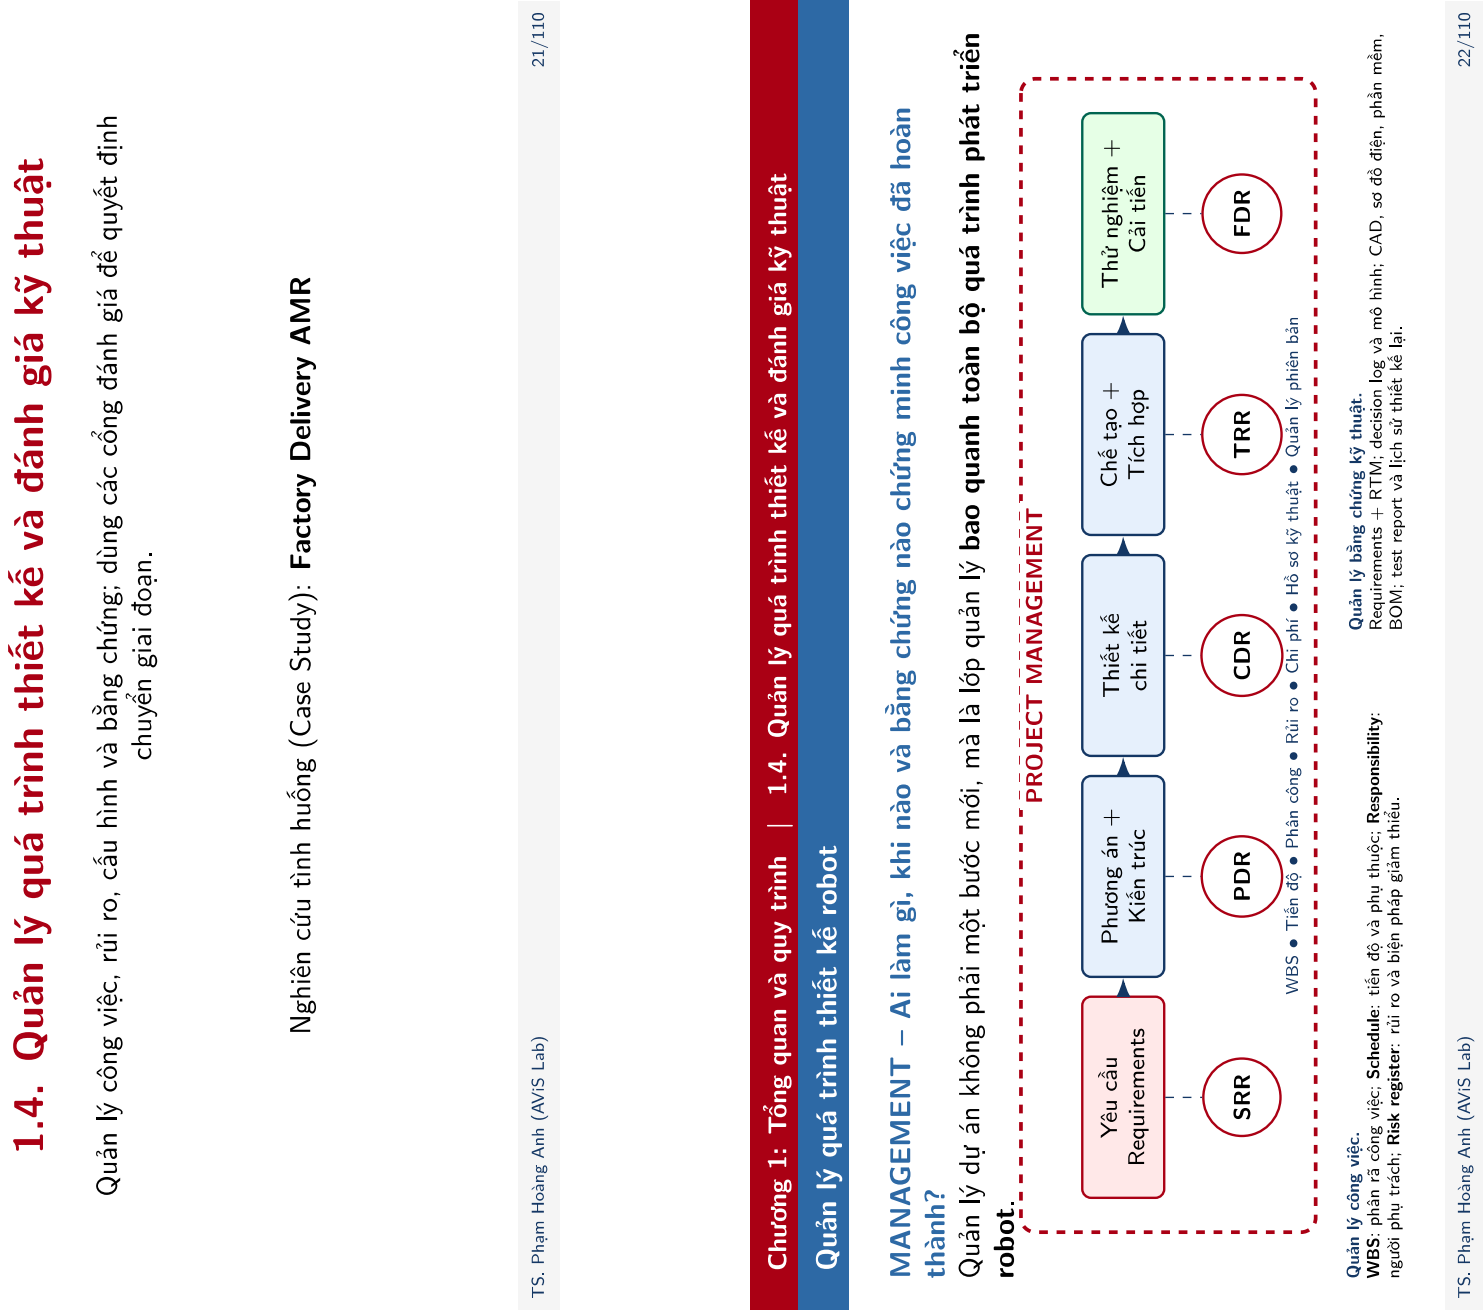
[picture p145: page 11]

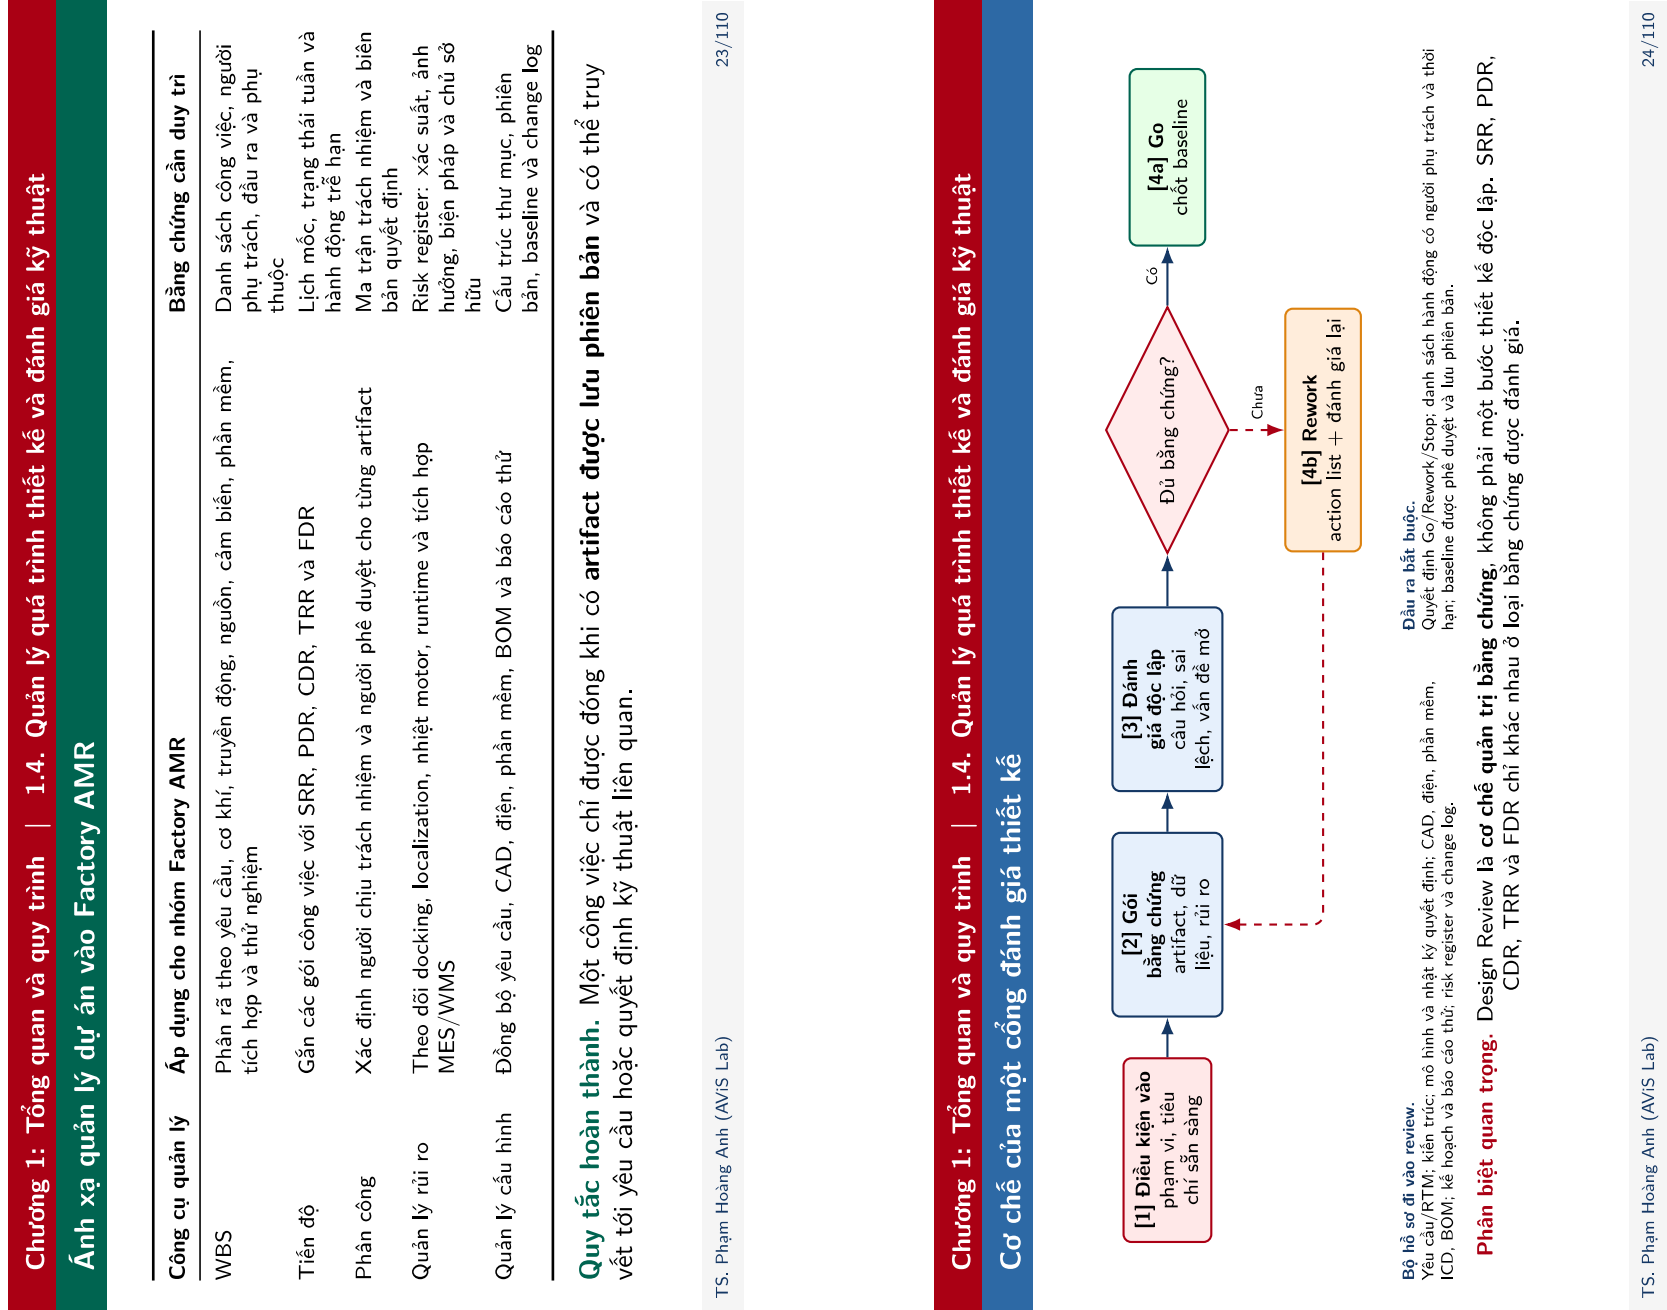
[picture p146: page 12]

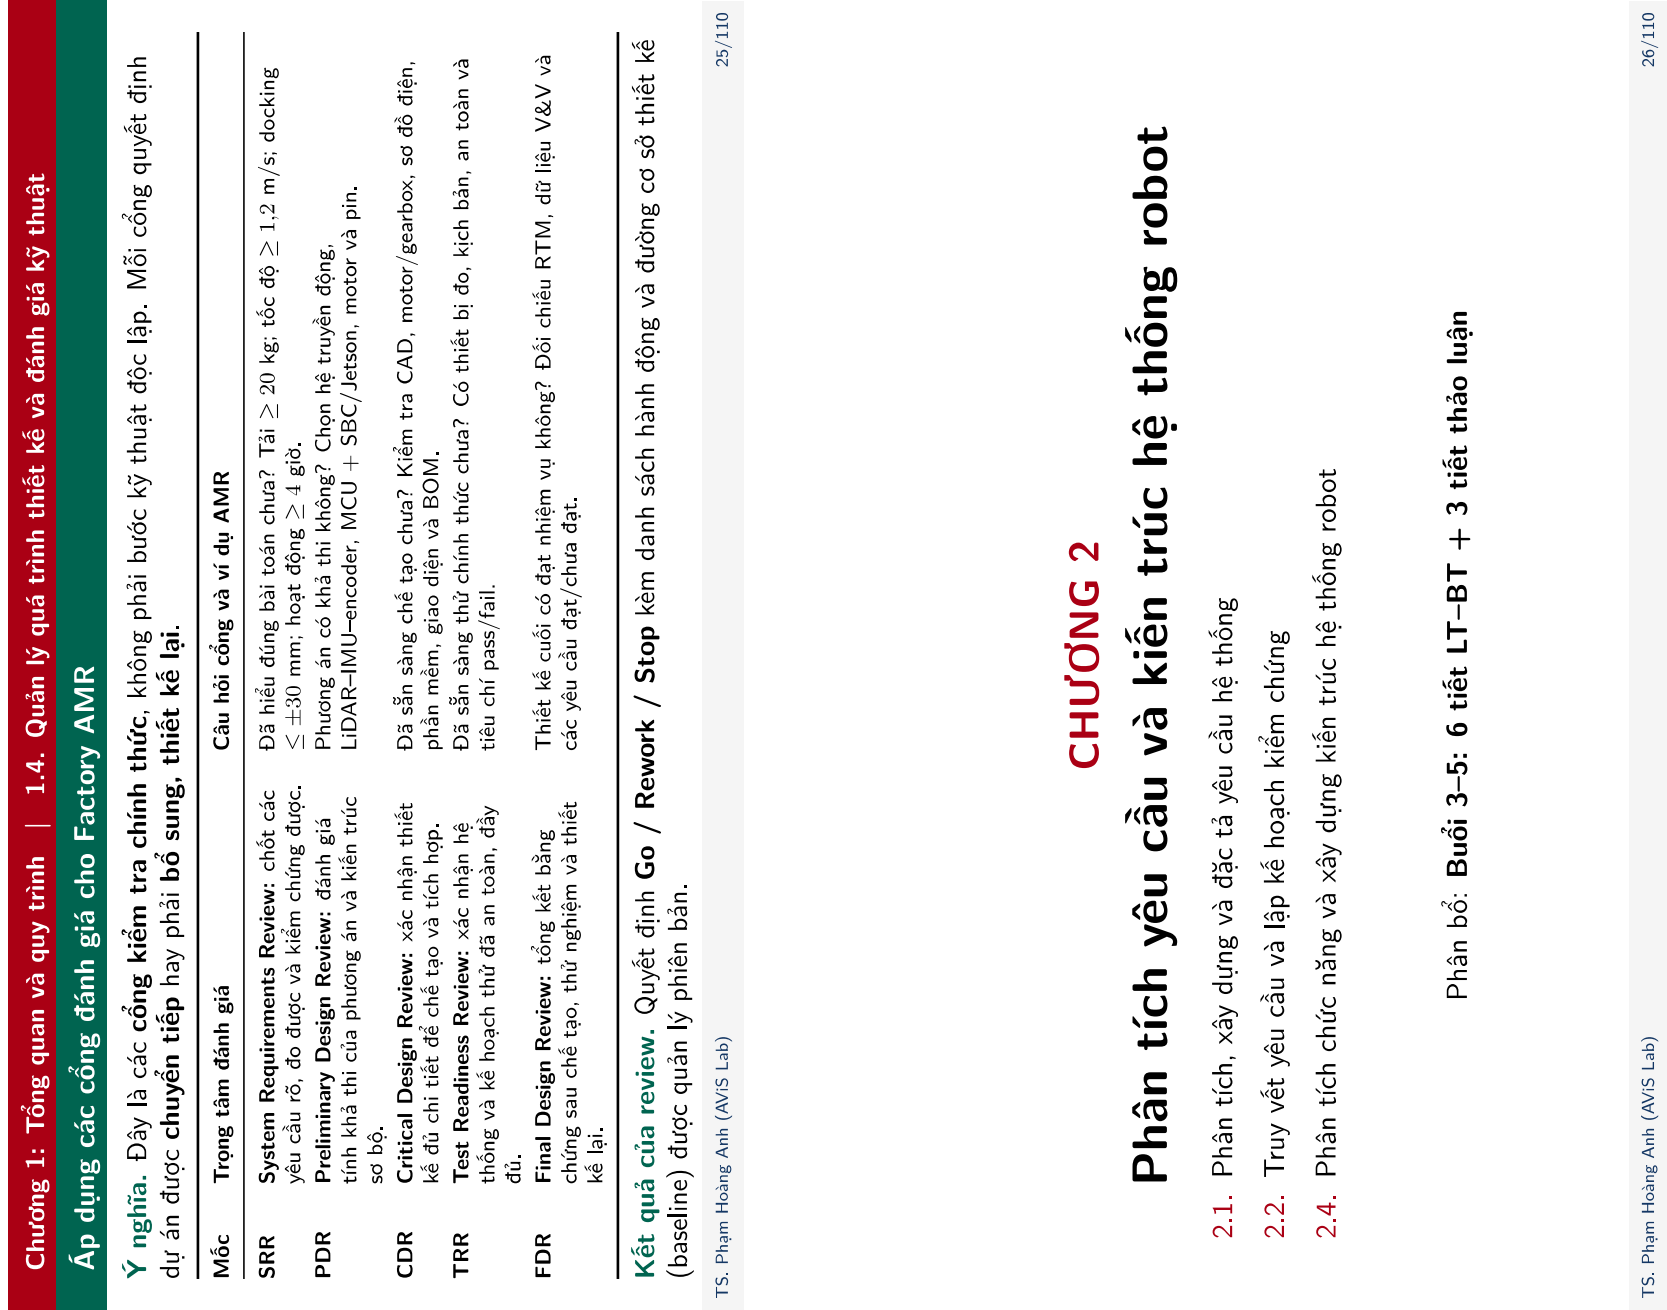
[picture p147: page 13]

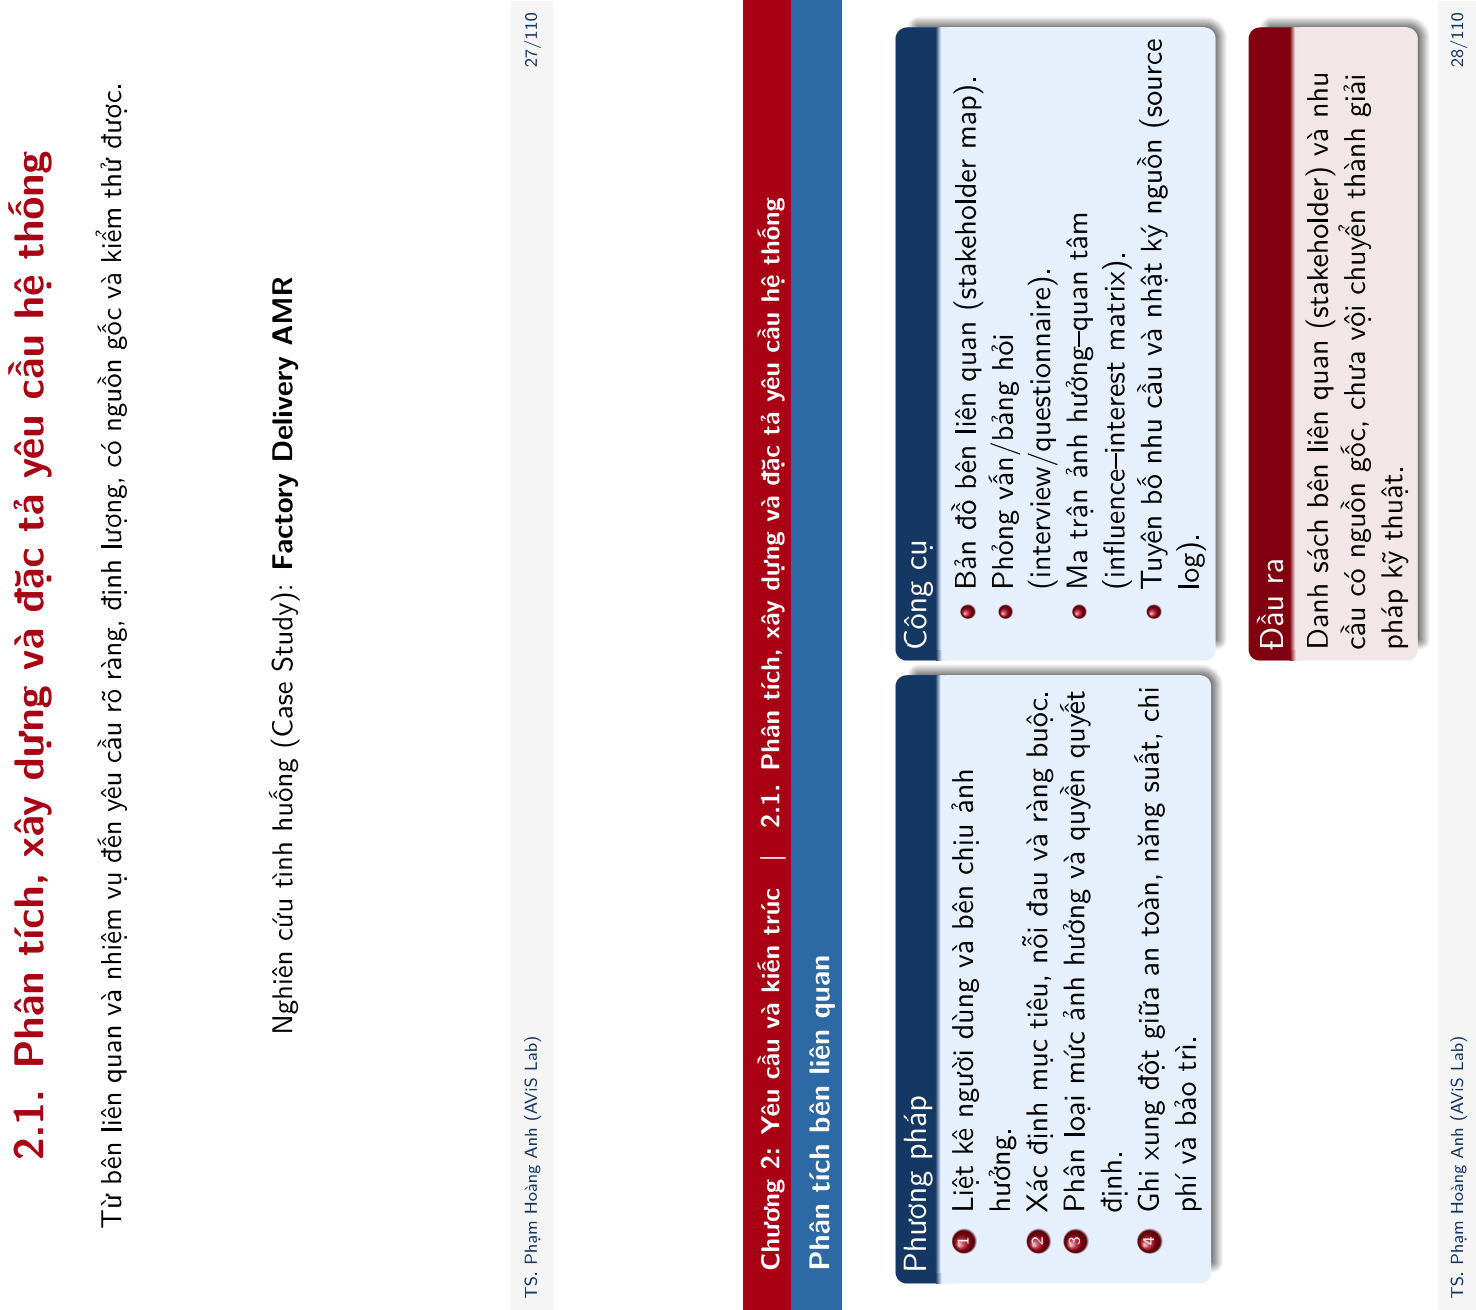
[picture p148: page 14]

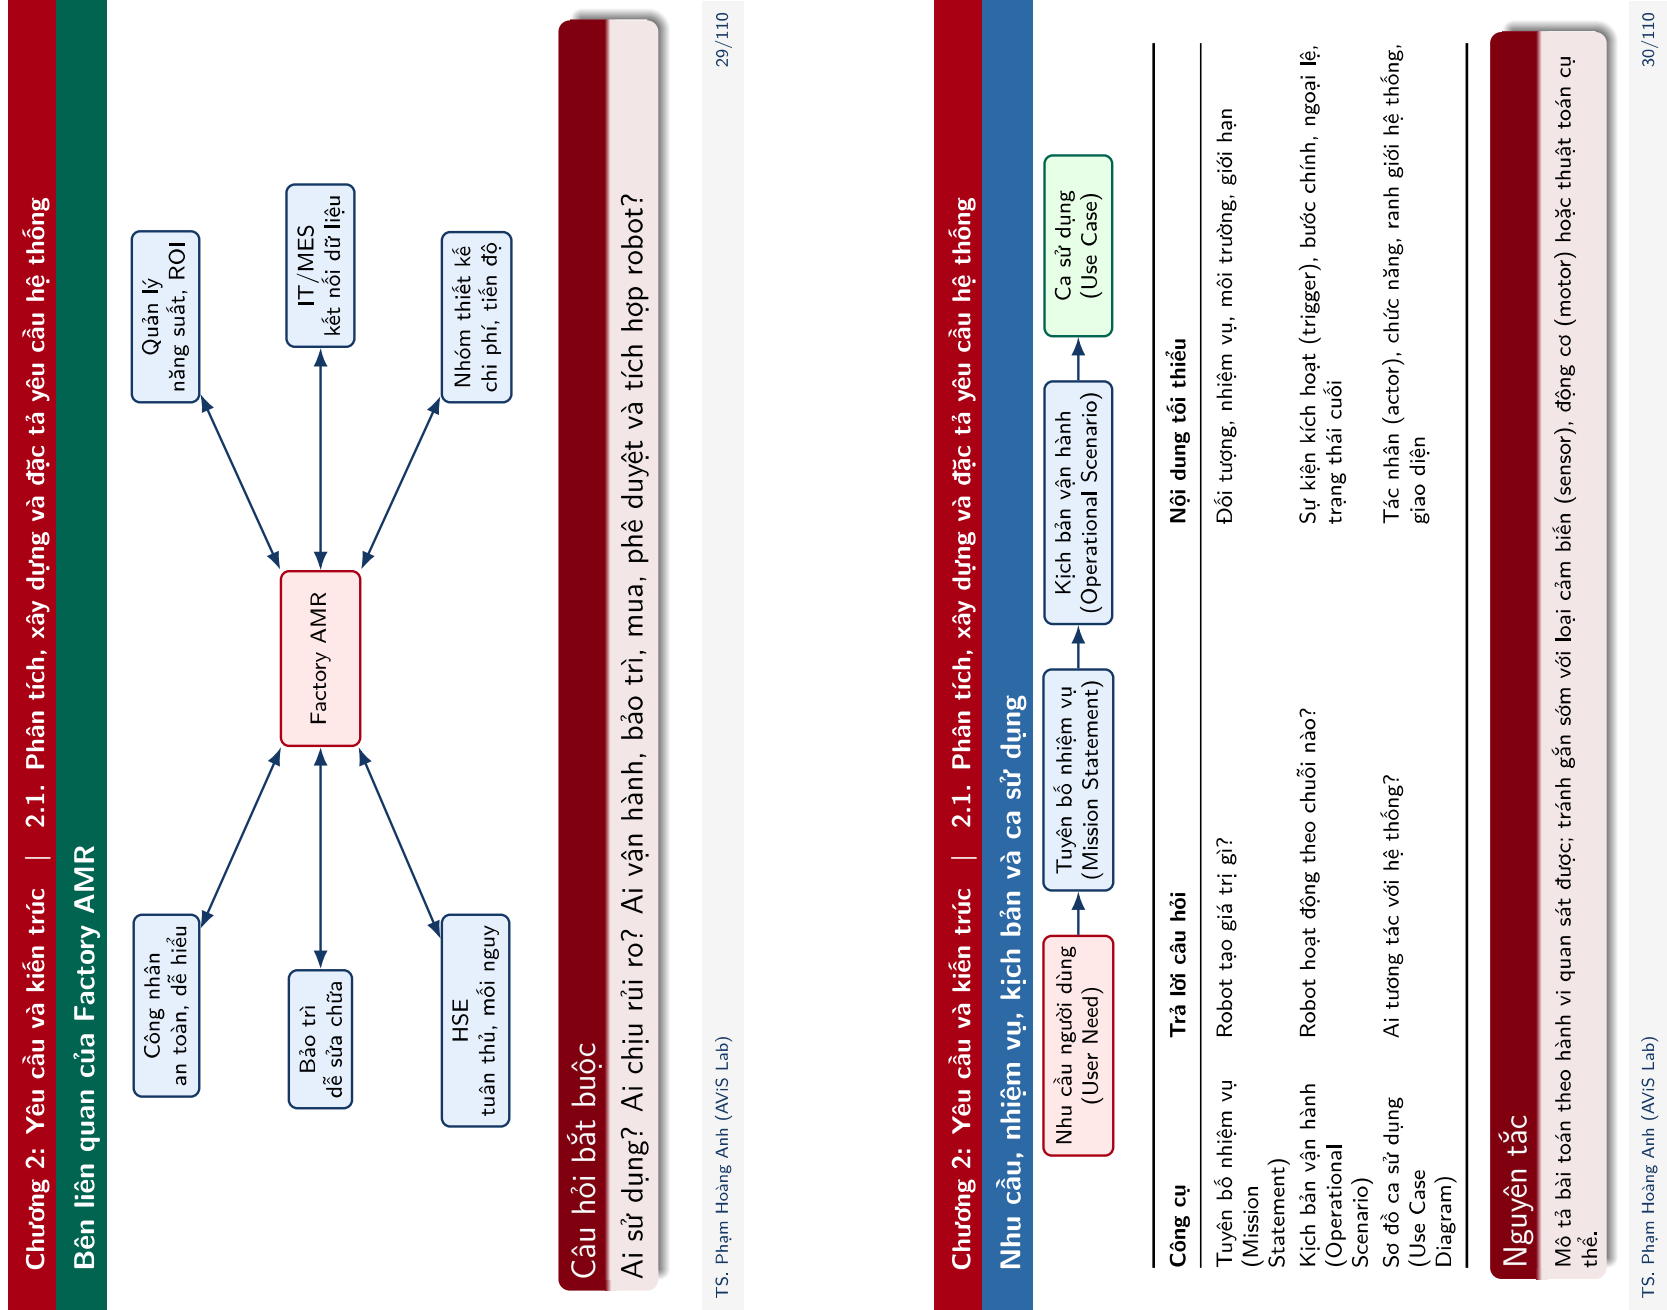
[picture p149: page 15]

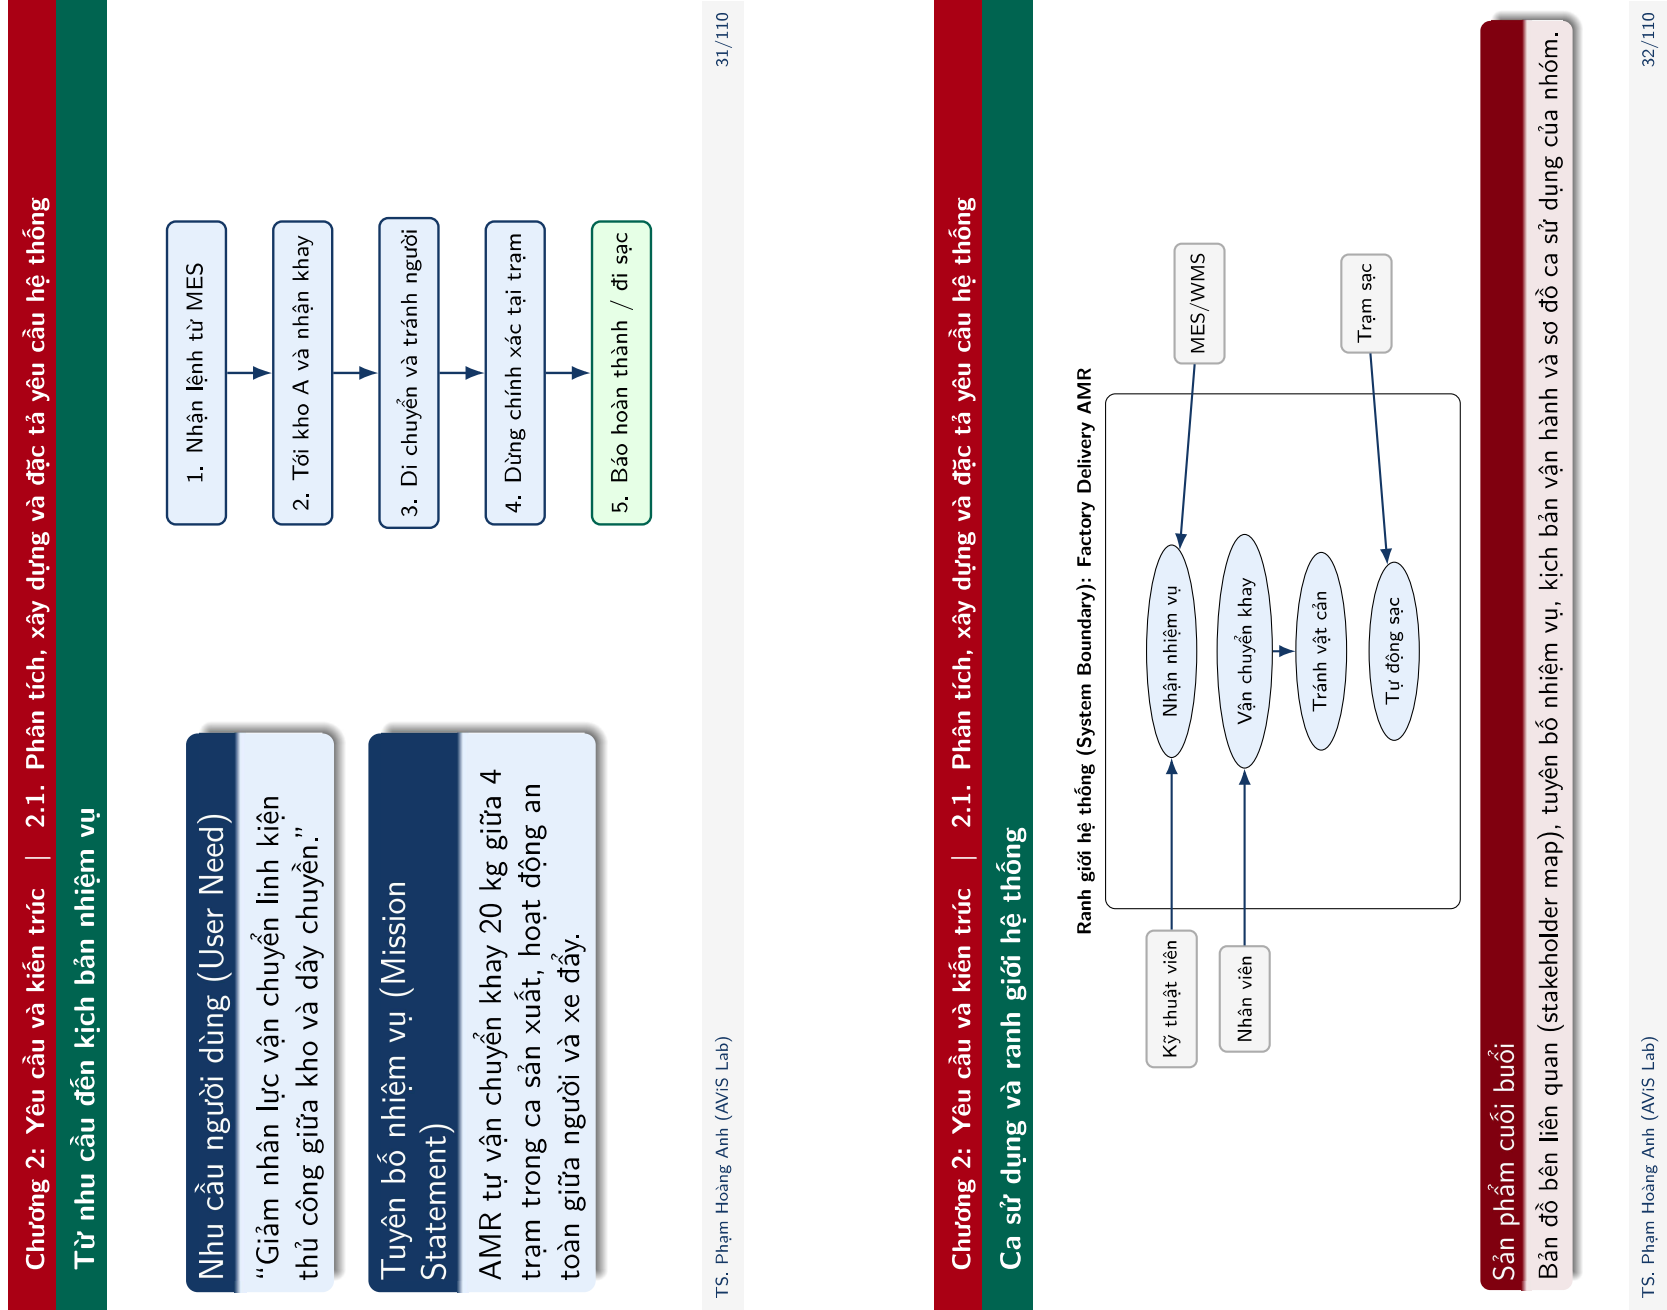
[picture p150: page 16]

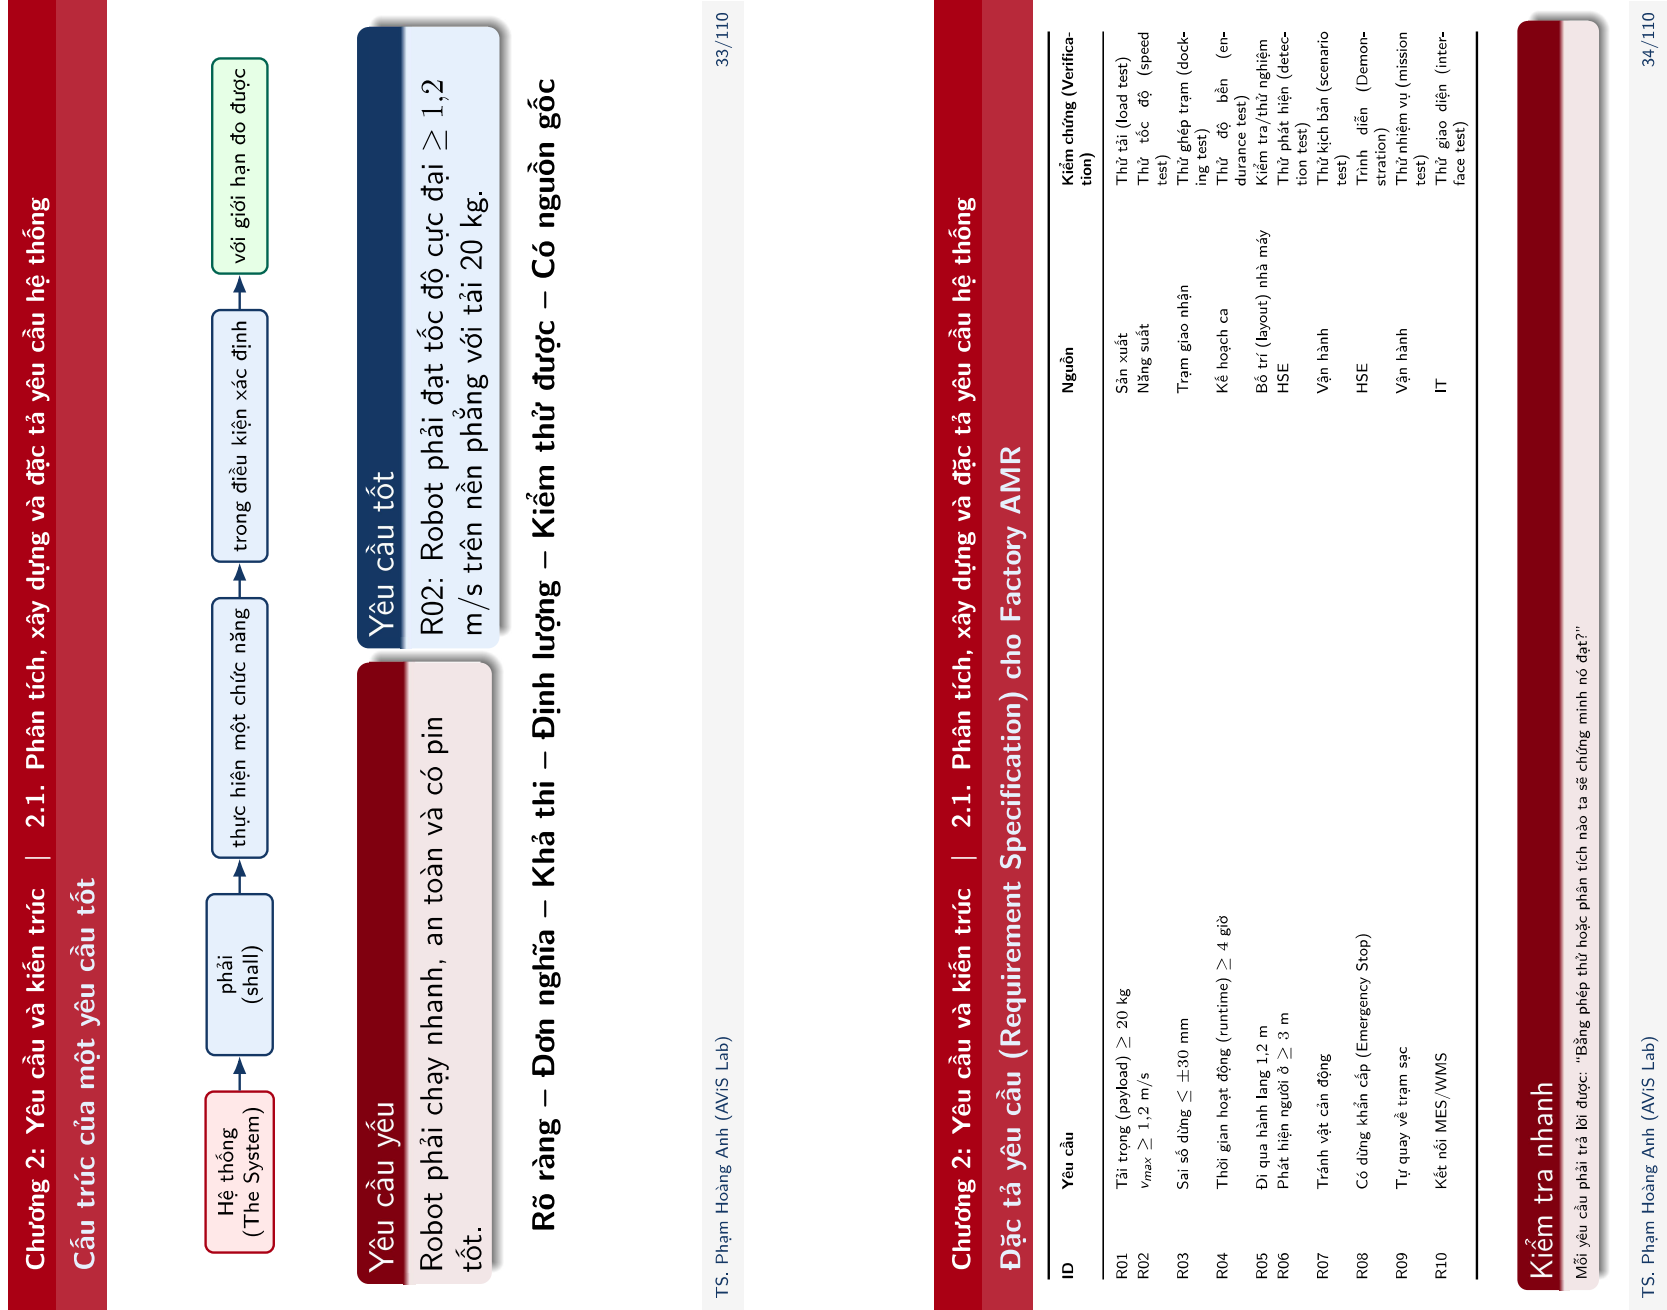
[picture p151: page 17]

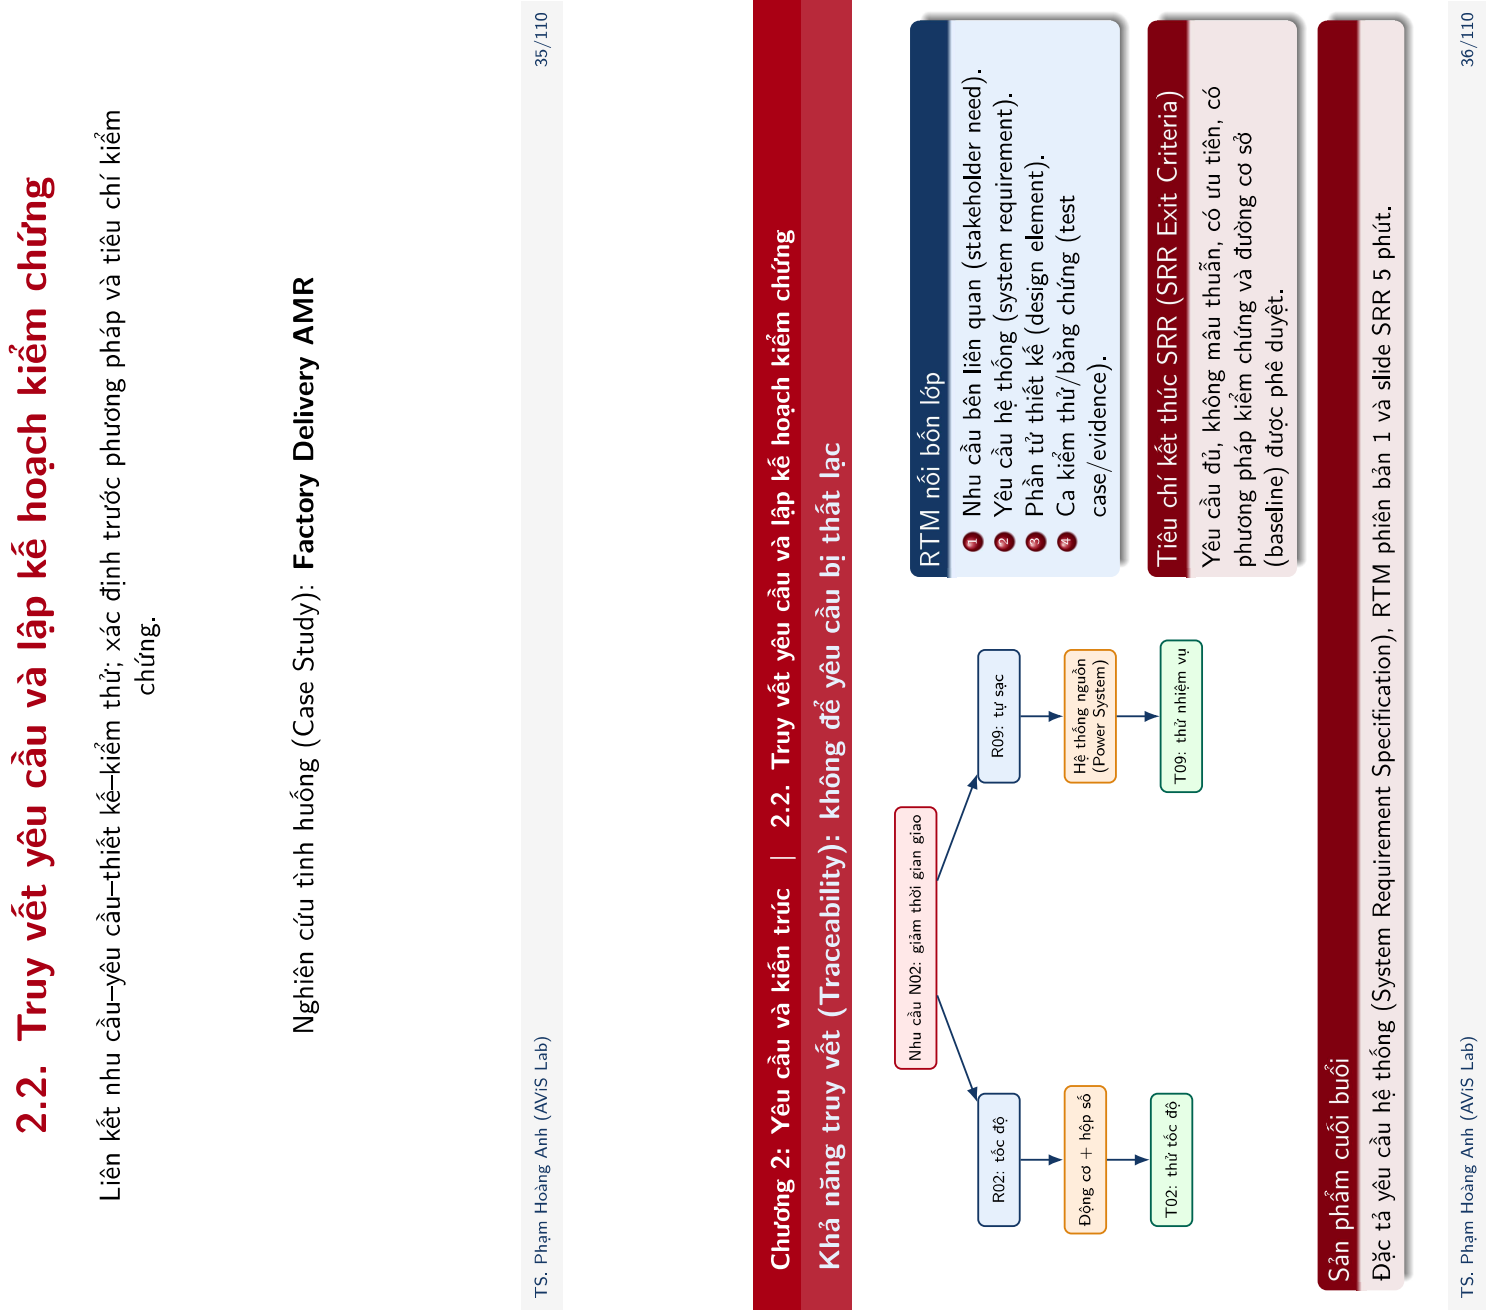
[picture p152: page 18]

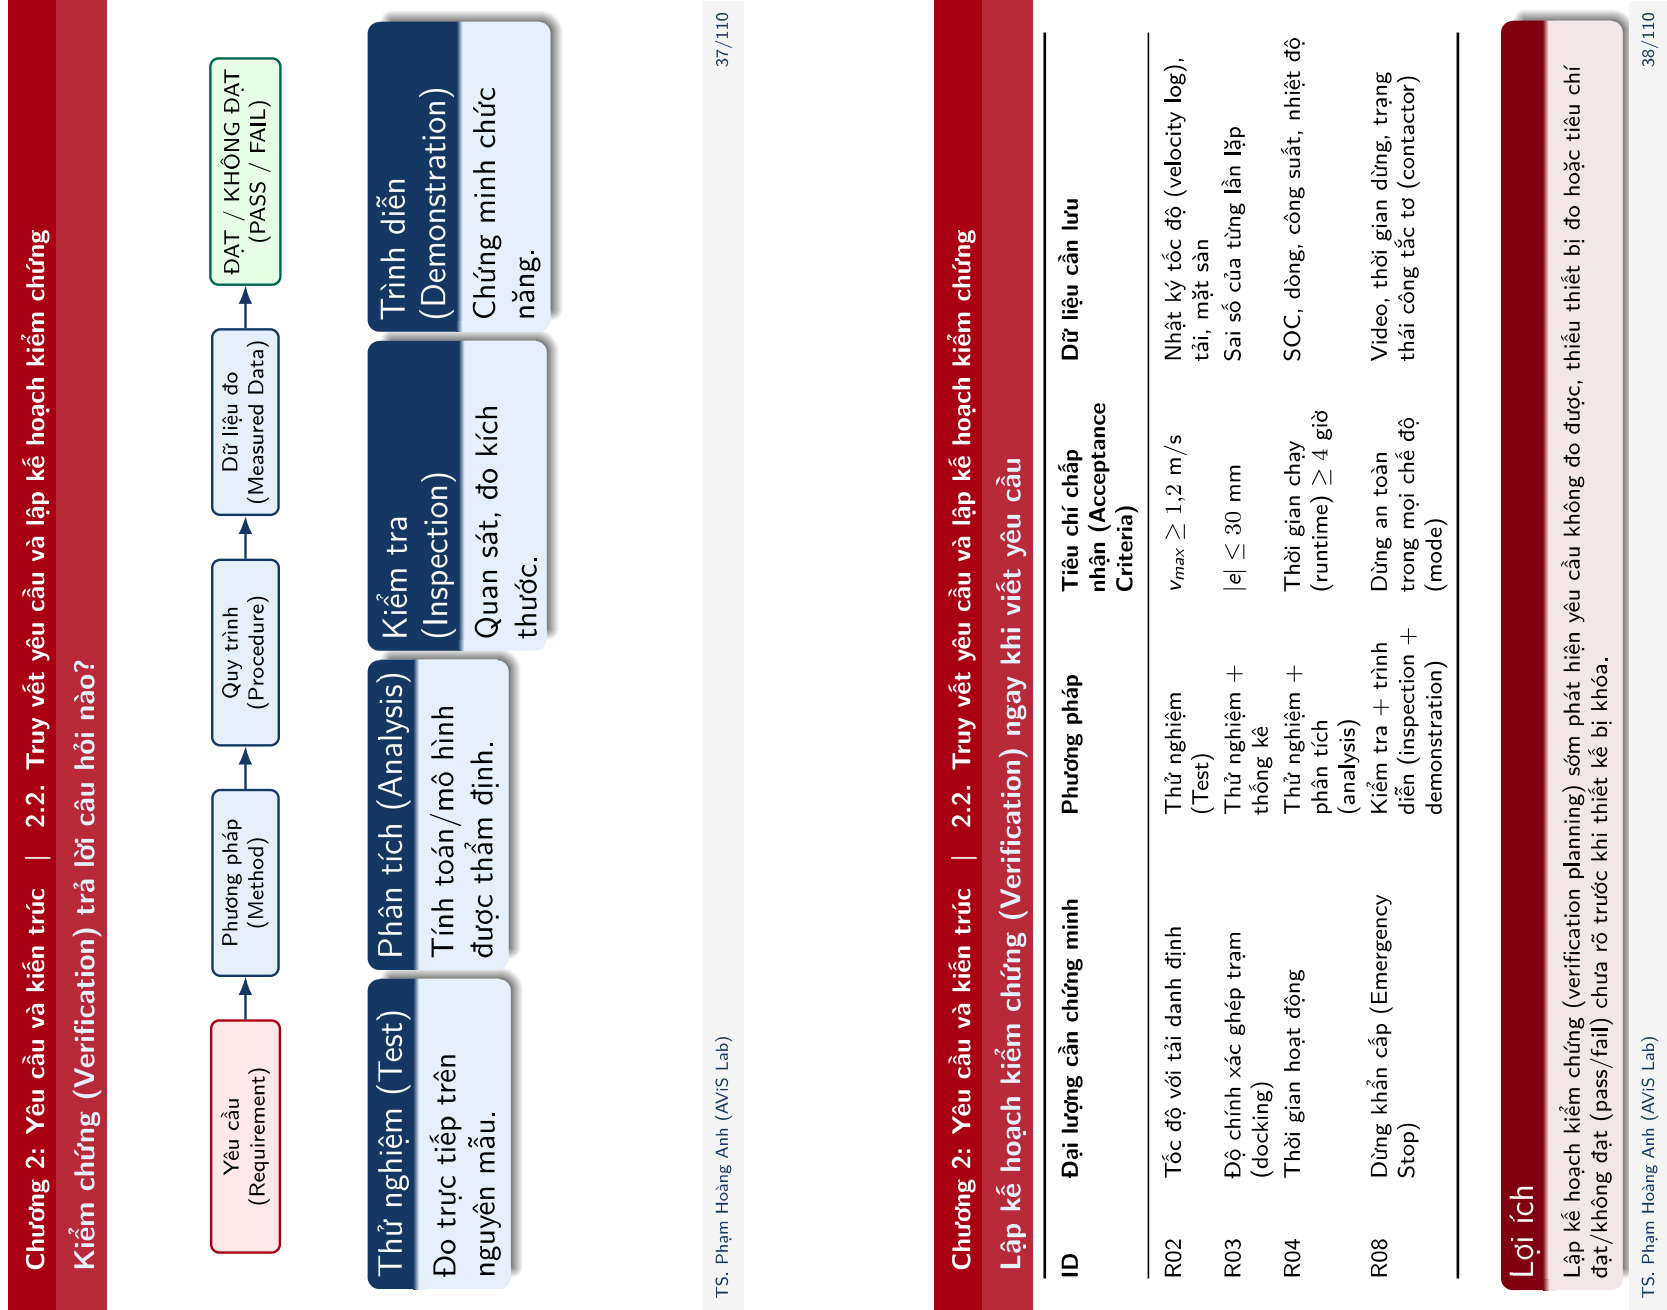
[picture p153: page 19]

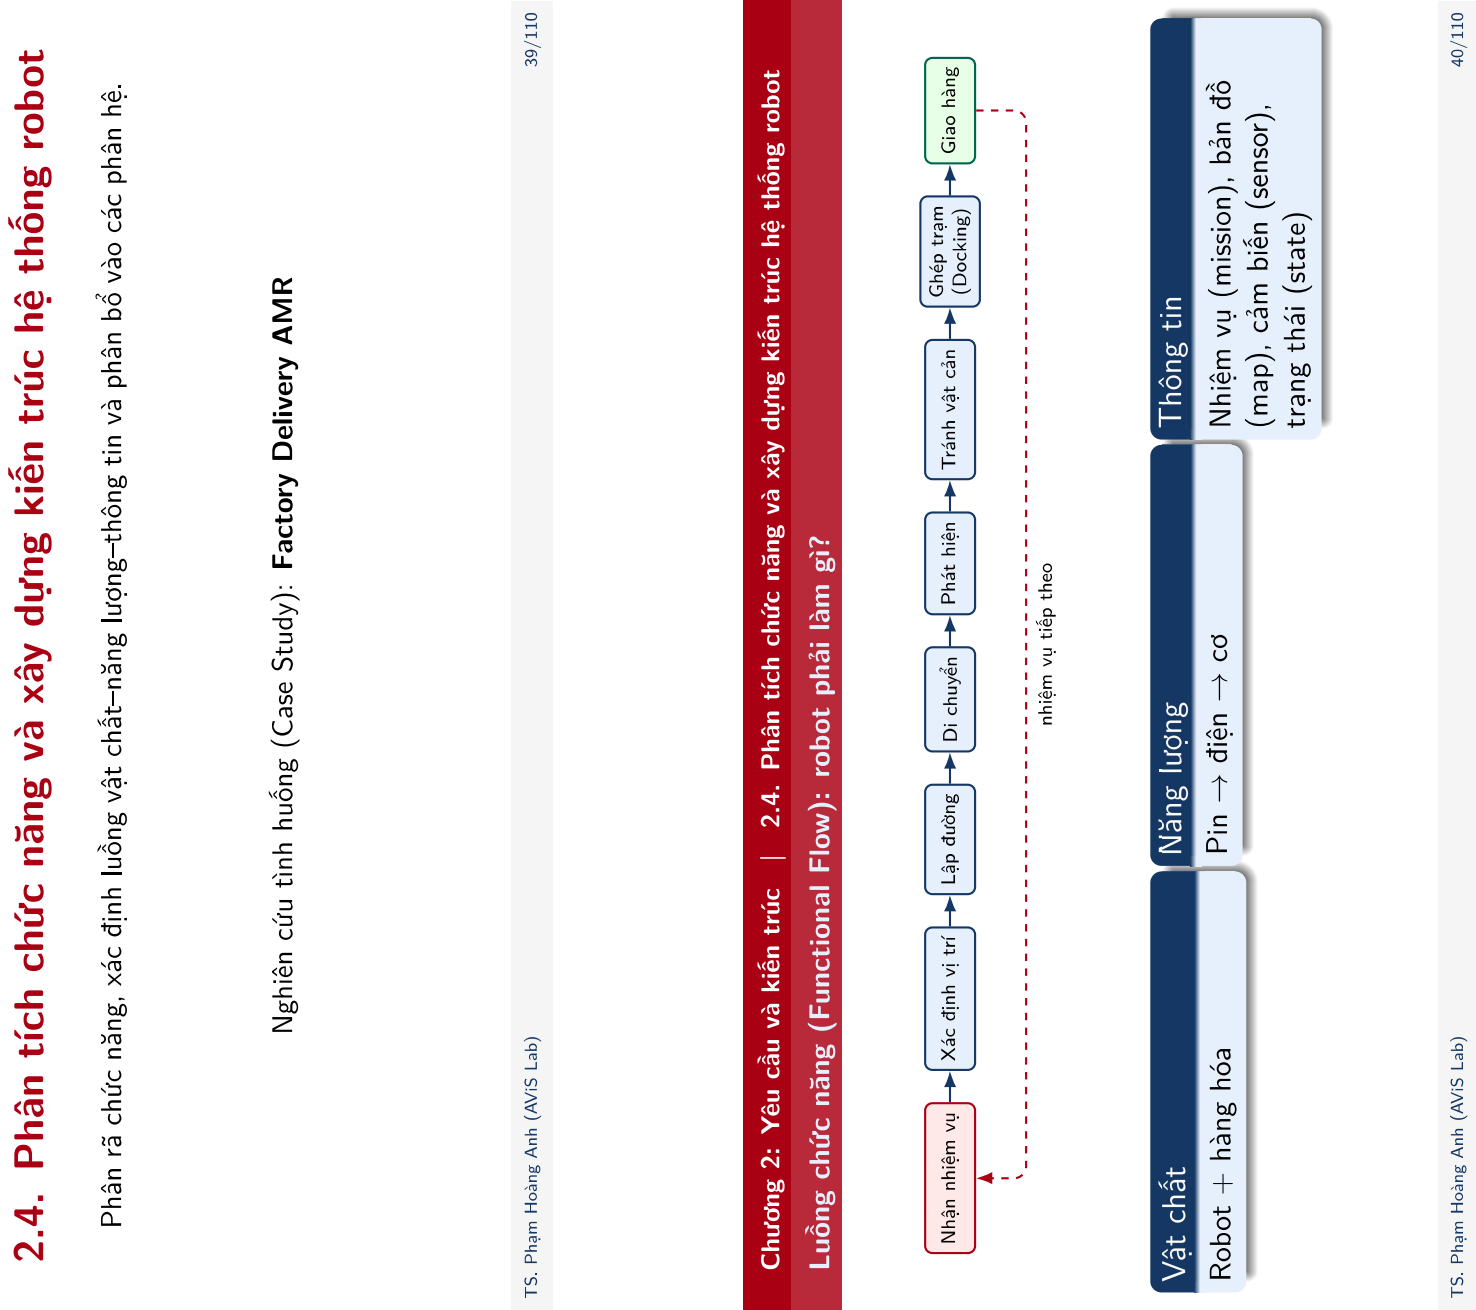
[picture p154: page 20]

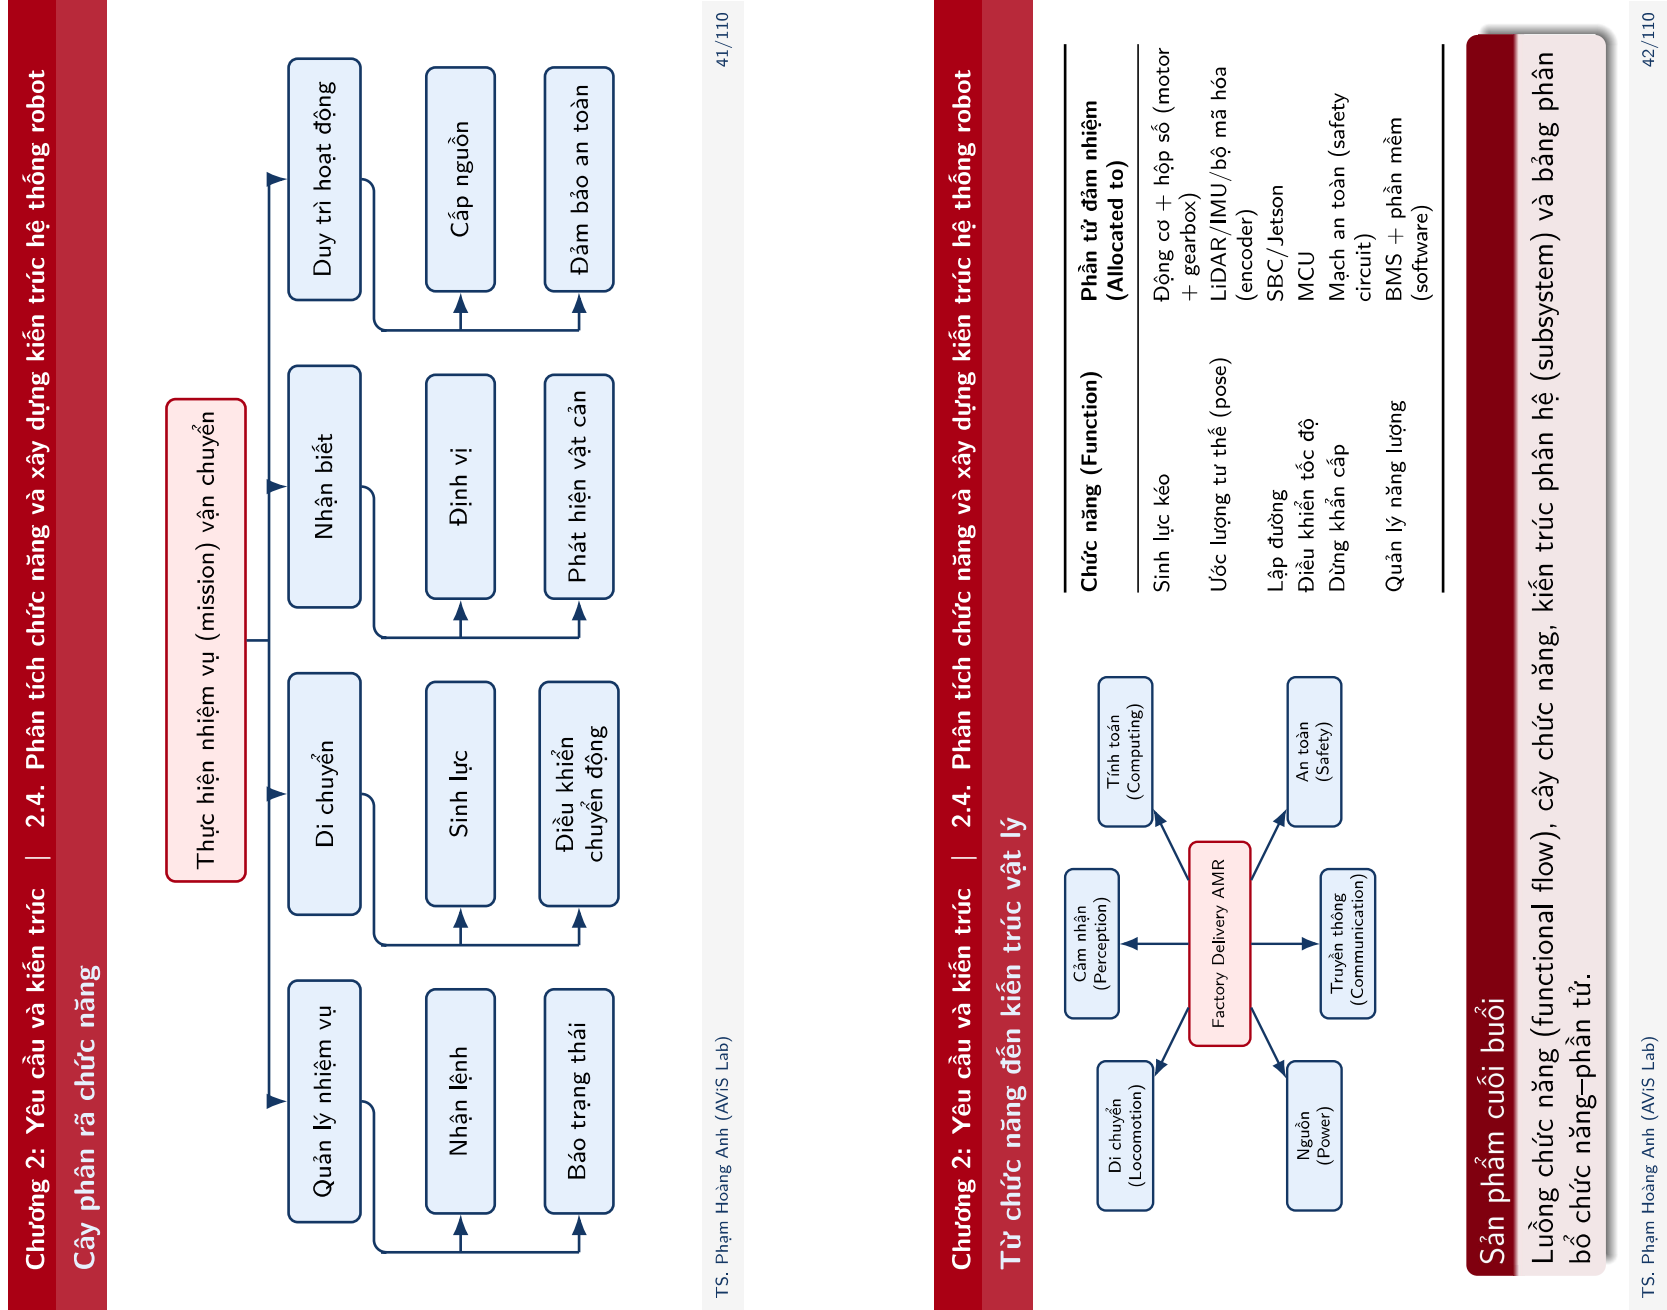
[picture p155: page 21]

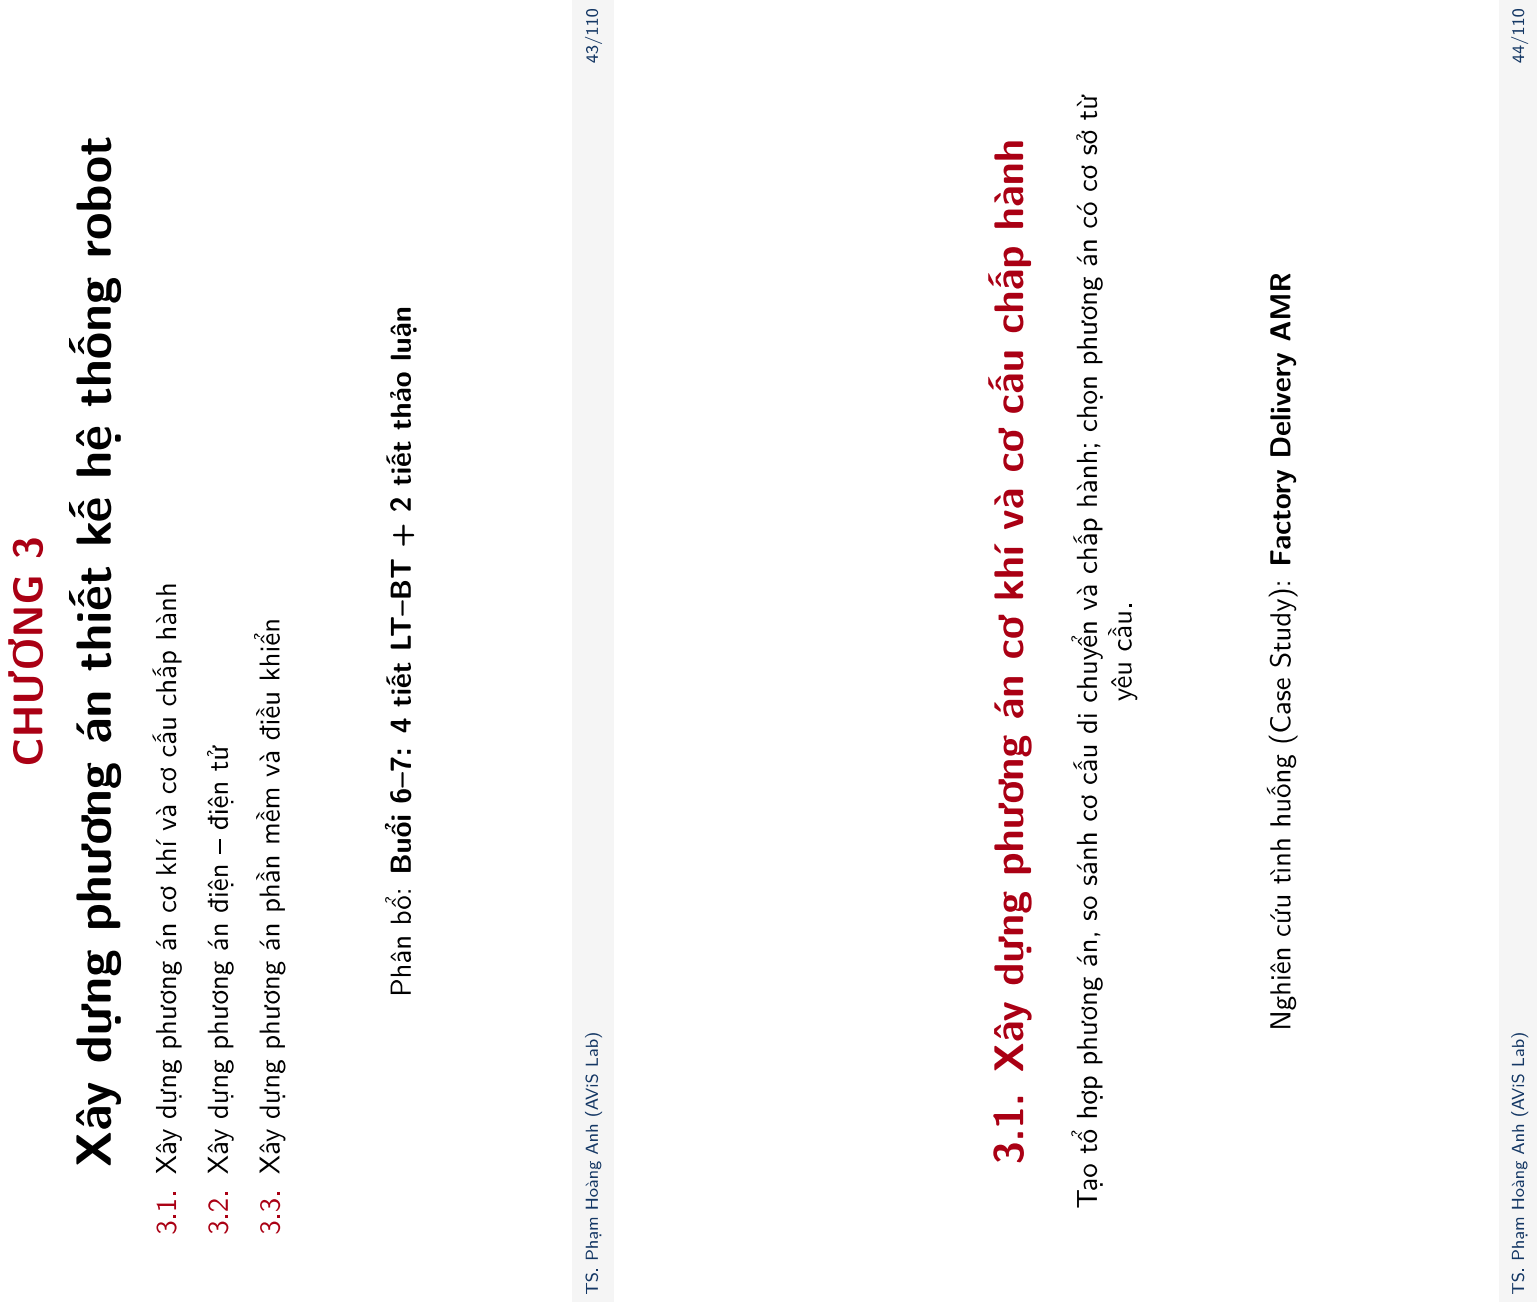
[picture p156: page 22]

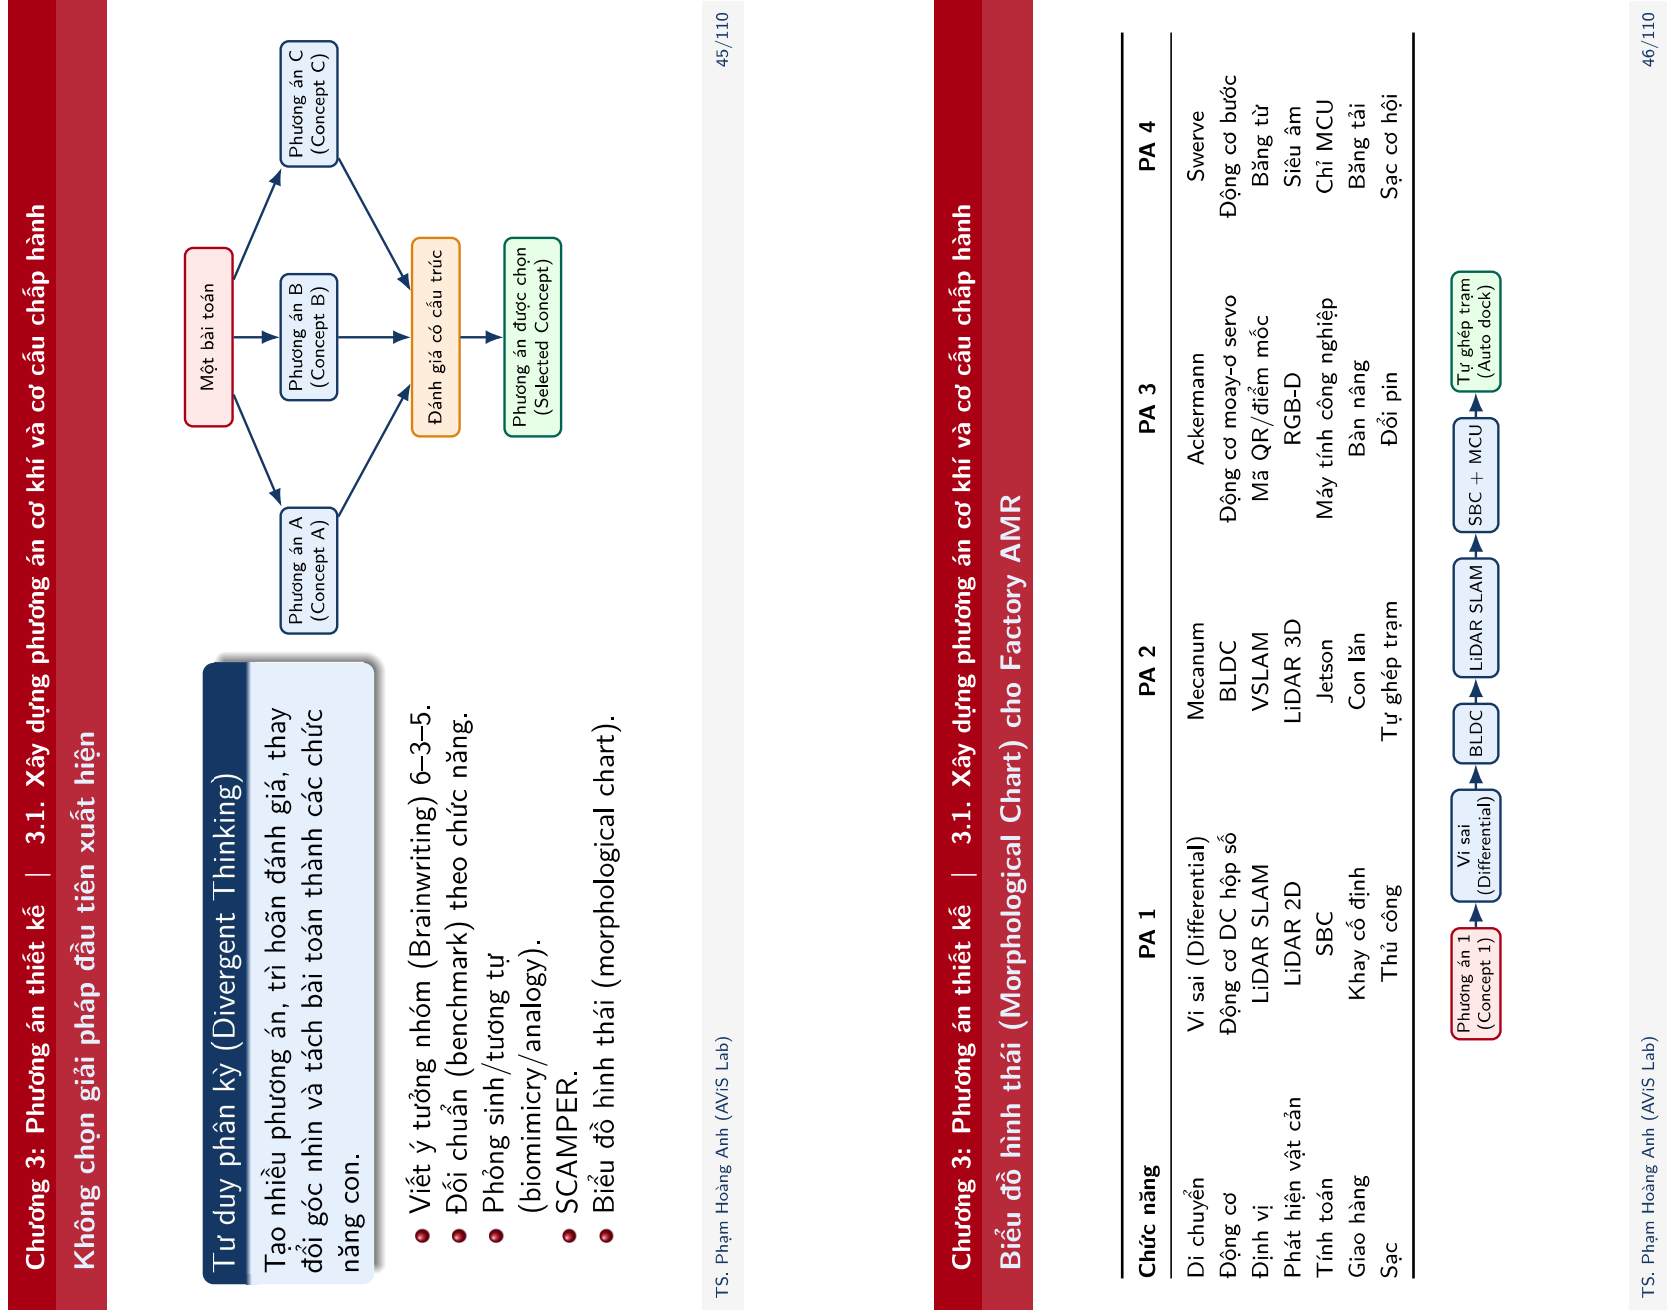
[picture p157: page 23]

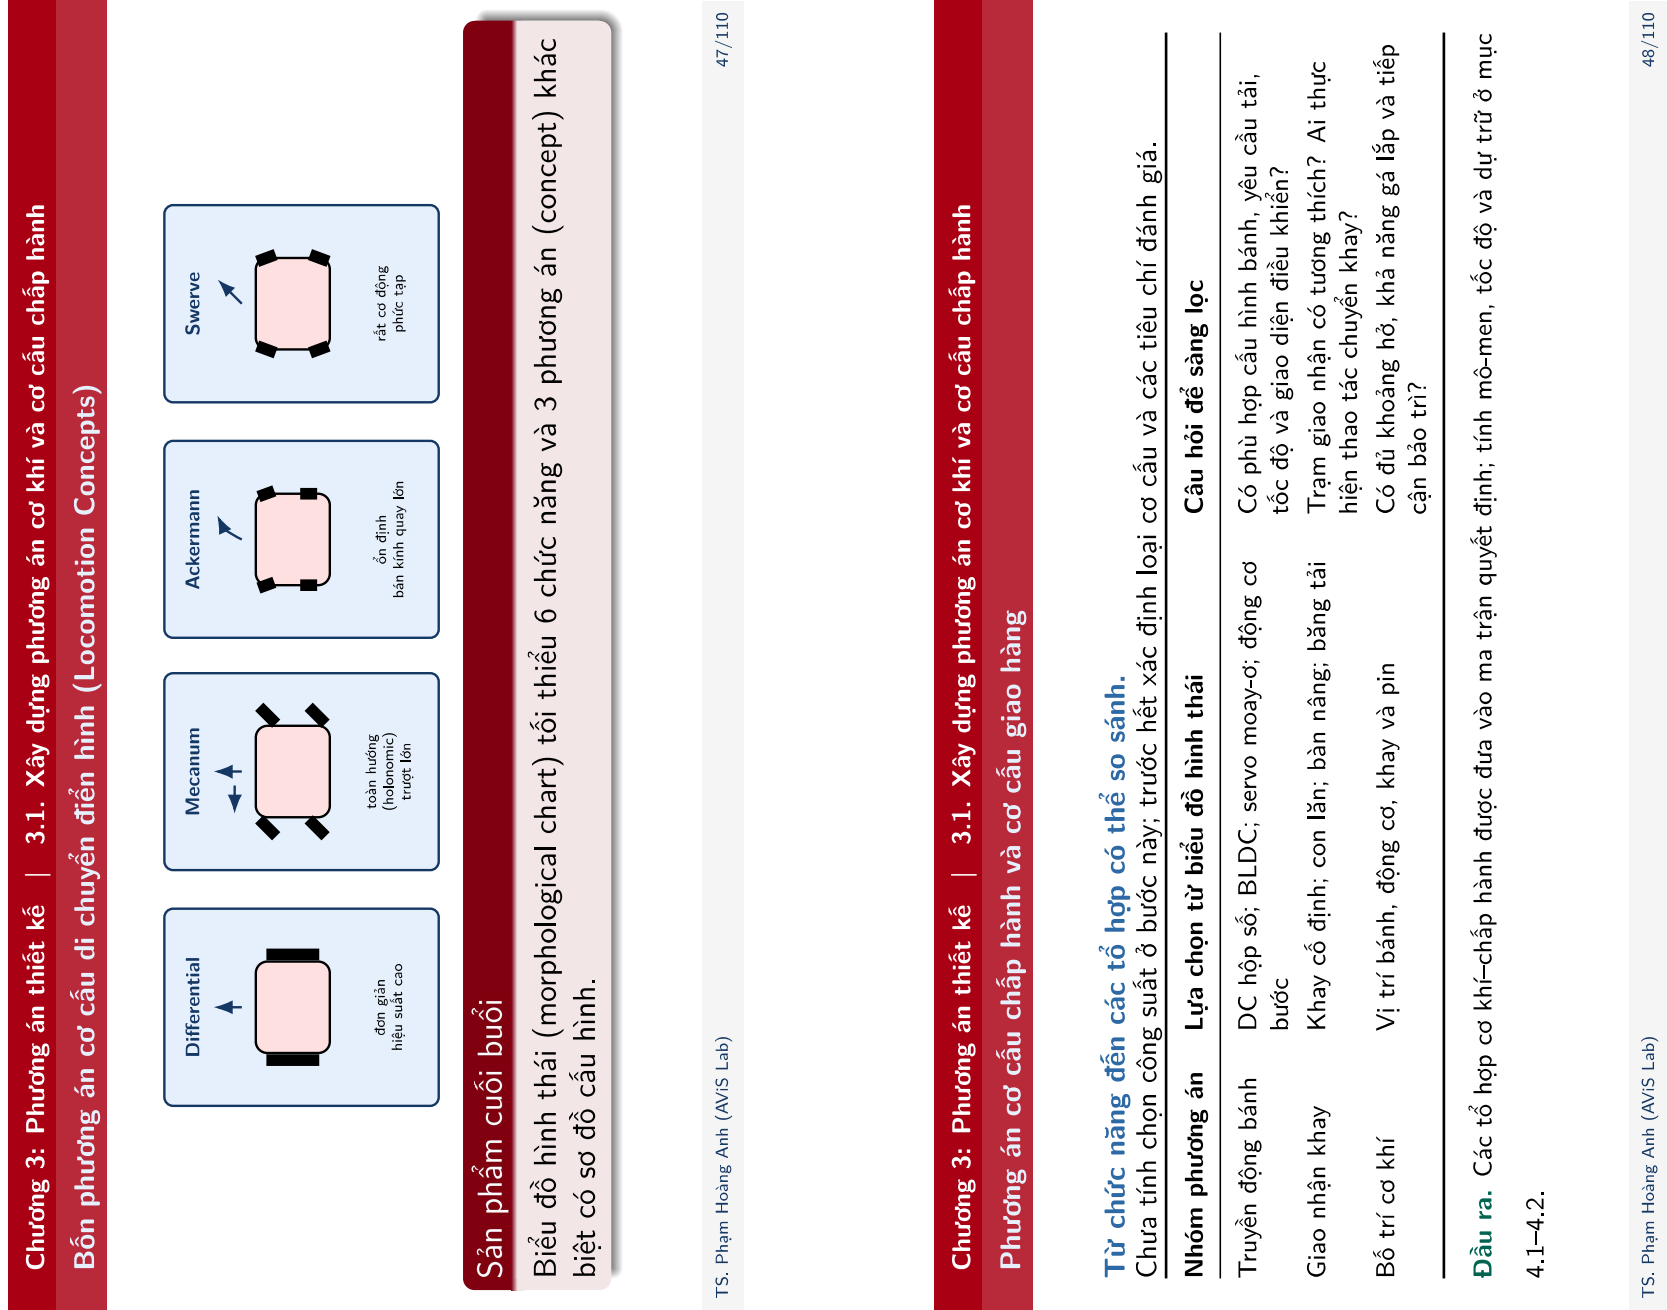
[picture p158: page 24]

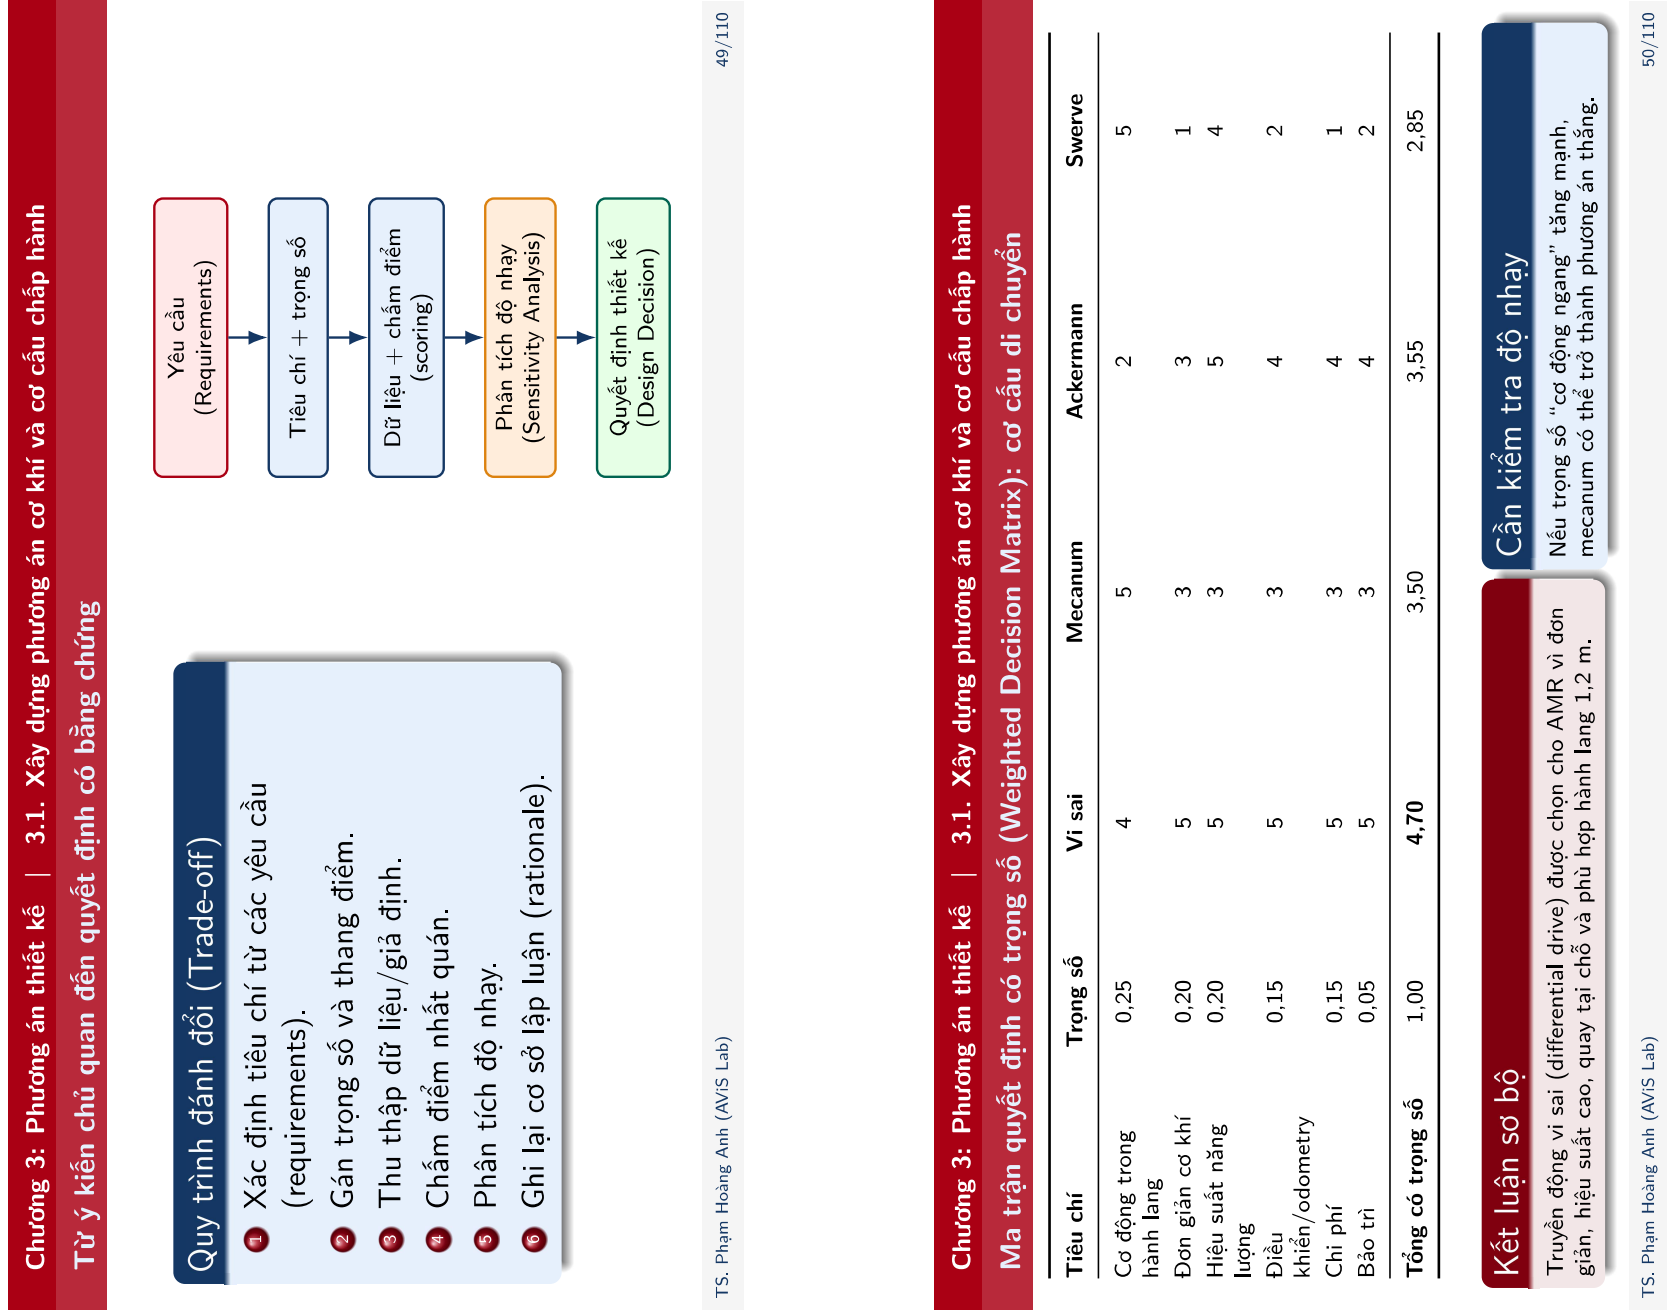
[picture p159: page 25]

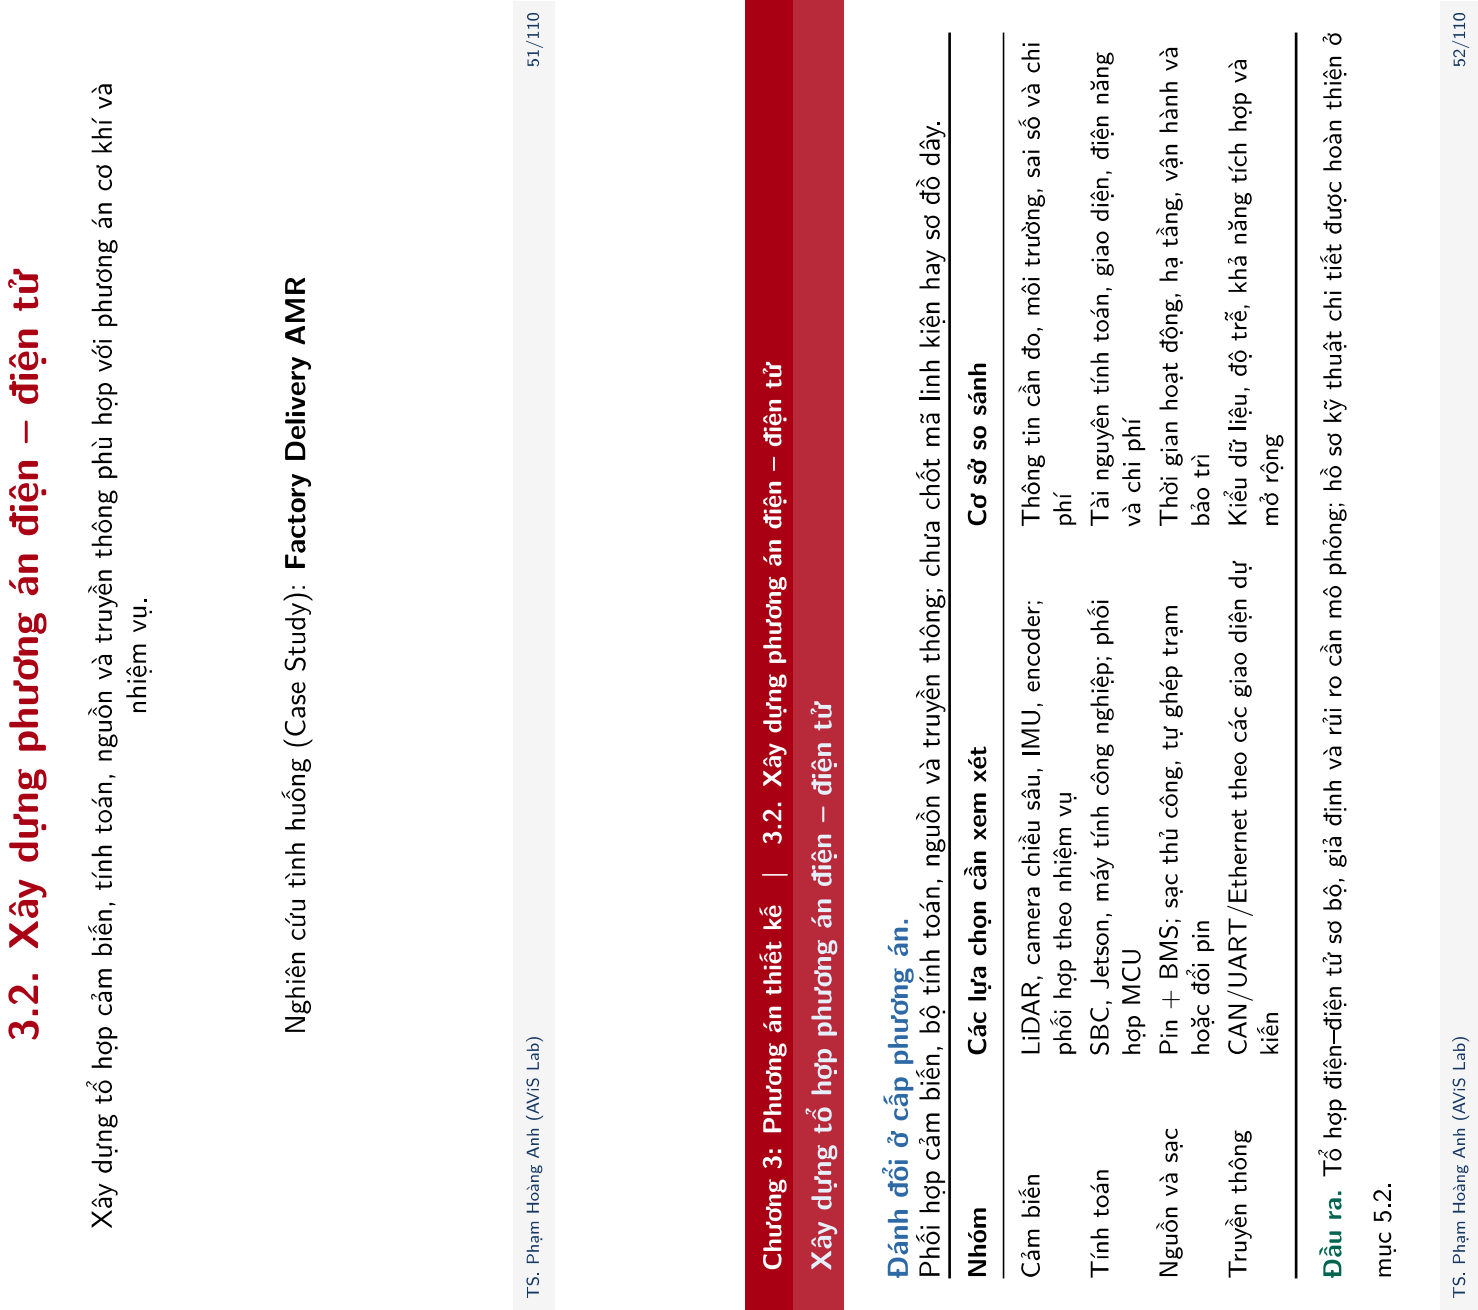
[picture p160: page 26]

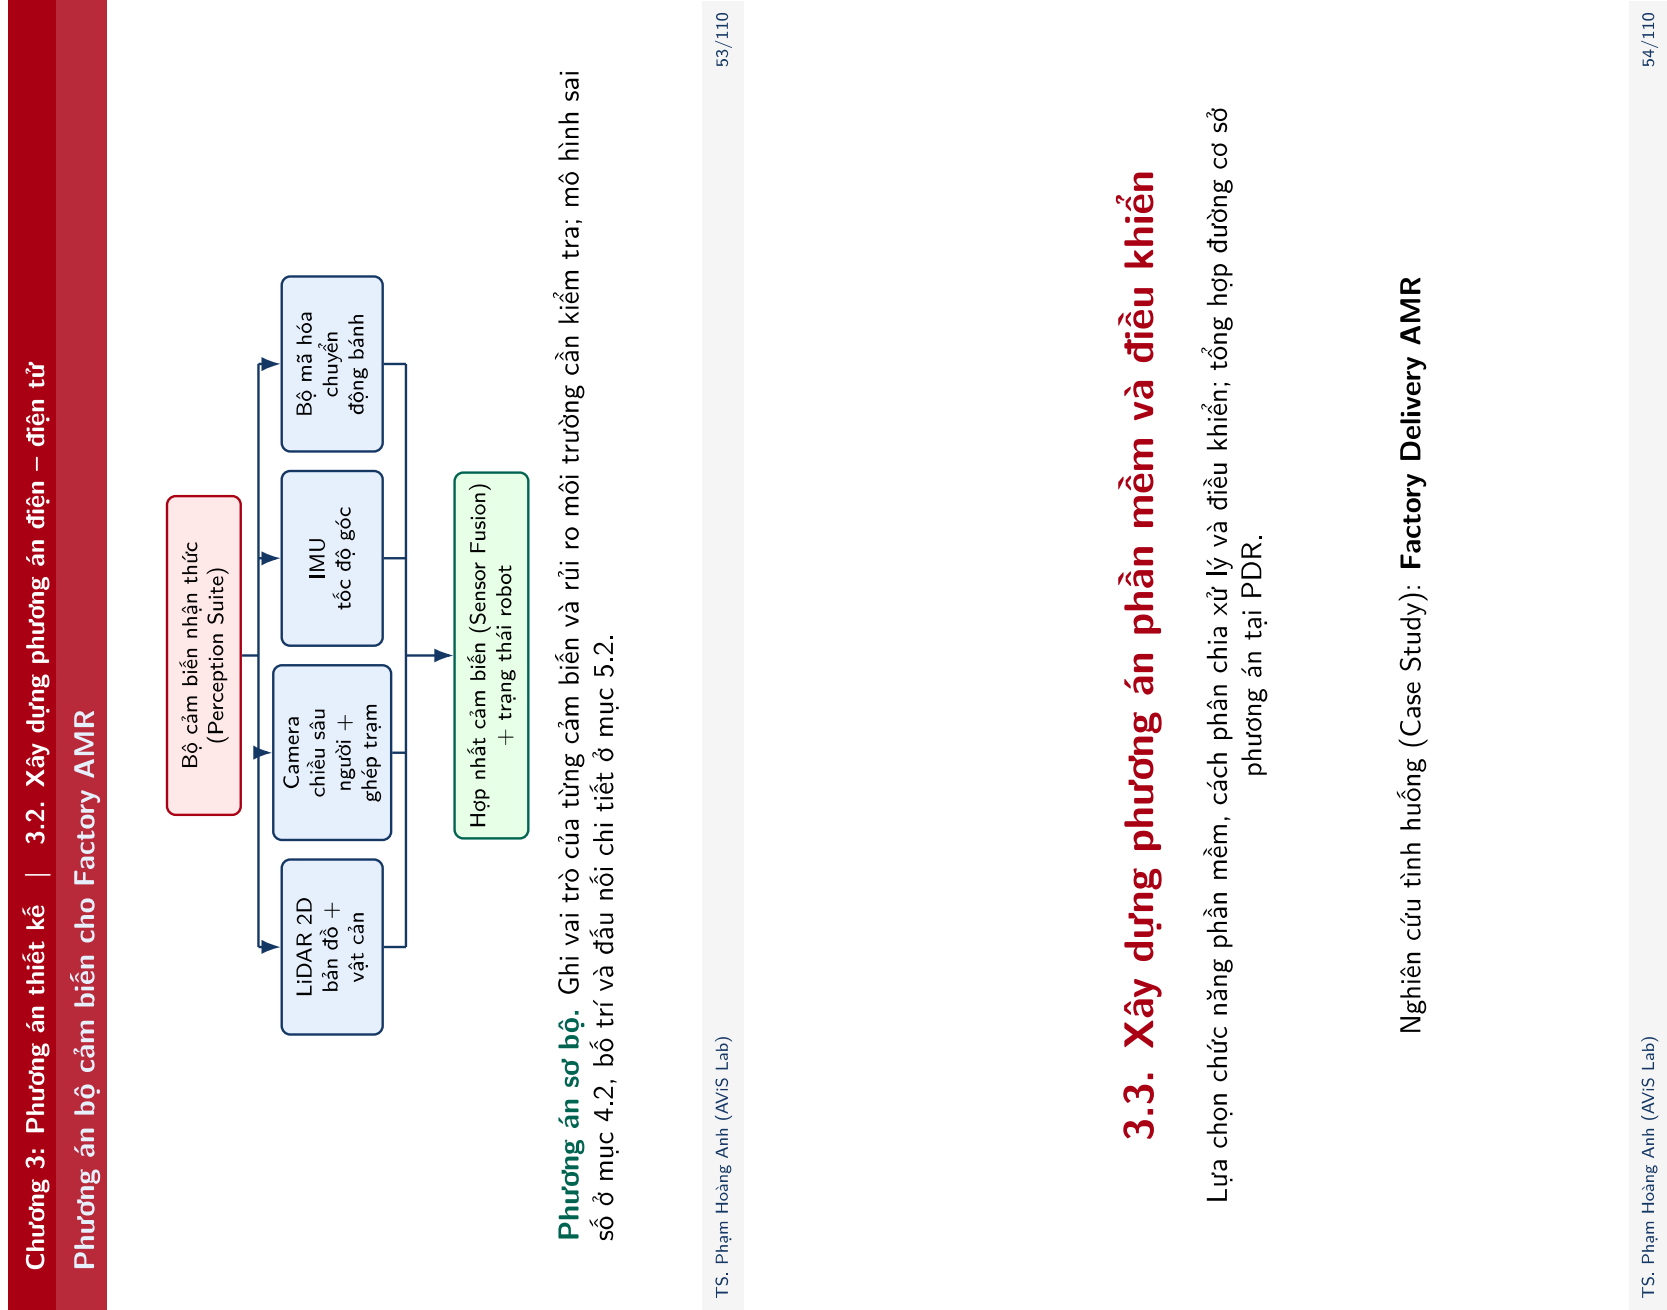
[picture p161: page 27]

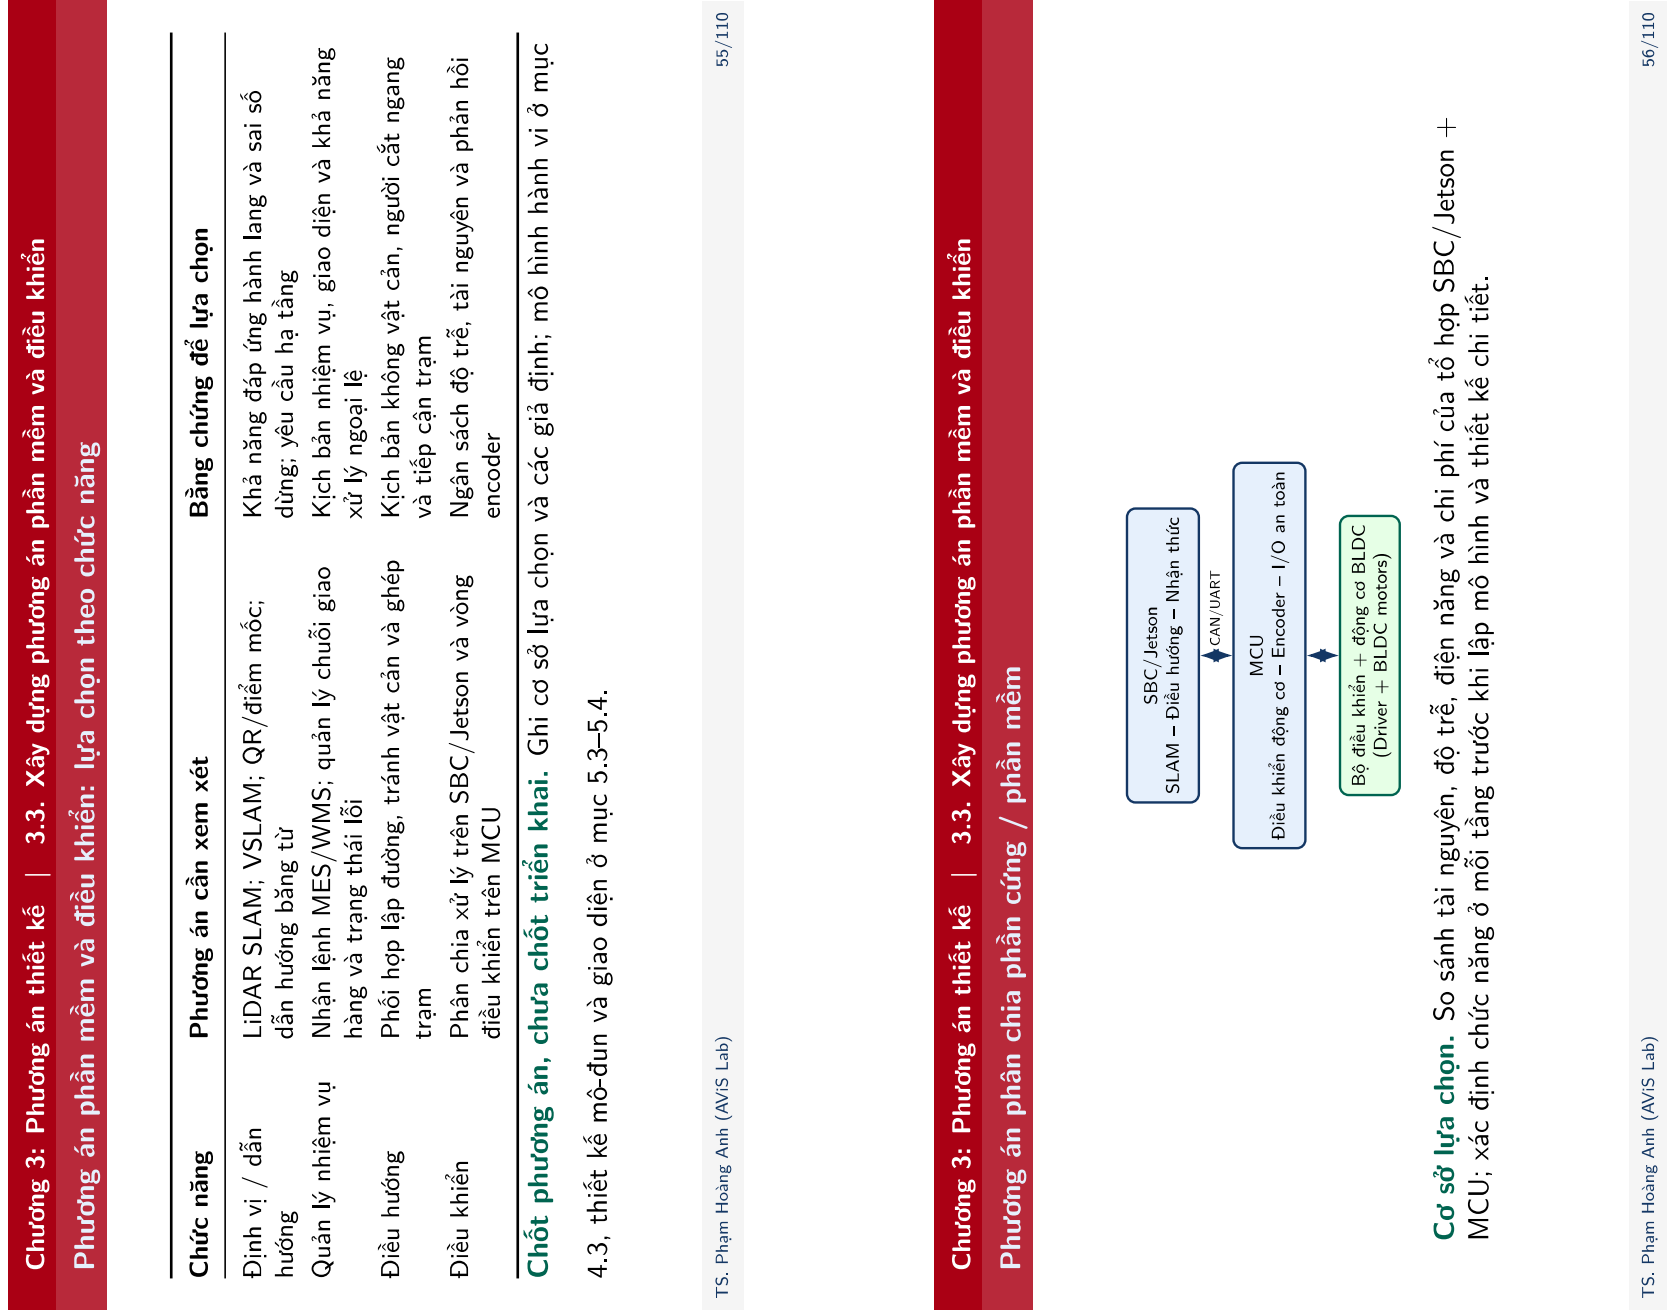
[picture p162: page 28]
