HoangAnh301194/Industrial_AMR_Robot/(commit log)

2026-11-09 Upload du an AGV
    [battery_pack_visual.stl, battery_system_visual.stl, bms_visual.stl, body_bumper_visual.stl, body_hazard_stripes_visual.stl, body_shell_main_visual.stl, body_shell_visual.stl, body_skin_panels_visual.stl]
2026-11-09 Day toan bo file trong factory_delivery_amr_description
    [battery_pack_visual.stl, battery_system_visual.stl, bms_visual.stl, body_bumper_visual.stl, body_hazard_stripes_visual.stl, body_shell_main_visual.stl, body_shell_visual.stl, body_skin_panels_visual.stl]
2026-11-10 docs: add differential drive kinematics dynamics and PID
2026-11-10 Fix typos in README.md flowchart labels
2026-11-10 docs: complete differential drive MATLAB simulations and technical report
    [compare_p.csv, compare_pi.csv, python_pi_pid_comparison.csv, python_pi_pid_summary.json, turning_scenario.csv, waypoint_scenario.csv]
2026-11-11 feat(sim): integrate 2D LiDAR (gpu_lidar) and 6-axis IMU plugins with ROS-Gazebo bridge
    [factory_delivery_amr.urdf.xacro, factory_world.sdf]
2026-11-11 docs: add LiDAR/IMU sensor plugins and step-by-step test commands to README
2026-11-11 feat(rviz): add preconfigured rviz sensor dashboard and rviz_sensors.launch.py
2026-11-11 feat(sim): integrate complete warehouse environment, dual-robot rviz dashboard, docks and storage racks
    [factory_world.sdf, model.sdf, warehouse_colision.stl]
2026-11-11 docs(images): add system architecture, mechanical design table, scissor lift, power distribution and FSM diagrams
